Sasha7b9Work/LiniaServer/_Лисенков/Diplomы/Irina.grishkovets22101999/тезисы 2021/Фото/IMG_20210307_133908.jpg

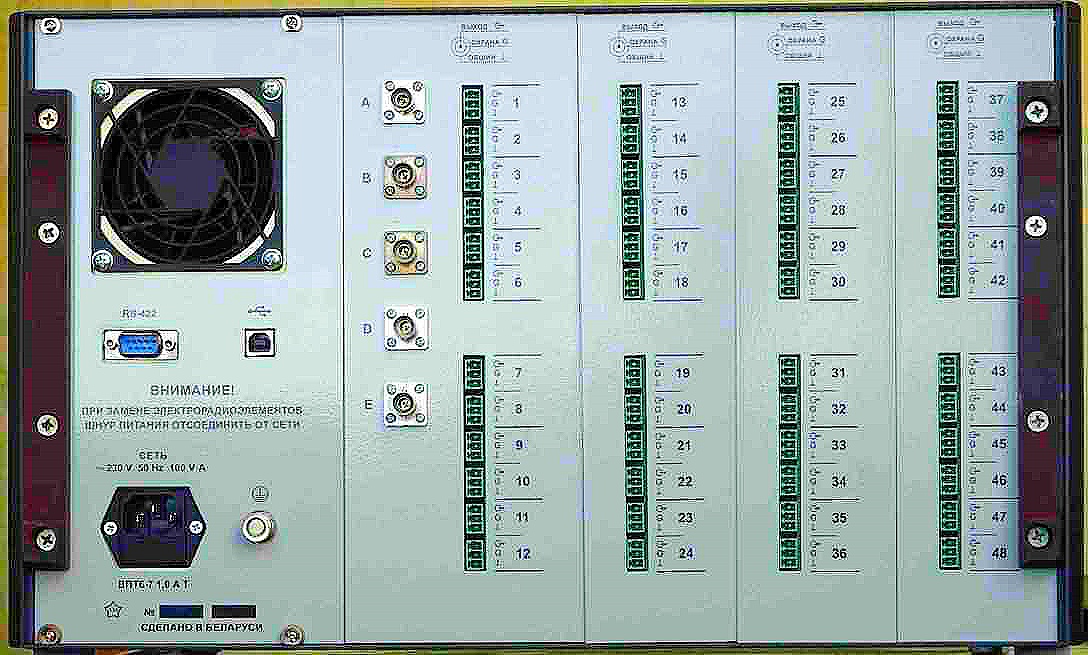
_Лисенков/Diplomы/Irina.grishkovets22101999/тезисы 2021/Фото/IMG_20210307_133908.jpg
