Sasha7b9Work/LiniaServer/Контроллер/УШЯИ.467444.130/Changelog.txt

06.08.25 - 16:57 Добавлены имена синналов на разъемы (4,5 лист)
08.08.25 - 14:13 Исправлены имена сигналов на листе 4 разъем Формирователь развертки
