Sasha7b9Work/LiniaServer/Печатные платы список линия 2.docx

Перечень печатных плат и трансформаторов, входящих в УШЯИ.411251.011 Анализатор ВАХ («Линия 2»)

Плата СБ | Плата | Файл | Куда входит
1. УШЯИ.467444.130 Контроллер | УШЯИ.687264.002 (6 сл) | УШЯИ.467444.130. PcbDoc (Altium) 28.07.25 | УШЯИ.467859.024 Дисплей
2. УШЯИ.687253.017 Плата | УШЯИ.758725.629 | 725629. PcbDoc (Altium) 01.08.25 | УШЯИ.411522.032 Источник напряжения 50 В
3. УШЯИ.687253.018 Плата | УШЯИ.758724.375 | 724375. PcbDoc (Altium) 01.08.25
4. УШЯИ.687243.347 плата (±50 В) 5. УШЯИ.687243.348 плата (±12 В, +5 В) 6. УШЯИ.687243.349 плата (±15 В, +12 V) 7. УШЯИ.687243.355 плата (объединительн) | УШЯИ.758725. УШЯИ.758725. УШЯИ.758725. УШЯИ.758724. | | УШЯИ.436224.015 блок питания
8. УШЯИ.687243.350 плата оптоформирователя (вх. УШЯИ.301411.044 оптоинтерфейс) 9. УШЯИ.687243.351 плата интерфейса (вх. УШЯИ.301411.044 оптоинтерфейс) 10. УШЯИ.687243.352 плата измерителя | УШЯИ.758723.275 УШЯИ.758723.276 УШЯИ.758725.634 | УШЯИ 758723.275.PcbDoc (Altium) 23.02.26 УШЯИ 758723.276.PcbDoc (Altium) 23.02.26 УШЯИ 758725.634.PcbDoc (Altium) 23.02.26 | УШЯИ.411131.006 измеритель тока
11. УШЯИ.411618.029 источник-измеритель 12. УШЯИ.411618.029-01 источник-измеритель 13. УШЯИ.411522.033 формирователь развертки 14. УШЯИ.687245.044 плата источника | УШЯИ.687254.036 (4 сл) УШЯИ.758727.205 УШЯИ.758727.206 | 687254.036 PcbDoc (Altium) 15.10.25 758727.205 PcbDoc (Altium) 15.10.25 PcbDoc (Altium) | УШЯИ.687412.009 шасси
15. УШЯИ.687253.044 плата выпрямителя | УШЯИ.758725.630 | PcbDoc (Altium) | УШЯИ.301412.605 панель
16. УШЯИ.687243.353 плата коммутатора 17. УШЯИ.687243.354 плата | УШЯИ.758725. УШЯИ.758725. | | УШЯИ.468213.012 коммутатор
18. УШЯИ.687242.236 плата защиты УШЯИ.671111.329 транс (шл16х16) УШЯИ.671111.257 транс (шл25х50) УШЯИ.671111.330 транс (шл32х40) УШЯИ.671111.272 транс (шл25х50) | УШЯИ.758721.097 | PcbDoc (Altium) | УШЯИ.411522.034 источник напряжения

В прибор входит 17 плат, 4 трансформатора
