Sasha7b9Work/LiniaServer/Перечень узлов Анализатора ВАХ.docx

Перечень узлов Анализатора ВАХ УШЯИ.411251.011 (январь 2026г)

Наименование | Обозначение | Обознач. ПУ | Обознач. ПП | Файл
Анализатор вольтамперных характеристик (ВАХ) | .411251.011 | ─ | ─
Измеритель тока | .411131.006
- плата оптоформирователя | | 687243.350 | .75872
- плата интефейса | | 687243.351 | .75872
- плата измерителя | | 687243.352 | .75872
Формирователь развертки | .411522.033 | | 758727.205 | 758727.205 PcbDoc (Altium) 15.10.25
Источник напряжения 3 кВ | .411522.034
- плата источника | | .687245.044 | .758727.206
- плата выпрямителя | | .687253.044 | .758725.630
- плата защиты | | .687242.236 | .758721.097
Источник напряжения 50 В | . 411522.032
- плата | | .687253.017 | .758725629 | 725629. PcbDoc (Altium)
- плата | | .687253.018 | .758724375 | 724375. PcbDoc (Altium)
Источник-измеритель | 411618.029, 411618.029-01 | ─ | 687254.036 (4 слоя) | 687254.036 PcbDoc (Altium) 15.10.25
Дисплей | .467859.024
- контроллер | | .467444.130 | .687264.002 (6 слоев) | УШЯИ.467444.130. PcbDoc (Altium) 28.07.25
Коммутатор | .468213.012
- плата коммутатора | | .687243.353 | .75872
- плата | | .687243.354 | .75872
Блок питания | .436224.015
- плата (±50 В) | | .687243.347 | .75872
- плата (±12 В, +5 В) | | .687243.348 | .75872
- плата (±15 В, +12 VR) | | .687243.349 | .75872
- плата объединительная | | .687243.355 | .75872

Всего – 17 плат (может появиться еще одна)
