Sasha7b9Work/LiniaServer/Блок базы - Подложки/Таблица 24-х разрялного регистра ПЛИС-a.docx

Таблица 1 - Назначение разрядов регистров в источнике-измерителе (RB )

Разряд | Значения разрядов | Функциональное назначение
Q3:Q0 | 0000 | Включение предела: ±20 нА. ( все герконы выключены)
| 0001 | Включение предела: ±200 нА. – (включен геркон 10М)
| 0010 | Включение предела: ±2 мкА. - (включен геркон 1М)
| 0011 | Включение предела: ±20 мкА. - (включен геркон 100К)
| 0100 | Включение предела: ±200 мкА.- (включен геркон 10К)
| 0101 | Включение предела: ±2 мА.- (включен геркон 1К)
| 0110 | Включение предела: ±20 мА.- (включены герконы 100RI,100RU)
| 0111 | Включение предела: ±200 мА.- (включены герконы 10RI,10RU)
| 1000 | Включение предела: ±2 А. - (включены герконы 1RI,1RU)
| 1001 | Включение предела: ±10 А.- (включены герконы R1I,R1U)
Q4 (Uc1) | 0 | Геркон подключения конденсатора выключен
| 1 | Геркон подключения конденсатора включен
Q5 (CLBR) | 0 | Геркон “Корр. 0 измерителя UИИ” выключен.
| 1 | Геркон “Корр. 0 измерителя UИИ” включен.
Q6 (Az) | | Не используется
Q7 (CF) | | Не используется
Q9:Q8 | 00 | ST1=0, Uref=5V - установка опорного напряжения
| 01 | ST2=0, Uref=1.25V
| 10 | ST3=0, Uref=1V
| 11 | ST4=0, Uref=0.5V
Q10 (Ui) | 0 | Режим ограничение по “I”.
| 1 | Режим ограничение по ”U”.
Q11 (Uim) | 0 | Режима измерения I.
| 1 | Режима измерения U.
Q12 (U1) | 0 | Задание диапазона измерения U: 10V
| 1 | Задание диапазона измерения U: 40V
Q13 (IIS) | 0 | Режим источника напряжения
| 1 | Режим источника тока
Q14 | | Не используется
Q15 (Onl3) | 0 | Выбор сигнала токового датчика буфера 40V
| 1 | Выбор сигнала токового датчика буфера 10V
Q16 | | Не используется
Q17 | | Не используется
Q18 | 0 | Формирование сигнала базы ступеньками
| 1 | Формирование сигнала базы импульсами
Q19 | | Не используется
Q20 | | Не используется
Q21 | | Не используется
Q22 | 0 | Питание усилителя 12 В
| 1 | Питание усилителя 55 В
Q23 | | Не используется
