Sasha7b9Work/LiniaServer/Контроллер/1-Изменения программы ОО.docx

1. Исходная схема контроллера - kont_lineP-E

2. В схеме для STM32F4 изменили:

- сигнал ST_TB – запуск развертки формируется STM32F4 pin.36;

- для передачи данных из памяти ПЛИС используется встроенный модуль SPI

ORANGE PI 5 Plus. Модуль SPI ORANGE PI 5 Plus - “ Master”, ПЛИС –“Slave”.

Назначение pin. модуля SPI ORANGE PI 5 Plus :

- spi_miso pin.21 ORANGE PI 5 Plus - прием последовательных данных из

памяти ПЛИС;

- spiClk pin.23 ORANGE PI 5 Plus - такты для приема данных из памяти ПЛИС

(ранее использовался как тактовый сигнал программирования динамических DAC);

- SPICS pin.24 ORANGE PI 5 Plus - лог.”0” – разрешение приема данных;

- full pin.36 ORANGE PI 5 Plus – сигнал готовности приема данных из памяти

ПЛИС – лог. “1”.

Чтение данных выполняется по алгоритму платы макета контроллера.

3. Сигнала Stop_TB формируется контроллером STM32F, используется pin.15.

4. Управление динамическими DAC

Управление динамическими DAC выполняется контроллером ORANGE PI 5 Plus

через последовательный интерфейс. Используются следующие сигналы:

XP3 (ORANGE PI5 Plus)

- CLK_DDAC – pin.16 - (ранее использовался pin. 23);

- DT - DDAC pin.18 – (ранее использовался pin. 19);

- EN_DD1 - pin.31 – выбор динамического DAC формирователя развертки;

- EN_DD2 - pin.35 - выбор динамического DAC источника 50 В.

Назначение остальных pin. STM32F4 не изменилось.
