Sasha7b9Work/LiniaServer/Контроллер/1- Запись в регистр блока  Базы.docx

Управление модулем Базы

В тестовой программе задействовано управление DAC на плате и регистром 24 разряда и DAC1, DAC2, ADC .

Используются следующие сигналы для записи в регистр:

1. Для записи данных в регистр модуля базы используются следующие сигналы:

- ENRGB – сигнал выбора регистра базы, активный уровень – лог.”0”, должен находиться в

состоянии лог. “1”, при записи данных в регистр - лог.”0”. Сигнал “ENRGB” формируется

контроллером STM32F4, используется порт PC1 pin. 27.

- DAT1_DAC – данные для записи в сдвиговый регистр, сигнал “DAT1_DAC” формируется

контроллером STM32F4, используется порт PD8 pin. 77.

- CLK1_DAC – такты записи в сдвиговый регистр, сигнал “CLK1_DAC” формируется

контроллером STM32F4, используется порт PD11 pin. 80.

Перед записью данных в регистр необходимо обеспечить:

- ENRGB - лог. “1”;

- CLK1_DAC - лог.”0”,

2. Последовательность выполняемых операций при записи:

- устанавливается сигнал “ENRGB” в состояние лог. ”0”.;

- выполняется задержка не менее 1 мкс;

- в порт PD8 записывается значение старшего бита 24 битового значения регистра;

- выполняется задержка не менее 1 мкс;

- в порт PD11 записывается лог. “1”, которая удерживается в этом состоянии не менее 1 мкс;

- в порт PD11 записывается лог. “0”

- выполняется задержка не менее 1 мкс;

- в такой последовательности выводятся все 24 бита;

- по окончанию записи 24 бит сигнал “ENRGB” должен быть установлен в состояние лог. ”1”.;

- ENRGB - pin.10 XP4;

- CLK1_DAC- – pin.5 XP4;

- CLK1_DAC+ – pin.6 XP4;

- DAT1_DAC- - pin.2 XP4;

- DAT1_DAC+ - pin.3 XP4

3. Используются следующие сигналы для записи в DAC1 и DAC2:

- END1B - pin.8 XP4 – для DAC1 – 14 bit;

- END1B - pin.9 XP4 - для DAC2 – 8 bit;

- CLK1_DAC- – pin.5 XP4;

- CLK1_DAC+ – pin.6 XP4;

- DAT1_DAC- - pin.2 XP4;

- DAT1_DAC+ - pin.3 XP4

Активный уровень выбора DAC1,DAC2 – лог. “1”.

Порядок записи как для последовательного регистра.

4. Проверки работы ADC не выполняется, так как требуется подключение дополнительного модуля формирователя развертки ( необходим сигнал LINE).
