Sasha7b9Work/LiniaServer/Контроллер/1-Изменения по плате-C.docx

На плате необходимо сохранить расположение элементов. Основные изменения:

- удалены некоторые связи согласно списка ниже:

- введены дополнительные связи и изменены наименования отдельных цепей. Изменения

выделены на схеме красным цветом;

- введены дополнительные резисторы в разрыв проводников и схему 467444.130Э3-5A

- изменен тип вилок XP11, XP14 (на шестиконтактные);

- добавлена вилка XP15;

- удалены из схемы конденсаторы C90, C91;

- введена микросхема линейного стабилизатора DA23 для получения питания +3,3VC. Это

питание заводится на вилки XP4,XP5,XP7,XP10,XP12,XP13. Цепи выделены на схеме красным

цветом. Для работы стабилизатора DA23 введены дополнительные конденсаторы –

C90,C91,C94, C95;

- имеются схемные файлы УШЯИ.467444.130Э3-1A - УШЯИ.467444.130Э3-5A, в которые внесены

изменения, выделенные красным цветом. Коррекция схемы выполнена без использования

библиотеки элементов. Использовались только символьные обозначения дополнительных

элементов путем копированием элементов платы.

При коррекции платы использовать откорректированный вариант схемы и пояснениями,

приведенными ниже.

1. Связь (DAT_F0) pin.84 DD1 – pin.16 XP3 удалить;

2. Связь (DAT_F1) pin. 85 DD1 - pin.18 XP3 удалить;

3 . Связь (SPI1_CLK) pin.4 DA11 - pin.23 XP3 удалить;

4. Связь (SPI1_MOSI) pin.4 DA14 - pin. 19 XP3 удалить;

5. Связь (REQ_RD) pin.32 XP3 - pin. 115 DD1 удалить;

6. Связь (ENDU) pin.19 XP7 - pin.9 DD4удалить;

7. Связь (ENB_STM) pin.112 DD1 – pin. 81 DD4 удалить;

8. Связь (+5V) pin.1 XP11 удалить;

9. Связь (EA)pin.2 XP11 -pin.2 R53 удалить;

10. Связь (EB)pin.3 XP11 -pin.2 R54 удалить;

11.Связь (GND) pin.4 XP11 –GNDудалить;

12 . Связь (KA) pin.1 R53 -pin. 11 XP3 удалить

13 . Связь (KB) pin.1 R54 – pin. 13 XP3 удалить

14 . Связь (START) pin. 1 XP14 – pin. 15 XP3 удалить

15 . Связь (STOP) pin. 2 XP14 – pin.21 XP3 удалить

16. Удалить с платы связи и элементы:

( 200-E) pin.12 XP12 - pin.45 DD4 и резистор R58;

(200+E )pin.13 XP12 - pin. 46 DD4 и резистор R59 ;

(20-E) pin.14 XP12 - pin.47 DD4 и резистор R60;

( 20+E) pin.15 XP12 - pin.48 DD4ирезисторR61;

(SPEED) pin.19 XP6 - pin. 126 DD4

17. Связь (50E-) pin.16 XP10 подключить к pin.12XP12;

Связь (50E+) pin.15 XP10 подключить к pin.13XP12;

18. Ввести на плату резистор R64 и включить его в разрыв цепи (300VE)pin.11 XP12 – pin.44 DD4

19. Ввести на плату резистор R65 и включить его в разрыв цепи (50E+)pin.15 XP10 – pin.50 DD4

20. Ввести на плату резистор R66 и включить его в разрыв цепи (50E-)pin.16 XP10 – pin.49 DD4

21. Ввести на плату резистор R66 и подключить его вывод к цепи (50E+), второй вывод

к цепи (+3.3VB)

22. Ввести на плату резистор R62 и подключить его вывод к цепи (50E+), второй вывод

к цепи ( +3.3VB)

23. Ввести на плату резистор R63 и подключить его вывод к цепи (50E-), второй вывод

к цепи (+3.3VB)

24. Ввести на плату резистор R67 и подключить его вывод к цепи (DOOR), второй вывод

к цепи (+3.3VB)

25. Ввести на плату резистор R68 и подключить его вывод к цепи (DOOR), второй вывод

к pin.140 DD4 ( связь DOOR_R)

26. Ввести на плату резистор R60 и подключить его вывод к цепи (VD+), второй вывод

к цепи (+5V);

27. Ввести на плату резистор R61 и подключить его вывод к цепи (CNT_VD), второй вывод

к цепи GND. Резистор R61 ставить у pin. Gate транзистора VT1. К расположению транзистора

VT1 на плате требований не предъявляется

28. Ввести на плату транзистор VT1. Gate транзистора подключить к связи (CNT_VD), исток

транзистора подключить к (GND), исток к цепи (VD-)

29. Ввести на плату резистор R58 и подключить его вывод к цепи (START), второй вывод к

pin.15 XP3 (цепь KN_START)

30. Ввести на плату резистор R59 и подключить его вывод к цепи (STOP), второй вывод к

pin.33 XP3 (цепь KN_STOP)

31. Ввести на плату резистор R69 и включить его в разрыв цепи (связь OVLB)

32. Ввести на плату резистор R70 и включить его в разрыв цепи (связь OVLP)

33. Ввести на плату резистор R71 и включить его в разрыв цепи (OVLI,1)

34. Ввести на плату резистор R72 и включить его в разрыв цепи (OVLW)

35. Ввести на плату резистор R73 и включить его в разрыв цепи (OVLI,2)

36.Кразмещению резисторовR69-R73 требований не предъявляется

38 Ввести связь (CNT_VD) pin.12 DD4 резистор R61, GateVT1

39. Ввестисвязь (Meas) pin.97 DD4 – pin. 3 XP15 ( можно другой вывод DD4)

40. Ввестисвязь (DOOR_R) pin.140 DD4 – pin. R68 ( можно другой вывод DD4)

41. Ввестисвязь (ST_EXT) pin.32 XP3 – pin.1 XP15

42. Ввестисвязь (FIT) pin.37 XP3 – pin.5 XP15

43Ввестисвязь (VD-) VT1 - pin.6 XP14;

44Ввестисвязь (VD+) R60 - pin.5 XP14;

45. Ввестисвязь(EA)pin.1 XP11 -pin.1 R53;

46. Ввестисвязь (EA) pin.1 XP11 -pin.1 R51;

47. Ввестисвязь (+3.3VB) pin. 2R51 - +3.3VB

48. Ввестисвязь (KA) pin. 2 R53 – pin.11 XP3

49. Ввести связь (EB)pin.2 XP11 -pin. 1 R54;

50. Ввестисвязь (EB) pin.2XP11 -pin.1 R52;

51. Ввестисвязь (+3.3VB) pin. 2R52 - +3.3VB

52. Ввестисвязь (KB) pin. 2 R54 – pin.13XP3

53. Ввести связь (GND) pin.3 XP11 -GND;

54. Ввести связь (+3.3VB)pin.5 XP11 - +3.3VB;

55. Ввести связь (GND)pin.6 XP11 -GND;

56. Ввести связь (+5V)pin.19 XP6 - +5V;

57. Ввести связь (SPI_Clk) pin.23 XP3 – pin.115 DD1

58. Ввести связь (CLK_DDAC) pin.4 DA11 – pin.18 XP3;

59. Ввести связь (DT_DDAC )pin.4 DA14 - pin.16 XP3;

60. Ввестисвязь (SPI_MISO) pin.23 XP3 - pin.84 DD1;

61. Ввести связь (+5V) pin.19 XP6 - +5V;

62. Ввести связь (+3.3VC )pin.30 XP4 - +3.3VC;

63. Ввести связь (+3.3VC) pin.30 XP5 - +3.3VC;

64. Ввести связь (+3.3VC) pin.38 XP7 - +3.3VC;

65. Ввести связь (ENDU) pin.37 XP7 -pin.9 DD4;

66. Ввести связь (+3.3VC) pin.18 XP10 - +3.3VC;

67. Ввести связь (GND) pin.9 XP3 -GND

68. Изменить наименование связи (DAT_F3) pin.132 DD1 – pin.24 XP3 на (SPICS);

69. Изменить наименование связиDat_F2pin.22XP3 - pin.137DD1 на (Stop_TB);

70. Изменить наименование связи (ENB_STM) pin.27 XP3 - pin.81 DD4 – на (ENB_PC)

71. Изменить наименование связи(EMPTY) pin. 104 DD1 –pin.26 XP3 на (F_Con1)–свободная связь

72. Изменить наименование связи(SMM32F4) pin. 73DD1 –pin.15DD4на (F_Con2)–свободная

связь

73. Изменить наименование связи(A2_RG) pin. 72DD1 –pin.89DD4на (F_Con3)–свободная связь

74. На XP3 pin.8 (Tx) должен быть соединен с pin.102 (Tx) DD4,pin.10 (Rx) должен быть соединен с

pin.136 (Rx) DD4,

75 . Вилки XP11, XP14 заменены на AMPMODU II 0280372-2 – 6 pin.

76 . ВилкаXP8 заменена на AMPMODU II 0280372-2 – 6 pin.

77. В схему добавлена вилка XP15 - AMPMODU II 0280372-2 – 6 pin.
