Sasha7b9Work/LiniaServer/Контроллер/1-Проверка платы с  STM32f4-V4.docx

Для начального включения используется следующее включение программируемых

элементов платы контроллера – полная схема:

ПЛИС STM32F4

A0_RG –pin.71 A0_RG – pin.90 мл.бит выбора регистра ПЛИС

A1_RG –pin.70 A1_RG – pin.91 бит выбора регистра ПЛИС

St_tb –pin.72 – pin.89 start развертки ( замена A2_RG)

CLK_RG –pin.69 CLK_RG – pin.92 такты записи в регистр ПЛИС

WR_RG –pin.59 WR_RG – pin.93 сигнал записи в регистр ПЛИС

DAT_RG –pin.49 DAT_RG – pin.82 данные записи в регистр ПЛИС

SPICLK – pin.115 SPICLK – pin32. ORANGE PI5+ чтение данных из ПЛИС

( REQ_RD)

SPIMISO – pin.85 - pin.18 ORANGE PI5+ данные из ПЛИС

(DAT_F1)

SPI_MOSI – pin.84 – pin.16 ORANGE PI5+ (свободен)

(DAT_F0)

SPICS0 – pin. 104 SPICS0 – pin.26 ORANGE PI5+ Chip Select интерфейса

(EMPTY )

Full – pin.133 Full – pin.36 ORANGE PI5+ готовность данных для чтения

лог. “1”

ADCRUN – pin.74 ADCRUN pin.4 DA7 запуск ADC

ADCCLK – pin. 75 ADCCLK pin.4 DA15 такты чтения ADC

ENS – pin. 136 ENS – pin. 16 XP7 сигнал ENS трансформатора

EIMP – pin.83 EIMP – pin. 17 XP10 сигнал EIMP развертки

HI Pulse

Impc – pin.77 Impc - pin.4 DA12 сигнал Impc коллектора

развертки HI Pulse

ImpBPMV – pin.76 ImpBPMV – pin.4 DA17 сигнал ImpBPMV базы

развертки HI Pulse

ImpBV – pin.80 ImpBV – pin.4 DA17 сигнал ImpBV базы

развертки HV Pulse

F_CLK –pin. 24 R2 генератор

В качестве тактового сигнала iclk используются такты ADC – adcClk, для загрузки сдвигового регистра ( сигнал ld) используется сигнал adcRun. Вывод данных сдвигового

регистра начинается со старшего бита – D16. Задается развертка SIN+. Выходной сигнал ADC подается на входы adcMosi[3..0]. Проект проверен LINE-24-11-2025_restored без передачи данных ORANGE PI 5 Plus на плате контроллера 467444.129.

Инсталляция разработанного проекта на плату контроллера требует его доработки. Чтобы исключить возможные ошибки предполагается на первом этапе инсталлировать его в конфигурации для тестового варианта, сохранив запуск разверток внутренним сигналом START и изменив назначение выводов ПЛИС под схему контроллера макета 467444.130.

Full – pin.133 T6 -pin 34 готовность данных для чтения

лог. “1”

ADCRUN – pin.74 T3 – pin. 124 запуск ADC

ADCCLK – pin. 75 T4 –pin. 32 такты чтения ADC

ENS – pin. 136 T2 –pin.121 сигнал ENS трансформатора

EIMP – pin.83 EIMP – pin. 17 XP10 сигнал EIMP развертки

HI Pulse

LINE - T1 –pin.120

Impc – pin.77 Impc - pin.4 (DA12) сигнал Impc коллектора

развертки HI Pulse

ImpBPMV – pin.76 ImpBPMV – pin.4 DA17 сигнал ImpBPMV базы

развертки HI Pulse

ImpBV – pin.80 ImpBV – pin.22 XP4 сигнал ImpBV базы

развертки HV Pulse

T5 – pin.31 старший бит сдвигового

регистра имитатора АЦП

Inclk0 – pin.24 генератор

Длительность импульсов Start - 10 мкс.

Файл-проект Line-28-11-2025

Создан архив проекта Line-28-11-2025 - Line 24-12-2025 для доработки проекта.

Проект Line-old-30-12-2025-restored используется в качестве тестового проекта для платы контроллера 467444.129 . Он содержит модуль LINE.sv – последний вариант, в котором сигналы выведены:

Назначение выводов STM32F4 (плата контроллера 467444.129)

ПЛИС

WR- in. 58 - adcMiso 81

CLK - pin. 24 - вход опорной частоты ПЛИС

А1,2 - pin. 115 - adcRun 66 - XP2.3

2A - pin. 119 - adcClk 65 - XP2.4

3A,B - pin. 120 - full 64 - XP2.5

K1_F1 – pin. 80 - impc - XP5.5

T1 - pin. 137 - line - XP5.6

K2_F1– pin. 83 - eimp - XP5.7

K1_F2– pin. 84 - impBPMV - XP6.5

K2_F2 - pin. 85 - impBV - XP 6.6

T2 - pin. 138 - start - XP7.6

Puls0 - pin. 74 - ENS - XP2.1 (1 ПЛИС)

Используется внутренний сигнал Start – модуль StartStopSignal_gen.

Не используются сигналы для вывода данных из памяти ПЛИС.

Проект Line-05-01-2026- получен из архива проекта Line-old-30-12-2025_restored для перехода на плату контроллера 467444.130, используется в качестве тестового проекта,

в котором сигналы выведены:

Назначение выводов ПЛИС

CLK - pin. 24 - вход опорной частоты ПЛИС

adcRun – pin.74 – T3

adcClk - pin.75 - T4

full - pin. 133 - T6

impc - pin. 77 - T5

eimp - pin.83 - pin. 17 XP10

line - pin.120 – T1

ens - pin.136 - T2

impBPMV – pin. 76 - pin.4 DA17

impBV - pin.80 - pin.22 XP4

Проект Line-29-12 -2025-V4_restored включает все элементы для работы с контроллером STM32:

- имитатор ADC – srt_4_A;

- модуль регистров управления – reg_control;

- сигнал внешнего запуска –start_tb;

- сигналы чтения памяти ПЛИС – spiClk, spiCs,spiMiso.

Контрольные сигналы выведены:

CLK - pin. 24 - вход опорной частоты ПЛИС

adcRun – pin.74 – T3

adcClk - pin.75 - T4

full - pin. 133 - T6

impc - pin. 77 - T5

eimp - pin.83 - pin. 17 XP10

line - pin.120 – T1

ens - pin.136 - T2

impBPMV – pin. 76 - pin.4 DA17

impBV - pin.80 - pin.22 XP4

start_tb - pin. 72

Сигналы управления записью данных в регистры ПЛИС

ПЛИС STM32F4

A0_RG –pin.71 A0_RG – pin.90 мл.бит выбора регистра ПЛИС

A1_RG –pin.70 A1_RG – pin.91 бит выбора регистра ПЛИС

CLK_RG –pin.69 CLK_RG – pin.92 такты записи в регистр ПЛИС

DAT_RG – pin.49 DAT_RG – pin.82 данные записи в регистр ПЛИС

WR_RG –pin.59 WR_RG – pin.93

start_tb – pin.72 star_tb – pin.89 сигнал Start_tb

T5 - pin.31 (start_tb)

T2 - pin.121 (ens)

Изменения красным цветом внесены по результатом сделанной разводки печатной платы – из проекта платы 467444.130.

T3 - pin.124 (adcRun)

T4 - pin.32 (adcClk)

T6 - pin. 34 (full)

Сигналы чтения данных из памяти ПЛИС

ПЛИС ORANGE PI5+

spiClk - pin. 115 pin.32 ( REQ_RD) Чтение данных

spiCs - pin.104 pin.26 (EMPTY) Chip Select интерфейса

spiMiso – pin.84 pin.16 (Dat_F0) Данные SPI

Full – pin.133 pin.36 (Full) готовность данных для чтения

Сигналы интерфейса контроллера STM32F4 и ORANGE PI5+

ORANGE PI5+ STM32F4

UART Tx - pin.8 pin. 102 (Rx – прием данных)

UART Rx - pin.10 pin. 136 (Tx – передача данных)

Для проверки платы с STM32F4 и ORANGE PI5+ используется проект

Line-29-12 -2025-V4_restore, файл программирования -15-01.jic

Сигналы на разъемах модулей

Модуль Развертки

ENS – pin.16 XP7

Run- pin. 35 XP7

Run+ pin. 36 XP7

CLK_ADC- pin. 32 XP7

CLK_ADC+ pin. 33 XP7

Line- pin. 13 XP7 ( это входной сигнал для проекта с внешним

сигналом Line. В тестовых проектах он

не используется)

Line+ pin. 14 XP7 – модуль развертки

Канал Базы

Run- pin. 12 XP4

Run+ pin. 13 XP4

CLK_ADC- pin. 15 XP4

CLK_ADC+ pin. 16 XP4

Измеритель Тока

Run- pin. 9 XP6

Run+ pin. 10 XP6

CLK_ADC- pin. 12 XP6

CLK_ADC+ pin. 13 XP6

Разъем USB для отладки XP8

пин 1 — питание (+5V, красный провод), пин 2 — D- (данные минус, белый провод), пин 3 — D+ (данные плюс, зелёный провод), пин 4 — земля (GND, чёрный провод).

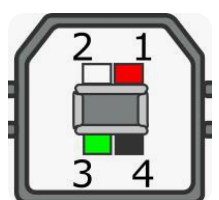
[picture p30: figure]

Розетка USB –B XP8

1 +5 V 2 VBUS

2 D- 3 D-

3 D+ 4 D+

4 GND 1 GND
