Sasha7b9Work/LiniaServer/Контроллер/1- Контроллер Линия-2-A.docx

Для начального включения используется проект Line-29-12 -2025-V4_restored, который включает все элементы для работы с контроллером STM32:

- имитатор ADC – srt_4_A;

- модуль регистров управления – reg_control;

- сигнал внешнего запуска –start_tb;

- сигналы чтения памяти ПЛИС – spiClk, spiCs, spiMiso.

В проекте используются следующие сигналы:

Сигналы управления записью данных в регистры ПЛИС

ПЛИС STM32F4

A0_RG –pin.69 A0_RG – pin.90 мл.бит выбора регистра ПЛИС

A1_RG –pin.70 A1_RG – pin.91 бит выбора регистра ПЛИС

CLK_RG –pin.71 CLK_RG – pin.92 такты записи в регистр ПЛИС

DAT_RG – pin.49 DAT_RG – pin.82 данные записи в регистр ПЛИС

WR_RG – pin.72 WR_RG – pin.93 сигнал записи в регистр ПЛИС

Start_tb - pin.59 pin.89 ( A2_RG ) сигнал запуска развертки

Сигналы чтения данных из памяти ПЛИС

ПЛИС ORANGE PI5+

spiClk - pin. 115 pin.32 ( REQ_RD) Чтение данных

spiCs - pin.104 pin.26 (EMPTY) Chip Select интерфейса

spiMiso – pin.84 pin.16 (Dat_F0) Данные SPI

Full – pin.133 pin.36 (Full) готовность данных для чтения

Сигналы интерфейса контроллера STM32F4 и ORANGE PI5+

ORANGE PI5+ STM32F4

UART Tx - pin.8 pin. 102 (Rx – прием данных)

UART Rx - pin.10 pin. 136 (Tx – передача данных)

Используется схема с двумя управляющими контроллерами. В качестве первого

контроллера используется одноплатный компьютер , в качестве второго - STM32F4.

Одноплатный компьютер реализует все функции интерфейса пользователя посредством 2-х кнопок “START”, “STOP”, энкодера, беспроводных компьютерной мыши, клавиатуры и емкостного сенсорного экрана, управляет отображением ВАХ на экране ЖК монитора. В приборе он является ведущим (Host), ПО которого реализует общий алгоритм функционирования анализатора ВАХ.

Контроллер (Slave) обеспечивает управление программно управляемыми узлами прибора по командам первого контроллера. Связь контроллеров осуществляется по 2-х проводному последовательному интерфейсу RS 232 сигналами Tx, Rx.

Передача данных между контроллерами выполняется командами в кодах ASCII

Для начального включения программное обеспечение контроллеров должно обеспечивать:

1. Программа ORANGE PI 5 Plus должна отображать на экране дисплея;

- виртуальные кнопки “START”, “STOP” и посылать соответствующие им команды

контроллеру STM32F4;

- данные регистров ПЛИС RG0, RG1, RG2 и обеспечивать возможность их

изменения и передачи в виде команд STM32F4;

- контролировать сигнал full, для того чтобы определить момент перехода сигнала

из стояния лог.0 в состояние лог.1;

- при перехода сигнала full из стояния лог.0 в состояние лог.1

A: - установить сигнал spiCs в состояние лог.0 ;

- читать данные пакета из памяти ПЛИС – 72 бита, формируя сигналы

spiClk и читая данные spiMiso;

- после чтения пакета 72 бита установить сигнал spiCs в состояние лог.1 ;

- вывести численное значение данных ADC на экран дисплея – считанное

значение - 1000;

- повторить операции А до окончания чтения 200х 4 пакетов

В пакете 72 бита:

-16 бит – данные ADC1;

-16 бит – данные ADC2;

- 16 бит – данные ADC3;

- 16 бит – данные ADC4;

- 8 бит - информация о переполнении ADC ( не выводить).

- при перехода сигнала full из стояния лог.1 в состояние лог.0 ждать

перехода сигнала full из стояния лог.0 в состояние лог.1

2. По команде “START” контроллер STM32F4 должен формировать сигнал Start_tb –

положительный импульс длительностью 2 – 10 мкс с периодом 0.5 -1.5 секунды.

По этому импульсу происходит запуск развертки и ПЛИС формируются сигналы,

необходимые для работы анализатора. Формирование сигнала Start_tb должно

прекращаться после приема команды “STOP”- это автоматический режим работы

развертки. В ручном режиме запуск развертки выполняется однократно – по

каждому нажатию кнопки “START”.

Работа контроллера STM32F4 по формированию сигнала Start_tb различается

в зависимости от установленной развертки:

- для разверток SIN+, SIN- разрешается формирование сигнала Start_tb после

чтения 200 х4 значений ADC;

- для развертки AC разрешается формирование сигнала Start_tb после выполнения

двух операций чтения 200 х4 данных;

- для развертки DC+, DC- разрешается формирование сигнала Start_tb после

выполнения N операций чтения 200 х4 данных. N – численное значение битов

[8..5] регистра RG0;

- для остальных разверток – выполняется условие как для разверток SIN+, SIN-.

3. После передачи команды “STOP” разрешается модификация данных регистров

ПЛИС.

Доступ к регистрам ПЛИС осуществляется через последовательный

синхронный интерфейс, реализованный программными средствами

процессора. Используются сигналы выбора адреса регистра A0_Rg, A1_Rg – используются порты ввода/вывода процессора, сигнал последовательных данных Dat_RG, сигнал синхронизации – CLK_RG. Прием данных в ПЛИС буферизирован – данные сначала записываются в сдвиговый регистр, а за тем по сигналу WR_RG переписываются в рабочие регистры ПЛИС. Передача данных в сдвиговый регистр начинается со старшего бита. Последовательность записи:

- сначала устанавливается адрес регистра;

- по битно записываются данные положительным фронтом сигнала –

CLK_RG – в исходном состоянии должен быть установлен в

состояние лог. “0 “;

- после передачи последовательных данных в сдвиговый регистр

сигналом WR_RG данные записываются в регистры ПЛИС.

WR_Rg , в исходном состоянии должен быть установлен в лог. “0 “

Предусмотрена задержка не менее 1 мкс. после изменения сигналов

передачи данных.

4. 1. Всего предусмотрено в ПЛИС 3 регистра. Выбор регистров сигналами

A0_Rg – младший бит адреса;

A1_Rg

5. Назначение регистров согласно таблицы

Наименование регистра | Назначение регистра | A0_Rg | A1_Rg | Количество разрядов
RG0 | Установка вида развертки | 0 | 0 | 9
RG1 | Установка длительности импульсов | 1 | 0 | 8
RG2 | Установка задержки запуска ADC для импульсных разверток | 0 | 1 | 8

6. Выбор развертки осуществляется 4-мя младшими битами регистра RG0 [3..0]

MODE_NONE =,0d //Invalid value

SIN_P = 1d, // Positive sine

SIN_N = 2d, // Negative sine

AC = 3d, // Alternating current

DC_P = 4d, // Positive DC

DC_N = 5d, // Negative DC

IMP_SIN_P = = 6d,// Positive pulse sine. High

IMP_SIN_N = = 7d,// Negative pulse sine. High

IMP_CVC = 8d,// Сurrent-voltage

Бит [4] регистра RG0 используется для идентификации тестируемого элемента:

IS_DIODE = 0;,

IS_TRANSISTOR = 1.

Биты [8..5] регистра RG0 используются для установки количество кривых ВАХ

для разверток DC+, DC-. Численное значение кода [8..5] – 0-15.

7. Регистр RG1 используется для установки длительности импульсов для импульсных разверток.

Длительность импульса определяется соотношением

Ти= N*Sk, где

N – численное значение кода регистра RG1;

Sk – коэффициент размерности, для разверток IMP_CVC, IMP_OSC

Sk=1мкс, для разверток HI Pulse и Sk=10мкс для разверток HV Pulse

8. Регистр RG2 используется для установки задержки запуска ADC для импульсных

разверток. Длительность задержки определяется соотношением

RunDelay= N*Sk, где

N – численное значение кода регистра RG2;

Sk – коэффициент размерности, Sk=1мкс.

9. Для контроля сигналов, формируемых ПЛИС, на плате предусмотрены следующие

контрольные точки:

T1 – Line;

T2 – ENS;

T3 - adcRun;

T4 - adcClk;

T5 - Start_tb;

T6 - full.

Архив проекта ПЛИС для отработки программного обеспечения – Line-06-01-2026
