Sasha7b9Work/LiniaServer/_Лисенков/Формирователь развертки/Измеритель Uc ПРОЕКТ 2025г.docx

АНАЛИЗАТОР

ПРОЕКТ

ПЕРЕКЛЮЧЕНИЯ ДИАПАЗОНОВ

Скопировано из Характериографа за 2014г.

Измеритель Uс (в формирователе развертки .024).

Таблица исправл. 8 июня 2010г. для защиты DAC3 от перегрузок.

Новые значения выделены, (старые в скобках).

На диапазоне 5000 В максимально допустимое напряжение 3500 В!! (Шкала – 5 кВ)

№ | Диапазон | Кофф. отклонения | Q14 :250 | Q13Q12 :2;:1,25;:1 | Q7Q6Q5 x1;x5;x20 | Код ЦАП | Коэффициенты
1 | 5000V | 500V/дел | 0 | 00 | 100 | 819 (1345) | :250, :2, x1, :5
2 | 2000V | 200 V/дел | 0 | 11 (01) | 100 | 1280 (1024) | :250, :1,25, x1, :3,2
3 | 1000V | 100 V/дел | 0 | 01 | 100 | 2048 | :250, :1, x1, :2
4 | 500V | 50 V/дел | 0 | 01 | 100 | 4095 | :250, :1, x1, :1
5 | 200V | 20 V/дел | 0 | 01 | 010 | 2048 | :250, :1, x5, :2
6 | 100V | 10 V/дел | 0 | 01 | 010 | 4095 | :250, :1, x5, :1
7 | 50V | 5 V/дел | 1 | 00 (11) | 100 | 1638 (1024) | :5, :2, x1, :2,5
8 | 20V | 2 V/дел | 1 | 01 | 100 | 2048 | :5, :1, x1, :2
9 | 10V | 1 V/дел | 1 | 01 | 100 | 4095 | :5, :1, x1, :1
10 | 5V | 0,5 V/дел | 1 | 11 | 010 | 2048 | :5, :1,25, x5, :2
11 | 2V | 0,2 V/дел | 1 | 01 | 010 | 4095 | :5, :1, x5, :1
12 | 1V | 0,1 V/дел | 1 | 01 | 001 | 2048 | :5, :1, x20, :2
13 | 0,5V | 0,05 V/дел | 1 | 01 | 001 | 4095 | :5, :1, x20, :1

Примечание: Входной диапазон АЦП = 1,9 В (Uref = 4,098).

При КADA = 0,7 предельное значение измеряемого сигнала на входе ADA - 2,7 В.

При этом, запас на цифровую калибровку равен 27%.

(Диапазон входного сигнала ADA 1,4 В, по отношению к диапазону АЦП 1,9 В, составляет 1,4/1,9×100% = 73%).

Последнее изменение: 29.01.2014

ИСТОРИЯ – 2015г

Измеритель U (формирователь развертки).

№ | диапазон | Кофф. отклонения | Q14 | Q13,Q12 | Q7Q6Q5 | Код ЦАП | Коэффициенты | дискрет
0 | 5000V | 500V/дел | 0 | 00 | 100 | 1345 | :250, :2, x1, :3 | 22,3·10⁻²
1 | 2000V | 200 V/дел | 0 | 01 | 100 | 1024 | :250, :1, x1, :4 | 89,2·10⁻³
2 | 1000V | 100 V/дел | 0 | 01 | 100 | 2048 | :250, :1, x1, :2 | 44,6·10⁻³
3 | 500V | 50 V/дел | 0 | 01 | 100 | 4095 | :250, :1, x1, :1 | 22,3·10⁻³
4 | 200V | 20 V/дел | 0 | 01 | 010 | 2048 | :250, :1, x5, :2 | 89,2·10⁻⁴
5 | 100V | 10 V/дел | 0 | 01 | 010 | 4095 | :250, :1, x5, :1 | 44,6·10⁻⁴
6 | 50V | 5 V/дел | 1 | 11 | 100 | 1024 | :5, :1,25, x1, :4 | 22,3·10⁻⁴
7 | 20V | 2 V/дел | 1 | 01 | 100 | 2048 | :5, :1, x1, :2 | 89,2·10⁻⁵
8 | 10V | 1 V/дел | 1 | 01 | 100 | 4095 | :5, :1, x1, :1 | 44,6·10⁻⁵
9 | 5V | 0,5 V/дел | 1 | 11 | 010 | 2048 | :5, :1,25, x5, :2 | 22,3·10⁻⁵
10 | 2V | 0,2 V/дел | 1 | 01 | 010 | 4095 | :5, :1, x5, :1 | 89,2·10⁻⁶
11 | 1V | 0,1 V/дел | 1 | 01 | 001 | 2048 | :5, :1, x20, :2 | 44,6·10⁻⁶
12 | 0,5V | 0,05 V/дел | 1 | 01 | 001 | 4095 | :5, :1, x20, :1 | 22,3·10⁻⁶

Измеритель U

Q13, Q12 | 00 | :2 | Измеритель U | Комбинация 10 запрещена. | В режиме стоп 00
| 01 | :1
| 11 | :1,25
Q14 | 0 | :250 | | | В режиме стоп 0
| 1 | :5
Q15 | | резерв

История – 2007г (Последнее изменение: 22.08.2007)

Диапазон | Код | Коэф-т отклонения | Значение в ЦАПе | Q15 | Q14
±2,5 кВ | | 500 В/дел. | 737 | 1 | 0 (к=:200)
2 (±1) кВ | | 200 В/дел.
1 (±0,5) кВ | | 100 В/дел. | 1475
0,5 (±0,25) кВ | | 50 В/дел. | 2943
0,2 (±0,1) кВ | | 20 В/дел. | 1943 | 0
100 (±50) В | | 10 В/дел. | 3685
50 (±25) В | | 5 В/дел. | 737 | 1 (к=4,32) | 1 (к=:5)
20 (±10) В | | 2 В/дел. | 1943
10 (±5) В | | 1 В/дел. | 3685
5 (±2,5) В | | 0,5 В/дел. | 1943 | 0 (к=1)
2 (±1) В | | 0,2 В/дел. | 737
1 (±0,5) В | | 0,1 В/дел. | 1475
0,5 (±0,25) В | | 0,05 В/дел. | 2943

Измеритель U

Q14 коэффициент | 0 | Установка коэффициента деления 1:200.
| 1 | Установка коэффициента деления 1:5.
Q15 коэффициент | 0 | Установка коэффициента k = 4,32.
| 1 | Установка коэффициента k = 1.

1 В режиме ожидания устройство не производит каких-либо измерений. В данном режиме устройство находится при включении прибора до начала измерений. При окончании измерений или прерывании их по кнопке СТОП устройство должно быть переведено в режим ожидания. В режиме ожидания значение других битов могут быть любыми, но желательно нули.

2 Режимы IMP «-» и «+» (5 мс) отличаются от режимов IMP «-» и «+» (0,1; 0,2; 0,5; 1 и 2 мс) тем, что в них невозможно изменить скважность следования импульсов.

3 Под паузой понимается временной интервал между соседними импульсами в режимах IMP «-» и «+» (0,1; 0,2; 0,5; 1 и 2 мс), на основании которого (и длительности импульса) определяется скважность следования импульсов.

4 Однократное и многократное срабатывание защиты. Однократное – при превышении предельно допустимого значения сигнала в канале коллектора (тока или напряжения) происходит его автоматическое отключение; опрос АЦП осуществляется до окончания сигнала «сбор»; после окончания сигнала «сбор»; после окончания сигнала «сбор» осуществляется процедура STOP – прибор переходит в режим ожидания. Многократное – отличие только в том, что не осуществляется процедура STOP и, следовательно, не прекращаются измерения.

5 Применение сигнала Q13 (блокировка «СБОР») пока ограничено только его использованием при настройке прибора.

6 Q14 и Q15 вместе с ЦАПом входящим в состав формирователя развертки используются для создания поддиапазонов измерителя напряжения. Требуемые для получения поддиапазонов значения битов регистра и значение, загружаемое в ЦАП, приведены ниже.
