Sasha7b9Work/LiniaServer/ТЗ-dop.1.docx

| | УТВЕРЖДАЮ Генеральный директор ОАО «МНИПИ» В.А. Шевченко « » 2026

ТЕХНИЧЕСКОЕ ЗАДАНИЕ

на разработку цифрового осциллографа

с полосой пропускания 250 МГц

1 Основание для выполнения ОКР

1.1 ОКР выполняется с целью улучшения технических характеристик осциллографа С8-54

1.2 Основание для выполнения ОКР – Приказ ОАО «МНИПИ» №136 от 29.06.2026

1.2.1 Сроки выполнения ОКР устанавливаются календарным планом работы к приказу.

2 Исполнитель ОКР: ОАО «МНИПИ»

3 Изготовитель: ОАО «МНИПИ»

4 Цель и назначение разработки

4.1 Целью выполнения ОКР является разработка цифрового осциллографа с полосой пропускания 250 МГц (далее – осциллограф).

Осциллограф предназначен для визуального наблюдения периодических сигналов и измерения их амплитудных и временных параметров в полосе частот от 0 до 250 МГц.

Осциллограф предназначен для установки в наземных стационарных отапливаемых помещениях и сооружениях, диапазон температур рабочих условий эксплуатации от минус 10 ºС до плюс 50 ºС (ГОСТ 22261-94).

4.2 Наименование образца – «Осциллограф цифровой С8-54/1».

4.3 Область применения – измерения при метрологическом обслуживании различных видов техники.

4.4 Осциллограф должен быть конкурентоспособным на рынке СНГ.

5 Источник финансирования

5.1 Источники финансирования – собственные средства ОАО «МНИПИ».

6 Технические требования

6.1 Состав осциллографа

6.1.1 Состав комплекта осциллографа приведен в таблице 1.

Таблица 1

Наименование | Количество | Назначение
1 Осциллограф цифровой С8-54/1 | 1 | Обеспечение измерительных функций
2 Комплект ЗИП | 1 | Обеспечение эксплуатации и ремонта
3 Эксплуатационная документация (комплект) | 1 | Обеспечение правильной эксплуатации и обслуживания
4 Упаковка | 1 | Обеспечение транспортирования

6.2 Требования назначения

6.2.1 В осциллографе должны быть 2 канала вертикального отклонения.

6.2.2 Рабочая часть экрана цветного жидкокристаллического индикатора (ЖКИ) должна быть не менее 145 мм по диагонали (8х10 дел).

6.2.3 Коэффициенты отклонения каждого из каналов должны устанавливаться в диапазоне от 2 мВ/дел до 5 В/дел.

6.2.4 Пределы допускаемой основной погрешности коэффициентов отклонения каждого из каналов А и Б в нормальных условиях эксплуатации должны быть равны ±3 %. Пределы допускаемой погрешности коэффициентов отклонения в рабочем диапазоне температур должны быть равны ±4,5 %.

6.2.5 Время нарастания переходной характеристики при непосредственном входе должно быть не более 1,4 нс (полоса пропускания – от 0 Гц до 250 МГц).

6.2.6 Параметры входов каналов вертикального отклонения должны быть:

- входное сопротивление (1±0,03) Мом;

- Входная емкость не более 20 пФ.

6.2.7 Допускаемое суммарное значение постоянного и переменного напряжения при закрытых и открытых входах каждого канала должно быть не более 110 В при непосредственном входе и 250 В при работе с выносным делителем 1:10.

6.2.8 Максимальная длина записи должна составлять не менее 32 Кбайт на канал.

6.2.9 В осциллографе должен обеспечиваться режим предзапуска и послезапуска.

6.2.10 Коэффициенты развертки должны устанавливаться в диапазоне от 1 нс/дел до 50 с/дел в последовательности 1; 2; 5.

6.2.11 Осциллограф должен обеспечивать автоматический, ждущий и однократный режимы запуска развертки. Должен быть предусмотрен режим «СТОП».

6.2.12 Пределы допускаемой основной погрешности коэффициентов развертки в нормальных условиях применения должны быть равны ±2,5 %.

6.2.13 В осциллографе должны быть следующие виды синхронизации:

- внутренняя по каждому из каналов;

- внешняя.

6.2.14 Предельные уровни внутренней и внешней синхронизации должны быть:

- минимальный уровень -0,8 дел;

- максимальный – 8 дел.

6.2.15 Диапазон частот внутренней и внешней синхронизации должен быть от 0,6 Гц до 250 МГц.

6.2.16 В осциллографе должен быть встроенный калибратор амплитуды.

Пределы допускаемой основной погрешности амплитуды импульсов калибратора должны быть равны ±0,8 %.

Пределы допускаемой погрешности амплитуды импульсов калибратора в рабочем диапазоне температур должны быть равны ±1,2 %.

6.2.17 Осциллограф должен обеспечивать автоматические и курсорные измерения параметров сигналов с выводом результатов измерения в цифровом виде на экран ЖКИ.

6.2.18 Максимальная частота дискретизации исследуемого сигнала по каждому из каналов должна быть не менее 250 МГц, в одноканальном режиме не менее 500 МГц.

6.2.19 Осциллограф должен иметь возможность управления и передачи результатов измерений посредством интерфейса USB.

6.2.20 Осциллограф должен обеспечивать свои технические характеристики в пределах норм, заданных ТЗ, через 15 мин после включения.

6.2.21 Осциллограф должен допускать непрерывную работу в рабочих условиях применения в течение времени не менее 16 ч при сохранении технических характеристик в пределах норм, заданных ТЗ.

6.2.22 Осциллограф должен сохранять свои технические характеристики в пределах нормы при питании от сети переменного тока напряжением (230±23) В частотой (50±0,5) Гц, напряжением 220 В частотой 400 Гц.

6.2.23 Мощность, потребляемая осциллографом от сети питания при номинальном напряжении, не должна превышать 90 В*А.

6.3 Требования к электромагнитной совместимости

6.3.1 Уровень индустриальных радиопомех, создаваемых осциллографом, не должен превышать значений, установленных в СТБ ГОСТ Р 51522 для оборудования класса А.

6.3.2 Осциллограф должен соответствовать требованиям СТБ ГОСТ Р 51522 для оборудования класса А по следующим видам внешних помех:

- электростатические разряды - критерий качества функционирования В;

- наносекундные импульсные помехи (пачки) - критерий качества функционирования В;

- выбросы напряжения - критерий качества функционирования В;

- динамические изменения напряжения питания - критерий качества функционирования В;

- излучаемое радиочастотное электромагнитное поле - критерий качества функционирования А;

- кондуктивные помехи, наведенные радиочастотными электромагнитными полями - критерий качества функционирования А.

6.4 Требования к надежности

6.4.1 Осциллограф должен обеспечивать следующие показатели надежности:

а) средняя наработка на отказ - не менее 10000 ч.

б) средний срок службы – не менее 8 лет.

6.5 Конструктивные требования

6.5.1 При конструировании должны выполняться требования ГОСТ 22261-94, а также действующих технических нормативных правовых актов (ТНПА).

6.5.2 Конструктивное исполнение осциллографа должно соответствовать требованиям ТНПА в части шрифтов, символов и сокращений терминов по СТБ 992-95, СТБ 973-94, ГОСТ 23090-78.

6.5.3 Комплектующие электрорадиоэлементы (ЭРЭ), материалы и полуфабрикаты, применяемые в осциллографе, должны соответствовать государственным стандартам и (или) ТУ на них и иметь паспорт (сертификат) о приемке их изготовителем.

6.5.4 Масса осциллографа должна быть не более 4 кг. Масса осциллографа с упаковкой должна быть не более 6 кг.

6.6 Требования безопасности

6.6.1 Осциллограф должен соответствовать требованиям безопасности, установленным ГОСТ IEC 61010-1 (оборудование класса I, категория перенапряжения II, степень загрязнения 1).

6.6.2 Осциллограф должен соответствовать требованиям пожарной безопасности, установленным в ГОСТ 12.1.004, ГОСТ IEC 60950-1 и иметь аппараты защиты при ненормальных режимах работы (перегревах, перегрузках, токах короткого замыкания и т.п.).

6.7 Требования охраны окружающей среды

6.7.1 Эксплуатация, хранение, транспортирование и утилизация осциллографа не должны оказывать вредного воздействия на окружающую среду и здоровье человека.

### 6.8 Требования по устойчивости и прочности к внешним воздействиям

6.8.1 По устойчивости и прочности при климатических воздействиях осциллограф должен удовлетворять следующим требованиям.

Рабочие условия применения:

- температура окружающего воздуха от минус 10 оС до плюс 40 оС;
- относительная влажность воздуха до 90 % при температуре плюс 25 оС;
- атмосферное давление от 60 до 106,7 кПа (от 450 до 800 мм рт. ст.);
- атмосферное давление от 60 до 106,7 кПа (от 450 до 800 мм рт. ст.).

6.8.2 По прочности к механическим воздействиям при транспортировании осциллограф в упакованном виде должен выдерживать удары многократного действия: ускорение – 147 м/с² (15 g), длительность импульса – (5 - 10) мс, число ударов – 2000, частота ударов в минуту – 200.

6.9 Требования к маркировке и упаковке

6.9.1 Маркировка осциллографа должна соответствовать требованиям ГОСТ 22261, КД и выполнена способом офсетной печати. Допускается выполнение маркировки другими способами на основе современных технологий.

6.9.2 Маркировка на упаковке должна выполняться в соответствии с ГОСТ 14192, КД типографским способом на этикетках и содержать:

- манипуляционные знаки: ″Хрупкое. Осторожно″, ″Беречь от влаги″, ″Верх″ по ГОСТ 14192;
- наименование и тип осциллографа, товарный знак и местонахождение изготовителя;
- обозначение ТУ, знак утверждения типа средств измерений Республики Беларусь, знак ″ЕАС″, надпись ″СДЕЛАНО В БЕЛАРУСИ″, дату изготовления, штамп ОТК, массы брутто и нетто, габаритные размеры упаковки.

6.10 Требования к транспортированию, эксплуатации и хранению

6.10.1 Осциллограф в упаковке изготовителя должен допускать транспортирование в закрытых транспортных средствах любого вида транспорта.

6.10.2 Климатические условия транспортирования не должны выходить за пределы заданных условий:

- температура окружающего воздуха от минус 40 оС до плюс 50 оС;

- относительная влажность окружающего воздуха не более 95 % при температуре 25 оС.

7 Этапы выполнения ОКР

7.1 Наименование этапов, содержание работ, сроки выполнения их устанавливается календарным планом.

8. Порядок контроля и приемки работ, материалы, предъявляемые по окончанию отдельных стадий (этапов) и работы в целом

8.1 Порядок приемки этапов и работы в целом должен соответствовать СТБ 972-2000.

8.2 Перечень КД, оформляемой на стадиях (этапах) работы, должен соответствовать ГОСТ 2.102-68.

8.3 Порядок государственных приемочных испытаний опытных образцов определяется СТБ 8001-93 и программой испытаний, утвержденной в установленном порядке.

8.4 На государственные приемочные испытания предъявляют два образца осциллографа

| Главный конструктор – начальник управления радиоэлектронной продукции и средств измерения ОАО «МНИПИ» А.А. Володкевич « » 2026
| Руководитель работ, начальник отдела радиоэлектронных приборов и систем А.Г. Петрович « » 2026
| Инженер по разработке технической документации Н.А. Ходосовская « » 2026
