Sasha7b9Work/LiniaServer/ТЗ.docx

| | УТВЕРЖДАЮ Генеральный директор ОАО «МНИПИ» В.А. Шевченко « » 2026

ТЕХНИЧЕСКОЕ ЗАДАНИЕ

на разработку цифрового осциллографа

с полосой пропускания 250 МГц

1 Основание для выполнения ОКР

1.1 ОКР выполняется с целью улучшения технических характеристик осциллографа С8-54

1.2 Основание для выполнения ОКР – Приказ ОАО «МНИПИ» №136 от 29.06.2026

1.2.1 Сроки выполнения ОКР устанавливаются календарным планом работы к приказу.

2 Исполнитель ОКР: ОАО «МНИПИ»

3 Изготовитель: ОАО «МНИПИ»

4 Цель и назначение разработки

4.1 Целью выполнения ОКР является разработка цифрового осциллографа с полосой пропускания 250 МГц (далее – осциллограф).

Осциллограф предназначен для визуального наблюдения периодических сигналов и измерения их амплитудных и временных параметров в полосе частот от 0 до 250 МГц.

Осциллограф предназначен для установки в наземных стационарных отапливаемых помещениях и сооружениях, диапазон температур рабочих условий эксплуатации от минус 10 ºС до плюс 50 ºС (ГОСТ 22261-94).

4.2 Наименование образца – «Осциллограф цифровой С8-54/1».

4.3 Область применения – измерения при метрологическом обслуживании различных видов техники, в том числе специальных технических средств.

4.4 Осциллограф должен быть конкурентоспособным на рынке СНГ.

5 Источник финансирования

5.1 Источники финансирования – собственные средства ОАО «МНИПИ».

6 Технические требования

6.1 Состав осциллографа

6.1.1 Состав комплекта осциллографа приведен в таблице 1.

Таблица 1

Наименование | Количество | Назначение
1 Осциллограф цифровой С8-54/1 | 1 | Обеспечение измерительных функций
2 Комплект ЗИП | 1 | Обеспечение эксплуатации и ремонта
3 Эксплуатационная документация (комплект) | 1 | Обеспечение правильной эксплуатации и обслуживания
4 Упаковка | 1 | Обеспечение транспортирования

6.2 Требования назначения

6.2.1 В осциллографе должны быть 2 канала вертикального отклонения.

6.2.2 Рабочая часть экрана цветного жидкокристаллического индикатора (ЖКИ) должна быть не менее 145 мм по диагонали (8х10 дел).

6.2.3 Коэффициенты отклонения каждого из каналов должны устанавливаться в диапазоне от 2 мВ/дел до 5 В/дел.

6.2.4 Пределы допускаемой основной погрешности коэффициентов отклонения каждого из каналов А и Б в нормальных условиях эксплуатации должны быть равны ±3 %. Пределы допускаемой погрешности коэффициентов отклонения в рабочем диапазоне температур должны быть равны ±4,5 %.

6.2.5 Время нарастания переходной характеристики при непосредственном входе должно быть не более 1,4 нс (полоса пропускания – от 0 Гц до 250 МГц).

6.2.6 Параметры входов каналов вертикального отклонения должны быть:

- входное сопротивление (1±0,03) Мом;

- Входная емкость не более 20 пФ.

6.2.7 Допускаемое суммарное значение постоянного и переменного напряжения при закрытых и открытых входах каждого канала должно быть не более 110 В при непосредственном входе и 250 В при работе с выносным делителем 1:10.

6.2.8 Максимальная длина записи должна составлять не менее 32 Кбайт на канал.

6.2.9 В осциллографе должен обеспечиваться режим предзапуска и послезапуска.

6.2.10 Коэффициенты развертки должны устанавливаться в диапазоне от 1 нс/дел до 50 с/дел в последовательности 1; 2; 5.

6.2.11 Осциллограф должен обеспечивать автоматический, ждущий и однократный режимы запуска развертки. Должен быть предусмотрен режим «СТОП».

6.2.12 Пределы допускаемой основной погрешности коэффициентов развертки в нормальных условиях применения должны быть равны ±2,5 %.

6.2.13 В осциллографе должны быть следующие виды синхронизации:

- внутренняя по каждому из каналов;

- внешняя.

6.2.14 Предельные уровни внутренней и внешней синхронизации должны быть:

- минимальный уровень -0,8 дел;

- максимальный – 8 дел.

6.2.15 Диапазон частот внутренней и внешней синхронизации должен быть от 0,6 Гц до 250 МГц.

6.2.16 В осциллографе должен быть встроенный калибратор амплитуды.

Пределы допускаемой основной погрешности амплитуды импульсов калибратора должны быть равны ±0,8 %.

Пределы допускаемой погрешности амплитуды импульсов калибратора в рабочем диапазоне температур должны быть равны ±1,2 %.

6.2.17 Осциллограф должен обеспечивать автоматические и курсорные измерения параметров сигналов с выводом результатов измерения в цифровом виде на экран ЖКИ.

6.2.18 Максимальная частота дискретизации исследуемого сигнала по каждому из каналов должна быть не менее 250 МГц, в одноканальном режиме не менее 500 МГц.

6.2.19 Осциллограф должен иметь возможность управления и передачи результатов измерений посредством интерфейса USB.

6.2.20 Осциллограф должен обеспечивать свои технические характеристики в пределах норм, заданных ТЗ, через 15 мин после включения.

6.2.21 Осциллограф должен допускать непрерывную работу в рабочих условиях применения в течение времени не менее 16 ч при сохранении технических характеристик в пределах норм, заданных ТЗ.

6.2.22 Осциллограф должен сохранять свои технические характеристики в пределах нормы при питании от сети переменного тока напряжением (230±23) В частотой (50±0,5) Гц, напряжением 220 В частотой 400 Гц.

6.2.23 Мощность, потребляемая осциллографом от сети питания при номинальном напряжении, не должна превышать 90 В*А.

6.3 Требования к электромагнитной совместимости

6.3.1 Уровень индустриальных радиопомех, создаваемых осциллографом, не должен превышать значений, установленных в СТБ ГОСТ Р 51522 для оборудования класса А.

6.3.2 Осциллограф должен соответствовать требованиям СТБ ГОСТ Р 51522 для оборудования класса А по следующим видам внешних помех:

- электростатические разряды - критерий качества функционирования В;

- наносекундные импульсные помехи (пачки) - критерий качества функционирования В;

- выбросы напряжения - критерий качества функционирования В;

- динамические изменения напряжения питания - критерий качества функционирования В;

- излучаемое радиочастотное электромагнитное поле - критерий качества функционирования А;

- кондуктивные помехи, наведенные радиочастотными электромагнитными полями - критерий качества функционирования А.

6.4 Требования к надежности

6.4.1 Осциллограф должен обеспечивать следующие показатели надежности:

а) средняя наработка на отказ - не менее 10000 ч. Критерием отказа является несоответствие технических характеристик осциллографа требованиям ТУ;

б) средний срок службы – не менее 8 лет;

в) среднее время восстановления работоспособности осциллографа - не более 3 ч.

6.4.2 Перед предъявлением отделу технического контроля (ОТК) 100 % осциллографов должны быть подвергнуты технологической приработке в течение 42 ч.

Осциллограф должен быть подвергнут технологической тряске в течение 30 мин на частоте (25 ± 5) Гц с ускорением 19,6 м/с² во включенном состоянии.

6.5 Конструктивные требования

6.5.1 Качество сборки, монтажа и внешний вид осциллографа должны соответствовать КД и действующим ТНПА, в том числе:

- все надписи на осциллографе должны быть выполнены согласно чертежам;

- все составные части должны быть прочно закреплены в соответствии с чертежами.

6.5.2 Комплектующие электрорадиоэлементы (ЭРЭ), материалы и полуфабрикаты, применяемые в осциллографе, должны соответствовать государственным стандартам и (или) ТУ на них и иметь паспорт (сертификат) о приемке их изготовителем.

6.5.3 Масса осциллографа должна быть не более 4 кг. Масса осциллографа с упаковкой должна быть не более 6 кг.

6.6 Требования безопасности

6.6.1 Осциллограф должен соответствовать требованиям безопасности, установленным ГОСТ IEC 61010-1 (оборудование класса I, категория перенапряжения II, степень загрязнения 1).

6.6.2 Электрическая изоляция цепи питания осциллографа должна выдерживать без возникновения разрядов и поверхностных пробоев в течение 1 мин действие испытательного напряжения 1500 В (среднее квадратическое значение) частотой 50 Гц.

Напряжение прикладывают между соединенными вместе питающими штырями сетевой вилки и опорной точкой.

6.6.3 Значение сопротивления между зажимом защитного заземления осциллографа и каждой доступной токопроводящей частью осциллографа не должно превышать 0,1 Ом.

6.6.4 Осциллограф должен соответствовать требованиям пожарной безопасности, установленным в ГОСТ 12.1.004, ГОСТ IEC 60950-1 и иметь аппараты защиты при ненормальных режимах работы (перегревах, перегрузках, токах короткого замыкания и т.п.).

Вероятность возникновения пожара не должна превышать 10⁻⁶ в год.

6.7 Требования охраны окружающей среды

6.7.1 Эксплуатация, хранение, транспортирование и утилизация осциллографа не должны оказывать вредного воздействия на окружающую среду и здоровье человека.

### 6.8 Требования по устойчивости и прочности к внешним воздействиям

6.8.1 По устойчивости и прочности при климатических воздействиях осциллограф должен удовлетворять следующим требованиям.

Рабочие условия применения:

- температура окружающего воздуха от минус 10 оС до плюс 40 оС;
- относительная влажность воздуха до 90 % при температуре плюс 25 оС;
- атмосферное давление от 60 до 106,7 кПа (от 450 до 800 мм рт. ст.).

Предельные условия транспортирования:

- температура окружающего воздуха от минус 40 оС до плюс 50 оС;
- относительная влажность воздуха до 95 % при температуре плюс 25 оС;
- атмосферное давление от 60 до 106,7 кПа (от 450 до 800 мм рт. ст.).

6.8.2 По прочности к механическим воздействиям при транспортировании осциллограф в упакованном виде должен выдерживать удары многократного действия: ускорение – 147 м/с² (15 g), длительность импульса – (5 - 10) мс, число ударов – 2000, частота ударов в минуту – 200.

6.9 Требования к маркировке и упаковке

6.9.1 Маркировка осциллографа должна соответствовать требованиям ГОСТ 22261, КД и выполнена способом офсетной печати. Допускается выполнение маркировки другими способами на основе современных технологий.

6.9.2 На осциллограф должно быть нанесено:

- наименование и тип осциллографа, товарный знак изготовителя, знак утверждения типа средств измерений Республики Беларусь;
- поясняющие надписи и символы, необходимые для правильной эксплуатации осциллографа согласно КД;
- порядковый номер по системе нумерации изготовителя (заводской номер) и год изготовления, надпись ″СДЕЛАНО В БЕЛАРУСИ″, единый знак обращения продукции на рынке государств – членов Таможенного союза (знак ″ЕАС″);
- испытательное напряжение изоляции (символ С-2 по ГОСТ 23217), напряжение питания, потребляемая мощность, тип вставок плавких, номинальный ток и скорость разрыва цепи.

Надписи и знаки, наносимые на осциллограф, должны быть четкими и разборчивыми.

6.9.3 Маркировка на упаковке должна выполняться в соответствии с ГОСТ 14192, КД типографским способом на этикетках и содержать:

- манипуляционные знаки: ″Хрупкое. Осторожно″, ″Беречь от влаги″, ″Верх″ по ГОСТ 14192;
- наименование и тип осциллографа, товарный знак и местонахождение изготовителя;
- обозначение ТУ, знак утверждения типа средств измерений Республики Беларусь, знак ″ЕАС″, надпись ″СДЕЛАНО В БЕЛАРУСИ″, дату изготовления, штамп ОТК, массы брутто и нетто, габаритные размеры упаковки.

6.9.4 Упаковка осциллографа должна соответствовать требованиям ГОСТ 22261 и КД.

6.10 Требования к транспортированию, эксплуатации и хранению

6.10.1 О Осциллограф в упаковке изготовителя должен допускать транспортирование в закрытых транспортных средствах любого вида транспорта.

При транспортировании самолетом осциллограф должен быть размещен в отапливаемом герметизированном отсеке.

Трюмы судов, кузова автомобилей, используемые для перевозки осциллографа, не должны иметь следов цемента, угля, химикатов и пр.

Климатические условия транспортирования не должны выходить за пределы заданных условий:

- температура окружающего воздуха от минус 40 оС до плюс 50 оС;

- относительная влажность окружающего воздуха не более 95 % при температуре 25 оС.

6.10.2 Размещение и крепление в транспортном средстве упакованного осциллографа должно обеспечить его устойчивое положение и не допускать перемещение во время транспортирования.

6.10.3 Осциллограф до введения в эксплуатацию следует хранить на складе в упаковке изготовителя при температуре окружающего воздуха от плюс 5 оС до плюс 40 оС и относительной влажности воздуха не более 80 % при температуре 25 оС.

Осциллограф без упаковки должен храниться при температуре окружающего воздуха от плюс 10 оС до плюс 35 оС и относительной влажности воздуха до 80 % при температуре плюс 25 оС.

В помещении для хранения осциллографа содержание пыли, паров кислот и щелочей, агрессивных газов и других вредных примесей, вызывающих коррозию, не должно превышать содержание коррозионно - активных агентов для атмосферы типа 1 по ГОСТ 15150.

6.10.4 Эксплуатация осциллографа должна осуществляться в соответствии с руководством по эксплуатации УШЯИ.411161.063 РЭ.

Область применения осциллографа и меры пожарной безопасности при его использовании должны быть отражены в руководстве по эксплуатации.

9 Экономические показатели

9.1 Лимитные цены отдельных этапов настоящей работы определяются при заключении договора.

9.2 Лимитная цена осциллографа должна быть не более 1600 у.е.

10 Этапы выполнения ОКР

10.1 Наименование этапов, содержание работ, сроки выполнения и их отчетность устанавливается календарным планом к договору.

11 Порядок выполнения и приемки ОКР

11.1 Испытания и приемку осциллографа проводят в соответствии с требованиями ГОСТ 22261, ГОСТ 15.309.

Для проверки соответствия требованиям осциллограф подвергают:

- приемо-сдаточным испытаниям (ПСИ);

- периодическим испытаниям (ПИ);

- типовым испытаниям;

- испытаниям на надежность по ГОСТ 27.410;

- государственным испытаниям (ГИ) по действующим ТНПА.

11.2 В технически обоснованных случаях каждую категорию испытаний допускается проводить в несколько этапов, при этом осциллографы предъявляют отдельным извещением для каждого этапа испытаний. Результаты поэтапных испытаний должны быть документально оформлены.

11.3 ПСИ проводят с целью проверки каждого экземпляра осциллографа на соответствие требованиям ТУ в объеме, установленном для данной категории испытаний. Осциллографы на ПСИ предъявляют поштучно или партиями в количестве до 10 шт.

11.4 Правила приемки, порядок и условия забраковывания и возобновления приемки, порядок оформления документации должны соответствовать ГОСТ 15.309.

11.5 Осциллограф, выдержавший ПСИ, пломбируется ОТК, упаковывается и сдается на склад готовой продукции.

11.6 ПИ проводит изготовитель для подтверждения качества осциллографов в установленный период. ПИ проводят не реже одного раза в 5 лет на двух осциллографах, ПИ совмещают с ГИ.

При получении положительных результатов качество осциллографов считается подтвержденным, подтверждается возможность дальнейшего изготовления и выпуска осциллографов до очередных ПИ.

Если образец осциллографа не выдержал ПИ, то его приемку и отгрузку приостанавливают до выявления причин дефектов, их устранения и получения положительных результатов повторных ПИ.

Повторные ПИ проводят на удвоенном количестве осциллографов в полном объеме. Допускается повторные испытания проводить по сокращенной программе, включая только те виды испытаний, которые осциллографы не выдержали, а также виды, по которым испытания не проводились.

При положительных результатах ПИ приемку и отгрузку осциллографов возобновляют.

Результаты ПИ оформляют актом с приложением протоколов, отражающих результаты каждого вида испытаний.

11.7 Типовые испытания проводят в целях оценки эффективности и целесообразности внесения изменений в конструкцию или технологию изготовления осциллографа, влияющих на его технические характеристики.

11.8 Типовые испытания проводит изготовитель по программе и методикам, им же разработанным. Объем типовых испытаний, включенных в программу, должен быть достаточным для оценки влияния внесенных изменений на характеристики осциллографа.

Результаты типовых испытаний оформляют актом с приложением протоколов, отражающих положительные (отрицательные) результаты испытаний.

11.9 При положительных результатах типовых испытаний предлагаемые изменения вносят в документацию на осциллограф в соответствии с установленным порядком.

11.10 Оценку показателей надежности осциллографа проводят в соответствии с ГОСТ 27.410 и программой испытаний, утвержденной в установленном порядке.

Допускается не считать отказом осциллографа отказ его компонентов, если они входят в комплект ЗИП, имеют индикацию отказа и если этот отказ не приводит к необходимости настройки и регулировки осциллографа.

Первичные испытания на надежность проводят при постановке осциллографов на производство, последующие – не реже одного раза в 8 лет по утвержденной программе.

Планирование испытаний и метод контроля средней наработки на отказ проводят по ГОСТ 27.410.

11.11 Осциллограф считается окончательно забракованным, если он предъявлялся ОТК более трех раз. Решение об использовании окончательно забракованного осциллографа, а также осциллографа, прошедшего ПИ, принимается руководителем изготовителя.

| Главный конструктор – начальник управления радиоэлектронной продукции и средств измерения ОАО «МНИПИ» А.А. Володкевич « » 2026
| Руководитель работ, начальник отдела радиоэлектронных приборов и систем А.Г. Петрович « » 2026
| Инженер по разработке технической документации Н.А. Ходосовская « » 2026
