Sasha7b9Work/LiniaServer/Фото нового конденсатора.docx

Вид спереди

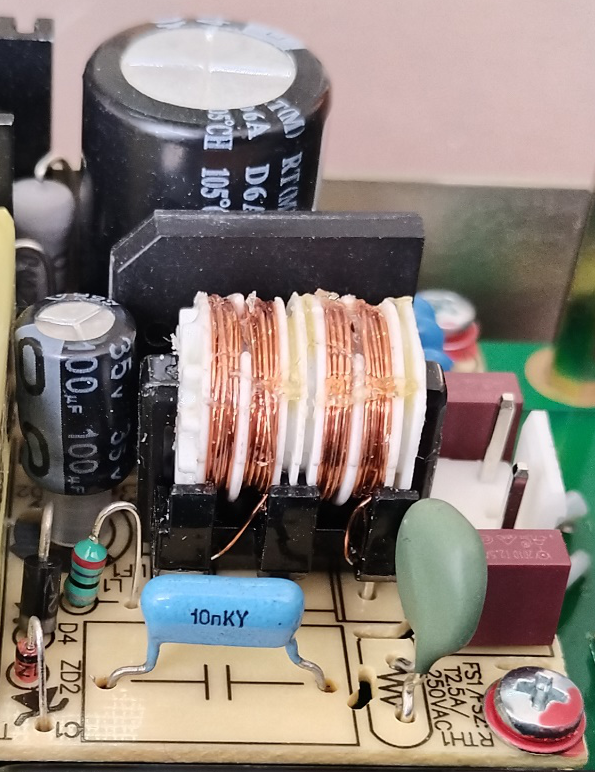
[picture p44: figure]

Вид сверху

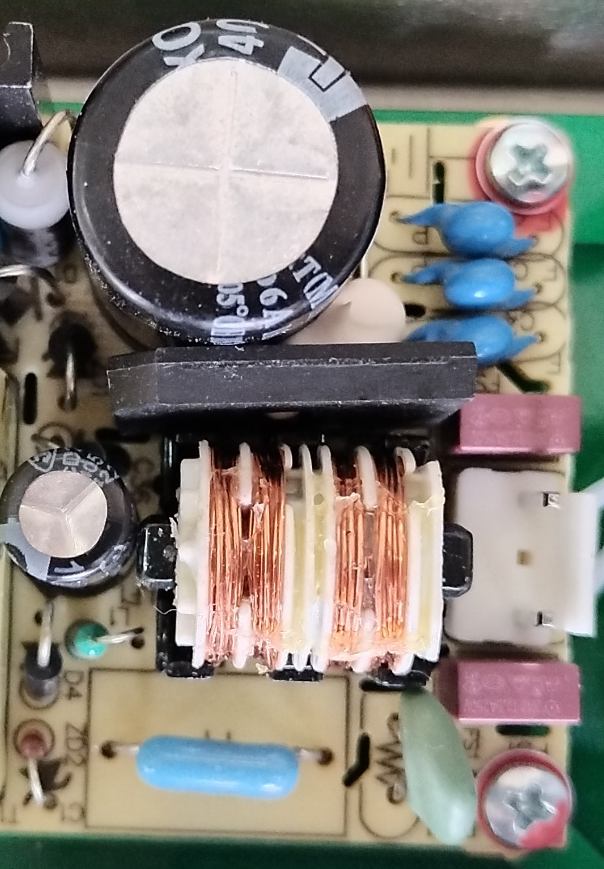
[picture p45: figure]
