Sasha7b9Work/LiniaServer/Инструкция по настройке C8-54.docx

(Начало документа см. рукописный текст Матюшонка).

7.3 Контроллер монитора (УШЯИ.467444.110) предназначен для формирования изображения на экране осциллографа путем непрерывной передачи RGB информации и сигналов HSINC, VSING горизонтальной и вертикальной разверток и выполнен на базе процессора PIC24. На плате контроллера монитора расположен драйвер подсветки монитора.

7.3.1 Отключите разъем осциллографа XS22 от платы Контроллера монитора, прозвоните на плате контакты 1, 2 разъема XP2 между собой на отсутствие КЗ. Подключите разъем осциллографа XS22. Включите питание осциллографа. Проверьте на плате наличие напряжения 3,3V на выводе 4 микросхемы DA1. Запрограммируйте микроконтроллер PIC24FJ256DA210T.

7.3.2 Программирование микроконтроллера PIC24FJ256DA210T (DD1).

Для программирования микросхемы PIC24FJ256DA210T требуется:

- ПК с установленной OC Windows версии 7 или выше;

- среда разработки MPLAB IDE v.8.92;

- программатор PICkit 3 фирмы Microchip.

Программатор соединить с ПК через порт USB. Первые пять контактов второго разъёма программатора соеднить с соответствующими контактами разъёма XP1 платы Контроллера монитора (УШЯИ.467444.110).

Программирование производится в следующей последовательности (ВНИМАНИЕ! Для программирования микропроцессора питание на осциллограф подавать не нужно):

- на ПК запустить программу “MPLAB IDE” v.8.92;

- через меню File\Import импортировать файл S8-54\sources\Display\Display.hex;

- в меню Programmer\Select Programmer выбрать PICkit 3;

- в меню Configure\Select Device… выбрать устройство PIC24FJ256DA210;

- во вкладке Power меню Programmer\Settings установить напряжение 3.25В и выбрать пункт Power target circuit from PICkit 3;

- выполнить программирование микропроцессора через меню Programmer\Program. Успешное завершение обозначается сообщением «Programming/Verify complete»;

- отсоединить программатор.

7.3.3 Проверка работоспособности Контроллера монитора осуществляется песле установки платы в рабочем приборе после проверки работоспособности Процессора (УШЯИ.467444.108).

7.4 На Панели управления (УШЯИ.467851.015) расположены все органы управления передней панели и контроллер передней панели, выполненный на процессоре PIC18.

7.4.1 Включите питание осциллографа на задней панели. Убедитесь в наличии напряжения 12V на контакте 3 микросхемы DA1 платы Панели управления, а затем напряжения 3,3V на выводе 1 этой микросхемы. Запрограммируйте микроконтроллер PIC18F2515ISO. Дополнительных регулировок плата не требует.

7.4.2 Программирование микроконтроллера PIC18F2515ISO (DD1).

Для программирования микросхемы PIC18F2515ISO требуется:

- ПК с установленной OC Windows версии 7 или выше;

- среда разработки MPLAB IDE v.8.92;

- программатор PICkit 3 фирмы Microchip.

Программатор соединить с ПК через порт USB. Первые пять контактов второго разъёма программатора соеднить с соответствующими контактами разъёма XP1 платы Панели управления (УШЯИ.467851.015).

Программирование производится в следующей последовательности (ВНИМАНИЕ! Для программирования микропроцессора питание на осциллограф подавать не нужно):

- на ПК запустить программу “MPLAB IDE” v.8.92;

- через меню File\Import импортировать файл S8-54\sources\ Panel \ mn_sever_rf.hex;

- в меню Programmer\Select Programmer выбрать PICkit 3;

- в меню Configure\Select Device… выбрать устройство PIC18F2515;

- во вкладке Power меню Programmer\Settings установить напряжение 5.0В и выбрать пункт Power target circuit from PICkit 3;

- выполнить программирование микропроцессора через меню Programmer\Program. Успешное завершение обозначается сообщением «Programming/Verify complete»;

- отсоединить программатор.

7.4.3 Проверка работоспособности платы Панели управления осуществляется песле установки платы в рабочем приборе после проверки работоспособности Процессора (УШЯИ.467444.108).

7.5.1 Процессор (УШЯИ.467444.108) содержит основной процессор осциллографа с дополнительной оперативной памятью, два канала аналого-цифровых преобразователей, формирователь синхроимпульса, ПЛИС, формирователь сигналов калибратора, рандомизатор, формирователь звукового сигнала и микросхему для формирования сигналов связи прибора в сети “Ethernet”.

ПЛИС DD3 (EP3C16Q240C8N) осуществляет управления режимом дискретизации сигналов, обеспечивает привязку начала записи результатов дискретизации к синхроимпульсу в соответствии с установленной величиной предзапуска, осуществляет оперативное хранение результатов дискретизации, управляет калибратором осциллографа и рандомизатором.

7.5.2 Для подключения платы Процессора в приборе должна быть установлена исправная и запрограммированная плата Панели управления.

Отключите разъем осциллографа XS16 от платы Процессора прозвоните на плате контакты 4, 5, 6, 8 относителено корпуса прибора на отсутствие КЗ. Подключите разъем осциллографа XS16. Включите питание осциллографа на задней панели, а затем и на передней. Проверьте наличие питающих напряжений: +3,3V на выводе 4 микросхемы DA6, +2,5V на выводе 4 микросхемы DA8, +1,8V на выводе 4 микросхемы DA9, 1,2V на выводе 4 микросхемы DA10.

    7.5.3 Программирование микросхемы DD5 ( EPCS4SI8)

Для программирования микросхемы EPCS4SI8 на плате Процессора требуется:

- ПК с установленной ОС Windows 7;

- среда разработки " Quartus II 12.1;

- программатор USB Blaster.

Программатором USB Blaster подключить к порту USB ПК согласно его описания. Выходной кабель программатора соединить с вилкой ХР3, расположенной на плате Процессора.

Программирование производится в следующей последовательности:

- включите осциллограф на задней панели а затем на передней;

- на ПК запустить программу " Quartus II 12.1";

- в меню (Tools) выбрать Programmer и загрузить файл " Program/RELF.jic ;

- выполните программирование микросхемы памяти, после завершения процесса программирования выключите питание осциллографа, отсоедините сетвой шнур от сети и отсоедините программатор.

7.5.4 Программирование микроконтроллера STM32F437ZIT6 (DD1)

Для программирования микросхемы STM32F437ZIT6 требуется:

- ПК с установленной OC Windows версии 7 или выше;

- утилита STM32 ST-LINK Utility фирмы STMicroelectronics;

- программатор ST-LINK/V2 фирмы STMicroelectronics.

Программатор соединить с ПК через порт USB. Соединить разъём STM32 программатора с разъёмом XP1 платы процессора с помощью шлейфа из состава программатора.

Программирование производится в следующей последовательности:

- включить осциллограф;

- на ПК запусить программу STM32 ST-LINK Utility;

- выбрать пункт меню Target\Program;

- в окне Download нажать кнопку Browse и выбрать файл Loader54.hex;

- в окне Download нажать кнопку Start;

- по завершении процесса программирования снова выбрать пункт меню Target\Program и выбрать файл Device.hex;

- нажать кнопку Start;

- по завершении процесса программирования выключить питание осциллографа и отсоединить программатор.

7.5.5 Установка напряжения калибратора осциллографа.

Установка напряжения калибратора осциллографа осуществляется на рабочем осциллографе со снятыми кожухом и верхним экраном.

Включите питание осциллографа. Согласно Руководству по эксплуатации (УШЯИ.411161.063 РЭ) в меню ”СЕРВИС” последовательно выберите “КАЛИБРАТОР”, “+4V”.

К выходу калибратора осциллографа подключите внешний вольтметр второй щуп вольтметра подключите к корпусу осциллографа. На плате Процессора (УШЯИ.467444.108) резистором RP1 установите показания вольтметра в пределах 3,981V-4,019V.

7.5.6 Регулировка рандомизатора.

Регулировка рандомизатора осуществляется также на рабочем осциллографе со снятыми кожухом и верхним экраном.

Включите питание осциллографа. Выключите МЕНЮ. Нажмите по 2 раза последовательно кнопки передней панели “1”, “2”, “3”, ”4”, ”5”. Включите МЕНЮ, выберите “ОТЛАДКА”/“КОНСОЛЬ” число строк-5. Затем выберите “РАНД-ТОР”, “Информация”- “Показывать”, “Усредн” – 4.

Установите коэффициент разверток 20нс/дел. Подайте на вход осциллографа сигнал с частотой 5-10 МГц, настройте устойчивую синхронизацию сигнала.

На плате Процессора (УШЯИ.467444.108) резистором RP2 добейтесь чтобы первое числовое значение ”ВОРОТА” было не менее 1000, а второе не более 3000. Процесс установки этих значений статистический поэтому медленный, дождитесь установки значений. Если настройка выполнена правильно изображение сигнала на экране осциллографа будет без разрывов и искажений.

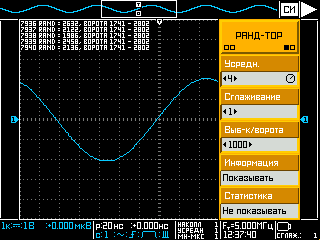
[picture p46: figure]

После настройки рандомизатора последовательным нажатием кнопки “МЕНЮ” выключите меню.

7.6 Предварительная настройка тракта вертикального отклонения (Блока регистрации УШЯИ.468739.049). Далее текст Матюшонка.

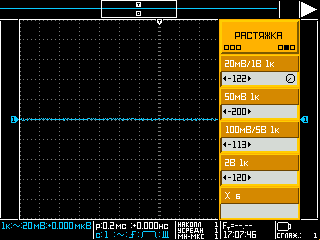
[picture p47: figure]

Вставка в текст Матюшонка

7.7 Дополнительная балансировка тракта вертикального.

Общая балансировка тракта вертикального отклонения обоих каналов выполняется автоматически при калибровке осциллографа по встроенному калибратору, однако остается небольшое смещение нуля в каналах на чувствительных диапазонах 2; 5; 10 мв/дел при открытом входе.

Дополнительная балансировка выполняется на собранном и настроенном осциллографе.

Выполните калибровку каналов вертикального отклонения согласно Руководству по эксплуатации (УШЯИ.411161.063 РЭ). В меню каналов установите “Связь”/”Пост”. В меню “ИЗМЕРЕНИЯ” выберите измерение “U скз”. Закоратите входы обоих каналов.

Выключите МЕНЮ. Нажмите по 2 раза последовательно кнопки передней панели “1”, “2”, “3”, ”4”, ”5”. Включите МЕНЮ, выберите “ОТЛАДКА”/”АЦП”/”ДОП СМЕЩ”

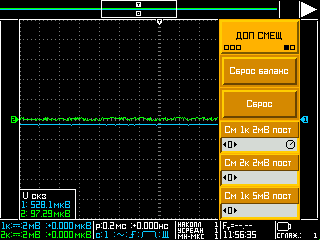
[picture p48: figure]

Выбирая последовательно регулируемый параметр и устанавливая соответствующий диапазон коэффициентов отклонения ручкой осциллографа “УСТАНОВКА” добейтесь минимальных показаний измерений U скз на обоих каналах и на диапазонах коэффициентов отклонения 2; 5: 10 мв/дел.

Последовательным нажатием кнопки “МЕНЮ” выключите меню. Для сохранения настроек выключите осциллограф кнопкой “ПИТАНИЕ” на передней панели.

7.8.1 Проверку работоспособности осциллографа в сети “ETHERNET” и возможность подключения его к ПК через “USB” выполните согласно Руководству по эксплуатации (УШЯИ.411161.063 РЭ).
