Sasha7b9Work/LiniaServer/Интерфейс управления/Подключения интерфейса.docx

Подключения интерфейса (УШЯИ.468359.031)

Разъем интерфейса XP содердит 3 сигнальных канала. «СТАРТ», «ИЗМЕРЕНИЕ», «ГОДЕН/». Этим 3 каналам соответствуют следующие каналы, подключенные к разъему XP15 Контроллера (УШЯИ467444.130):

СТАРТ = ST_EXT;

ИЗМЕРЕНИЕ = Meas;

ГОДЕН/ = FIT.

Каналам, подключенным к XP15 соответствуют следующие подключения к пинам в схеме Контроллера:

Meas = 97 пин CPU (DD4.2);

ST_EXT = 32 пин XP3.2 (GPIO1.2);

FIT = 37 пин XP3.1 (GPIO1.1).
