Sasha7b9Work/LiniaServer/Коммутатор/Управление Коммутатором.docx

Управление Коммутатором (УШЯИ468213.012 Э3)

Управление коммутатором осуществляется при помощи каналов «CLK_RG-», «CLK_RG+», «DAT_RG-», «DAT_RG+» и «ENB_RG». Где «CLK_RG-» и «CLK_RG+» это противофазные сигналы, также как и «DAT_RG-», «DAT_RG+». Их попарно прогоняют через диф приемник чтобы убрать шумы.

ENB_RgK является сигналом, разрешающим работу коммутатору. При состоянии «0» ведется запись в регистр. При переходе от «0» к «1» по переднему фронту прекращается запись в регистр и записанные биты подаются на выход.

У регистра используются входы SD, C, LC.

SD вход последовательных данных. Сюда микроконтроллер по очереди подает логические нули и единицы.

C - тактовый вход сдвига. По переднему фронту импульса (переход от 0 к 1) микросхема считывает бит с контакта DS и сдвигает внутреннюю очередь.

LC - тактовый вход защелки. Импульс (переход от 0 к 1) на этом пине мгновенно переносит всю накопленную последовательность из 8 бит на параллельные выходы. Импульс считывается по переднему фронту.

SD, C, LC, подключены к выходам логических элементов «И». DAT, CLK, ERG подключаются к входам логических элементов соответственно. К второму входу элементов DAT, CLK подключен ERG через логический элемент «НЕ». Таким образом, если ERG = 0 – то сигналы подаются на входы SD и C, если же он равен 1 то сигналы не подаются. Второй вход логического элемента «И» ERG подключен к 4 последовательно соединенным элементам «НЕ», которые подключены к питанию 5В, таким образом всегда выдавая «1».

OE — разрешение работы выходов. При подключении к земле (GND) выходы активны. OE подключен к земле (GND).

R — аппаратный сброс. Очищает внутренний регистр. Для обычной работы должен быть постоянно подключен к шине питания VCC (+5V). R подключен к питанию.

От регистра необходимы следующие комбинации:

Разряд | Значения разрядов и их комбинации | Функциональное назначение
Q4:Q0 База | 00000 | База в обрыве (обрыв)
| 10001 | База соединена с коллектором (коллекторор)
| 10010 | База соединена с эмиттером накоротко(эмиттер)
| 10100 | База соединена с эмиттером через 1 кОм (эмиттер 1кОм)
| 11000 | Подключение генератора ступенек B к гнезду B (База)
Q6:Q5 подложка | 00 | Подложка в обрыве (обрыв)
| 01 | Подложка соединена с эмиттером (эмиттер)
| 10 | Подкючение генератора ступенек S к гнезду S.
Q6:Q0 | 0000000 | База в обрыве; подложка в обрыве

3000V, 50E-, 50E+ определяют режим работы устройства. В отключенном состоянии каждый принимает состояние «1». Во включенном состоянии подтягиваются к земле по отдельности и принимают состояние «0».

DOOR представляет собой детектор открытия крышки устройства. При закрытой крышке DOOR принимает состояние «0» и разрешает работу устройства. При открытии крышки принимает состояние «1» и запрещает работу устройства.
