Sasha7b9Work/LiniaServer/Предварительные испытания -  Протоколы/Шапка.docx

# ПРЕДВАРИТЕЛЬНЫХ ИСПЫТАНИЙ

Объект испытаний: Осциллографы С8-53 ЗАВ №№ 01, 02

Испытания продолжить

Ведущий инж-конструктор Ю.Д.Шутов

Ведущий инж-конструктор М.В.Шут
