Sasha7b9Work/LiniaServer/С8-54_ПЭ3, ВП/ВП лист1 УШЯИ.411186.006.docx

### УТВЕРЖДАЮ

Первый заместитель

генерального директора –

главный инженер ОАО «МНИПИ»

______________А.А. Володкевич

«_____»_____________2016

ОСЦИЛЛОГРАФ ЦИФРОВОЙ С8-54

Ведомость покупных изделий

УШЯИ.411161.063 ВП

СОГЛАСОВАНО

Начальник ОКиМ

__________________А.Б. Шило

«____»____________2016

Начальник ОКК

__________________И.В. Волкова

«____»____________2016

Начальник НТО

__________________М.Г. Фирман

«____»____________2016
