Sasha7b9Work/LiniaServer/Контроллер/1-Настройка модулей.docx

Настройка модулей ЛНИНИИ- 2

1. Настройка модулей Линии-2 выполняется с использованием контроллера

467444.130.

2. Для работы необходим:

- компьютер с установленной ОС Windows 10;

- программное обеспечение – Linia2.exe;

- источник питание платы контроллера - PD-50A, связь

компьютера с платой контроллера осуществляется по интерфейсу USB;

3. Порядок работы следующий:

- включить компьютер;

- подключить настраиваемы модуль к контроллеру шлейфом (формирователь

развертки XP7);

- включить источник питания платы контроллера 467444.130;

- запустить программное обеспечение Linia2.exe. В окне программы COM-порт

отображается номер виртуального COM-порта, по которому программа связывается

с контроллером;

4. Проверить подключение платы контроллера к компьютеру через виртуальный

COM-порт:

- сочетание клавиш - “WIN I”;

- устройства. Должно в перечне устройств появиться устройство с последовательным

интерфейсом USB (COM5). В случае отсутствия необходимо отсоединить от

платы контроллера кабель USB и повторно его подключить.

5. На панели управления программы Linia2.exe в окне программы COM-порт

установить номер виртуального COM-порта.

6. Перейти в режим отладки по кнопке “ОТЛАДКА”;

7. На панели управления выбрать необходимый узел. Управлять записью данных

во внутренние регистры устройства.

8. Режим работы анализатора определяется данными регистров ПЛИС:

всего предусмотрено в ПЛИС 3 регистра. Выбор регистров сигналами

A0_Rg , A1_Rg;

Назначение регистров согласно таблицы

Наименование регистра | Назначение регистра | A0_Rg | A1_Rg | Количество разрядов
RG0 | Установка вида развертки | 0 | 0 | 9
RG1 | Установка длительности импульсов | 1 | 0 | 8
RG2 | Установка задержки запуска ADC для импульсных разверток | 0 | 1 | 8

Выбор развертки осуществляется 4-мя младшими битами регистра RG0 [3..0]

MODE_NONE =,0d //Invalid value

SIN_P = 1d, // Positive sine

SIN_N = 2d, // Negative sine

AC = 3d, // Alternating current

DC_P = 4d, // Positive DC

DC_N = 5d, // Negative DC

IMP_SIN_P = = 6d,// Positive pulse sine. High

IMP_SIN_N = = 7d,// Negative pulse sine. High

IMP_CVC = 8d,// Сurrent-voltage

Бит [4] регистра RG0 используется для идентификации тестируемого элемента:

IS_DIODE = 0;,

IS_TRANSISTOR = 1.

Биты [8..5] регистра RG0 используются для установки количество кривых ВАХ

для разверток DC+, DC-. Численное значение кода [8..5] – 0-15

Регистр RG1 используется для установки длительности импульсов для импульсных разверток.

Длительность импульса определяется соотношением

Ти= N*Sk, где

N – численное значение кода регистра RG1;

Sk – коэффициент размерности, для разверток IMP_CVC, IMP_OSC

Sk=1мкс, для разверток HI Pulse и Sk=10мкс для разверток HV Pulse

Регистр RG2 используется для установки задержки запуска ADC для импульсных

разверток. Длительность задержки определяется соотношением

RunDelay= N*Sk, где

N – численное значение кода регистра RG2;

Sk – коэффициент размерности, Sk=1мкс.

Для контроля сигналов, формируемых ПЛИС, на плате предусмотрены следующие

контрольные точки:

T1 – Line;

T2 – ENS;

T3 - adcRun;

T4 - adcClk;

T5 - Start_tb;

T6 - full.

9. Программное обеспечение Linea2.exe по нажатию кнопки “старт” формирует сигнал запуска развертки Start_tb с установленными значениями регистров ПЛИС и регистров настраиваемого модуля.
