Sasha7b9Work/LiniaServer/Инструкции по регулировке/инструкция по настройке C8-53.docx

| УТВЕРЖДАЮ
| Первый заместитель генерального директора ОАО “МНИПИ”
| А.Г.Варакомский
| “ ” 2026

ОСЦИЛЛОГРАФ ЦИФРОВОЙ

С8-53/1

Инструкция по настройке

УШЯИ.411161.061 И1

| | РАЗРАБОТАНА ОАО “МНИПИ”
| | Главный конструктор разработки, начальник отдела
| | А.Г.Петрович
| | “ ” 2026
| | Нормоконтролер
| | Е.С.Ильина
| | “ ” 2026

СОДЕРЖАНИЕ

Настоящая инструкция по настройке (далее по тексту-инструкция) устанавливает порядок проведения настройки осциллографа цифрового С8-53/1 с целью получения параметров изделия в пределах допусков, обеспечивающих выполнение требований технических условий ТУ BY100039847.132-2014.

# 1. Краткие сведения об осциллографе

1.1 Осциллограф цифровой С8-53/1 предназначен для исследования, регистрации и измерения параметров электрических сигналов в полосе частот от 0 до 100 МГц. Осциллограф обеспечивает регистрацию, запоминание, измерения в диапазоне амплитуд от 2 мВ до 300 В по двум каналам вертикального отклонения и временных интервалов от 2 нс до 100 с, а также измерение амплитудно-временных параметров, спектральный анализ входного сигнала с выводом результата на цветной TFT жидкокристаллический экран.

Область применения осциллографа: наладка, контроль, ремонт радиотехнической аппаратуры, электронных систем и устройств в различных областях хозяйственной деятельности.

1.2 Составные части осциллографа, которые проходят самостоятельную настройку или проверку:

- Блок питания УШЯИ.436714.025

- Блок регистрации УШЯИ.468739.047

- Блок цифровой УШЯИ.467444.103

- Блок управления УШЯИ.468332.114

- Устройство интерфейсное УШЯИ.468359.029

- Интерфейс УШЯИ.468359.026

- Фильтр сетевойFN9L60-4-06

- LCD-монитор TM057KДН01-

1.3 Принцип действия осциллографа изложен в руководстве по эксплуатации УШЯИ.411161.061 РЭ.

# 2. Перечень параметров, по которым производится настройка.

2.1 Параметры, по которым производится настройка и проверка, следующие:

- пределы допускаемой основной погрешности амплитуды калибратора;

- настройка равномерности амплитудно-частотной характеристики тракта вертикального отклонения;

- балансировка тракта вертикального отклонения;

- настройка диапазонов смещения и уровня;

- настройка переходной характеристики тракта вертикального отклонения;

- настройка линейности временных интервалов в наносекундных диапазонах;

- балансировка тракта вертикального отклонения в положениях 2,5 и 10 мВ/дел.

# 3. Указание мер безопасности

3.1 При настройке осциллографа необходимо выполнять следующие требования техники безопасности:

- пайку и монтаж в осциллографе проводить при отсоединении его то питающей сети;

- запрещается оставлять без присмотра включенный осциллограф;

- в помещении, где работает регулировщик, должны находится не менее 2-х человек;

- не допускать к рабочему посторонних людей;

- настройку блока питания может осуществлять регулировщик с квалификационной группой по ТБ не менее III.

Внимание: под напряжением опасным для жизни (сетевым напряжением) находятся фильтр сетевой, выключатель сети и блок питания.

# 4. Вспомогательные технические данные

4.1 Перечень необходимой при настройке технической документации приведен втаблице1.

Таблица 1.

Наименование документа | Обозначение документа
Руководство по эксплуатации. Технические условия. Схемы электрические принципиальные (альбом). Сборочный чертёж Электромонтажный чертёж. | УШЯИ.411161.061 РЭ ТУ BY 100039847.132-2014 УШЯИ.411161.061 Э3, ПЭ3 УШЯИ.411161.061 СБ УШЯИ.411161.061 МЭ

4.2 Для настройки осциллографа и его составных частей необходимы средства измерения, приведенные в ТУ BY 100039847.132-2014, кроме этого, необходим контрольный осциллограф типа С1-176, либо любой другой с аналогичными параметрами.

# 5. Требования к рабочему месту

5.1 Настройка осциллографа должна проводится в нормальных климатических условиях:

- температура окружающего воздуха: (20±5)℃

- относительная влажность: (30-80)%

- атмосферное давление: (84-106)кПа (630-795) мм. рт. ст.

5.2 Вблизи места регулировки и испытаний не должно быть мощных источников магнитных и электрических полей.

5.3 К рабочему месту должно быть подведено переменное напряжение (230±23)В частотой (50±0,5)Гц.

# 6. Подготовка к работе

  6.1 До проведения настройки необходимо проверить:
- наличие в сопроводительном документе отметки ОТК о приемке операций изготовления осциллографа, предшествующих настройке;
- наличие записи даты проведения поверки и срока следующей поверки СИ и контроля, проверки их работоспособности;
- наличие документов и приборов, указанных в разделе настоящей инструкции.

Примечание:

Для предотвращения выхода из строя полупроводниковых приборов при проверке монтажа необходимо пользоваться омметром с измерительным напряжением не более 1,5 В.

# 7. Методы настройки и проверки

## 7.1. Последовательность проведения операций настройки

Осциллограф состоит из функционально законченных составных частей, соединённых между собой посредством розеток и вилок. Настройка осциллографа проводится в следующей последовательности:

- настройка блока питания;
- программирование и предварительная проверка цифровых частей прибора:
a) блок управления УШЯИ.468332.114;
b) блок цифровой УШИЯ.467444.103.
- оживление и настройка Блока регистрации УШЯИ.468739.047;
- настройка процессора в режиме рандомизатора;
- настройка переходной характеристики;
- проверка интерфейса УШЯИ.468359.026 и устройства интерфейсного УШЯИ.468359.029
- проверка работоспособности осциллографа в сети “ETHERNET” и возможность подключения его к ПК через “USB

## 7.2. Проверка и контроль напряжений Блока питания

    7.2.1. Краткие сведения о блоке питания:

блок питания крепится на задней панели прибора и крепится к шасси прибора с помощью четырех винтов. В состав блока питания входят: фильтр сетевой (ХР1-УШЯИ.411161.061), выключатель «СЕТЬ» (SI – УШЯИ.411161.061) и непосредственно блок питания УШЯИ.436714.025, на котором установлен покупной блок питания RPS-60-12. Все перечисленные блоки закрыты двумя металлическими экранами.

    7.2.2. Проверка блока питания

отсоедините разъемы, идущие с блока питания, от других блоков осциллографа и, открутив 4 винта, достаньте блок питания из прибора. Установите переключатель «СЕТЬ» в положение «0» и прозвоните сетевые контакты фильтра ХР1 с соответствующими контактами разъема XS1(УШЯИ.4111161.061). Соединение должно отсутствовать. Переведите S1 в положения «1» и вновь прозвоните указанные цепи. Сопротивление цепей должно составлять около (2 ÷ 5) Ом. Если цепи не звонятся, проверьте наличие и исправность предохранителей F1, F2 фильтра сетевого. В случае наличия исправных предохранителей, снимите экран с фильтра сетевого и проверьте разъемные соединения между сетевым фильтром, выключателем «СЕТЬ» и блоком питания. Если дефект сохранился прозвоните выключатель «СЕТЬ». Неисправный выключатель замените. Если же переключатель исправен, проверьте фильтр сетевой и замените его в случае неисправности. Закройте фильтр сетевой экраном. Прозвоните на короткое замыкание согласно ЭЗ все входные и выходные напряжения блока питания. Поставьте переключатель «СЕТЬ» в положение «0». Соедините фильтр сетевой с помощью шнура сетевого с питающей сетью ~230В 50Гц. Включите блок питания (переведите выключатель «СЕТЬ» в положение «1»), измерьте напряжение на контакте 5 разъема XS14(УШЯИ.411161.061), величина которого должна быть около 12В. Если напряжение 12В отсутствует, выключите блок питания, отключите шнур питания от питающей сети, открутите 5 винтов, снимите экранирующую крышку с блока питания. Проверьте прозвонкой соединения ХР1 блока питания с ХР1 RPS-60-12 иXP2 RPS-60-12 c точками 3, 5 блока питания. Проверьте правильность установки и исправность диода VD2. Включите БП и измерьте на контакте 4 напряжение 12В. В случае его отсутствия замените блок RPS-60-12. Отключите БП от сети 230В 50Гц и подайте на разъем «=12V 1,2А» питание от сетевого адаптера, контролируйте на контакте 5 XS14 (напряжение 12В.) В случае отсутствия напряжения проверьте распайку разъема XS11(УШЯИ.411161.061 Э3) и правильность установки и исправность диода VD1 блока питания. После появления 12В продолжайте работать с адаптером, т.к. при таком включении на БП отсутствуют напряжения опасные для жизни. Соедините между собой перемычкой контакты 2,3 разъема XS15(ос). Измерьте выходные напряжения БП на разъемах XS2, XS15. В случае отсутствия напряжений на выходе проверьте транзистор VT1, неисправный замените. Если отсутствует одно из выходных напряжений проверьте DA1, DA2 и дроссели L1…L4, неисправный элемент замените. Отключите БП от адаптера, снимите перемычку, прикрутите снятый экран и установите БП в прибор.

## 7.3 Проверка и программирование Блока управления (УШЯИ.468332.114).

7.3.1 Блок управления содержит все органы ручного управления осциллографом и обеспечивает взаимодействие оператора с осциллографом. Обработку органов управления и взаимодействие с Блоком цифровым осуществляет микропроцессор STM32L063C8T6.

7.3.2 Включите питание осциллографа на задней панели, а затем и на передней. Проверьте наличие питающего напряжения: +3,3V на выводе 1 микросхемы DA1 (УШЯИ.468332.114).

7.3.3 Выполните программирование микропроцессора DD1 (STM32L063C8T6).

Для программирования микросхемы STM32L063C8T6 требуется:

- ПК с установленной OC Windows версии 7 или выше;

- утилита STM32 ST-LINK Utility фирмы STMicroelectronics;

- программатор ST-LINK/V2 фирмы STMicroelectronics.

Программатор соединить с ПК через порт USB. Соединить разъём STM32 программатора с разъёмом XP1 платы Блока управления с помощью шлейфа из состава программатора.

Программирование производится в следующей последовательности:

- включить осциллограф;

- на ПК запусить программу STM32 ST-LINK Utility;

- выбрать пункт меню Target\Program;

- в окне Download нажать кнопку Browse и выбрать файл Panel53.hex;

- в окне Download нажать кнопку Start;

- по завершении процесса программирования снова выбрать пункт меню Target\Program и выбрать файл Device.hex;

- нажать кнопку Start;

- по завершении процесса программирования выключить питание осциллографа и отсоединить программатор.

## 7.4 Проверка и программирование Блока цифрового (УШЯИ.467444.103).

7.4.1 Блок цифровой содержит основной процессор осциллографа с дополнительной оперативной памятью, два канала аналого-цифровых преобразователей, формирователь синхроимпульса, ПЛИС, формирователь сигналов калибратора, рандомизатор, формирователь звукового сигнала и микросхему для формирования сигналов связи прибора в сети “Ethernet”.

Основной процессор осциллографа DD1 (STM32F429IIT6) управляет всеми режимами работы осциллографа, формирует соответствующую информацию о установленном режиме работы и графическое изображение результатов дискретизации входных сигналов обоих каналов на экране осциллографа.

ПЛИС DD3 (EP3C16Q240C8N) осуществляет управления режимом дискретизации сигналов, обеспечивает привязку начала записи результатов дискретизации к синхроимпульсу в соответствии с установленной величиной предзапуска, осуществляет оперативное хранение результатов дискретизации, управляет калибратором осциллографа и рандомизатором.

7.4.2 Для подключения платы Блока цифрового в приборе должна быть установлена исправная и запрограммированная плата Блока управления.

Отключите разъем осциллографа XS15 от платы Блока цифрового, прозвоните на плате контакты 4, 5, 6, 8 относителено корпуса прибора на отсутствие КЗ. Подключите разъем осциллографа XS15. Включите питание осциллографа на задней панели, а затем и на передней. Проверьте наличие питающих напряжений: +3,3V на выводе 4 микросхемы DA6, +2,5V на выводе 4 микросхемы DA7, +1,8V на выводе 4 микросхемы DA8, 1,2V на выводе 4 микросхемы DA9.

7.4.3 Программирование микросхемы DD5 (EPCS4SI8)

Для программирования микросхемы EPCS4SI8 на плате Блока цифрового требуется:

- ПК с установленной ОС Windows 7;

- среда разработки " Quartus II 12.1;

- программатор USB Blaster.

Программатором USB Blaster подключить к порту USB ПК согласно его описания. Выходной кабель программатора соединить с вилкой ХР3, расположенной на плате Блока цифрового.

Программирование производится в следующей последовательности:

- включите осциллограф на задней панели, а затем на передней;

- на ПК запустить программу "Quartus II 12.1";

- в меню (Tools) выбрать Programmer и загрузить файл "Program/С8-53.jic";

- выполните программирование микросхемы памяти, после завершения процесса программирования выключите питание осциллографа, отсоедините сетевой шнур от сети и отсоедините программатор.

7.4.4 Программирование микроконтроллера STM32F429IIT6 (DD1)

Программатор соединить с ПК через порт USB. Соединить разъём STM32 программатора с разъёмом XP1 платы Блока цифрового с помощью шлейфа из состава программатора.

Программирование производится в следующей последовательности:

- включить осциллограф;

- на ПК запустить программу STM32 ST-LINK Utility;

- выбрать пункт меню Target\Program;

- в окне Download нажать кнопку Browse и выбрать файл Device53.hex;

- в окне Download нажать кнопку Start;

-затем аналогично записать файл Looder53.hex

- по завершении процесса программирования выключить питание осциллографа и отсоединить программатор.

7.4.5 Установка напряжения калибратора осциллографа.

Установка напряжения калибратора осциллографа осуществляется на рабочем осциллографе со снятыми кожухом.

Включите питание осциллографа. Согласно Руководству по эксплуатации (УШЯИ.411161.061 РЭ) в меню ”СЕРВИС” последовательно выберите “КАЛИБРАТОР”, “+4V”.

К выходу калибратора осциллографа подключите внешний вольтметр второй щуп вольтметра подключите к корпусу осциллографа. На плате Блока цифрового (УШЯИ.467444.103) резистором RP1 установите показания вольтметра в пределах 3,981V-4,019V.

7.4.6 Регулировка рандомизатора.

Регулировка рандомизатора осуществляется также на рабочем осциллографе со снятыми кожухом после предварительной настройки тракта вертикального отклонения (Блока регистрации).

Включите питание осциллографа. Выключите МЕНЮ. Нажмите по 2 раза последовательно кнопки передней панели “1”, “2”, “3”, ”4”, ”5”. Включите МЕНЮ, выберите “ОТЛАДКА”/“КОНСОЛЬ” число строк-5. Затем выберите “РАНД-ТОР”, “Информация”- “Показывать”, “Усредн” – 4 (рисунок 1).

Установите коэффициент разверток 20нс/дел. Подайте на вход осциллографа сигнал с частотой 5-10 МГц, настройте устойчивую синхронизацию сигнала.

На плате Блока цифрового (УШЯИ.467444.103) резистором RP2 добейтесь чтобы первое числовое значение ”ВОРОТА” было не менее 1000, а второе не более 3000. Процесс установки этих значений статистический поэтому медленный, дождитесь установки значений. Если настройка выполнена правильно изображение сигнала на экране осциллографа будет без разрывов и искажений.

После настройки рандомизатора последовательным нажатием кнопки “МЕНЮ” выключите меню.


Рисунок 1 – Интерфейс осциллографа С8-53 при регулировке рандомизатора

## 7.5. Предварительная настройка тракта вертикального отклонения (Блока регистрации)

7.5.1. Тракт вертикального отклонения состоит из двух одинаковых аттенюаторов каналов 1 и 2, двух идентичных усилителей первого и второго каналов, усилителей синхронизации канала 1, канала 2 и внешней синхронизации, коммутатора каналов синхронизации, фильтров синхронизации: АС, ФВЧ, ФНЧ, ПС; коммутатора фильтров синхронизации, цифро-аналоговых преобразователей смещения каналов и уровня синхронизации и регистра управления коэффициентами каналов и источника и фильтров синхронизации.

7.5.2. Настройка блока регистрации

Два канала тракта вертикального отклонения идентичны, поэтому здесь будет описана регулировка канала 1, а в скобках указаны регулировочные элементы канала 2.

Прозвоните на КЗ питающие напряжения Блока регистрации на разъеме XP5. Включите прибор. Проверьте все питающие напряжения блока согласно ЭЗ. При отсутствии какого-либо проверьте соответствующий стабилизатор, либо дроссель, неисправный элемент замените. Сделайте сброс настроек осциллографа (см. РЭ). Рукой смещения канала 1 (2) установите в положении 5мВ/дел изображение линии канала по центру экрана, переключая канал в положение 2мВ/дел и обратно резистором RP2(RP4) добейтесь, чтобы линия при переключениях не смещалась.

Установите курсор канала 1 (канала 2) по центру экрана (курсор канала 1 синего цвета, канала 2- оранжевого), переменным резистором RP10(RP9) линию изображения канала 1(канала 2) по центру экрана. Сместите курсор канала 1(канала 2) на 7 делений шкалы экрана и резистором RP5(RP 6) совместите линию изображения канала с курсором. Установите линию изображения канала 1 по центру экрана, включите синхронизацию от канала 1, фильтр ПС, курсор синхронизации ручкой

“УРОВЕНЬ” сместите в центр экрана, переменным резистором RP8 установите на контактах 1 и 4 разъёма XP1 одинаковое напряжение, контролирую его цифровым вольтметром. Подайте на вход канала 1 синусоидальный сигнал частотой 1 кГц и амплитудой на 10 делений экрана ЖКИ, развертку осциллографа установить удобной для наблюдения сигнала. Ручкой “уровень” сместите курсор синхронизации на 10-ое деление шкалы, переменным резистором RP7 добейтесь срыва синхронизации.

Подайте на канал 1(2) в положение коэффициента отклонения 10мВ/дел с генератора Г5-75 сигнал типа “меандр” частотой 1 кГц и амплитудой 80 мВ, переменным резистором RP1(RP3) установите вершину меандра параллельно горизонтальной линии шкалы.

Подключите предварительно скомпенсированный делитель 1:10 контрольного осциллографа к контакту 1 разъёма XP2(XP3). Подайте в положении к-та отклонения 0,5 V/дел меандр амплитудой 4 В, конденсатором С9 платы аттенюатора А1(А2) устраните возможные выбросы или спады на меандре. Подайте меандр амплитудой 400мВ в положении 50мВ/дел и конденсатором С3 платы А1 (А2) скорректируйте его форму.

Подайте на вход канала 1 (2) в положении 10 mV/дел сигнал с выхода калибратора осциллографов И 1-9 сигнал амплитудой 0,8 В через внешний делитель 1:10. Переменным конденсатором делителя установите вершину меандра параллельно горизонтальной линии шкалы. Переключите коэффициент отклонения в положение 1 В/дел, амплитуду установите 80 В, конденсатором С6 платы А1(А2) вершину изображения меандра сравняйте с горизонтальной линией шкалы. В положении 100мВ/дел подайте через делитель сигнал амплитудой 8В и конденсатором С5 А1(А2) поправьте его изображение. С помощью меню осциллографа (см. РЭ) осуществите калибровку и каналов. Проведите коррекцию балансировки коэффициентов отклонения каналов в положениях 2,5,10мВ.: для этого включите меню “ОТЛАДКА” поочередно дважды нажимая на кнопки 1,2,3,4,5. Выберете подменю “АЦП” / ”СМЕЩЕНИЕ” и, включая поочередно в положения 2 мВ, 5 мВ, 10мВ устраните отклонение изображения сигнала от курсора смещения в положения 2,5 и 10 мВ/дел на открытом входе осциллографа. Подключите к контакту 1 разъёма XP1 делитель 1:10 контрольного осциллографа, подайте на вход канала 1 сигнал с генератора Г5-75 типа “меандр” частотой 1 кГц, и проконтролируйте работу фильтров синхронизации: ФНЧ – сигнал интегрирован (фронты завалены), ФВЧ – сигнал дифференцирован, ПС – сигнал передается без искажений, АС – сигнал передается через большую емкость.

7.5.3 Настройка ПХ (переходной характеристики)

Включите к-т отклонения 5 мВ/дел, к-т развертки 1 нс/дел. Подайте на вход канала 1 (2) сигнал от генератора И1-14 сигнал, соответствующий по амплитуде восьми делениям шкалы экрана. Синхронизируйте сигнал, переменными емкостями С10, С12 и С16(С38,C44) установите выброс на ПХ около 5%, измерьте время нарастания ПХ, которое не должно превышать 3,5 нс. Включите канал в положение 0,5 В/дел и, установив амплитуду сигнала на экране ЖКИ равной 8 дел, произведите подстройку ПХ по указанным выше параметрам с помощью резистора RP1 платы А1 (А2) .Подайте сигнал равный восьми делениям в положении 50мВ/дел и подстройте выброс на ПХ резистором RP2 платы А1 (А2) . Проверьте ПХ в других положениях, указанных в ТУ.

## 7.6 Дополнительная балансировка тракта вертикального.

Общая балансировка тракта вертикального отклонения обоих каналов выполняется автоматически при калибровке осциллографа по встроенному калибратору, однако остается небольшое смещение нуля в каналах на чувствительных диапазонах 2; 5; 10 мв/дел при открытом входе.

Дополнительная балансировка выполняется на собранном и настроенном осциллографе.

Выполните калибровку каналов вертикального отклонения согласно Руководству по эксплуатации (УШЯИ.411161.061 РЭ). В меню каналов установите “Связь”/”Пост”. В меню “ИЗМЕРЕНИЯ” выберите измерение “U скз”. Закоратите входы обоих каналов.

Выключите МЕНЮ. Нажмите по 2 раза последовательно кнопки передней панели “1”, “2”, “3”, ”4”, ”5”. Включите МЕНЮ, выберите “ОТЛАДКА”/”АЦП”/”ДОП СМЕЩ” (рисунок 2).


Рисунок 2 – Интерфейс осциллографа С8-53 при дополнительной балансировке тракта вертикального

Выбирая последовательно регулируемый параметр и устанавливая соответствующий диапазон коэффициентов отклонения ручкой осциллографа “УСТАНОВКА” добейтесь минимальных показаний измерений U скз на обоих каналах и на диапазонах коэффициентов отклонения 2; 5: 10 мв/дел.

Последовательным нажатием кнопки “МЕНЮ” выключите меню. Для сохранения настроек выключите осциллограф кнопкой “ПИТАНИЕ” на передней панели.

## 7.7 Устройство интерфейсное УШЯИ.468359.029 и интерфейс УШЯИ.468359.026

Устройство интерфейсное УШЯИ.468359.029 и интерфейс УШЯИ.468359.026 не содержат активных элементов, и их проверка не требуется достаточно произвести внешний осмотр и проверку правильности подключения.

## 7.8. Проверка работоспособности осциллографа в сети “ETHERNET”

Проверку работоспособности осциллографа в сети “ETHERNET” и возможность подключения его к ПК через “USB” выполните согласно Руководству по эксплуатации (УШЯИ.411161.061 РЭ).
