Sasha7b9Work/LiniaServer/ИнтелАвто/ИЗОБРАЖЕНИЯ ОСНОВНЫХ ЭКРАННЫХ ФОРМ.docx

# ИЗОБРАЖЕНИЯ ОСНОВНЫХ ЭКРАННЫХ ФОРМ

компьютерной программы «Многофункциональная система бортового управления и индикации»

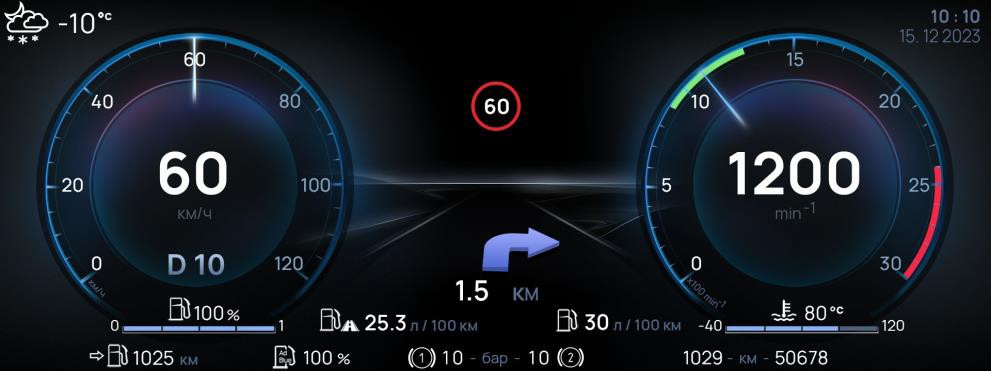
[picture p62: figure]

Рис.1 Главный экран со вспомогательной навигацией

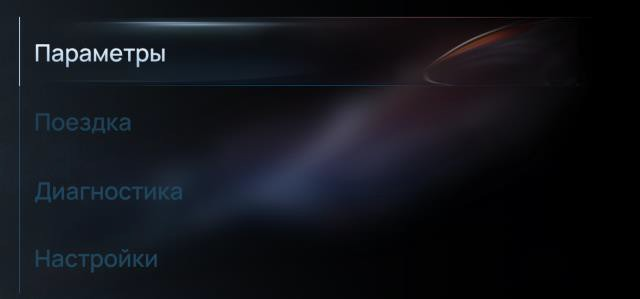
[picture p63: figure]

Рис.2 Интерфейс главного меню

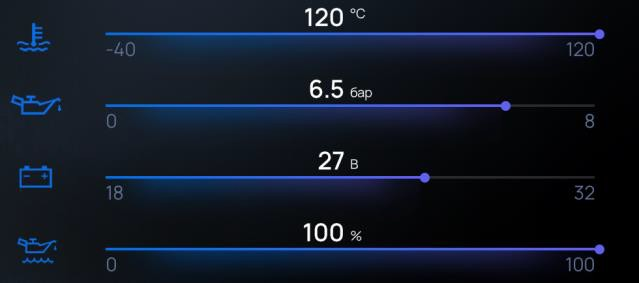
[picture p64: figure]

Рис.3 Экран параметров 1

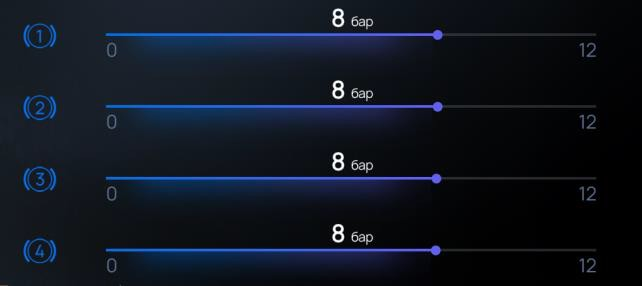
[picture p65: figure]

Рис.4 Экран параметров 2

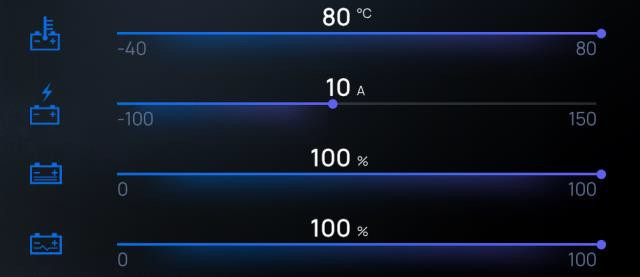
[picture p66: figure]

Рис.5 Экран параметров 3

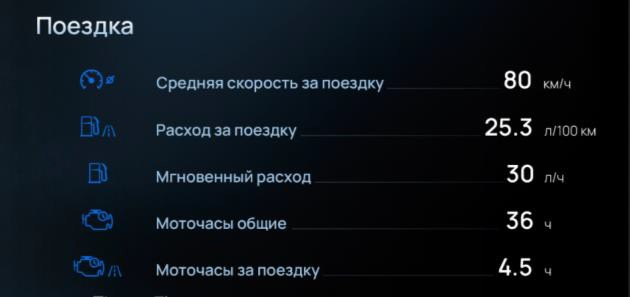
[picture p67: figure]

Рис.6 Экран поездка 1

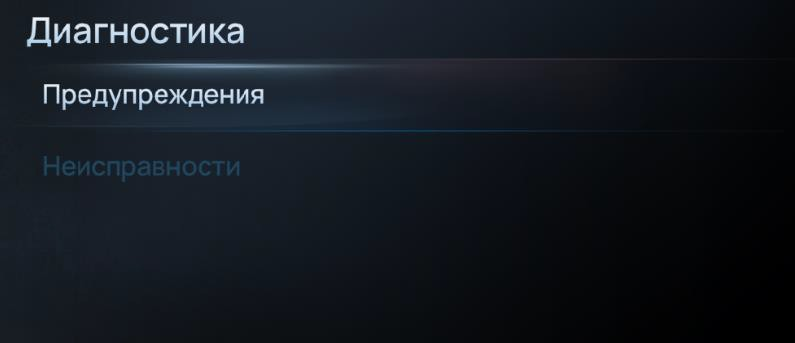
[picture p68: figure]

Рис.7 Экран меню «Диагностика»

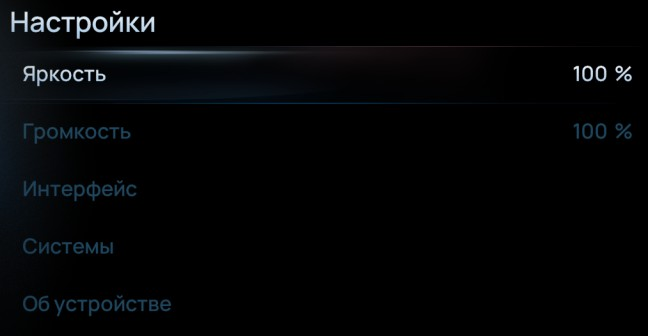
[picture p69: figure]

Рис.8 – экран меню «Настройки»
