Sasha7b9Work/LiniaServer/Контроллер/Описание компьютерной программы.docx

# Краткое описание компьютерной программы

# «Многофункциональная система бортового управления и индикации»

1. Назначение.

Данное программное обеспечение (ПО) предназначено для отображения информации о:

- скорости транспортного средства в цифровом виде;

- значении давлении воздуха в пневмосистеме;

- режимах движения ТС (P, R, N, D) и предупреждающих сообщениях от коробки передач;

- активном состоянии систем ТС;

- общем пробеге и за поездку;

- уровне топлива;

- аварийном состоянии систем;

- значении напряжения бортовой сети;

- значении температуры ОЖ;

- значении давлении масла в ДВС;

- сервисной информации.

С помощью разработанного программного обеспечения реализуется возможность:

- настройки яркости цифровой комбинации приборов;
- настройки громкости;
- настройки языка меню;
- настройки центрального замка;
- настройки освещения;
- настройки трансмиссии;
- настройки электрооборудования;
- настройки предупреждений;
2. Общие сведения.

Программное обеспечение представляет собой исходные текстовые файлы на языке С++/Qt/Qml.

3. Структура ПО.

Главная директория DigitalDashboardK5:

- Can.h, содержит текстовый файл описания структуры фрайма
- СanHandling.h, содержит текстовый файл описывающий прием передачу сообщений по САN.
- Data.h, содержит текстовый файл описывающий структуры входящих сигналов
- MainController.h, содержит текстовый файл описывающий управление приемом и идентификацией сообщений.
- Session.h, содержит текстовый файл описывающий структуру сессии
- SessionController.h, содержит текстовый файл описывающий управление и хранение сессий.
- Sound.h, содержит текстовые файлы описывающие управление воспроизведением звуковых файлов
- qml – содержит текстовые файлы реализующий интерфейс пользователя.

Примечание:

Для запуска программы необходимо:

1. Вставить CD диск в CD привод

2. Через «Проводник» открыть том «DigitalDashBoardK5» и зайти в папку SETUP

3. Дважды кликнуть на файл «SETUP DDBK5» таким образом запуская установку программы.

После установки программы на рабочем столе появится иконка программы «DDBK5»

4. Запустить программу дважды кликнув на иконку программы.

Требования к ПК:

- Процессор Intel Core i5
- ОЗУ 8 GB
- CD/DVD привод
- OC Windows 10, x64
