Sasha7b9Work/LiniaServer/Анализатор - общее/Презентация Володкевича2.pptx

## ОКР «Разработать и освоить производство программируемого измерителя параметров полупроводниковых приборов повышенной мощности», шифр «Линия-2»

Разработчик: ОАО «МНИПИ»
Изготовитель: ОАО «МНИПИ»
Сроки выполнения ОКР: 2 кв. 2025 г. – 1 кв. 2027 г.
Срок выполнения работ по освоению продукции: 2 кв. 2027 г. – 4 кв. 2031 г.
Объем финансирования: 1 315 000,00,
в том числе: 1 300 000,00 руб. – 650 000,00 руб. - средства внебюджетного централизованного инвестиционного фонда ГВПК (ВЦИФ ГВПК)
650 000,00 руб. – средства ОАО «Интеграл»
15 000,00 руб. – собственные средства ОАО «МНИПИ»
Потребители:
Предприятия электронной отрасли (ОАО «Интеграл», АО «НПП «Завод «Искра», АО «ВЗПП-С» и др.)

## Актуальность работы

Необходимость постановки ОКР заключается в отсутствии в РБ, РФ современной контрольно-измерительной техники (КИТ) для контроля параметров ЭКБ при разработке и производстве.
Существующая КИТ (ПНКТ-1, Л2-56, Л2-100, ИППП-1, ИППП-3) морально устарела, уступает оборудованию ведущих зарубежных компаний (Keysight, Keithley, Iwatsu).

## Цель

Цель: создание и освоение производства конкурентоспособного программируемого измерителя параметров силовых полупроводниковых приборов (ПП) с диапазоном тока от наноампер до сотен ампер и с диапазоном напряжения от милливольт до трех тысяч вольт, обеспечивающий автоматизацию контроля электрических параметров ПП.
Новый измеритель должен:
- измерять стандартные параметры ПП ;
- формировать отчет по результатам измерений;
- обладать функциональными возможностями на уровне современных требований;
- быть интуитивно понятным - не требовать специальных знаний в области программирования.
Справочно:
Измеритель ИППП предназначен для контроля параметров широкой номенклатуры полупроводниковых: биполярных транзисторов (эмиттер-база-коллектор), полевых транзисторов (сток-исток-затвор), диодов.

## Задачи

- адаптация технических и конструктивных решений измерительных узлов в каналах коллектора и базы прибора ИППП-3 к современным требованиям, с последующим изготовлением и настройкой новых узлов;
- разработка новых технических решений для реализации режима большого тока (200 А) в канале коллектора и импульсного режима (5 А) в канале базы с последующим изготовлением и настройкой соответствующих узлов;
- разработка, изготовление и настройка программируемого контроллера для управления измерительными блоками, с учетом требований электромагнитной совместимости;
- разработка, изготовления и настройки узлов связи с контроллером каждого из измерительных блоков;
- разработка и отладка программного обеспечения (ПО) для контроллера и измерительных блоков;
- разработка и отладка управляющего пакета ПО для внешнего ПК, обеспечивающего возможность задания условий измерений и автоматизацию измерений, возможность отображения результатов измерения в виде графиков и таблиц, возможность формирования и редактирования библиотек стандартных и пользовательских тестов.
При выполнении задания планируется изготовление макета и двух опытных образцов нового измерителя.

## Измерители параметров полупроводников приборов, созданные ОАО «МНИПИ»

- ИППП-1, 2004 год

- ИППП-3/1, 2010 год

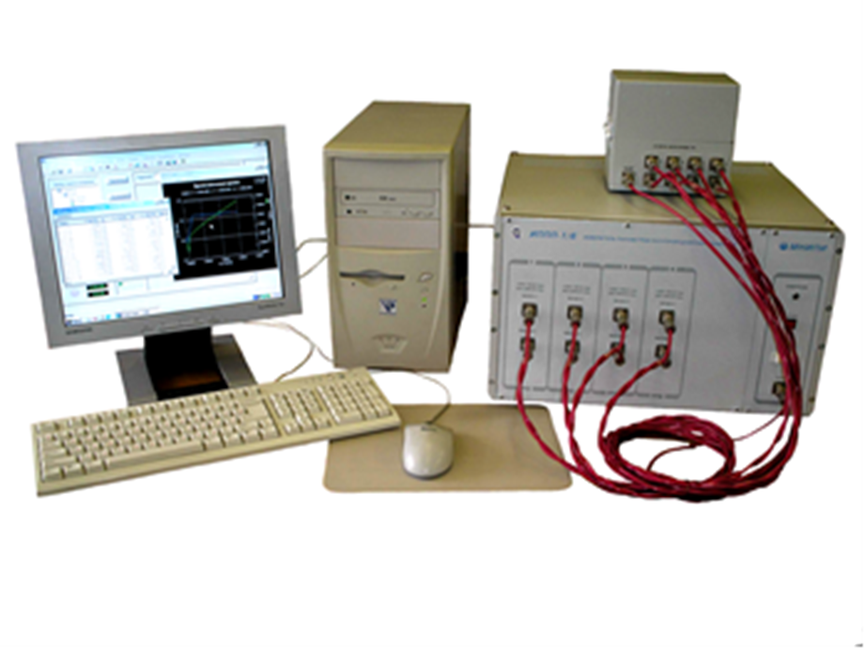
[picture p80: figure]
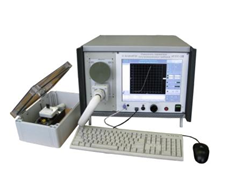
[picture p81: figure]

## Новизна разработки

Новизна разработки заключается в аппаратно-программной реализации новой концепции построения программируемого измерителя параметров силовых ПП, которая обеспечит возможность объединения в одном приборе уникальной совокупности характеристик:
- проведение измерений в автоматическом режиме и в режиме ручной регулировки (режим характериографа) при формировании развертки: непрерывным ступенчато-изменяющимся сигналом напряжения, пульсирующим сигналом и импульсным сигналом прямоугольной формы в режиме высокого напряжения (до ± 3000 В) и импульсным сигналом прямоугольной формы в режиме большого тока (до ± 200 А);
- возможность измерения ВАХ высоковольтных транзисторов при напряжении в цепи коллектора (стока) до 3000 В и токах от наноампер до 50 мА.

## Календарный план на 1 кв. 2025 г. – 1 кв. 2027 г.

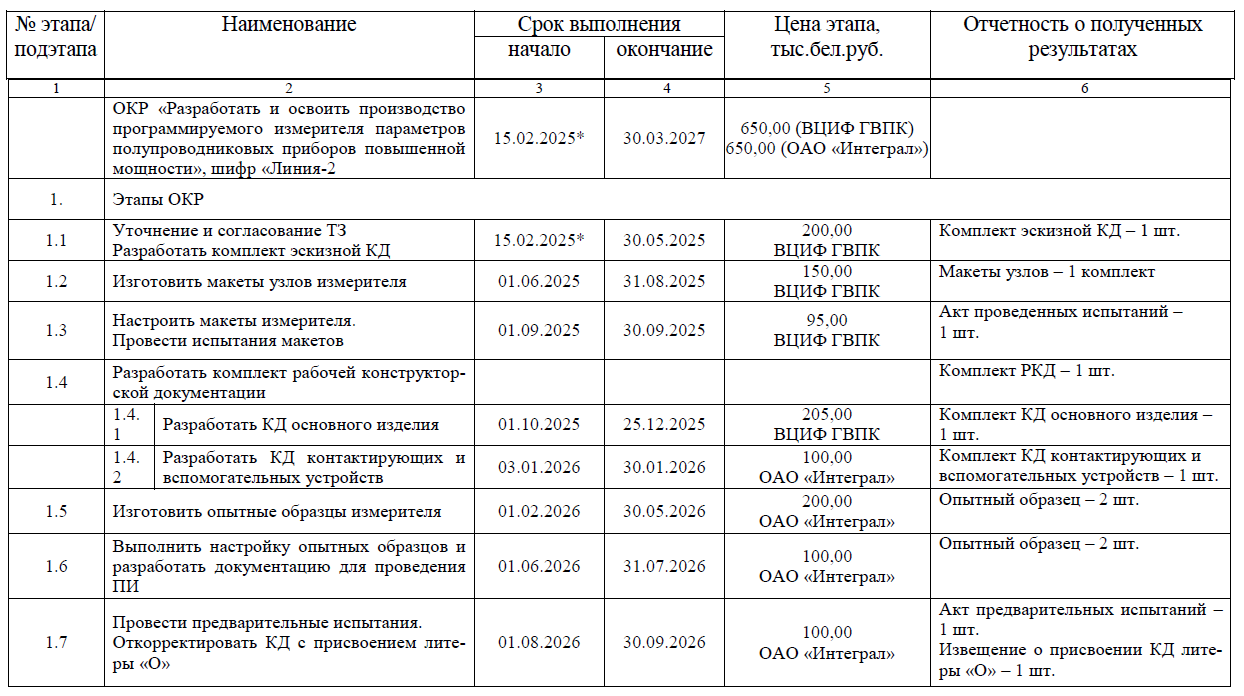
[picture p82: figure]

## (продолжение)

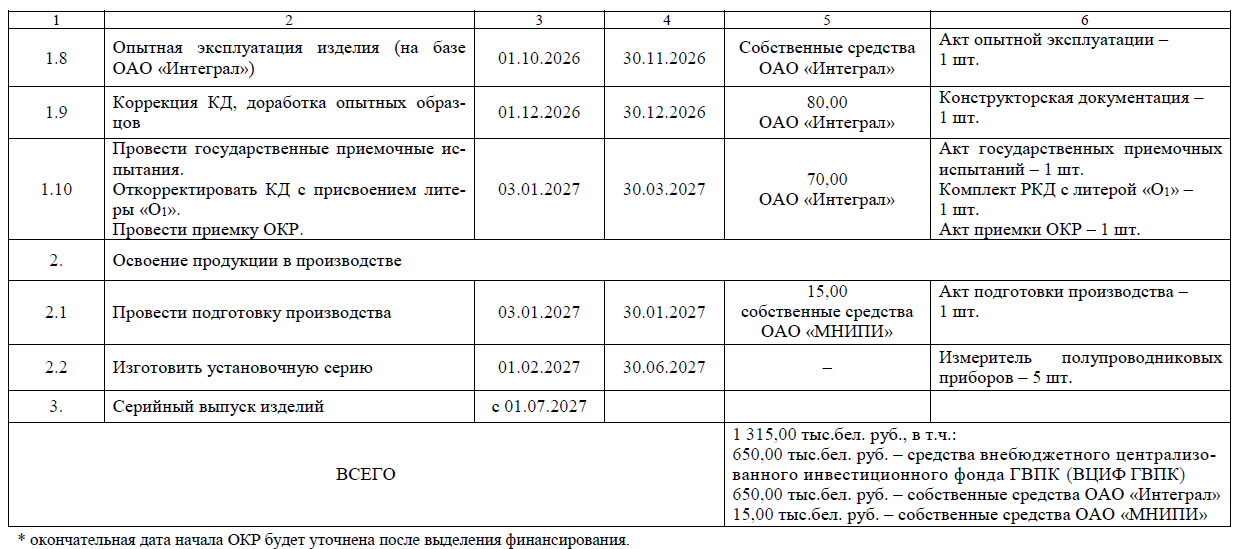
[picture p83: figure]

## Структурные и функциональные схемы

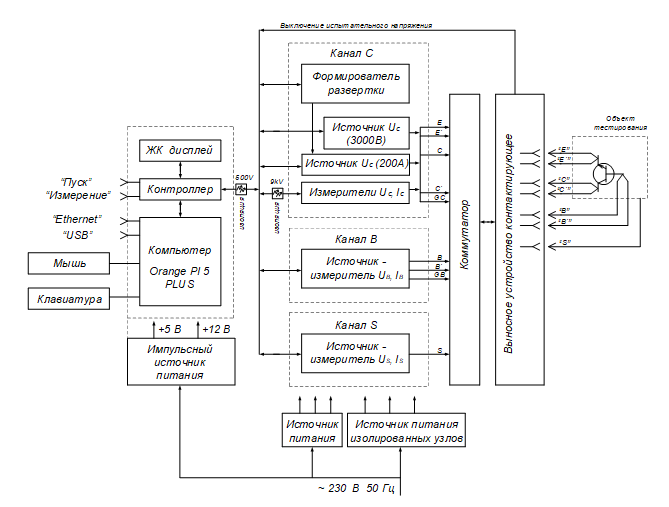
[picture p84: figure]

Структурная схема Анализатора ВАХ

## Структурные и функциональные схемы

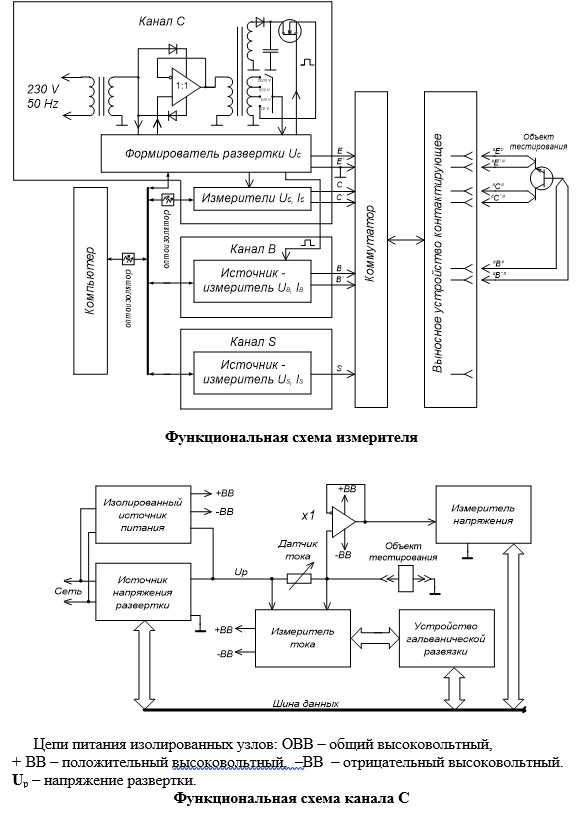
[picture p85: figure]
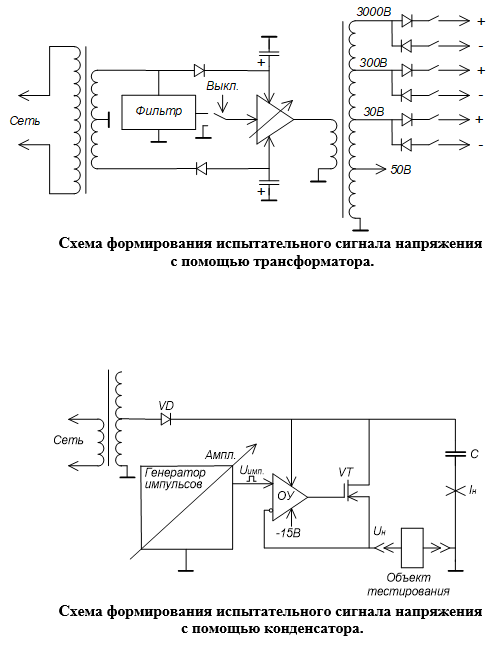
[picture p86: figure]

## Структурные и функциональные схемы


Структурная схема контроллера

## Slide 12

Контроллер предназначен для:
- - установки режимов работы программируемых блоков;
- - задания моментов измерения мгновенных значений испытательных сигналов, сбора результатов измерения, отображения ВАХ;
- - формирования напряжения развертки на основе переменного напряжения сети 50 Гц в режиме «Высокое напряжение»;
- - формирования испытательного сигнала в режиме «Большой ток».

## Slide 13

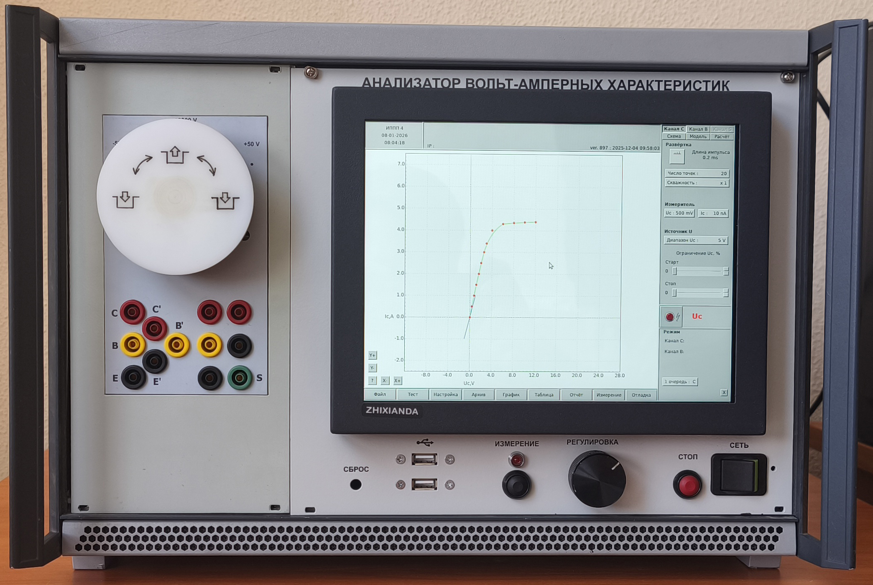
[picture p87: figure]

Внешний вид Анализатора ВАХ

## Slide 14

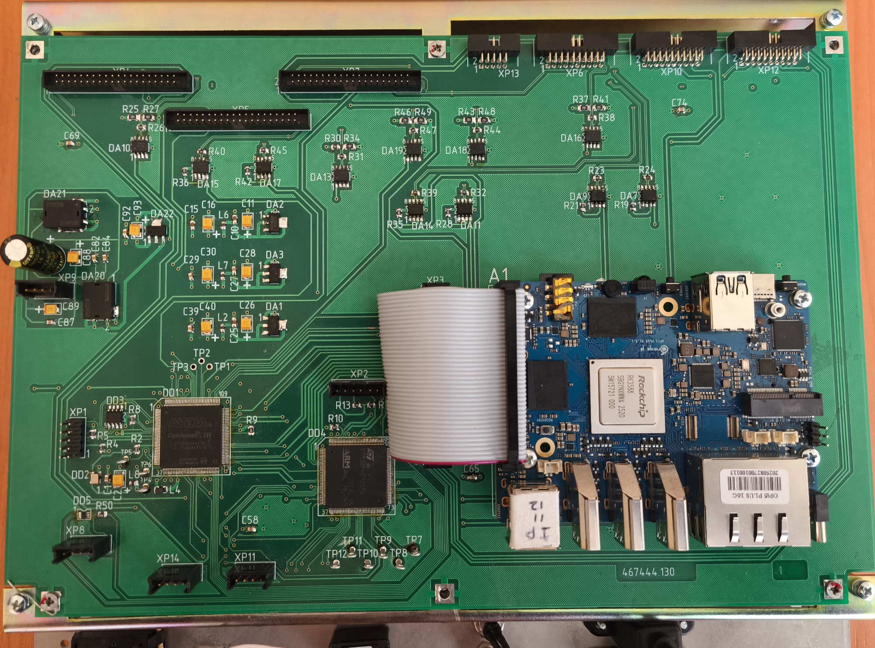
[picture p88: figure]

Контроллер

## Slide 15

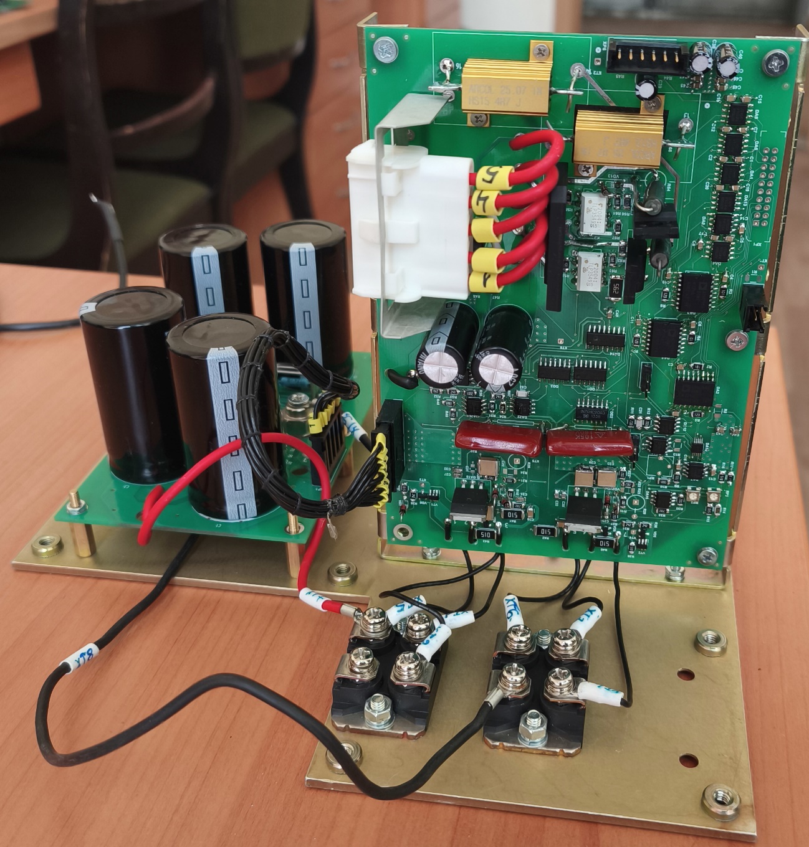
[picture p89: figure]

Источник Uc 50 В (200 А)

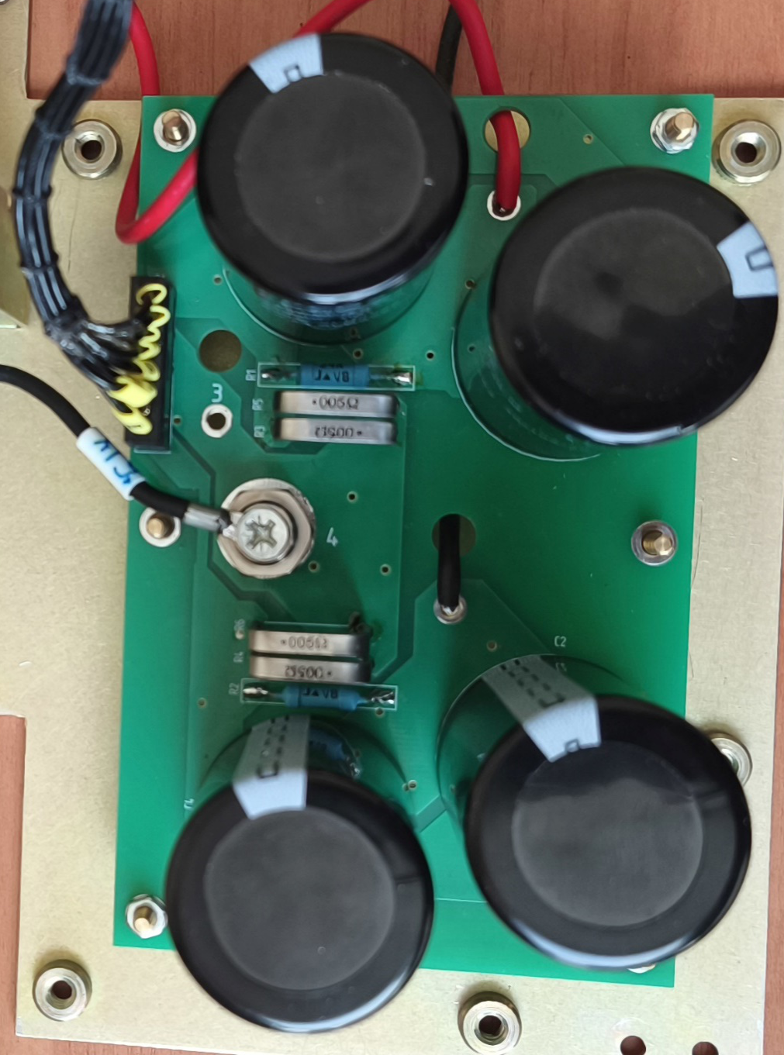
[picture p90: figure]

## Slide 16

Главная панель управления
Выбор специализированных панелей: «Канал С», «Канал В», «Канал S», «Схема», «Модель», «Расчет».
Выбор категории объекта. Выбор режима коммутации.

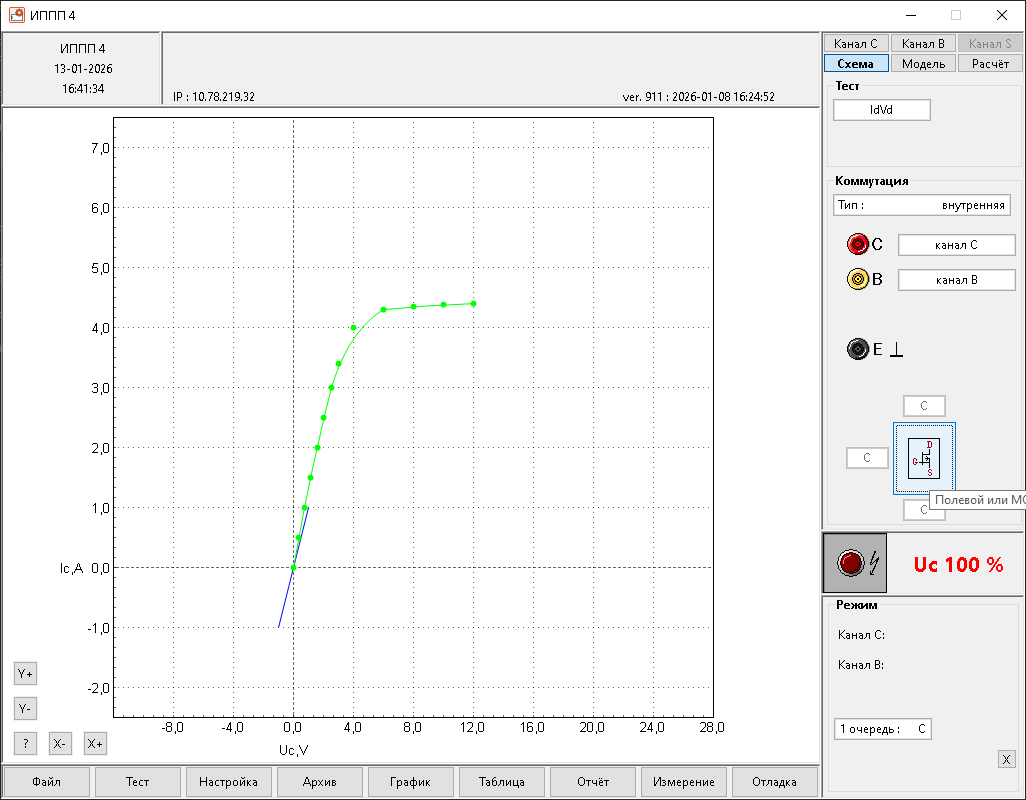
[picture p91: figure]

## Slide 17

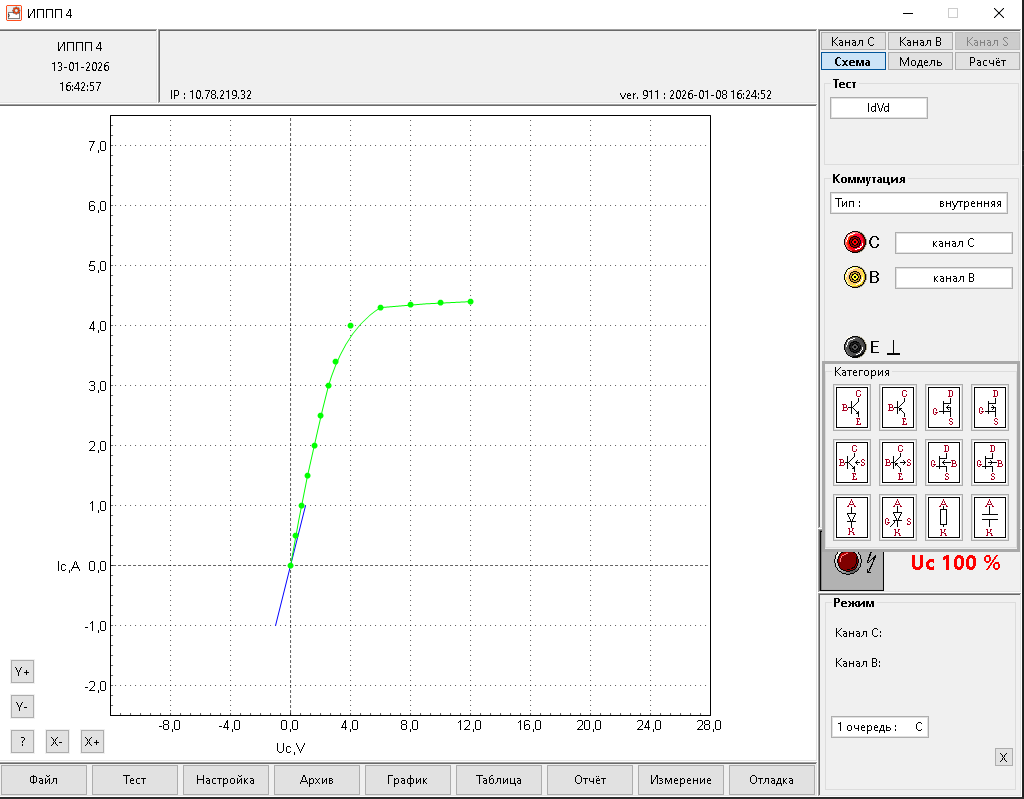
[picture p92: figure]

Панель управления «Схема».
Включен режим выбора категории объекта тестирования.

## Slide 18

Панель управления «Канал С».
Включен режим выбора сигнала развертки.
Установка диапазона источника напряжения Uc и диапазонов измерения тока и напряжения Ic, Uc.

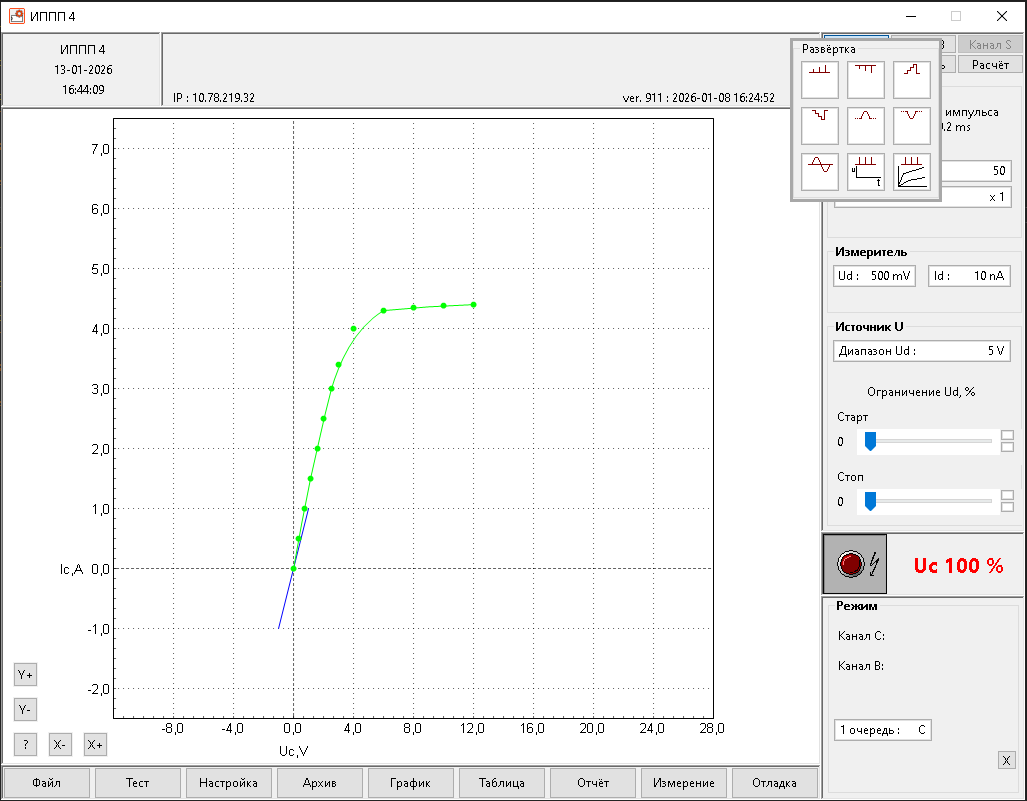
[picture p93: figure]

## Slide 19

Панель управления «Канал В».
Установка: амплитуды ступени, количества ступеней, величины смещения, полярности ступеней и смещения, порога ограничения.
Отображение: вид выходного сигнала (I, U), импульс (да/нет).

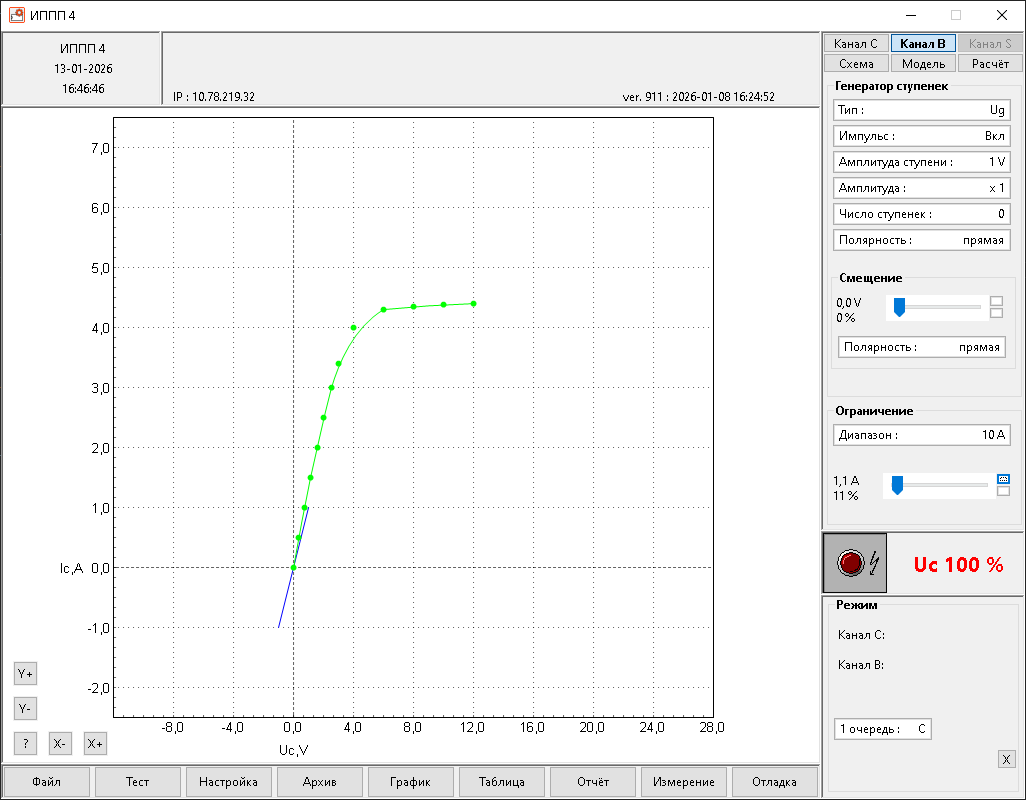
[picture p94: figure]

## Slide 20

Панель управления «Расчет».
Установка наименований осей графика. Указание и расчет искомого параметра.
Установка мин. и макс. значений рукава допусков. Указание 1й очереди.
Отображение таблица результатов (на поле графика).

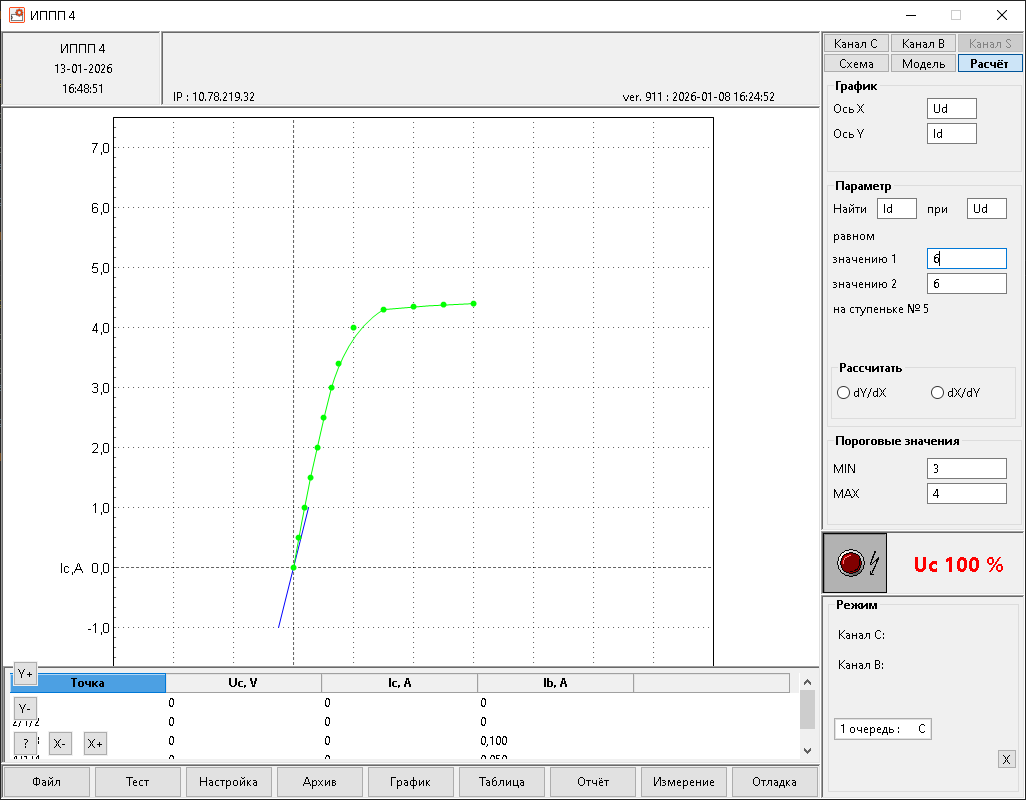
[picture p95: figure]

## Основные работы по ОКР Линия-2 в 2025 году (продолжительность 9 мес.)

1. Разработка структурной схемы и функциональных схем измерительных каналов (В,С)
2. Разработка электрических схем каналов В и С
3. Разработка эскизной КД на макеты узлов (В и С)
4. Разработка укрупненного алгоритма функционирования
измерителя
5. Изготовление и испытание макетов узлов
6. Разработка ПО
7. Разработка КД

## Перечень функциональных блоков:

1. Дисплей УШЯИ.467859.024 (в состав входят контроллер УШЯИ.467444.130, панель УШЯИ.301413.342);
2. Источник напряжения 50 В УШЯИ.411522.032 (в состав входят плата УШЯИ.687253.018, плата УШЯИ.687253.017);
3. Источник-измеритель УШЯИ.411618.029;
4. Блок питания УШЯИ.436224.015 (в состав входят плата УШЯИ.687243.347, плата УШЯИ.687243.348, плата УШЯИ.687243.349);
5. Источник напряжения УШЯИ.411522.034 (в состав входят плата выпрямителя УШЯИ.687233.019, плата защиты УШЯИ.687242.236, плата источника УШЯИ.687245.044);
6. Формирователь развертки УШЯИ.411522.033;
7. Коммутатор УШЯИ.468213.012.

## Основные работы по ОКР Линия-2 в 2026 году

1. Разработка полного комплекта КД на анализатор.
2. Изготовление опытных образцов.
3. Настройка, предварительные испытания, коррекция КД с присвоением литеры «О».
4. Опытная эксплуатация на базе ОАО «Интеграл».

## Проблемные вопросы

1. Короткие сроки выполнения ОКР (в особенности работы 2025 года.)
2. Необходимость решения сложных технических задач: функционирование в широком диапазоне измеряемых токов (10⁻⁹ – 200 А) и напряжений (до 3 кВ), разработка ПО (OC Linux), разработка конструкции прибора, обеспечение ЭМС.
3. Ожидаемые проблемы при изготовлении макетов и опытных образцов: в изделии имеются сложные конструктивные узлы и ЭКБ с высокими параметрами.

## СПАСИБО ЗА ВНИМАНИЕ!
