Sasha7b9Work/LiniaServer/Блок базы - Подложки/1-Разъем контроллера- Базв.docx

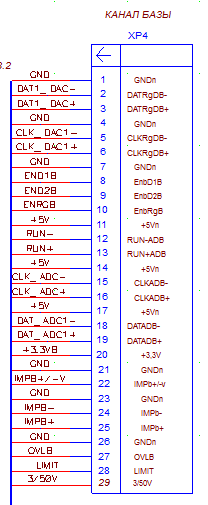
[picture p96: figure]
