Sasha7b9Work/LiniaServer/Блок базы - Подложки/Cигналы РАЗВЕРТКИ .2.docx

СИГНАЛЫ УПРАВЛЕНИЯ РАЗВЕРТКОЙ

| | | | Формирователь развертки | Источник U 50 В | | Канал Базы
Режим работы | | | | сигнал ENS 0,2 – 20 мс | Impc+, Impc- 10-100мкс | EIMP | Impb+, Impb- 10-100мкс | Imp+/-v 0,2 -1 мс
Тип развертки
Режим Высокого напряжения | Диод | Выпрямл. синус | | ENS sin+/- | 0 | 0 | 1 | 1
| | Двуполярная | | ENS AC | 0 | 0 | 1 | 1
| | Постоянное напряжение | | ENS DС+/- | 0 | 0 | 1 | 1
| | Импульсная | | ENS Imp+/- 0,2 -1 мс | 0 | 0 | 1 | 1
| Транзистор | Выпрямл. синус | | ENS sin+/- | 0 | 0 | 1 | 1
| | Постоянное напряжение | | ENS DС+/- | 0 | 0 | 1 | 1
| | Импульсная | | ENS sin+/- | 0 | 0 | 1 | Imp+/-v
Режим Большого Тока | Диод | Импульсный | | 0 | Рис.3 Impc+, Impc- | EIMP Рис. 3 | 1 | 1
| Транзистор | | | 0 | рис.4 Impc+, Impc- ─ по 10мс | EIMP рис.4 | Impb+, Impb- | 1

См. стр.2 (на обороте)

Рисунок 3. Диаграммы сигналов IMPc +/- (10мкс ÷ 100мкс) и EIMP (20мс) при тестировании ДИОДА с помощью импульсной развертки в режиме «Большой ток».

Рисунок 4. Диаграммы сигналов IMPc +/- (10мс), IMPB+/- и EIMP (20мс) при тестировании ТРАНЗИСТОРА с помощью импульсной развертки в режиме «Большой ток».
