Sasha7b9Work/LiniaServer/Измеритель тока/РегистрИзм._т. 200А Линия-2_2й в. — копия.docx

Диапазоны измерителя тока (ПРОЕКТ)

| | Предел | Диапа-зон | № | Коэф-т отклонения | Ку | Q2:Q0 | № п | Q5:Q3 | Дискрет
_ручное включение | имп. ≤ 2 мс | 200 А 0,0065 Ом 0,0033 Ом + 0,0033 Ом | 400 А | 1а | 40 А/дел. | :2 | 101 | | хххх | ххххххх
| | | 200 А | 1 | 20 А/дел. | *1 | | | 001 | 9,4·10 ⁻³
| | | 100 А | 2 | 10 А/дел. | *2 | | | 010 | 4,7·10 ⁻ ³
| | | 50 А | 3 | 5 А/дел. | *4 | | | 011 | 2,35·10 ⁻ ³
| | | 20 А | 4 | 2 А/дел. | *10 | | | 101 | 0,94·10 ⁻ ³
| | | 10 А | 5 | 1 А/дел. | *20 | | | 110 | 0,47·10 ⁻ ³
| | | 5 А | 7 | 0,5 А/дел. | *40
| | 5 А (до 10 А) 0,26 Ом 0,01 Ом+0,15 Ом | 10 А | 8а | 1 А/дел. | :2 | 100 | | хххх | ххххххх
| | | 5 А | 8 | 0,5 А/дел. | *1 | | | 011 | 0,235·10 ⁻ ³
рограммное включение | имп. ≤ 5 мс | | 2 А | 9 | 0,2 А/дел. | *2 | | | 101 | 94·10 ⁻ ⁶
| | | 1 А | 10 | 0,1 А/дел. | *4 | | | 110 | 47·10 ⁻ ⁶
| | | 0,5 А | 11 | 50 мА/дел. | *10 | | | 111 | 23,5·10 ⁻ ⁶
| | 200 мА (6,49 Ом) | 0,2 А | 12 | 20 мА/дел. | *1 | 011 | | 000 | 9,4·10 ⁻ ⁶
| | | 0,1 А | 13 | 10 мА/дел. | *2 | | | 001 | 4,7·10 ⁻ ⁶
| | | 50 мА | 14 | 5 мА/дел. | *4 | | | 010 | 2,35·10 ⁻ ⁶
| | | 20 мА | 15 | 2 мА/дел. | *10 | | | 100 | 0,94·10 ⁻ ⁶
| | | 10 мА | 16 | 1 мА/дел. | *20 | | | 101 | 0,47·10 ⁻ ⁶
| | | 5 мА | 17 | 0,5 мА/дел. | *40 | | | 110 | 0,235·10 ⁻ ⁶
| DC, имп. ≤ 5 мс | 2 мА (649 Ом) | 2 мА | 18 | 0,2 мА/дел. | *1 | 010 | | 000 | 94·10 ⁻ ⁹
| | | 1 мА | 19 | 0,1 мА/дел. | *2 | | | 001 | 47·10 ⁻ ⁹
| | | 0,5 мА | 20 | 50 мкА/дел. | *4 | | | 010 | 23,5·10 ⁻ ⁹
| | | 0,2 мА | 21 | 20 мкА/дел. | *10 | | | 100 | 9,4·10 ⁻ ⁹
| | | 0,1 мА | 22 | 10 мкА/дел. | *20 | | | 101 | 4,7·10 ⁻ ⁹
| | | 50 мкА | 23 | 5 мкА/дел. | *40 | | | 110 | 2,35·10 ⁻ ⁹
| DC, имп. = 5 мс | 20 мкА (64,9 кОм) | 20 мкА | 24 | 2 мкА/дел. | *1 | 001 | | 000 | 0,94·10 ⁻ ⁹
| | | 10 мкА | 25 | 1 мкА/дел. | *2 | | | 001 | 0,47·10 ⁻ ⁹
| | | 5 мкА | 26 | 0,5 мкА/дел. | *4 | | | 010 | 0,235·10 ⁻ ⁹
| | | 2 мкА | 27 | 0,2 мкА/дел. | *10 | | | 100 | 94·10 ⁻ ¹²
| | | 1 мкА | 28 | 0,1 мкА/дел. | *20 | | | 101 | 47·10 ⁻ ¹²
| | | 0,5 мкА | 29 | 50 нА/дел. | *40 | | | 110 | 23,5·10 ⁻ ¹²
| DC | 200 нА (6,49 МОм) | 0,2 мкА | 30 | 20 нА/дел. | *1 | 000 | | 000 | 9,4·10 ⁻ ¹²
| | | 0,1 мкА | 31 | 10 нА/дел. | *2 | | | 001 | 4,7·10 ⁻¹²
| | | 50 нА | 32 | 5 нА/дел. | *4 | | | 010 | 2,35·10 ⁻¹²
| | | 20 нА | 33 | 2 нА/дел. | *10 | | | 100 | 0,94·10 ⁻ ¹²
| | | 10 нА | 34 | 1 нА/дел. | *20
| | | 5 нА | 35 | 0,5 нА/дел. | *40
| | 2 нА (64,9 МОм) | 2 нА | 36 | 0,2 нА/дел. | *1 | ????
| | | 1 нА | 37 | 0,1 нА/дел. | *2
| | | 0,5 нА | 38 | 50 пА/дел. | *4

В диапазоне 3 кВ максимальный диапазон тока – 20 мА

В диапазоне 300 В максимальный диапазон тока – 200 мА

В диапазоне 30 В максимальный диапазон тока – 2 А
