Sasha7b9Work/LiniaServer/Измеритель тока/Табл ИзмТ Линия2.docx

Диапазоны измерителя тока (ПРОЕКТ)

| | Предел | Диапа-зон | № | Коэф-т отклонения | Ку | Q2:Q0 | № п | Q5:Q3 | Дискрет
Ручное включение | имп. ≤ 2 мс | 400 A 2.5 мОм | 400 А | 1 | 40 А/дел. | 1 | 101
| | | 200 А | 2 | 20 А/дел. | 2
| | | 100 А | 3 | 10 А/дел. | 4
| | | 50 А | 4 | 5 А/дел. | 8
| | | 20 А | 5 | 2 А/дел. | 20
| | | 10 А | 6 | 1 А/дел. | 40
| | 10 А (20 А) 50 мОм | 20 А | х | 2 А/дел. | 1 | 100 | | ххх
| | | 10 А | 7 | 1 А/дел. | 2
Программное включение | имп. ≤ 5 мс | | 5 А | 8 | 0,5 А/дел. | 4
| | | 2 А | 9 | 0,2 А/дел. | 10
| | | 1 А | 10 | 0,1 А/дел. | 20
| | | 0,5 А | 11 | 50 мА/дел. | 40
| | 200мА 5 Ом | 0,2 А | 12 | 20 мА/дел. | 1 | 011
| | | 0,1 А | 13 | 10 мА/дел. | 2
| | | 50 мА | 14 | 5 мА/дел. | 4
| | | 20 мА | 15 | 2 мА/дел. | 10
| | | 10 мА | 16 | 1 мА/дел. | 20
| | | 5 мА | 17 | 0,5 мА/дел. | 40
| DC, имп. ≤ 5 мс | 2мА 500 Ом | 2 мА | 18 | 0,2 мА/дел. | 1 | 010
| | | 1 мА | 19 | 0,1 мА/дел. | 2
| | | 0,5 мА | 20 | 50 мкА/дел. | 4
| | | 0,2 мА | 21 | 20 мкА/дел. | 10
| | | 0,1 мА | 22 | 10 мкА/дел. | 20
| | | 50 мкА | 23 | 5 мкА/дел. | 40
| DC, имп. = 5 мс | 200мкА 50 кОм | 20 мкА | 24 | 2 мкА/дел. | 1 | 001
| | | 10 мкА | 25 | 1 мкА/дел. | 2
| | | 5 мкА | 26 | 0,5 мкА/дел. | 4
| | | 2 мкА | 27 | 0,2 мкА/дел. | 10
| | | 1 мкА | 28 | 0,1 мкА/дел. | 20
| | | 0,5 мкА | 29 | 50 нА/дел. | 40
| DC | 200нА 5 МОм | 0,2 мкА | 30 | 20 нА/дел. | 1 | 000
| | | 0,1 мкА | 31 | 10 нА/дел. | 2
| | | 50 нА | 32 | 5 нА/дел. | 4
| | | 20 нА | 33 | 2 нА/дел. | 10
| | | 10 нА | 34 | 1 нА/дел. | 20
| | | 5 нА | 35 | 0,5 нА/дел. | 40

В диапазоне 10 А поддиапазон 20 А запрещен.

В диапазоне 3 кВ максимальный диапазон тока – 50 мА (20 мА)

В диапазоне 300 В максимальный диапазон тока – 0,5 А (200 мА)

В диапазоне 30 В максимальный диапазон тока – 10 А (2 А)

Напряжение на Rш = 1В

Порог OVLI,1 = 3В

Стабилизаторы +8В и -8В
