Sasha7b9Work/LiniaServer/Источник напряжения (3000В)/_Концепция защиты от перегрузки.docx

Защита анализатора от перегрузки по выходному току, например при пробое объекта тестирования.

Основная защита анализатора осуществляется путем автоматического электронного выключения источника напряжения (3 кВ) при превышении выходным током установленного диапазона измерения приблизительно в 2 раза (2 экрана по вертикали).

Интервал времени между переходом тока через пороговый уровень и электронным выключением источника испытательного сигнала составляет несколько микросекунд.

Однако, при пробое объекта тестирования, реакция анализатора должна быть практически мгновенной. Этого можно достичь с помощью резистора в выходной цепи канала С, который ограничит выходной ток по величине на время необходимое для автоматического выключения источника.

Благодаря электронному выключению источника испытательного сигнала при превышении выходным током допустимого уровня, броски тока сверх этого уровня получаются короткими. Это позволяет: исключить защиту обмоток трансформатора, уменьшить мощность резисторов защиты и допустить превышение пикового тока через элементы силовой цепи сверх допустимого для них постоянного тока в несколько раз.

Наиболее чувствительным (уязвимым) элементом к броскам тока в данном случае являются контакты реле (герконы), которые подключают токоизмерительные резисторы в измерителе тока, и выпрямительные диоды в источнике напряжения.

Количество и номиналы резисторов защиты, предназначенных для ограничения бросков тока через реле (герконы) на время необходимое для автоматического выключения источника сигнала, нужно определить исходя из того, что канал С обеспечивает переключение 6-ти основных диапазонов по току для нескольких диапазонов напряжения (50 В,б30 В, 300 В, 3000 В).

Следует учесть, что в выходной цепи канала С уже имеются резисторы для преобразования выходного тока в напряжение, которые вносят свой вклад в защиту анализатора. Применение дополнительных резисторов защиты диктуется необходимостью ограничения тока протекающего через герконы при коротком замыкании выходной цепи (пробое объекта тестирования). При этом максимально возможный ток через геркон определяется максимальным значением напряжения источника, и суммарным сопротивлением подключенных резисторов.

Данные для расчетов.

Максимальный ПОСТОЯННЫЙ ток протекающий через контакты:

- для реле DIP 05147213L [геркон РЗМКТ 14103] (250V) составляет 1 А,

- для 2-х герконов DRA283 (250V) включенных параллельно - 10 А,

- для 2-х реле DAR71210 (10кВ) включенных параллельно - 8 А.

Учитывая кратковременность паразитных бросков тока, можно допустить 2х÷3х кратное превышение их амплитуды сверх пределов для постоянного тока,

то есть 2 А÷20 А, соответственно.

Это УСЛОВИЕ расчета резисторов защиты. (1)

В таблице 1 приведены максимальные значения тока в диапазонах напряжения источника напряжения 3 кВ (исходя из возможностей трансформатора).

Табл.1 Максимальный ток в диапазонах источника напряжения 3 кВ

Диапазон напряжения | Максимальный ток | Мощность трансформатора
30 В | 5 А | 150 Вт
300 В | 0,5 А | 150 Вт
3000 В | 0,05 А | 150 Вт

В таблице 2 приведены диапазоны тока измерителя тока.

Пределы измерения (200 А, 5 А, 200 мА, 2 мА, 20 мкА, 200 нА) задают величиной токоизмерительного резистора. В таблице 2 они выделены сплошными линиями.

Поддиапазоны (5 А, 2 А, 1 А, 0,5 А, 0,2 А и т.д.) задают с помощью коэффициента усиления сигнала на входе АЦП.

Табл.2 Диапазоны измерителя тока

| | Предел | Диапа-зон | № | Коэф-т отклонения | Коэф-т усиления | Q2:Q0 | № п | Q5:Q3 | Дискрет
_ручное включение | имп. ≤ 2 мс | 200 А 0,0 1|| 0,01|| 0,01 0,0033 Ом. | | | | | 101
| | | 200 А | 1 | 20 А/дел. | *2 | | | 001 | 9,4·10 ⁻³
| | | 100 А | 2 | 10 А/дел. | *4 | | | 010 | 4,7·10 ⁻ ³
| | | 50 А | 3 | 5 А/дел. | *8 | | | 011 | 2,35·10 ⁻ ³
| | | 20 А | 4 | 2 А/дел. | *20 | | | 101 | 0,94·10 ⁻ ³
| | | 10 А | 5 | 1 А/дел. | *40 | | | 110 | 0,47·10 ⁻ ³
| | 5 А (до 10 А) (0,033 Ом) | 5 А | 7 | 0,5 А/дел. | *8 | 100 | 2 | 011 | 0,235·10 ⁻ ³
рограммное включение | имп. ≤ 5 мс | | 2 А | 8 | 0,2 А/дел. | *20 | | | 101 | 94·10 ⁻ ⁶
| | | 1 А | 9 | 0,1 А/дел. | *40 | | | 110 | 47·10 ⁻ ⁶
| | | 0,5 А | 10 | 50 мА/дел. | *80 | | 3 | 111 | 23,5·10 ⁻ ⁶
| | 200 мА (6,49 Ом) | 0,2 А | 11 | 20 мА/дел. | *1 | 011 | 4, 5 | 000 | 9,4·10 ⁻ ⁶
| | | 0,1 А | 12 | 10 мА/дел. | *2 | | | 001 | 4,7·10 ⁻ ⁶
| | | 50 мА | 13 | 5 мА/дел. | *4 | | | 010 | 2,35·10 ⁻ ⁶
| | | 20 мА | 14 | 2 мА/дел. | *10 | | | 100 | 0,94·10 ⁻ ⁶
| | | 10 мА | 15 | 1 мА/дел. | *20 | | | 101 | 0,47·10 ⁻ ⁶
| | | 5 мА | 16 | 0,5 мА/дел. | *40 | | | 110 | 0,235·10 ⁻ ⁶
| DC, имп. ≤ 5 мс | 2 мА (649 Ом) | 2 мА | 17 | 0,2 мА/дел. | *1 | 010 | | 000 | 94·10 ⁻ ⁹
| | | 1 мА | 18 | 0,1 мА/дел. | *2 | | | 001 | 47·10 ⁻ ⁹
| | | 0,5 мА | 19 | 50 мкА/дел. | *4 | | | 010 | 23,5·10 ⁻ ⁹
| | | 0,2 мА | 20 | 20 мкА/дел. | *10 | | | 100 | 9,4·10 ⁻ ⁹
| | | 0,1 мА | 21 | 10 мкА/дел. | *20 | | | 101 | 4,7·10 ⁻ ⁹
| | | 50 мкА | 22 | 5 мкА/дел. | *40 | | | 110 | 2,35·10 ⁻ ⁹
| DC, имп. = 5 мс | 20 мкА (64,9 кОм) | 20 мкА | 23 | 2 мкА/дел. | *1 | 001 | | 000 | 0,94·10 ⁻ ⁹
| | | 10 мкА | 23 | 1 мкА/дел. | *2 | | | 001 | 0,47·10 ⁻ ⁹
| | | 5 мкА | 25 | 0,5 мкА/дел. | *4 | | | 010 | 0,235·10 ⁻ ⁹
| | | 2 мкА | 26 | 0,2 мкА/дел. | *10 | | | 100 | 94·10 ⁻ ¹²
| | | 1 мкА | 27 | 0,1 мкА/дел. | *20 | | | 101 | 47·10 ⁻ ¹²
| | | 0,5 мкА | 28 | 50 нА/дел. | *40 | | | 110 | 23,5·10 ⁻ ¹²
| DC | 200 нА (6,49 МОм) | 0,2 мкА | 29 | 20 нА/дел. | *1 | 000 | | 000 | 9,4·10 ⁻ ¹²
| | | 0,1 мкА | 30 | 10 нА/дел. | *2 | | | 001 | 4,7·10 ⁻¹²
| | | 50 нА | 31 | 5 нА/дел. | *4 | | | 010 | 2,35·10 ⁻¹²
| | | 20 нА | 32 | 2 нА/дел. | *10 | | | 100 | 0,94·10 ⁻ ¹²
| | | 10 нА | 33 | 1 нА/дел. | *20 | | | 101 | 0,47·10 ⁻ ¹²
| | | 5 нА | 34 | 0,5 нА/дел. | *40 | | | 110 | 0,23·10 ⁻ ¹²
| АЦП | | 2 нА | 35 | 0,2 нА/дел. | *80 | | | | 0,94·10 ⁻ ¹³
| | | 1 нА | 36 | 0,1 нА/дел. | | Ккалибр=2

Таблица 2 приведена лишь в качестве примера последовательности и значений диапазонов. Указанные в таблице номиналы токоизмерительных резисторов будут существенно изменены при разработке измерителя тока.

На основании таблиц 1 и 2 составлена таблица 3 «Допустимые сочетания диапазонов источника напряжения и измерителя тока».

Табл.3 Допустимые сочетания диапазонов источника напряжения и измерителя тока

Диапазон напряжения | Допустимые диапазоны измерителя тока
50 В | 5-ть диапазонов тока (от 200 А до 10 А)
30 В | 30-ть диапазонов тока (от 5 А до 1 нА)
300 В | 27-мь диапазонов тока (от 0,5 А до 1 нА)
3000 В | 24-ре диапазона тока (от 0,05 А до 1 нА)

Основываясь на данных, приведенных в таблицах 2 и 3 и перечисленных выше функциональных особенностях анализатора, определим минимальное количество резисторов защиты и рассчитаем их сопротивления.

1 В диапазоне измерителя тока 200 А резистор защиты не нужен т.к. нет реле.

Ток ограничивают в модуле «Источник напряжения 50 В» на уровне ≈250 А.

2 При совместном включении диапазона источника 30 В и диапазона измерителя 5 А (табл.2,3) максимальный ток канала С ограничен мощностью трансформатора ≈150÷200 Вт и сопротивлением обмотки. Целесообразно установить последовательно с обмоткой неотключаемый резистор защиты 1,5 Ом. В этом случае:

- при выходном токе 5 А выходное напряжение снизится до ≈22,5 В (т.е. на ≈24%),

- а короткий бросок тока короткого замыкания будет менее 20 А,

что вполне допустимо согласно условию (1).

Если это будет 4 резистора (3 Ом), то достаточно 3 Ом-0,25 Вт.

3 При совместном включении диапазона источника 300 В и диапазона измерителя 0,5 А (табл.2,3) ток короткого замыкания ограничен мощностью трансформатора и сопротивлением обмотки. Целесообразно установить последовательно с обмоткой неотключаемый резистор защиты 15 Ом. В этом случае:

- при вых. токе 0,5 А выходное напряжение снизится до 292,5 В (т.е. на ≈2,4%),

- бросок тока при к. з. через контакты реле будет < 20 А, что допустимо согласно (1).

4 При совместном включении диапазона источника 30 В и диапазона измерителя 200мА (табл.2) допустимая амплитуда броска тока через геркон составляет 2 А, согласно условию (1).

При наличии постоянного резистора защиты 1,5 Ом ток короткого замыкания на несколько микросекунд может возрасти до 15 А, т.е. в 15 раз больше допустимого постоянного тока, следовательно при сочетании диапазонов 30 В и 200 мА необходимо подключать доп. резистор защиты как минимум 15 Ом, при этом амплитуда броска тока будет ограничена по уровню 30 В/16,5 Ом=1,8 А. Максимальное падение напряжения на этом резисторе составит 0,2 А×15 Ом=3 В (10%). Выключать (закорачивать) этот резистор можно двумя герконами DRA283 (ток 10 А) если резистор будет установлен между обмоткой 30 В и высоковольтными реле DAR71210.

5 При совместном включении диапазона источника 300 В и диапазона измерителя 200 мА допустимая ампл. броска тока через геркон 2 А и необходимо подключать доп. резистор защиты 150 Ом (300 В/165 Ом=1,8 А) .

6 При совместном включении диапазонов 30 В и 20 мА допустимая ампл. броска тока через геркон 2 А (1), а величина токоизмерительного резистора 649 Ом, поэтому доп. резистор не нужен.

7 В диапазонах 20мкА, 200нА допустимая ампл. броска тока через геркон 2 А (1), а величина шунта 64,9 кОм (6,49 МОм), поэтому при подключении источников 30В, 300В, 3000В доп. резистор не нужен.

8 При совместном включении диапазона источника 3000 В и диапазонов измерителя 200 мА (поддиапазоны 50мА, 20мА, 10мА, 5мА), 2 мА пиковое значение броска тока <2 А (1) и требуется резистор защиты величиной 3000В/2А= =(1500Ом-2000Ом).

В цепи источника 3000 В д.б. установлен постоянный резистор 1,2к∙5=6 кОм.

Таким образом, можно ограничиться 2-мя резисторами защиты: 15 Ом и 150 Ом, которые должны подключаться автоматически (по заданному алгоритму) при выборе определенного сочетания диапазонов источника напряжения и измерителя тока.

РЕЗЮМЕ

1 Последоват. с обмот. 30 В и 300 В установить резисторы 1,5 Ом и 15 Ом, соответств.

2 Последовательно с обмоткой 30 В установить сразу после обмотки, закорачиваемый с помощью двух герконов DRA283 (в одной катушке), резистор 15 Ом.

3 Последовательно с обмоткой 300 В установить сразу после обмотки, закорачиваемый с помощью реле DAR71210 (4 А), резистор 150 Ом.

4 Разработать ТЗ на алгоритм включения резисторов защиты.

5 Волевым решением выбрать диапазоны тока, в которых возможен режим DC, например, начиная с 2 мА (649 Ом) для диапазона 300 В (330 мкФ) и диапазона 3 кВ (0,01 мкФ).

6 Определить номинал и установить резистор защиты последовательно с каждым конденсатором С2, С3, (3 кВ/2 А=1500 Ом) и С4, С5 (300 В/2 А=150 Ом). Поскольку, начиная с диапазона 2 мА уже имеется резистор ≥649 Ом, резисторы по 150 Ом возможно излишни.
