Sasha7b9Work/LiniaServer/Источник напряжения (3000В)/Доработка схемы .029.docx

Источник напряжения 3кВ

1 Все высоковольтные реле д.б. DAR7 12 10 (контакты R=Rhodium, 4А)
2 Реле К3 и К6 д.б. сдвоенными (два DAR7 12 10 параллельно). При этом допустимый протекающий ток через герконы возрастает до 8А.

Реализация: один резистор 1,5 Ом последовательно с обмоткой тр-ра или 4 резистора по 3 Ом последовательно с каждым герконом, что предпочтительнее.

3 Электролиты использовать в диапазонах 30 В и 300 В, поэтому заменить 1000 мкФ×160 В на 330 мкФ×400 В (например типа В43640, размером 30×30 или 25×40).
4 Исключать разрядные реле К7, К8 и К9, К10 крайне нежелательно!!!

Возможные последствия:

~~(~~~~Исключить р~~~~еле К7, К8 (разряд~~ ~~С~~ ~~0,1 мкФ), при этом увеличить разрядные резисторы~~ ~~R~~~~11,~~ ~~R~~~~12 с с 1 Мом до 10 Мом. Разряд будет постоянным и постоянная времени разряда (С~~~~9~~~~,С10-0,1 мкФ) увеличится до ≈1 сек, а максимальный разрядный ток уменьшится до ≈0,3 мА.~~

~~Чтобы исключить возможность разряда конденсатора +3~~ ~~кВ~~ ~~на конденсатор -3~~ ~~кВ~~ ~~(или +300~~ ~~В~~ ~~на конденсатор -300 В) в течение постоянной времени 10 сек, что может произойти при выполнении цепочки тестов или «быстрой» работе оператора, нужно:~~

~~- установить последовательно с каждым из конденсаторов защитный резистор~~ ~~(для электролитов по 330 Ом,~~ ~~для~~ ~~пленочных по 3,3 кОм~~~~)~~~~,~~

~~-~~ ~~предусмотреть в алгоритме работы анализатора обязательную задержку на ≥10 сек при переходе от выполнения теста (в том числе измерений в ручном режиме) при одной полярности выходного напряжения канала~~ ~~С~~ ~~– к~~ ~~противоположной,~~

~~- пересчитать резисторы~~ ~~R~~~~11,~~ ~~R~~~~12 и~~ ~~R~~~~13,~~ ~~R~~~~14 в сторону уменьшения для снижения~~ ~~постоянной~~ ~~времени.~~~~)~~

5 Реле К9, К10 (разряд С 330 мкФ×400 В ) д.б. ~~SIL~~~~05-1~~~~A~~~~76-71~~~~L~~ ~~на 500~~ ~~В. (Проверить~~ ~~наличие на рынке~~~~?).~~
6 Последовательно с обмотками 30 В и 300 В установить резисторы 1,5 Ом и 15 Ом, соответственно.

Резисторы 1,5 Ом желательно выполнить из 4-х резисторов 3 Ом, каждый из которых включен последовательно с реле DAR7 12 10 - 4шт (высоковольтное). (К3 и К6).

7 Резистор 15 Ом установить последовательно с обмоткой 30 В сразу после обмотки, чтобы закорачивать его с помощью двух герконов DRA283 (250V) в одной катушке.
8 Последовательно с обмоткой 300 В установить сразу после обмотки, закорачиваемый с помощью реле DAR71210 (4 А), резистор 150 Ом.

Если этот резистор устанавливать по выходу источника, то понадобится 2 реле DAR71210 (10 кВ, 4 А) чтобы его закорачивать.

9 Разработать требования к алгоритму управления реле в схеме источника 3 кВ.
10 Определить номинал и установить резистор защиты последовательно с каждым из конденсаторов С2, С3, (3 кВ/2 А=1500 Ом) и С4, С5 (300 В/2 А=150 Ом). Поскольку, начиная с диапазона 2 мА, уже имеется резистор ≥649 Ом, резисторы по 150 Ом возможно излишни.???
11 Режим DC. Конденсаторы 0,1 мкФ к объекту через 3,3 к-2 Вт (пик.разряд-3 кВт), конденсаторы 330 мкФ к объекту через 1 к-1 Вт (пик.разряд-90 Вт). Разряд конденсаторов 0,1 мкФ через 1 МОм-1 Вт (пик.разряд-9 Вт), ─ 330 мкФ через 1 кОм-1 Вт (пик.разряд-90 Вт).
