Sasha7b9Work/LiniaServer/_Лисенков/Приборостроение MikroVisio/альбом .docx

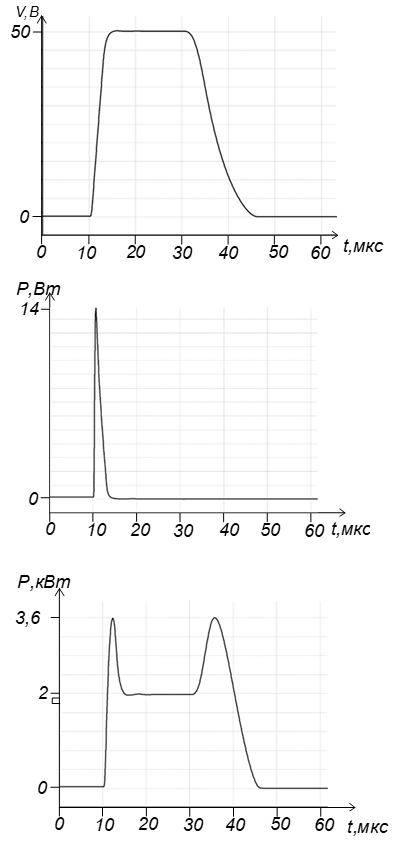
[picture p105: figure]
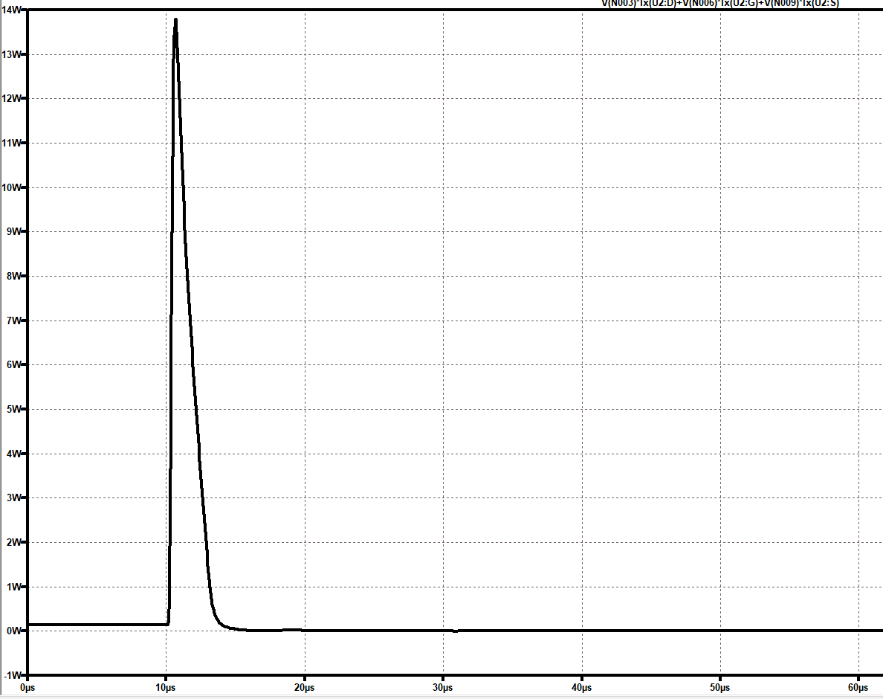
[picture p106: figure]

Мощность транзистор VT1 50В

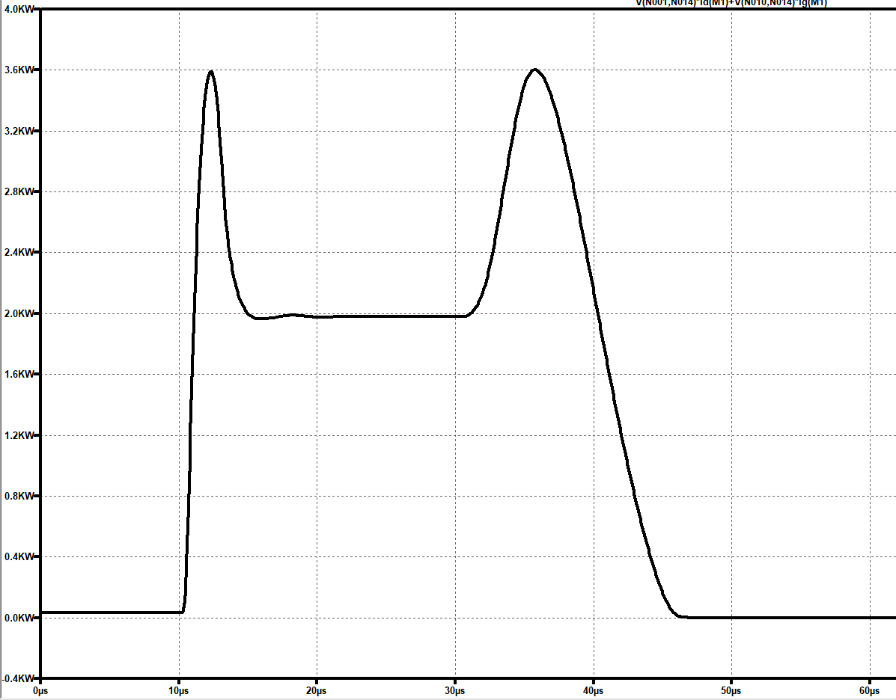
[picture p107: figure]

Мощность транзистор VT2 50В

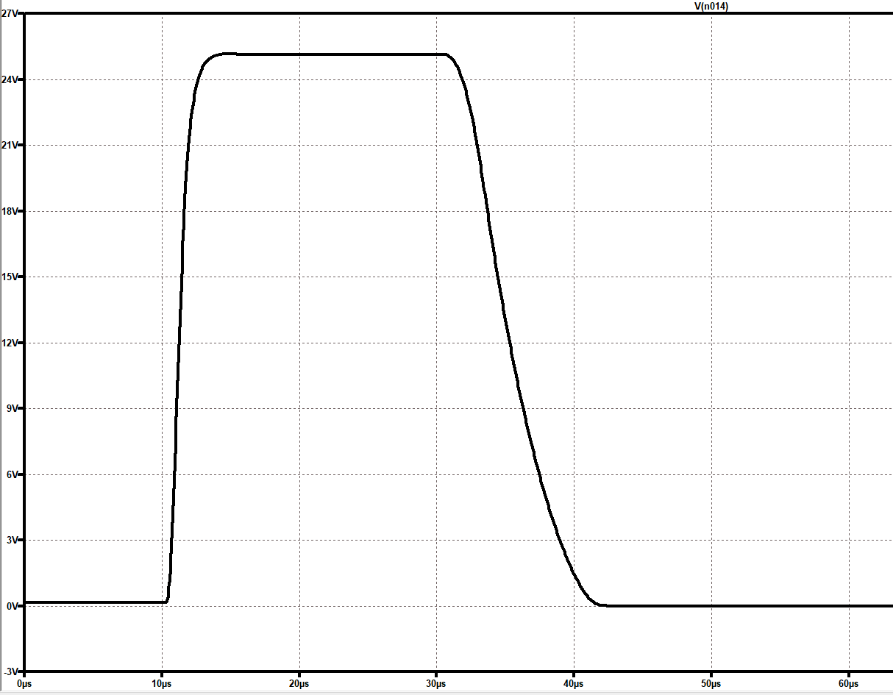
[picture p108: figure]

Напряжение на нагрузке 25В

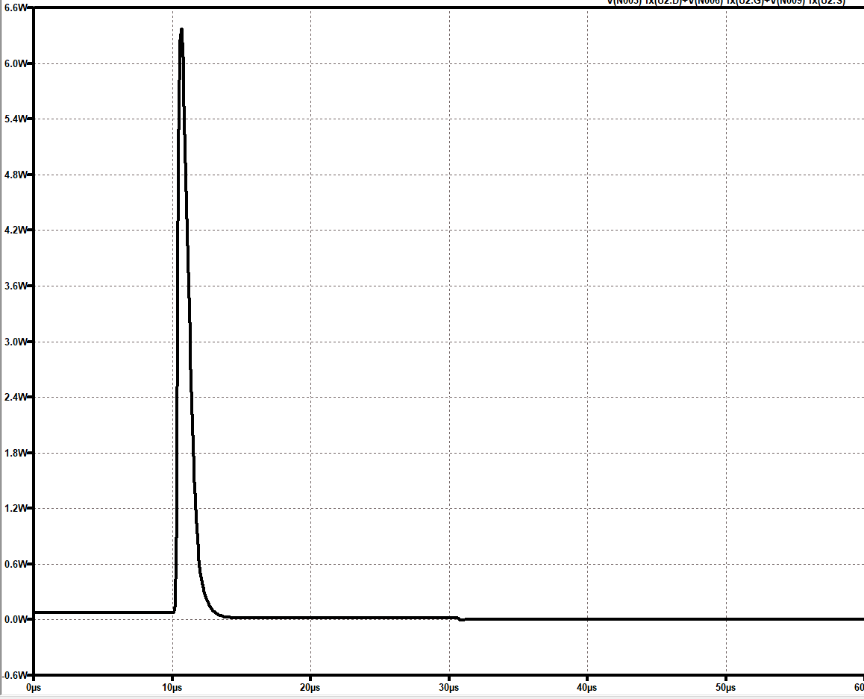
[picture p109: figure]

Мощность на транзисторе VT1 25В

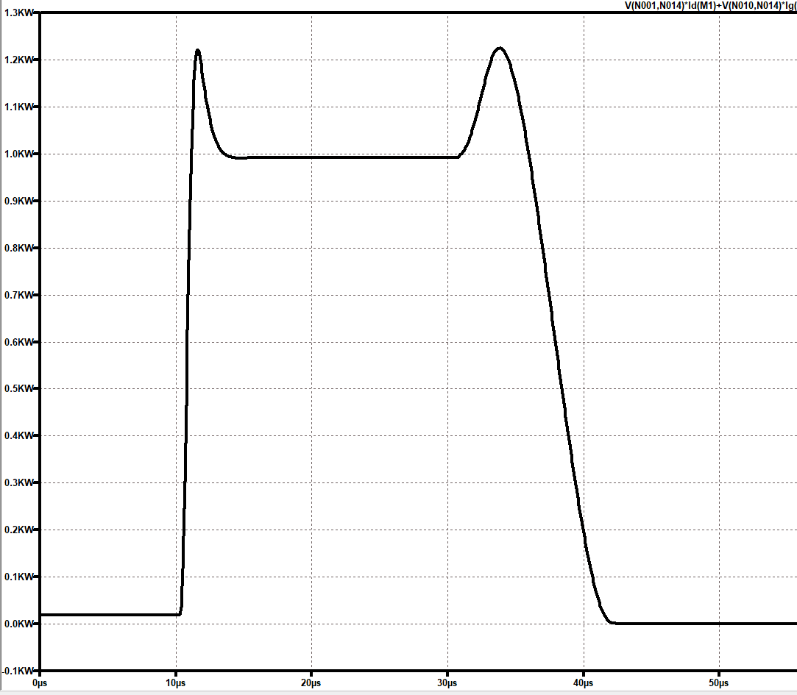
[picture p110: figure]

Мощность на транзисторе VT2 25В
