Sasha7b9Work/LiniaServer/_Лисенков/Измеритель тока/Трансимпед.2х-каскад. усилитель.docx

https://tools.analog.com/en/photodiode/

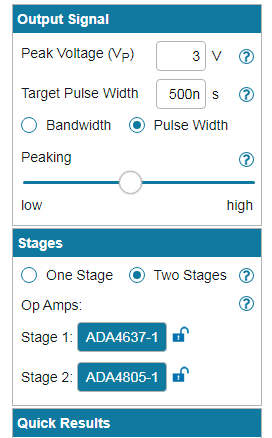
[picture p111: figure]
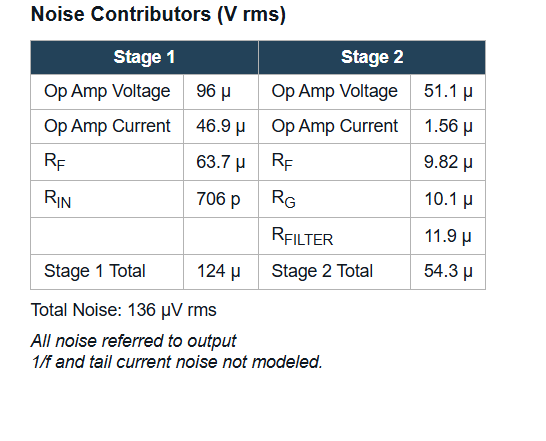
[picture p112: figure]
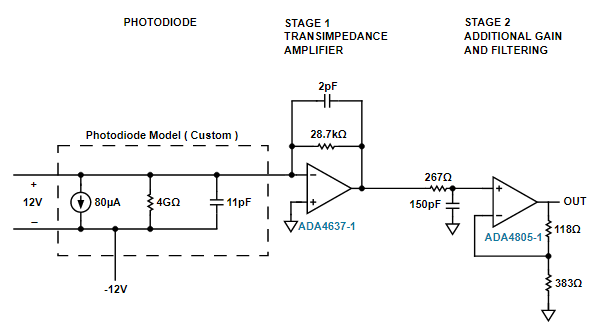
[picture p113: figure]
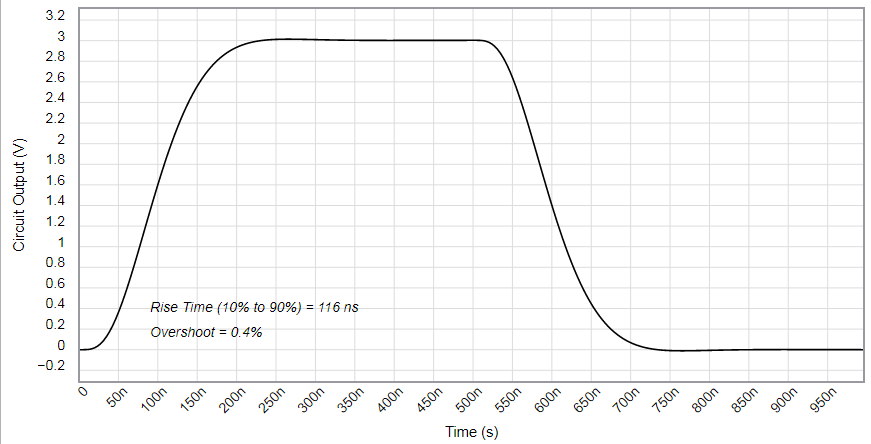
[picture p114: figure]

Диод

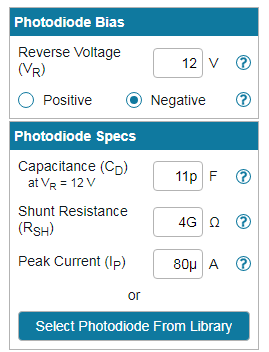
[picture p115: figure]
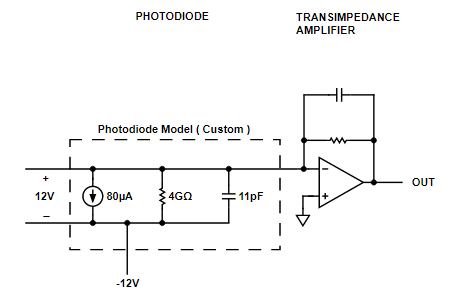
[picture p116: figure]
