Sasha7b9Work/LiniaServer/_Лисенков/Источник напряжения 50В/Плата 017 исправления.docx

Испр DA14 не соединен на плате с DA12:7

Испр ДВА МОСТА GSIB и W04M стоят неправильно

Испр Нужно поставить резистор и стабилитрон на ОС+

Испр Нужно поставить резистор и стабилитрон на ОС-

Нет Нужно поставить резистор и диод на +100

Нет Нужно поставить резистор и диод на -100

Исправил соединение на контактах резисторов заряжающих конденсатор
Испр Маленькие отверстия для крепления проводов

Испр Исправил соединение на ADUM1100

Нет Добавил на схеме резисторы подтягивающие A/B

Испр
