Sasha7b9Work/LiniaServer/_Лисенков/Перечни элементов/_Номера блоков,плат, трансформ..docx

Перечень узлов, печатных плат и трансформаторов, «Линия-2»

Наименование узла | | Печатный узел | Файл | Примечание
Анализатор ВАХ (вольтамперных характеристик) | УШЯИ.411251.011 | | | 11.11.2025г 17.03.2026г
Измеритель тока | УШЯИ.411131.006
- плата оптоформирователя | | .687243.350 | .758723. ??
- плата интерфейса | | .687243.351 | .758725. ??
- плата измерителя | | .687243.352 | ……………
Формирователь развертки | УШЯИ.411522.033 | .758727.205 | .758727.205 PcbDoc (Altium) 15.10.25
Источник напряжения 50 В | УШЯИ.411522.032
- плата | | .687253.017 | .758725.629
- плата | | .687253.018 | .758724.375
Источник напряжения (3 кВ) | УШЯИ.411522.034
- плата выпрямителя | УШЯИ.687253.019 | 758725.630 | .758725.630
- плата защиты | УШЯИ.687242.236 | 758721.097 | .758721.097
- плата источника | УШЯИ.687245.044 | 758727.206 | .758721.206
Трансформатор ШЛ25×50 | УШЯИ.671111.272
Трансформатор ШЛ32×40 | УШЯИ.671111.330
Источник-измеритель (база, подложка) | УШЯИ.411618.029
Дисплей | УШЯИ.467859.024
Контроллер | УШЯИ.467444.130 | .687264.002 | .467444.130
Интерфейс(задняя панель) | УШЯИ.468359.031
Коммутатор | УШЯИ.468213.012
- плата коммутатора | УШЯИ.687243.353 | .758725.
- плата | УШЯИ.687243.354 | .758725.
- кабель | УШЯИ.685641033
Блок питания | УШЯИ.436224.015 | | 04.12. 25
- плата | УШЯИ.687243.347
- плата | УШЯИ.687243.348
- плата | УШЯИ.687243.349
Трансформатор ШЛ16×16 | УШЯИ.671111.329
Трансформатор ШЛ25×50 | УШЯИ.671111.257
Адаптер | УШЯИ.687415.025
Камера измерительная | УШЯИ.687415.026
