Sasha7b9Work/LiniaServer/ИнтелАвто/Описание компьютерной программы/Изображения основных экранных форм.docx

# ИЗОБРАЖЕНИЯ ОСНОВНЫХ ЭКРАННЫХ ФОРМ

компьютерной программы «КПТС»

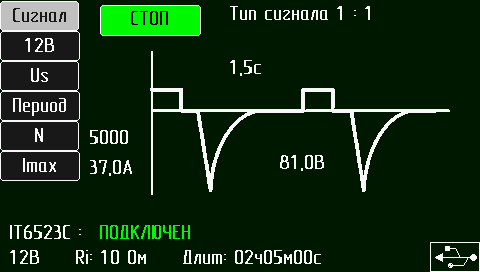
[picture p122: figure]

Рис.1 Управление параметрами испытательного импульса 1

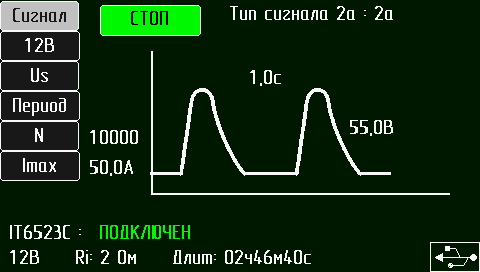
[picture p123: figure]

Рис.2 Управление параметрами испытательного импульса 2a

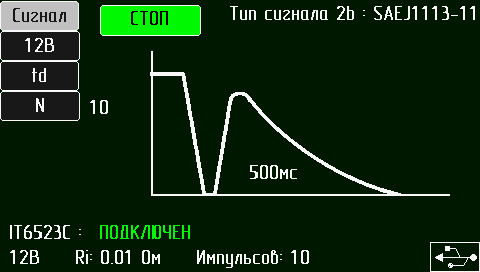
[picture p124: figure]

Рис.3 Управление параметрами испытательного импульса 2b

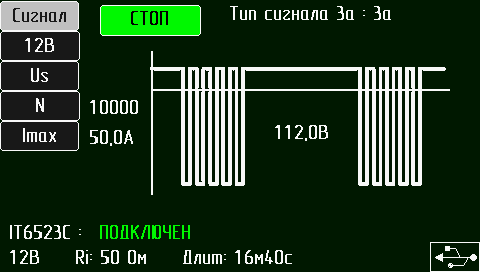
[picture p125: figure]

Рис.4 Управление параметрами испытательного импульса 3a

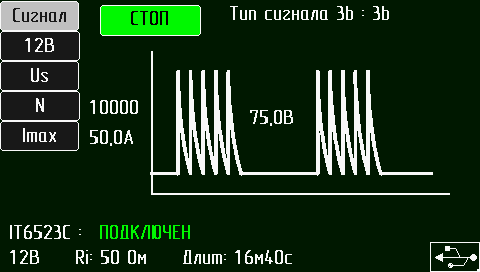
[picture p126: figure]

Рис.5 Управление параметрами испытательного импульса 3b

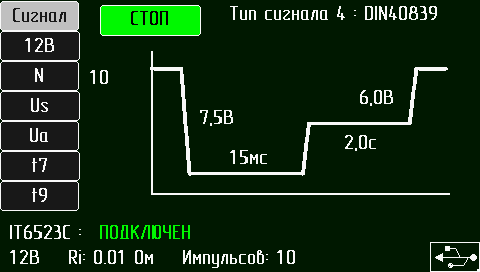
[picture p127: figure]

Рис.6 Управление параметрами испытательного импульса 4

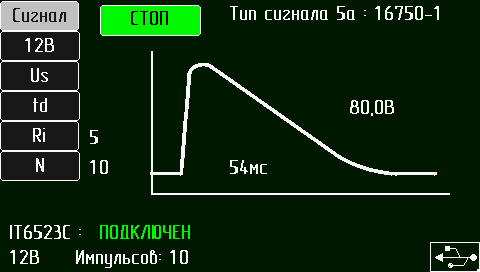
[picture p128: figure]

Рис.7 Управление параметрами испытательного импульса 5a

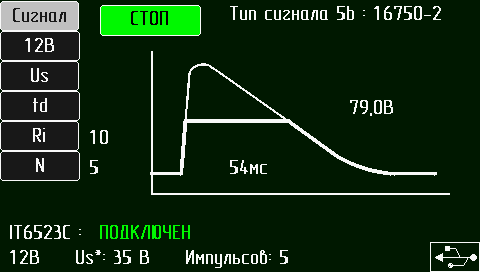
[picture p129: figure]

Рис.8 Управление параметрами испытательного импульса 5b
