Sasha7b9Work/LiniaServer/ИнтелАвто/Описание компьютерной программы/Описание компьютерной программы.docx

# Краткое описание компьютерной программы

# «КПТС»

1. Назначение.

Данное программное обеспечение (ПО) предназначено для управления параметрами испытательных импульсов, формируемых КПТС, а именно:

- испытательный импульс 1 согласно ГОСТ ISO 7637-2-2015 : напряжение сети (12 или 24 В), амплитуда (75-150 В для сети 12 В и 300-600 В для сети 24В), период (500 мс – 5 сек), количество импульсов (5000-100000), ток ограничения (1-50 А);

- испытательный импульс 2а согласно ГОСТ ISO 7637-2-2015 : напряжение сети (12 или 24 В), амплитуда (37-112 В), период (200 мс – 5 сек), количество импульсов (5000-100000), ток ограничения (1-50 А);

- испытательный импульс 2b согласно ГОСТ ISO 7637-2-2015 : напряжение сети (12 или 24 В), длительность импульса (200 мс – 2 сек), количество импульсов (1-10);

- испытательный импульс 3a согласно ГОСТ ISO 7637-2-2015 : напряжение сети (12 или 24 В), амплитуда (112-220 В для сети 12 В и 150-300 В для сети 24 В), количество импульсов (10000-100000), ток ограничения (1-50 А);

- испытательный импульс 3b согласно ГОСТ ISO 7637-2-2015 : напряжение сети (12 или 24 В), амплитуда (75-150 В для сети 12 В и 150-300 В для сети 24 В), количество импульсов (10000-100000), ток ограничения (1-50 А);

- испытательный импульс 4 согласно DIN40839 : напряжение сети (12 или 24 В), количество импульсов (1-10), амплитуда среза (6-7.5 В для сети 12 В и 12-16 В для сети 24 В), напряжение фронта (2.5-6 В для сети 12 В и 5-12 В для сети 24 В), длительность низкой полярности (15-40 мс для сети 12 В и 50-100 мс для сети 24 В), длительность высокой полярности (500 мс – 20 сек);

- испытательный импульс 5a согласно ISO 16750-2 : напряжение сети (12 или 24 В), амплитуда (79-101 В для сети 12 В и 151-202 В для сети 24 В), длительность (40-400 мс для сети 12 В и 100-350мс для сети 24 В), внутреннее сопротивления источника (1-10 Ом), количество импульсов (1-1000);

- испытательный импульс 5b согласно ISO 16750-2 : напряжение сети (12 или 24 В), амплитуда (79-100 В для сети 12 В и 151-202 В для сети 24 В), длительность (40-400 мс для сети 12 В и 100-350мс для сети 24 В), внутреннее сопротивления источника (1-10 Ом), количество импульсов (1-1000).

2. Общие сведения.

Программное обеспечение представляет собой исходные текстовые файлы на языке С++.

3. Структура ПО.

HAL – функции работы с аппаратной частью МК (микроконтроллера);

Device – высокоуровневые функции;

Display – функции работы с дисплеем;

LAN – функции работы с локальной сетью;

Menu – структура меню;

Settings – настройки;

SCPI – функции SCPI (команды работы по USBи LAN);

VCP – функции работы с USB;

Utils – вспомогательные функции (утилиты).

Требования к микроконтроллеру:

- stm32f429
