Sasha7b9Work/LiniaServer/Источник напряжения 50В/017 ПЭ3.pdf

Изм. | Лист | № докум. | Подп. | Дата
| | Разраб.
Пров. | | | | | 1 4

Н.контр.
Утв.
Копировал | Формат А4
Лит. | Лист | Листов Инв. № подл. Подп. и дата Взам. инв. № Инв. № дубл. Подп. и дата Справ. № Перв. примен. | Зона | Поз.
обозначение
Наименование | Кол. | Примечание

Конденсаторы

C1-C20 | 0805-X7R-25 В-0,1 мкФ +-10% | 20
C21 | 1206-C0G-50 В-22 пФ +-5% | 1
C22,C23 | 1206-X7R-50 B-100 пФ+-10% | 2
C24,C25 | 0805-C0G-250 В-10 пФ +-5% | 2
C26 | 2220-X7R-250 В-1 мкФ +-10% | 1
C27,C28 | 0805-C0G-250 В-10 пФ +-5% | 2
C29-C31 | 2220-X7R-250 В-1 мкФ +-10% | 3
C32,C33 | 0805-C0G-250 В-10 пФ +-5% | 2
C34,C35 | 0805-X7R-25 В-1 мкФ +-10% | 2
C36,C37 | 220пФ NP0 1000В 5% 1206 | 2
C38-C40 | ECR4R7M50B | 3
C41-C44 | 0805-X7R-25 В-0,33 мкФ +-10% | 4
C45,C46 | KM220M2EBKJ1020VBK | 2
C47-C51 | 0805-X7R-25 В-0,33 мкФ +-10% | 5
C52,C53 | 1206-X7R-50 B-22 пФ+-10% | 2
C54 | 0805-X7R-25 В-0,33 мкФ +-10% | 1

Микросхемы

DA1 | ADuM1100AR | 1
DA2,DA3 | ADM2486BRWZ | 2
DA4 | ADuM1100AR | 1
DA5 | ADM2486BRWZ | 1
DA6 | ADuM1100AR | 1
DA7 | ADR435BRZ | 1
DA8,DA9 | ADuM1100AR | 2

Изм. | Лист | № докум. | Подп. | Дата
Лист Инв. № подл. Подп. и дата Взам. инв. № Инв. № дубл. Подп. и дата | 2 Зона | Поз.
DA10 | AD5443YRM | 1
DA11,DA12 | ADA4084-2ARZ | 2
DA13 | ADuM1100AR | 1
DA14 | ADG433BR | 1
DA15,DA16 | PA340CC | 2
DA17,DA18 | TLV9152IDR | 2
DA19 | ADA4084-2ARZ | 1
DA20,DA21 | IL311D | 2
DD1 | IN74HC00AD | 1
DD2 | IN74HC20D | 1
DD3 | IN74HC00AD | 1
K1,K2 | Реле TLP3549F | 2

Резисторы

R1-R6 | 1206-1 кОм+-5% | 6
R7-R9 | 1206-100 Ом+-5% | 3
R10-R12 | 1206-12 кОм+-5% | 3
R13 | 1206-10 кОм+-0,5% | 1
R14 | 1206-100 Ом+-0,5% | 1
R15,R16 | 1206-10 кОм+-0,5% | 2
R17 | 1206-12 кОм+-1% | 1
R18 | 1206-15 кОм+-5% | 1
R19,R20 | 1206-51 Ом+-5% | 2
R21 | 1206-15 кОм+-5% | 1
R22,R23 | 1206-2 кОм+-0.5% | 2
R24 | 1206-1 кОм+-5% | 1
R25,R26 | 1206-330 Ом+-5% | 2
R27 | 1206-1 кОм+-5% | 1
R28,R29 | 1206-20 кОм+-0.5% | 2
R30-R33 | 1206-100 кОм+-5% | 4

Лист Инв. № подл. Подп. и дата Взам. инв. № Инв. № дубл. Подп. и дата | 3 Зона | Поз.
R34 | 1206-240 Ом+-5% | 1
R35 | 1206-1,2 кОм+-5% | 1
R36 | 1206-240 Ом+-5% | 1
R37 | 1206-1,2 кОм+-5% | 1
R38,R39 | 1206-2,4 кОм+-5% | 2
R40 | 1206-180 Ом+-5% | 1
R41 | 1206-100 Ом+-5% | 1
R42 | 1206-1 кОм+-5% | 1
R43 | 1206-51 Ом+-5% | 1
R44 | 1206-3,6 кОм+-5% | 1
R45,R46 | 1206-10 кОм+-5% | 2
R47,R48 | 1206-10 Ом+-5% | 2
R49 | 1206-15 кОм+-5% | 1
R50,R51 | 1206-12 кОм+-5% | 2
R52 | 1206-6,98 кОм+-1% | 1
R53 | 1206-1 кОм+-5% | 1
R54,R55 | 2512-1,2 кОм+-5% | 2
R56,R57 | 1206-2 кОм+-0.5% | 2
R58-R61 | 1206-240 Ом+-5% | 4
R62,R63 | 1206-430 Ом+-5% | 2
R64 | 1206-150 Ом+-5% | 1
R65,R66 | 2512-5,6 кОм+-5% | 2
R67 | 1206-2 кОм+-5% | 1
R68,R69 | 1206-51 кОм+-5% | 2
R70,R71 | 1206-390 Ом+-5% | 2
R72,R73 | W21-3W-680 Ом +-5% | 2
R74,R75 | HS15-4R7-J | 2

Потенциометры

RP1 | 3362P-1-103LF | 1
RP2,RP3 | 3329H-1-102LF | 2

Лист Инв. № подл. Подп. и дата Взам. инв. № Инв. № дубл. Подп. и дата | 4 Зона | Поз.

Диоды

VD1-VD4 | 1N4148WS | 4
VD5,VD6 | BZX84C15LT1G | 2
VD8 | BZX84C15LT1G | 1
VD9 | BZX84C6V2LT1G | 1
VD10 | BZX84C15LT1G | 1
VD11,VD12 | 1N4007WS | 2
VD13 | W04M | 1
VD14 | GSIB2540 | 1
VD15,VD16 | BZX84C10LT1G | 2

Транзисторы

VT1 | ZXMN10A08E6TA | 1
VT2 | ZXMP10A17E6TA | 1
VT3 | IRF5210PBF | 1
VT4 | IPA083N10N5XKSA1 | 1

Вилки

XP1 | BH2-20 | 1
XP2,XP3 | DS1021-1x3 | 2
XP4 | 280373-2 | 1
XP5 | 280372-2 | 1
XP6 | MNL-350810-1 | 1
XP7 | XT60-M | 1
XS1,XS2 | Розетки Jumper, 2.54mm | 2
