Sasha7b9Work/LiniaServer/_Лисенков/арпрпар.pdf

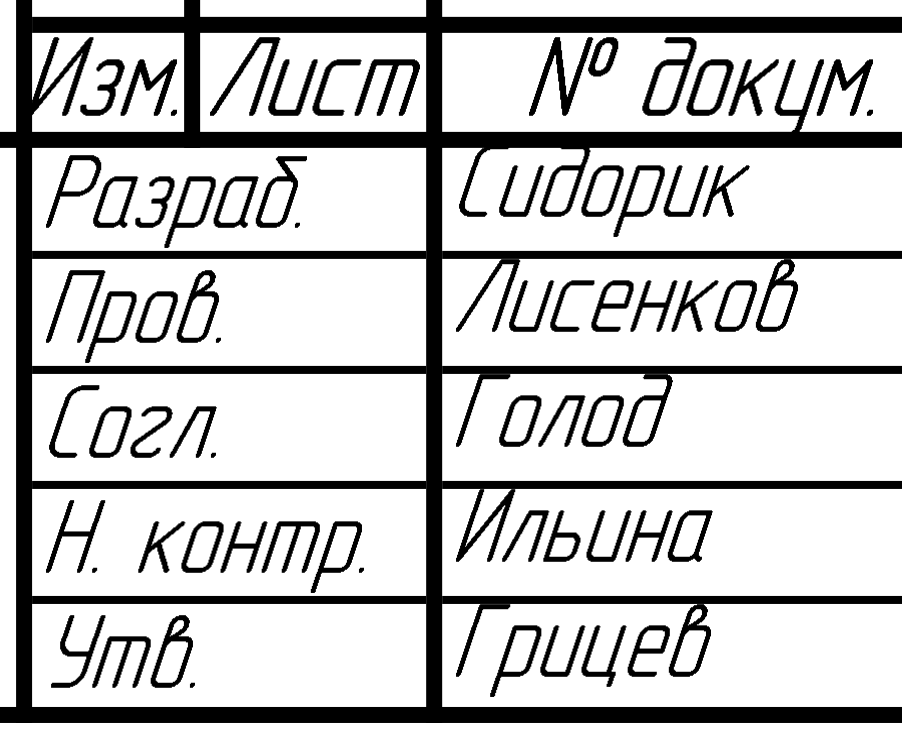
[picture p130: figure]

Плата интерфейса
