Sasha7b9Work/LiniaServer/1-Парамерус/Контакты ООО ПАРАМЕРУС - Разработка и производство прецизионных высоковольтных изделий силовой электроники в России_files/company-image1.jpg

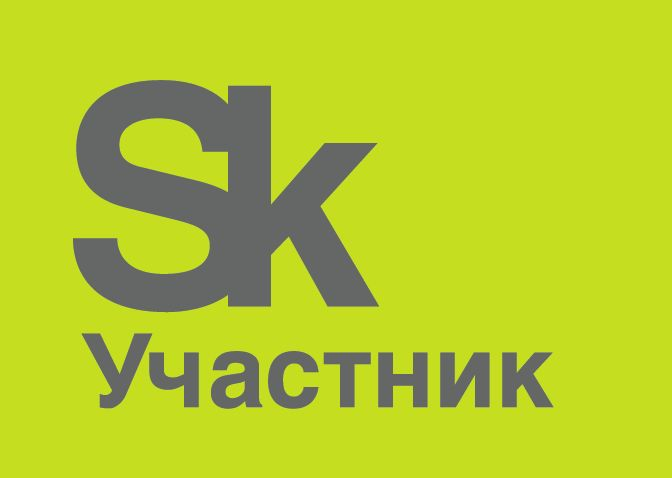
1-Парамерус/Контакты ООО ПАРАМЕРУС - Разработка и производство прецизионных высоковольтных изделий силовой электроники в России_files/company-image1.jpg
