Sasha7b9Work/LiniaServer/_Лисенков/Diplomы/Irina.grishkovets22101999/тезисы 2021/Фото/Модуль МК__ Контакт.jpg

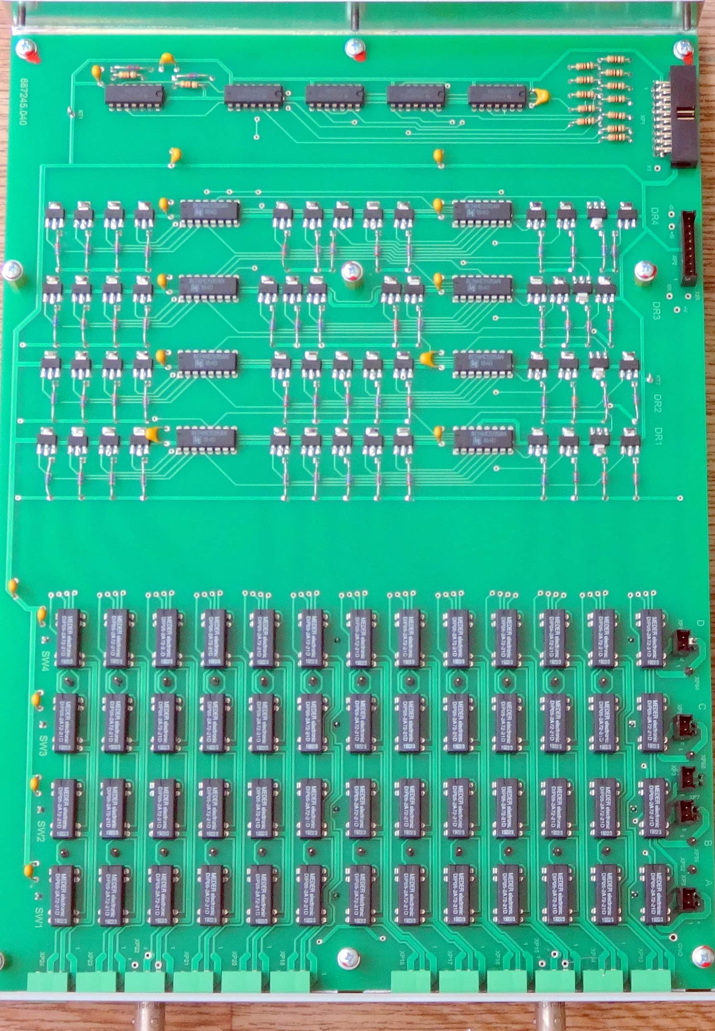
_Лисенков/Diplomы/Irina.grishkovets22101999/тезисы 2021/Фото/Модуль МК__ Контакт.jpg
