Sasha7b9Work/LiniaServer/_Лисенков/LtSpice/LtSpiceModels/Emmiter, Photodiode/nfrared-detector-circuit-diagram.png

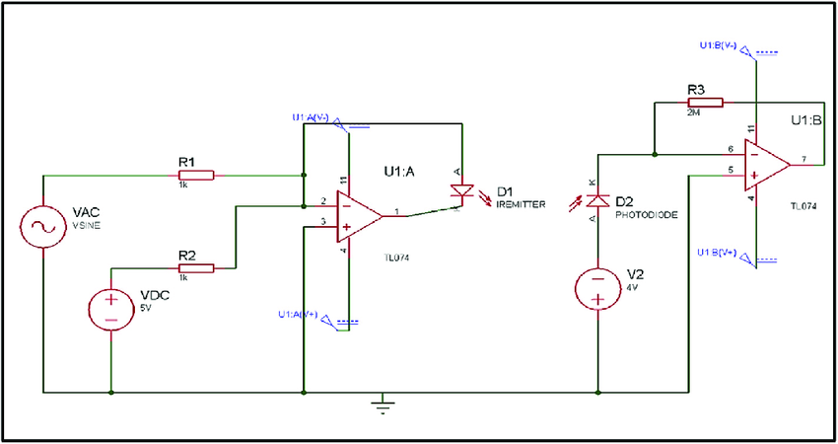
_Лисенков/LtSpice/LtSpiceModels/Emmiter, Photodiode/nfrared-detector-circuit-diagram.png
