Sasha7b9Work/LiniaServer/_Лисенков/LtSpice/LtSpiceModels/gurad ring layout.png

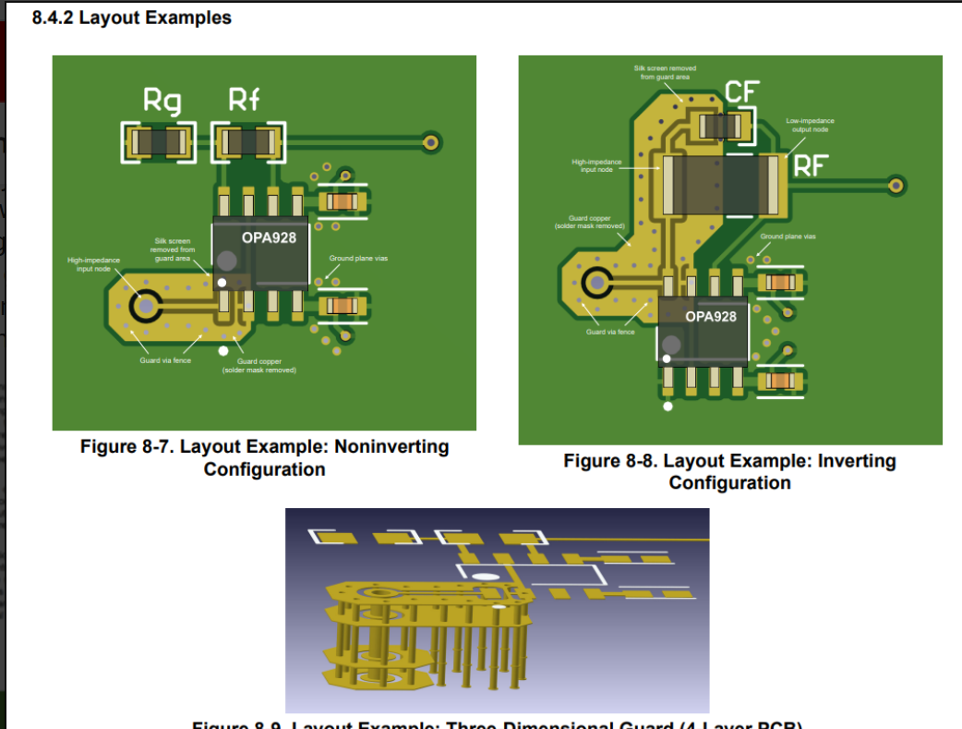
_Лисенков/LtSpice/LtSpiceModels/gurad ring layout.png
