Sasha7b9Work/LiniaServer/_Лисенков/LtSpice/LtSpiceModels/Без имени.png

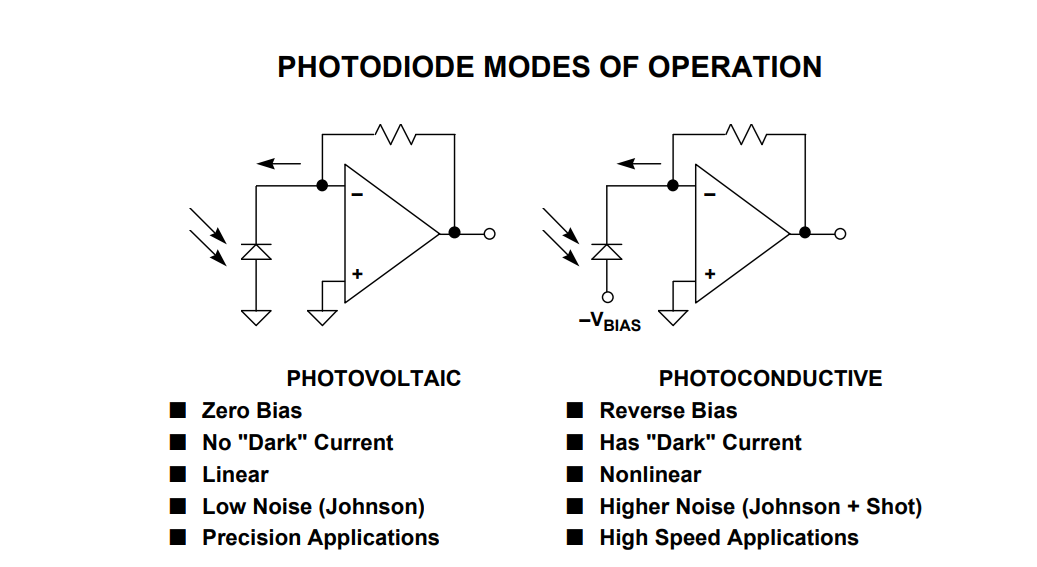
_Лисенков/LtSpice/LtSpiceModels/Без имени.png
