Sasha7b9Work/LiniaServer/_Лисенков/Аналоги/Aналоги, близкие  по функцион.схеме/L2-156/7e7d50cb535dd2707b1460f0e910434a.png

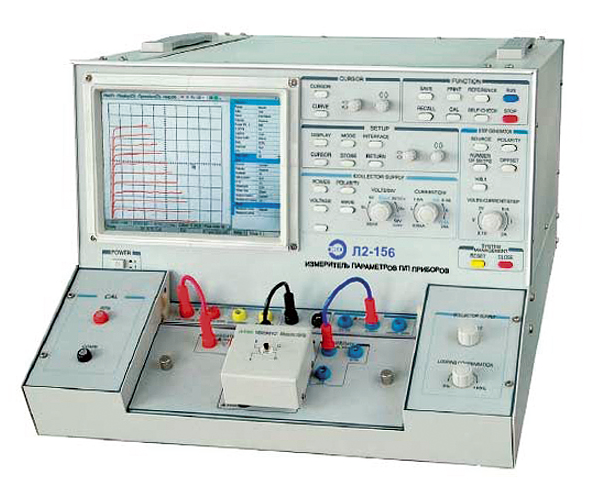
_Лисенков/Аналоги/Aналоги, близкие по функцион.схеме/L2-156/7e7d50cb535dd2707b1460f0e910434a.png
