Sasha7b9Work/LiniaServer/_Лисенков/Аналоги/Aналоги, близкие  по функцион.схеме/L2-156/l2-156max.jpg

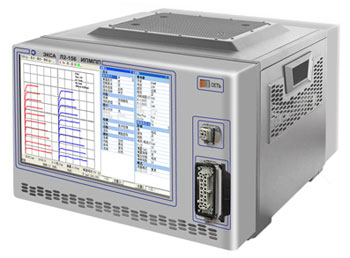
_Лисенков/Аналоги/Aналоги, близкие по функцион.схеме/L2-156/l2-156max.jpg
