Sasha7b9Work/LiniaServer/_Лисенков/Аналоги/Aналоги, близкие  по функцион.схеме/L2-156/YB48200.jpg

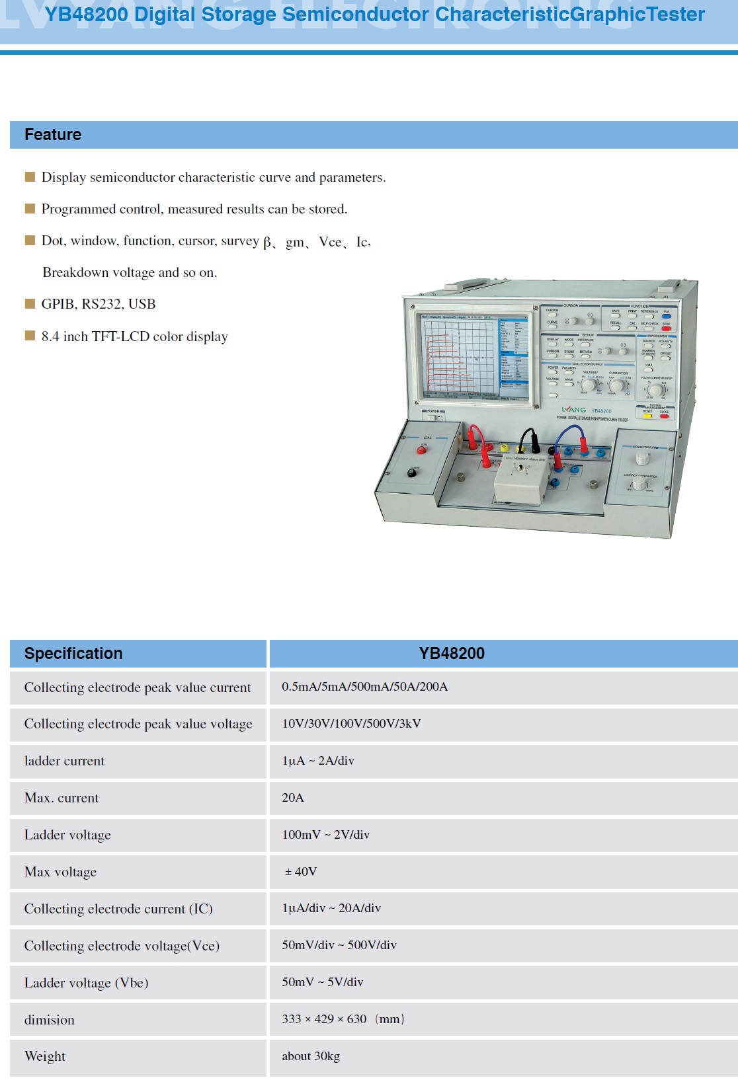
_Лисенков/Аналоги/Aналоги, близкие по функцион.схеме/L2-156/YB48200.jpg
