Sasha7b9Work/LiniaServer/_Лисенков/Источник напряжения 50В/017/Без имени.png

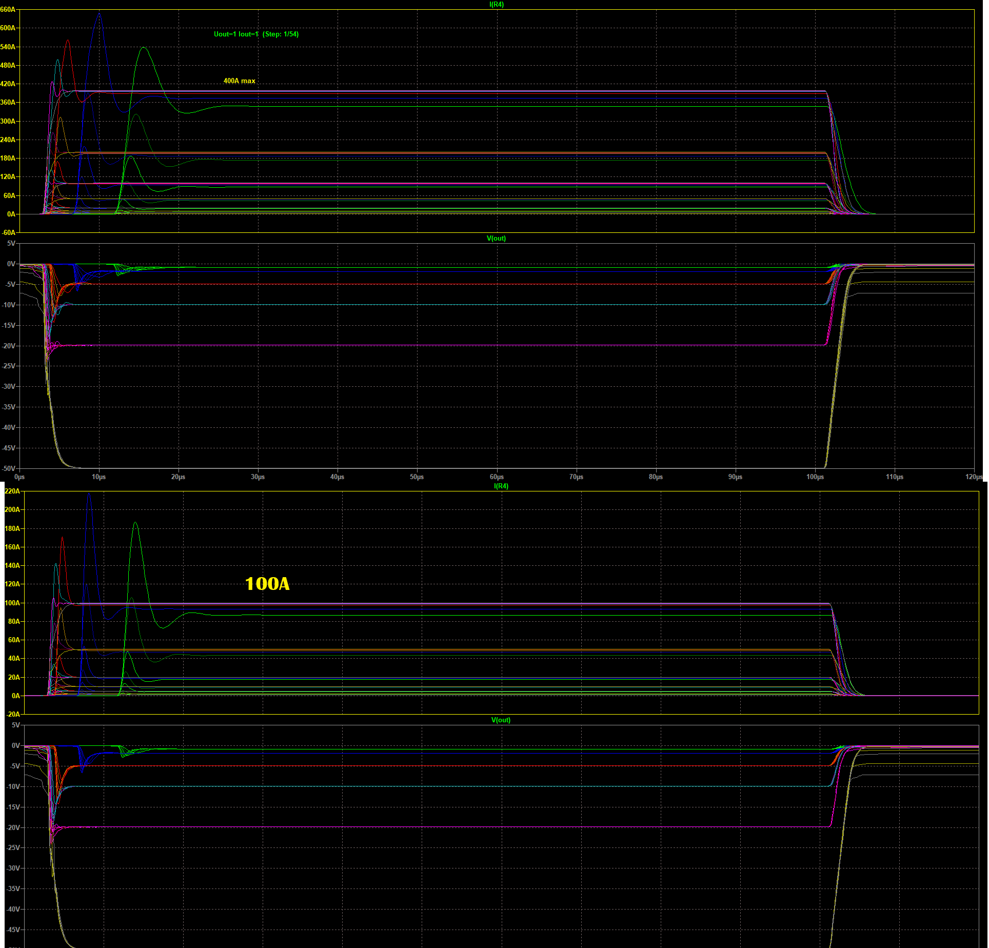
_Лисенков/Источник напряжения 50В/017/Без имени.png
