Sasha7b9Work/LiniaServer/_Лисенков/Источник напряжения 50В/Рез-ты макетирования-моделирования/схема ltspice 12.10.png

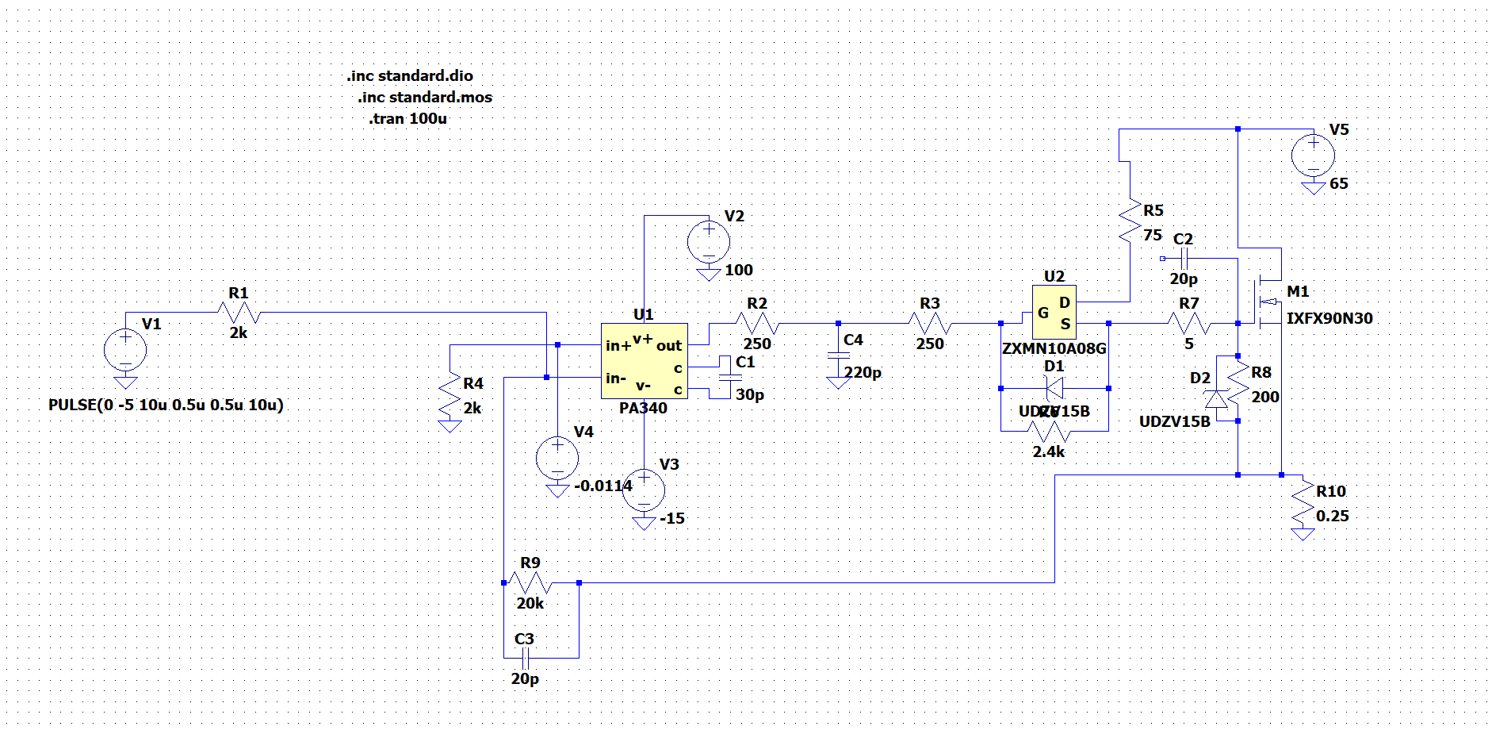
_Лисенков/Источник напряжения 50В/Рез-ты макетирования-моделирования/схема ltspice 12.10.png
