Sasha7b9Work/LiniaServer/_Лисенков/Источник напряжения 50В/Рез-ты макетирования-моделирования/схема ltspice канал минус 16.10.png

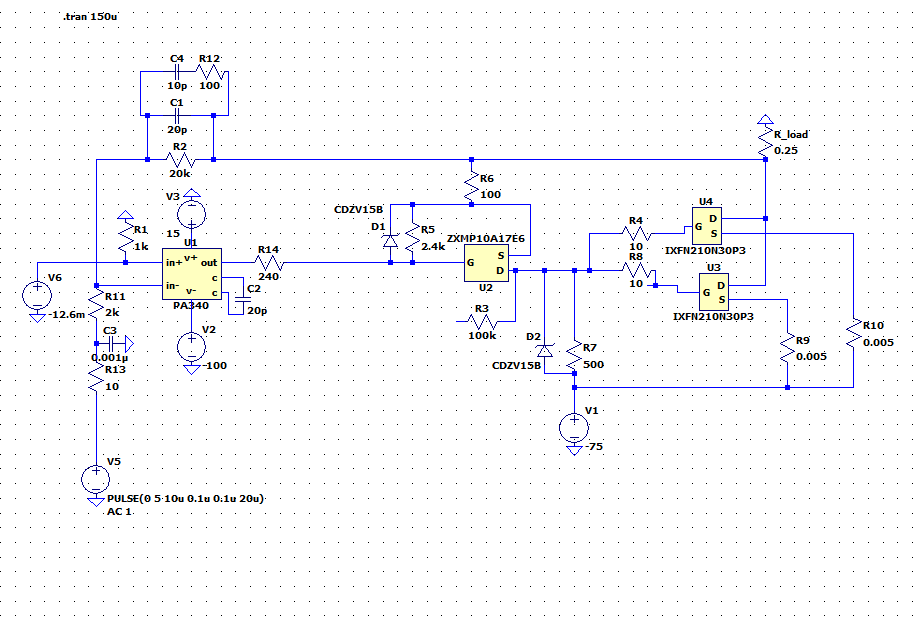
_Лисенков/Источник напряжения 50В/Рез-ты макетирования-моделирования/схема ltspice канал минус 16.10.png
