Sasha7b9Work/LiniaServer/_Лисенков/Приборостроение MikroVisio/внешний вид блока копия.jpg

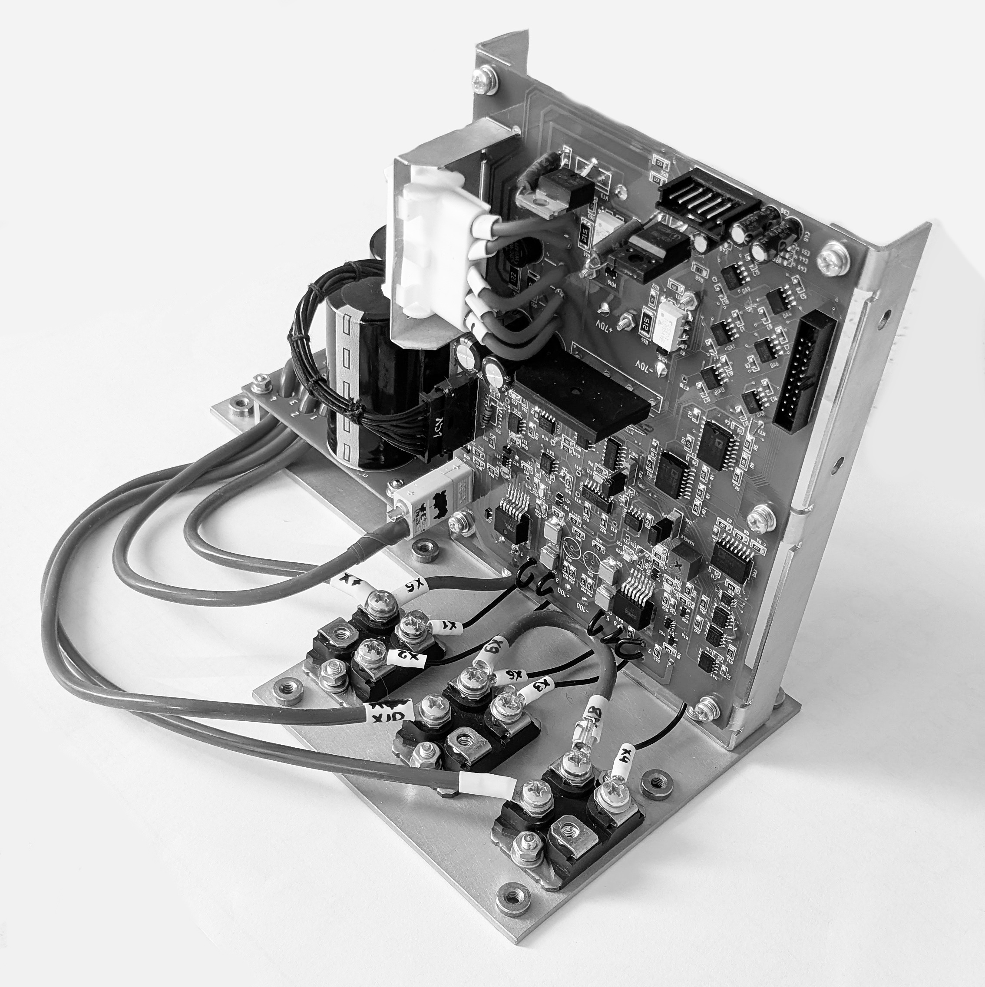
_Лисенков/Приборостроение MikroVisio/внешний вид блока копия.jpg
