Sasha7b9Work/LiniaServer/_Лисенков/Формирователь развертки/Описание/ФР_Структурная.drawio.png

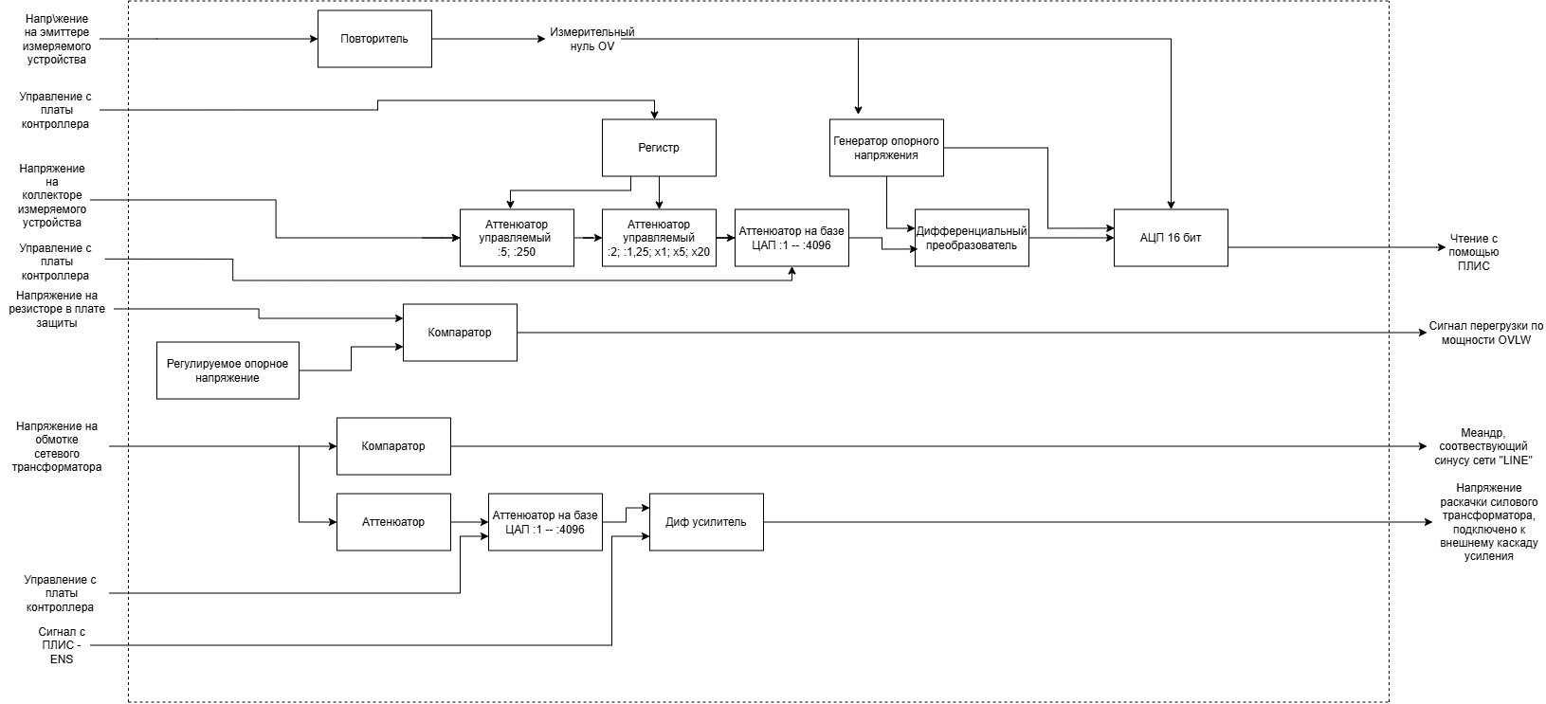
_Лисенков/Формирователь развертки/Описание/ФР_Структурная.drawio.png
