Sasha7b9Work/LiniaServer/SMD Schottky Diodes/Сравнительная.png

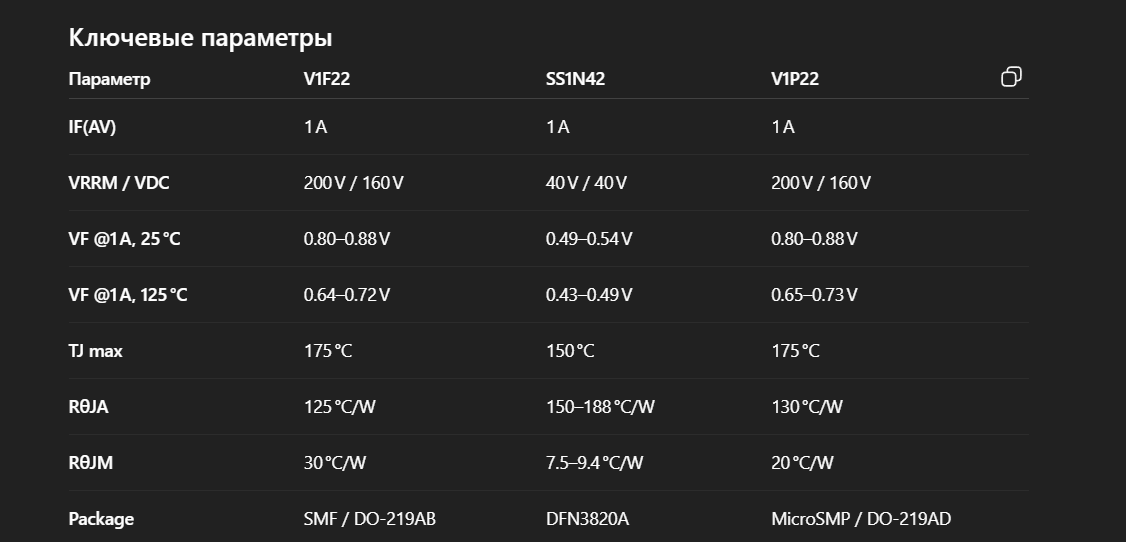
SMD Schottky Diodes/Сравнительная.png
