Sasha7b9Work/LiniaServer/Блок базы - Подложки/PLIS_BASE.JPG

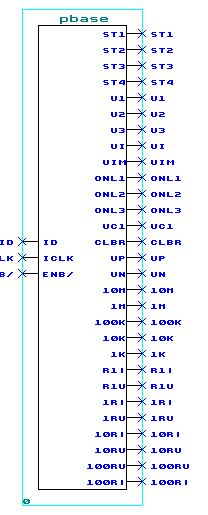
Блок базы - Подложки/PLIS_BASE.JPG
