Sasha7b9Work/LiniaServer/Блок базы - Подложки/Сборочный чертёж PDF/Управление питанием ОУ позволяет увеличить диапазоны напряжений_files/bootstrap_oa-4.png

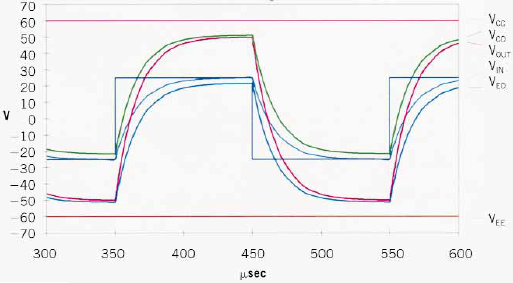
Блок базы - Подложки/Сборочный чертёж PDF/Управление питанием ОУ позволяет увеличить диапазоны напряжений_files/bootstrap_oa-4.png
