Sasha7b9Work/LiniaServer/Блок базы - Подложки/Схема сигналов.bmp

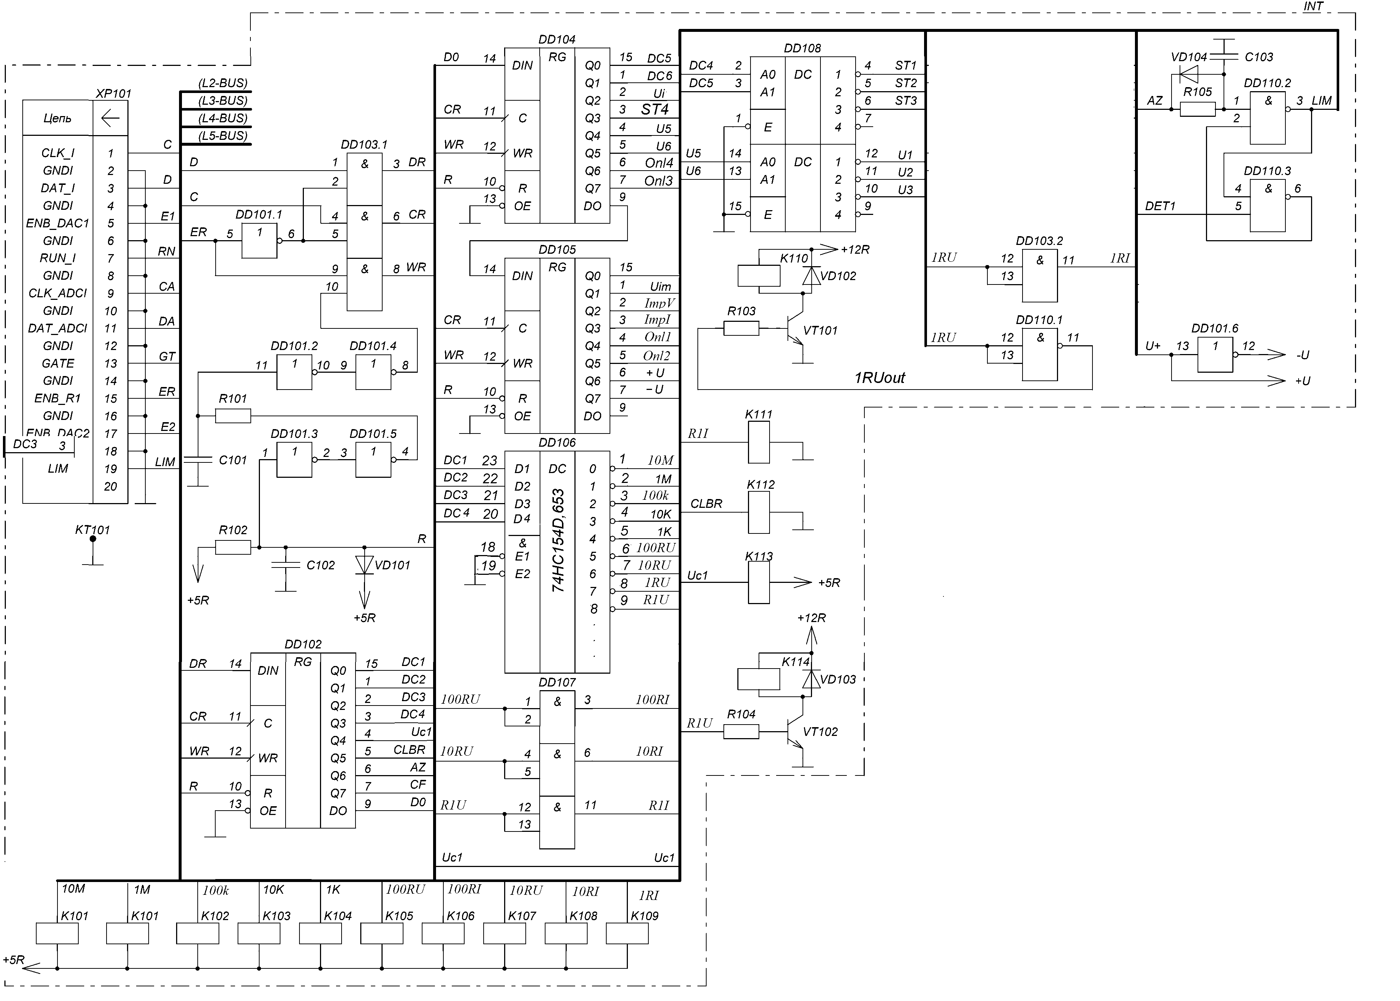
Блок базы - Подложки/Схема сигналов.bmp
