Sasha7b9Work/LiniaServer/ИнтелАвто/1-Копии Экрана/000024086.bmp

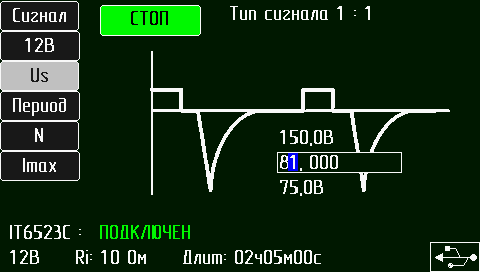
ИнтелАвто/1-Копии Экрана/000024086.bmp
