Sasha7b9Work/LiniaServer/ИнтелАвто/1-Копии Экрана/000177980.bmp

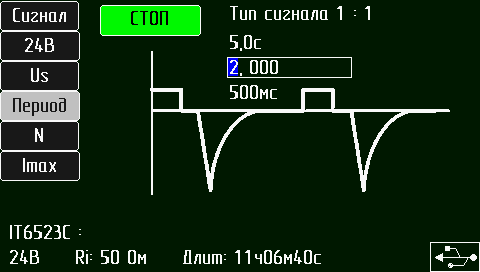
ИнтелАвто/1-Копии Экрана/000177980.bmp
