Sasha7b9Work/LiniaServer/ИнтелАвто/1-Копии Экрана/000204755.bmp

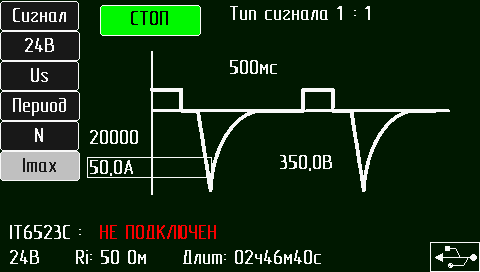
ИнтелАвто/1-Копии Экрана/000204755.bmp
