Sasha7b9Work/LiniaServer/ИнтелАвто/1-Копии Экрана/000808370.bmp

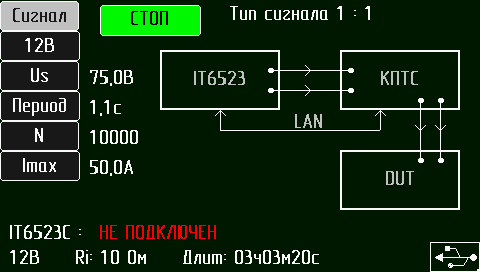
ИнтелАвто/1-Копии Экрана/000808370.bmp
