Sasha7b9Work/LiniaServer/ИнтелАвто/1-Копии Экрана/000869644.bmp

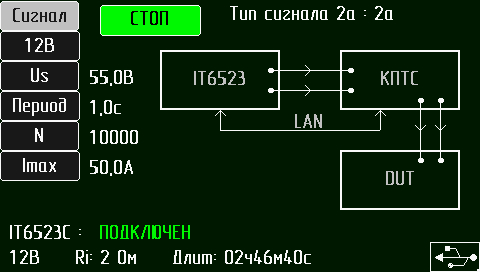
ИнтелАвто/1-Копии Экрана/000869644.bmp
