Sasha7b9Work/LiniaServer/ИнтелАвто/1-Копии Экрана/000936360.bmp

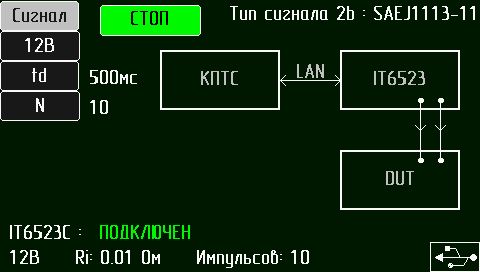
ИнтелАвто/1-Копии Экрана/000936360.bmp
