Sasha7b9Work/LiniaServer/ИнтелАвто/1-Копии Экрана/000962903.bmp

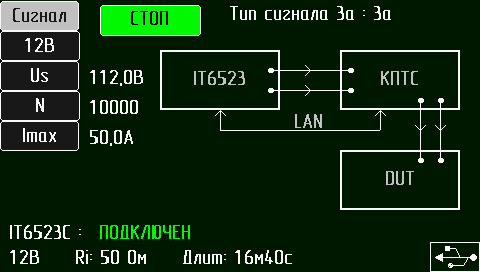
ИнтелАвто/1-Копии Экрана/000962903.bmp
