Sasha7b9Work/LiniaServer/ИнтелАвто/1-Копии Экрана/001392785.bmp

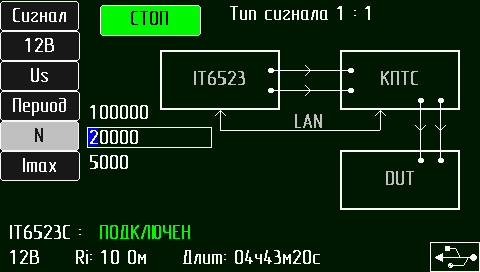
ИнтелАвто/1-Копии Экрана/001392785.bmp
