Sasha7b9Work/LiniaServer/ИнтелАвто/1-Копии Экрана/002066282.bmp

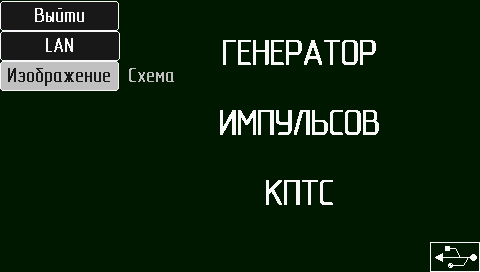
ИнтелАвто/1-Копии Экрана/002066282.bmp
