Sasha7b9Work/LiniaServer/ИнтелАвто/1-Копии Экрана/002509542.bmp

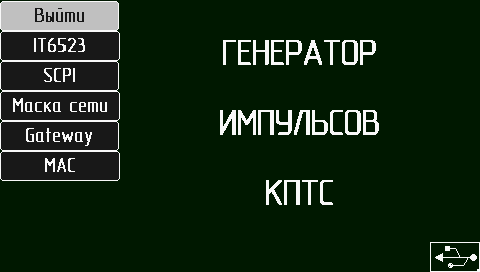
ИнтелАвто/1-Копии Экрана/002509542.bmp
