Sasha7b9Work/LiniaServer/ИнтелАвто/1-Копии Экрана/002531178.bmp

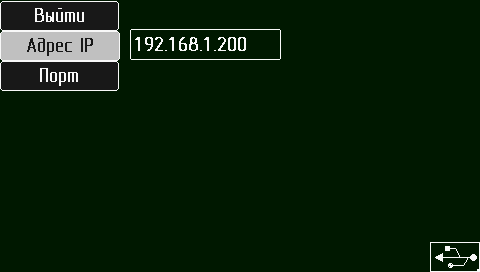
ИнтелАвто/1-Копии Экрана/002531178.bmp
