Sasha7b9Work/LiniaServer/ИнтелАвто/1-Копии Экрана/003068415.bmp

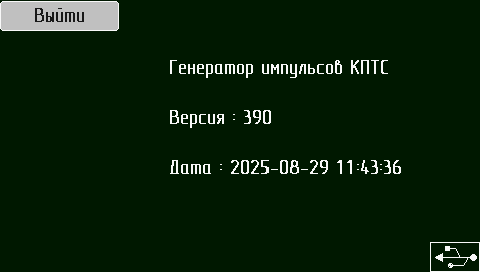
ИнтелАвто/1-Копии Экрана/003068415.bmp
