Sasha7b9Work/LiniaServer/С8-54 испытания/C8-54_foto/C8-54.jpg

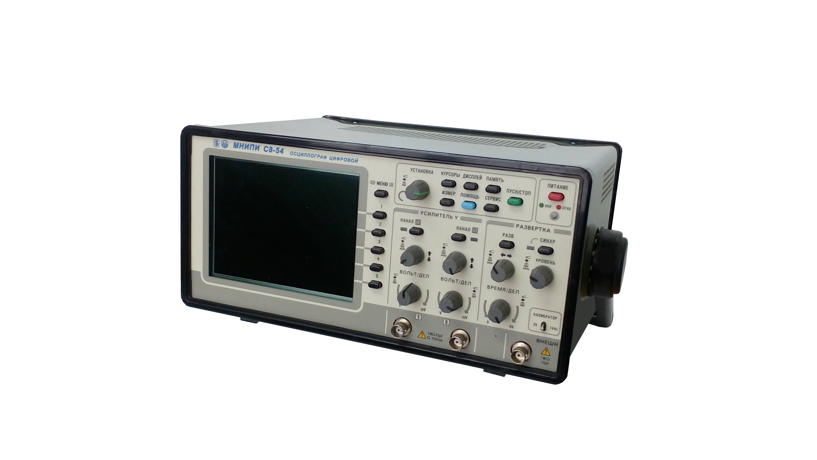
С8-54 испытания/C8-54_foto/C8-54.jpg
