Sasha7b9Work/LiniaServer/Снимок -cyclone.JPG

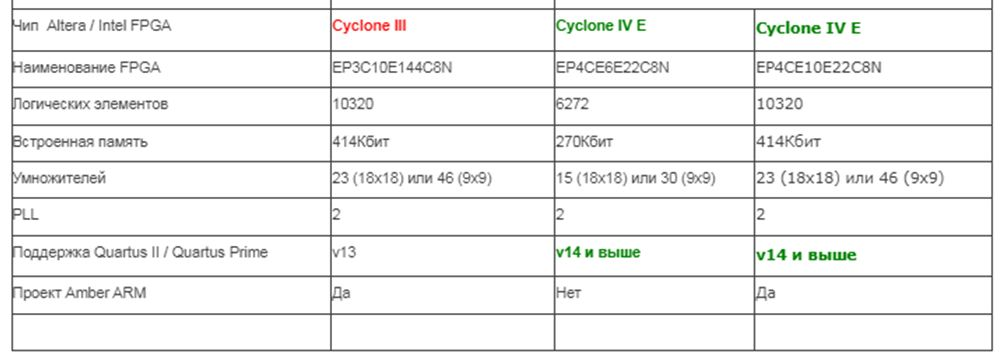
Снимок -cyclone.JPG
