Sasha7b9Work/LiniaServer/Совместимость разных поколений ПЛИС Cyclone – PCM_files/IMG_0779-800x533.jpg

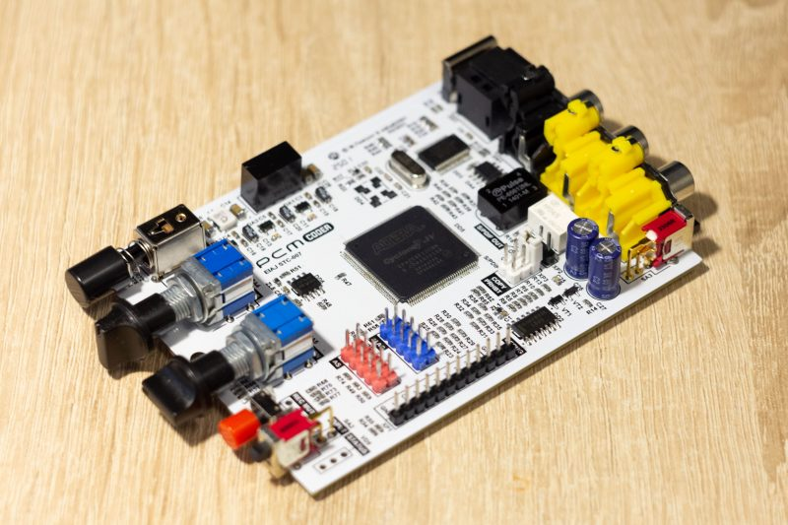
Совместимость разных поколений ПЛИС Cyclone – PCM_files/IMG_0779-800x533.jpg
