Sasha7b9Work/LiniaServer/Совместимость разных поколений ПЛИС Cyclone – PCM_files/IMG_1118-e1629964584388-800x500.png

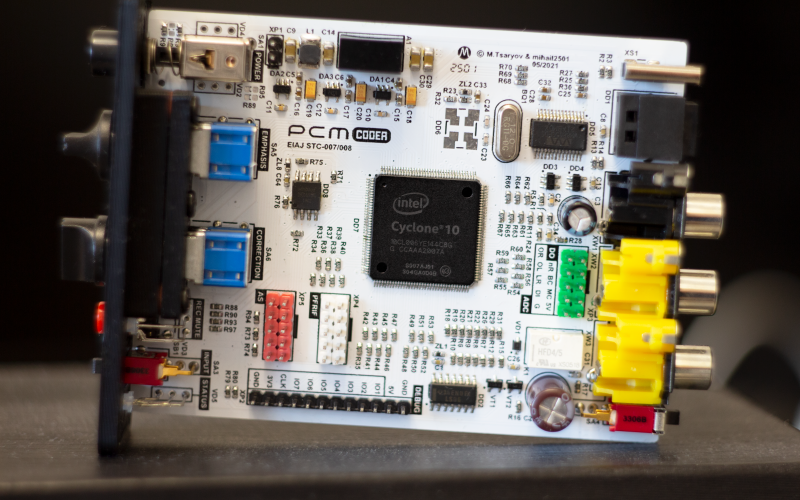
Совместимость разных поколений ПЛИС Cyclone – PCM_files/IMG_1118-e1629964584388-800x500.png
