Sasha7b9Work/LiniaServer/_Лисенков/Ватафа/Плата Выпрямитель УШЯИ.687253.019.xlsx

Line # | Name | Description | Designator | Quantity
 | К73-17-250 В-1 мкФ +-20% |  | C1, C4 | 2
 | GRM2165C2A102JA01D | 0805 1000 pF 100 V ±5% Tolerance X7R Multilayer Ceramic Chip Capacitor | C2, C3 | 2
 | К73-17-250 В-0,47 мкФ +-20% |  | C5, C6 | 2
 | 1206-9,1 кОм+-5% |  | R1, R2, R5 | 3
 | 1206-240 Ом+-5% |  | R3, R4 | 2
 | 1206-150 Ом+-5% |  | R6, R7 | 2
 | 1206-100 Ом+-5% |  | R8 | 1
 | 43CTQ100 | High Performance Schottky Rectifier, 2 x 20 A | VD1, VD2 | 2
 | 1,5KE68CA | Супрессор 1,5KE68CA | VD3, VD4 | 2
 | 1N4007 | General Purpose Plastic Rectifier | VD5, VD6 | 2
 | MNL-350810-1 |  | XP1 | 1
