Sasha7b9Work/LiniaServer/_Лисенков/Ватафа/Плата измерителяПЕРЕЧЕНЬ.xlsx

Name | Description | Буквенно-цифровое обозначение | Кол. | Поз. | Footprint | Manufacturer 1 | Supplier 1
ADA4637-1ARZ | 30 V, High Speed, Low Noise, Low Bias Current, JFET Operational Amplifier | DA5, DA9 | 2 |  | 8-SOIC
IN74HC138AD | Дешифратор-демультиплексор IN74HC138A 3-8 с инверсией на выходе | DD4 | 1 |  | 16-SOIC
MAX809S | Very Low Supply Current 3-Pin Microprocessor Reset Monitors | DA1 | 1 |  | SOT-23-3
0805-C0G-50 В-240 пФ +-5% |  | C13 | 1 | 30 | CAP: 0805
0805-X7R-25 В-0,1 мкФ +-10% |  | C9 | 1 | 31 | CAP: 0805
0805-X7R-25 В-1 мкФ +-10% |  | C33, C35, C36, C41 | 4 | 32 | CAP: 0805
1206-NP0-500 B-270 пФ+-5% |  | C3 | 1 | 33 | CAP: 1206
1206-X7R-10 B-10 мкФ+-10% |  | C16 | 1 | 34 | CAP: 1206
1206-X7R-25 B-47мкФ+-10% |  | C34, C38, C39, C43 | 4 | 35 | CAP: 1206
1206-X7R-50 B-0,01 мкФ+-10% |  | C10, C17, C19, C42 | 4 | 36 | CAP: 1206
1206-X7R-50 B-0,1 мкФ+-10% |  | C4, C5, C6, C8, C11, C12, C14, C15, C23, C24, C25, C26, C27 | 13 | 37 | CAP: 1206
1206-X7R-50 B-0,33 мкФ+-10% |  | C22 | 1 | 38 | CAP: 1206
1206-X7R-50 B-2,2 мкФ+-10% |  | C18, C20, C21 | 3 | 39 | CAP: 1206
1206-X7R-50 B-10 мкФ+-10% |  | C29, C31, C32, C40 | 4 | 40 | CAP: 1206
1206-XP7-500 B-15 нФ+-10% |  | C2 | 1 | 41 | CAP: 1206
1206-XP7-630 B-3,3 нФ+-10% |  | C1 | 1 | 42 | CAP: 1206
JRB-25В-220мкФ |  | C37 | 1 | 43 | CAP TH ALPOLY D8.00mm S3.50mm H12.00mm
JRB-25В-1000 мкФ |  | C28 | 1 | 44 | CAP TH ALUM ELEC D10.00mm S5.00mm H21.00mm
JRB-35В-470мкФ |  | C30 | 1 | 45 | CAP TH ALUM ELEC D10.00mm S5.00mm H17.00mm
JRB-50В-4,7мкФ |  | C7 | 1 | 46 | CAP TH ALUM ELEC D5.00mm S2.00mm H11.00mm
AD7691BRM |  | DA11 | 1 | 49 | 10-MSOP
AD8031BRZ | Rail-to-Rail I/O Amplifiers 2.7 V, 800 μA, 80 MHz | DA8 | 1 | 50 | 8-SOIC
ADA4941-1YRZ | Single-Supply, Differential, 18-Bit ADC Driver | DA7 | 1 | 52 | 8-SOIC
ADG431BR | LC2MOS Precision Quad SPST Switches | DA10 | 1 | 53 | 16-SOIC
ADG433BR | LC2MOS Precision Quad SPST Switches | DA6 | 1 | 54 | 16-SOIC
ADR434BR |  | DA4 | 1 | 55 | 8-SOIC
IN74HC00AD | Quad 2-Input NAND Gate High-Performance Silicon-Gate CMOS. | DD1 | 1 | 56 | 14-soic
IN74HC08AD | Quad 2-Input AND Gate High-Performance Silicon-Gate CMOS | DD2, DD6 | 2 | 62 | 14-SOIC
IN74HC139AD | Decoder/Demultiplexer Dual 2-to-4 | DD3 | 1 | 64 | 16-SOIC
IN74HC595AD | 8-Bit SIPO Register w/ Latch & 3-State | DD5 | 1 | 65 | 16-SOIC
TLV1842 | 40V, High-Speed Comparators | DA15 | 1 | 67 | 8-VSSOP
TLV9151IDR |  | DA3, DA12, DA14 | 3 | 68 | SOT-23-5
TLV9152IDR |  | DA2, DA13 | 2 | 69 | 8-SOIC
TPS7A3301 | TPS7A33 –36-V, 1-A, Ultralow-Noise Negative Voltage Regulator | DA19 | 1 | 70 | 20-VQFN
TPS7A4701 | TPS7A470x 36-V, 1-A, 4-µVRMS, RF LDO Voltage Regulator | DA16, DA17, DA18 | 3 | 71 | 20-VQFN
2027-09-B19 |  | FV1, FV2 | 2 | 75 | 2027-09-B19
SIL05-1A72-71L | Relay or Contactor | K1, K2, K3, K4, K5, K6, K7 | 7 | 76 | SIL051A7271L
УШЯИ.685442.092vs2Rel |  | K8 | 1 | 77 | УШЯИ.685442.092vs2Rel
0805-332 Ом+-0,1% |  | R27 | 1 | 78 | 0805
0805-1 кОм+-0,1% |  | R23, R24, R25, R26, R28, R49, R50, R51, R52 | 9 | 79 | 0805
1206-4,99 Ом+-0,1% |  | R5 | 1 | 80 | 1206
1206-10 Ом+-5% |  | R40 | 1 | 81 | 1206
1206-22 Ом+-5% |  | R17, R18 | 2 | 82 | 1206
1206-27 Ом+-5% |  | R7 | 1 | 83 | 1206
1206-51 Ом+-5% |  | R16, R32, R33 | 3 | 84 | 1206
1206-470 Ом+-5% |  | R12, R13, R15, R22, R29, R43, R46 | 7 | 85 | 1206
1206-499 Ом+-0,1% |  | R4 | 1 | 86 | 1206
1206-1 кОм+-0.1% |  | R36, R37, R38 | 3 | 87 | 1206
1206-1 кОм+-1% |  | R31 | 1 | 88 | 1206
1206-1,82 кОм+-0,1% |  | R41 | 1 | 89 | 1206
1206-2 кОм+-0.1% |  | R35 | 1 | 90 | 1206
1206-2,4 кОм+-5% |  | R47, R48 | 2 | 91 | 1206
1206-4,02 кОм+-0,1% |  | R34 | 1 | 92 | 1206
1206-4,7 кОм+-5% |  | R55 | 1 | 93 | 1206
1206-5,1 кОм+-5% |  | R20, R39 | 2 | 94 | 1206
1206-7,15 кОм+-1% |  | R44 | 1 | 95 | 1206
1206-9,09 кОм+-1% |  | R30 | 1 | 96 | 1206
1206-10 кОм+-0,5% |  | R45 | 1 | 97 | 1206
1206-10 кОм+-5% |  | R42 | 1 | 98 | 1206
1206-20 кОм+-5% |  | R21 | 1 | 99 | 1206
1206-91 кОм+-5% |  | R10 | 1 | 100 | 1206
1206-221 кОм+-1% |  | R57 | 1 | 101 | 1206
1206-510 кОм+-1% |  | R53, R54 | 2 | 102 | 1206
1206-1,24 МОм+-1% |  | R56 | 1 | 103 | 1206
1210-100 Ом+-5% |  | R11 | 1 | 104 | 1210
1210-1,1 кОм+-5% |  | R19 | 1 | 105 | 1210
OAR5-R050FLF |  | R6 | 1 | 106 | OAR5
WSL5931L5000FEA |  | R8, R9 | 2 | 107 | WSL5931L5000FEA
С2-29В-0,125-22 Ом +-0.1%-1,0-А | Резисторы постоянные непроволочные прецизионные С2-29В, производитель "АО"НПО"ЭРКОН""АО"НПО"ЭРКОН" | R2 | 1 | 108 | С2-29В-0,125(140.02.0202.00.00)
С2-29В-0,125-49,9 кОм +-0.1%-1,0-А | Резисторы постоянные непроволочные прецизионные С2-29В, производитель "АО"НПО"ЭРКОН""АО"НПО"ЭРКОН" | R3 | 1 | 109 | С2-29В-0,125(140.02.0202.00.00)
С2-29В-0,125-332 кОм+-0.1%-1,0-А | Резисторы постоянные непроволочные прецизионные С2-29В, производитель "АО"НПО"ЭРКОН""АО"НПО"ЭРКОН" | R14 | 1 | 110 | С2-29В-0,125(140.02.0202.00.00)
С2-29В-0,25-4,99 МОм +-0.1% | Резисторы постоянные непроволочные прецизионные С2-29В, производитель "АО"НПО"ЭРКОН""АО"НПО"ЭРКОН" | R1 | 1 | 111 | С2-29В-0,25(140.02.0204.00.00)
DRA282G |  | S1, S2 | 2 | 120
1N4007WS | General Purpose Plastic Rectifier | VD2, VD3, VD4, VD5 | 4 | 121 | SOD-323
1N4148WS | Small Signal Fast Switching Diod | VD1, VD6, VD7, VD8, VD9, VD10, VD11, VD12, VD13, VD22, VD23, VD24, VD25 | 13 | 122 | SOD-323F
V1P22 | Surface-Mount TMBS® (Trench MOS Barrier Schottky) Rectifier | VD14, VD15, VD16, VD17, VD18, VD19, VD20, VD21 | 8 | 123 | DO-219AD
FZT658 | FZT658 | VT1 | 1 | 124 | SOT-23-4
TR-1,25-4 | Клемма TR-1,25-4 | X1, X2, X3 | 3 | 130
280370-2 | Connector | XP2 | 1 | 131 | 280370-2
280371-2 | Connector | XP3 | 1 | 132 | 280371-2
DS1014-16SF1B | pitch 2mm, 16 pin 2x8, straight | XP1 | 1 | 133 | DS1014-16S
DS1074-5MVT6 |  | XP4 | 1 | 134 | DS1074-5MV
BNX022-01 |  | Z1, Z2, Z3 | 3 | 136 | BNX02
