Sasha7b9Work/LiniaServer/_Лисенков/Ватафа/Плата ИнтерфейсаПЕРЕЧЕНЬ.xlsx

Поз. | Name | Description | Буквенно-цифровое обозначение | Кол. | Manufacturer 1 | Manufacturer Part Number 1 | Manufacturer Lifecycle 1 | Supplier 1 | Supplier Part Number 1 | Supplier Unit Price 1 | Supplier Subtotal 1
10 | 0805-NP0-50 В-2,4 пФ-1% |  | C1, C2, C3, C7, C8 | 5
11 | 1206-С0G-50 B-56 пФ+-1% |  | C4, C5, C6, C9, C10 | 5
 | ADA4807-2ARMZ | 3.1 nV/√Hz, 1 mA, 180 MHz, Rail-to-Rail Input/Output Amplifiers | DA1, DA2, DA3, DA4, DA5 | 5
19 | 1206-5,23 кОм+-1% |  | R1, R2, R3, R13, R14 | 5
16 | 1206-140 Ом+-1% |  | R4, R5, R6, R15, R16 | 5
15 | 1206-102 Ом+-1% |  | R7, R8, R9, R18, R19 | 5
17 | 1206-215 Ом+-1% |  | R10, R11, R12, R20, R21 | 5
14 | 1206-30 Ом+-5% |  | R17, R22 | 2
18 | 1206-1 кОм+-5% |  | R23 | 1
22 | SFH203 | Silicon PIN Photodiode | VD1, VD2, VD3, VD4, VD5 | 5
 | VSMY2853RG | High Speed Infrared Emitting Diodes, 850 nm, Surface Emitter Technology | VD6, VD7 | 2
21 | BZX384-C4V7 |  | VD8 | 1
25 | BSS138BK | 60 V, 360 mA N-channel Trench MOSFET | VT1, VT2 | 2
 | DS1018-02-16B2 | pitch 2mm, 20 pin 2x10 | XP1 | 1
 | IDC2-16 | DS1017-16MA2 | XS1 | 1
