Sasha7b9Work/LiniaServer/_Лисенков/Ватафа/Плата оптоформировтеляПЕРЕЧЕНЬ.xlsx

Поз. | Name | Description | Буквенно-Цифровое обозначение | Кол. | Manufacturer 1 | Manufacturer Part Number 1 | Manufacturer Lifecycle 1 | Supplier 1 | Supplier Part Number 1 | Supplier Unit Price 1 | Supplier Subtotal 1
 | ADA4807-2ARMZ | 3.1 nV/√Hz, 1 mA, 180 MHz, Rail-to-Rail Input/Output Amplifiers | DA6, DA7 | 2
 | VSMY2853RG | High Speed Infrared Emitting Diodes, 850 nm, Surface Emitter Technology | VD1, VD2, VD3, VD4, VD5 | 5
10 | 0805-NP0-50 В-2,4 пФ-1% |  | C6, C7 | 2
11 | 0805-X7R-25 В-0,1 мкФ +-10% |  | C1, C2, C3, C4, C5 | 5
12 | 1206-С0G-50 B-56 пФ+-1% |  | C8, C9 | 2
14 | IN74HC00AD | Quad 2-Input NAND Gate High-Performance Silicon-Gate CMOS. | DD1 | 1
15 | 1206-5,23 кОм+-1% |  | R20, R21 | 2
15 | SN65HVD75D |  | DA1, DA2, DA3, DA4, DA5 | 5
16 | 0805-10 KОМ+-5% |  | R14 | 1
17 | 1206-30 Ом+-5% |  | R15, R16, R17, R18, R19 | 5
18 | 1206-100 Ом+-5% |  | R9, R10, R11, R12, R13 | 5
19 | 1206-102 Ом+-1% |  | R24, R25 | 2
20 | 1206-140 Ом+-1% |  | R22, R23 | 2
21 | 1206-215 Ом+-1% |  | R26, R27 | 2
22 | 1206-1 кОм+-5% |  | R1, R2, R3, R4, R5, R6, R7, R8 | 8
25 | SFH203 | Silicon PIN Photodiode | VD6, VD7 | 2
27 | BSS138BK | 60 V, 360 mA N-channel Trench MOSFET | VT1, VT2, VT3, VT4, VT5 | 5
28 | BH2-20R | pitch 2mm, 20 pin 2x10 | XP1 | 1
