Sasha7b9Work/LiniaServer/_Лисенков/Ватафа/УШЯИ 687253.017.xlsx

Line # | Name | Description | Designator | Quantity | Manufacturer 1 | Manufacturer Part Number 1 | Manufacturer Lifecycle 1 | Supplier 1 | Supplier Part Number 1 | Supplier Unit Price 1 | Supplier Subtotal 1
 | DS1021-1x2 |  |  | 1
3 | 0805-X7R-25 В-0,1 мкФ +-10% |  | C1, C2, C3, C4, C5, C6, C7, C8, C9, C10, C11, C12, C13, C14, C15, C16, C17, C18, C19, C20 | 20
6 | 1206-C0G-50 В-22 пФ +-5% |  | C21 | 1
 | 1206-X7R-50 B-100 пФ+-10% |  | C22, C23 | 2
2 | 0805-C0G-250 В-10 пФ +-5% |  | C24, C25, C27, C28, C32, C33 | 6
9 | 2220-X7R-250 В-1 мкФ +-10% |  | C26, C29, C30, C31 | 4
5 | 0805-X7R-25 В-1 мкФ +-10% |  | C34, C35 | 2
 | 220пФ NP0 1000В 5% 1206 |  | C36, C37 | 2
10 | ECR4R7M50B |  | C38, C39, C40 | 3
4 | 0805-X7R-25 В-0,33 мкФ +-10% |  | C41, C42, C43, C44, C47, C48, C49, C50, C51, C54 | 10
 | KM220M2EBKJ1020VBK | KM220M2EBKJ1020VBK, 22uF, 105C,10x20 | C45, C46 | 2
8 | 1206-X7R-50 B-22 пФ+-10% |  | C52, C53 | 2
19 | ADuM1100AR | iCoupler Digital Isolator | DA1, DA4, DA6, DA8, DA9, DA13 | 6
17 | ADM2486BRWZ | Isolated RS-485 Transceiver, 20 Mbps data rate, SOIC-16-W | DA2, DA3, DA5 | 3
18 | ADR435BRZ |  | DA7 | 1
 | AD5443YRM | 12-Bit High Bandwidth Multiplying DACs with Serial Interface 10-MSOP | DA10 | 1
 | ADA4084-2ARZ | 30 V, Low Noise, Rail-to-Rail Input/Output, Low Power Operational Amplifiers | DA11, DA12, DA19 | 3
16 | ADG433BR | LC2MOS Precision Quad SPST Switches | DA14 | 1
23 | PA340CC | High Voltage Power Operational Amplifier | DA15, DA16 | 2
 | TLV9152IDR |  | DA17, DA18 | 2
20 | IL311D | High Perfomance Voltage Comparartor | DA20, DA21 | 2
21 | IN74HC00AD | Quad 2-Input NAND Gate High-Performance Silicon-Gate CMOS. | DD1, DD3 | 2
22 | IN74HC20D | Dual 4-input NAND Gate CMOS | DD2 | 1
24 | TLP3549F |  | K1, K2 | 2
33 | 1206-1 кОм+-5% |  | R1, R2, R3, R4, R5, R6, R47, R56 | 8
28 | 1206-100 Ом+-5% |  | R7, R8, R9, R46 | 4
42 | 1206-12 кОм+-5% |  | R10, R11, R12, R53, R54 | 5
40 | 1206-10 кОм+-0,5% |  | R13, R15, R16 | 3
27 | 1206-100 Ом+-0,5% |  | R14 | 1
41 | 1206-12 кОм+-1% |  | R17 | 1
43 | 1206-15 кОм+-5% |  | R18, R52 | 2
26 | 1206-51 Ом+-5% |  | R19, R20, R48 | 3
45 | 1206-51 кОм+-5% |  | R21, R71, R72 | 3
34 | 1206-2 кОм+-0.5% |  | R22, R23, R59, R60 | 4
 | 0603-75 KОМ+-5% |  | R24 | 1
44 | 1206-20 кОм+-0.5% |  | R25, R26, R28, R29, R37, R38, R40, R41 | 8
 | 1206-75 кОм+-5% |  | R27 | 1
 | 1206-20 кОм+-5% |  | R30, R31 | 2
 | 1206-1 МОм+-5% |  | R32, R33 | 2
30 | 1206-240 Ом+-5% |  | R34, R36, R61, R62, R63, R64 | 6
 | 1206-1,2 кОм+-5% |  | R35, R39 | 2
36 | 1206-2,4 кОм+-5% |  | R42, R44 | 2
 | 1206-180 Ом+-5% |  | R45 | 1
 | 1206-10 Ом+-5% |  | R49, R50, R51 | 3
38 | 1206-6,98 кОм+-1% |  | R55 | 1
47 | 2512-1,2 кОм+-5% |  | R57, R58 | 2
32 | 1206-430 Ом+-5% |  | R65, R66 | 2
29 | 1206-150 Ом+-5% |  | R67 | 1
48 | 2512-5,6 кОм+-5% |  | R68, R69 | 2
35 | 1206-2 кОм+-5% |  | R70 | 1
31 | 1206-390 Ом+-5% |  | R73, R74 | 2
50 | W21-3W-680 Ом +-5% | W21-3W-680 Ом +-5% | R75, R76 | 2
49 | HS15-4R7-J |  | R77, R78 | 2
52 | 3362P-1-103LF | 3362 -1/4 ˝ Square Trimpot® Trimming Potentiometer | RP1 | 1
 | 3329H-1-102LF | Variable Resistor 1kOm | RP2, RP3 | 2
55 | 1N4148WS | Small Signal Fast Switching Diod | VD1, VD2, VD3, VD4 | 4
58 | BZX84C15LT1G |  | VD5, VD6, VD8, VD10 | 4
 | BZX84C6V2LT1G |  | VD9 | 1
54 | 1N4007WS | General Purpose Plastic Rectifier | VD11, VD12 | 2
60 | W04M | Диод W04M | VD13 | 1
59 | GSIB2540 | Диод GSIB2540 | VD14 | 1
 | BZT52C10 | Стабилитрон BZT52C10 | VD15, VD16 | 2
62 | ZXMN10A08E6TA | MOSFET, N, SOT-23-6; Transistor Type: MOSFET; Transistor Polarity: N; Voltage, Vds Typ: 100V; Current, Id Cont: 1.5A; | VT1 | 1
63 | ZXMP10A17E6TA | P-Channel 100 V 0.35 Ohm Power MOSFET Surface Mount - SOT-23-6 | VT2 | 1
 | IRF5210PBF |  | VT3 | 1
61 | IPA083N10N5XKSA1 | Single N-Channel 100 V 8.3 mOhm 37 nC OptiMOS Power Mosfet - TO-220-3 | VT4 | 1
 | BH2-20 | pitch 2mm, 20 pin 2x10 | XP1 | 1
68 | DS1021-1x3 | PLS-3, 2.54 pitch | XP2, XP3 | 2
66 | 280373-2 | Connector | XP4 | 1
65 | 280372-2 | Connector | XP5 | 1
69 | MNL-350810-1 |  | XP6 | 1
70 | Jumper, 2.54mm |  | XS1, XS2 | 2
0 | Лепесток |  | КТ1, КТ2, КТ3, КТ4, КТ5, КТ6, КТ7, КТ8, КТ9, КТ10, КТ11 | 11
