Sasha7b9Work/LiniaServer/_Лисенков/Ватафа/УШЯИ 687253.018.xlsx

Line # | Name | Description | Designator | Quantity | Manufacturer 1 | Manufacturer Part Number 1 | Manufacturer Lifecycle 1 | Supplier 1 | Supplier Part Number 1 | Supplier Unit Price 1 | Supplier Subtotal 1
 | B43640A2228M000 | Capacitor Polarised, 2200uF, 30x55 | C1, C2, C3, C4 | 4
 | OAR3-R005FI |  | R1, R2, R5, R6, R7, R8 | 6
 | С2-33Н-0,5-24 кОм +-5% | Резисторы постоянные непроволочные общего применения С2-33Н АИ, производитель "АО"НПО"ЭРКОН" | R3, R4 | 2
 | TR-3.5-4 | TR-3.5-4 клемма типа "O" | X1 | 1
 | 280373-2 | Connector | XP1 | 1
 | УШЯИ.685631.123 |  | XT1 | 1
