Sasha7b9Work/LiniaServer/_Лисенков/Ватафа/Формирователь Развертки УШЯИ.411522.033.xlsx

Line # | Name | Description | Designator | Quantity | Manufacturer 1 | Manufacturer Part Number 1 | Manufacturer Lifecycle 1 | Supplier 1 | Supplier Part Number 1 | Supplier Unit Price 1 | Supplier Subtotal 1
6 | 0805-X7R-25 В-0,1 мкФ +-10% |  | C1, C2, C3, C4, C5, C6, C7, C8, C9, C10, C11, C12, C13, C14, C15, C16, C17, C18, C19, C20, C52, C53, C54, C55, C56, C57, C58, C59 | 28
18 | 1206-X7R-50 B-0,01 мкФ+-10% |  | C21, C90 | 2
16 | 1206-X7R-50 B-1 нФ+-10% |  | C22, C73, C91 | 3
17 | 1206-X7R-50 B-5600 пФ+-10% |  | C23 | 1
15 | 1206-X7R-50 B-510 пФ+-10% |  | C24 | 1
10 | 1206-X7R-50 B-51 пФ+-10% |  | C25 | 1
22 | 1206-X7R-50 B-0,33 мкФ+-10% |  | C26, C27, C29, C35, C36, C38, C40, C42, C43, C44, C45, C46, C47, C67, C79, C80, C84, C85, C94, C98, C99 | 21
11 | 1206-X7R-50 B-100 пФ+-10% |  | C28, C31, C39, C41 | 4
14 | 1206-X7R-50 B-240 пФ+-10% |  | C30 | 1
29 | К73-17-63 В-0,47 мкФ +-5% |  | C32, C33 | 2
9 | 1206-X7R-50 B-33 пФ+-10% |  | C34, C86, C96 | 3
19 | 1206-X7R-50 B-39 нФ+-10% |  | C37 | 1
13 | 1206-X7R-50 B-150 пФ+-10% |  | C48, C49 | 2
20 | 1206-X7R-50 B-68 нФ+-10% |  | C50, C51 | 2
26 | ECR-35В-4,7 мкФ |  | C60, C62 | 2
25 | ECR-100В-2,2 мкФ |  | C61, C63 | 2
24 | CC45SL3JD470JYGNA | CC45 series | C64, C65, C66, C68, C69 | 5
21 | 1206-X7R-50 B-0,1 мкФ+-10% |  | C70, C72, C81, C82, C88, C97 | 6
12 | 1206-X7R-50 B-120 пФ+-10% |  | C71 | 1
28 | TZC3P200A110 | Подстроечный конденсатор 5-20пФ, 100В | C74 | 1
7 | 1206-NP0-50 B-10 пФ+-5% |  | C75 | 1
8 | 1206-X7R-50 B-22 пФ+-10% |  | C76 | 1
4 | 0805-NP0-50 В-2200 пФ +-1% |  | C77 | 1
3 | 0805-NP0-50 В-150 пФ +-1% |  | C78 | 1
2 | 0805-C0G-50 В-240 пФ +-5% |  | C83 | 1
5 | 0805-X5R-25 В-10 мкФ +-10% |  | C87 | 1
23 | 1206-X7R-50 B-2,2 мкФ+-10% |  | C89, C92, C93 | 3
27 | TAJA106K010RNJ | Cap Tant Solid 10uF 10V A CASE 10% | C95 | 1
38 | ADM2486BRWZ | Isolated RS-485 Transceiver, 20 Mbps data rate, SOIC-16-W | DA1, DA2, DA3, DA4, DA8, DA24, DA25, DA26 | 8
40 | ADuM1100AR | iCoupler Digital Isolator | DA5, DA6, DA7, DA9, DA10, DA23 | 6
 | IL358D | Ultraprecision, 36 V, 2.8 nV/√Hz Dual Rail-to-Rail Output Op Amp | DA11 | 1
33 | AD8671AR | Bias Current Operational Amplifiers, Precision, Very Low Noise, Low Input | DA12, DA16, DA22 | 3
41 | IL311D | High Perfomance Voltage Comparartor | DA13, DA14, DA15 | 3
 | AD5443YRM | 12-Bit High Bandwidth Multiplying DACs with Serial Interface 10-MSOP | DA17, DA36 | 2
34 | ADA4627-1ARZ | Bias Current Operational Amplifiers, Precision, Very Low Noise, Low Input | DA18, DA20, DA21 | 3
37 | ADG433BR | LC2MOS Precision Quad SPST Switches | DA19, DA29 | 2
46 | L78L06ACD13TR |  | DA27 | 1
39 | ADR434BR |  | DA28 | 1
 | ADA4627-1ARZ | 30 V, High Speed, Low Noise, Low Bias Current, JFET Operational Amplifier | DA30, DA33, DA37 | 3
32 | AD8031ARZ | Rail-to-Rail I/O Amplifiers 2.7 V, 800 μA, 80 MHz | DA31 | 1
35 | ADA4941-1YRZ | Single-Supply, Differential, 18-Bit ADC Driver | DA32 | 1
36 | ADG432BR | LC2MOS Precision Quad SPST Switches | DA34 | 1
31 | AD7691BRM |  | DA35 | 1
45 | IN74HC595AD | 8-Bit SIPO Register w/ Latch & 3-State | DD1 | 1
43 | IN74HC00AD | Quad 2-Input NAND Gate High-Performance Silicon-Gate CMOS. | DD2 | 1
44 | IN74HC08AD | Quad 2-Input AND Gate High-Performance Silicon-Gate CMOS | DD3 | 1
47 | Lepestok |  | KT1, KT2, KT3 | 3
47 | Lepestok |  | KT4 | 1
63 | 1206-1 кОм+-5% |  | R1, R2, R3, R4, R5, R6, R7, R8, R65, R66, R67, R68 | 12
55 | 1206-100 Ом+-5% |  | R9, R10, R11, R12, R17, R34, R69, R70, R71 | 9
80 | 1206-12 кОм+-5% |  | R13, R14, R15, R16, R18, R35, R47, R72, R73, R74 | 10
73 | 1206-7,5 кОм+-5% |  | R19 | 1
67 | 1206-2,2 кОм+-5% |  | R20 | 1
76 | 1206-10 кОм+-0,5% |  | R21, R23, R25, R26 | 4
82 | 1206-15 кОм+-5% |  | R22 | 1
92 | 1206-3 МОм+-5% |  | R24 | 1
66 | 1206-1,5 кОм+-5% |  | R27, R60, R61 | 3
56 | 1206-120 Ом+-5% |  | R28, R29 | 2
89 | 1206-560 кОм+-5% |  | R30, R31 | 2
71 | 1206-5,1 кОм+-5% |  | R32 | 1
88 | 1206-51 кОм+-5% |  | R33 | 1
64 | 1206-1,1 кОм+-5% |  | R36 | 1
68 | 1206-2,4 кОм+-5% |  | R37, R51, R54, R55 | 4
51 | 1206-15 Ом+-5% |  | R38 | 1
59 | 1206-330 Ом+-5% |  | R39 | 1
75 | 1206-9,53 кОм+-1% |  | R40 | 1
69 | 1206-4,32 кОм+-1% |  | R41 | 1
61 | 1206-510 Ом+-5% |  | R42, R43, R95, R99 | 4
62 | 1206-910 Ом+-5% |  | R44 | 1
77 | 1206-11 кОм+-5% |  | R45 | 1
79 | 1206-12 кОм+-1% |  | R46, R49 | 2
87 | 1206-47 кОм+-5% |  | R48 | 1
72 | 1206-6,8 кОм+-5% |  | R50, R52 | 2
65 | 1206-1,3 кОм+-5% |  | R53, R56 | 2
60 | 1206-470 Ом+-5% |  | R57, R58 | 2
94 | 2512-47 кОм+-5% |  | R59 | 1
57 | 1206-150 Ом+-5% |  | R62, R63 | 2
93 | 2512-5,1 Ом+-5% |  | R64 | 1
58 | 1206-240 Ом+-5% |  | R75 | 1
95 | С2-29В-2-2 МОм +-0.5%-1,0-А | Резисторы постоянные непроволочные прецизионные С2-29В, производитель "АО"НПО"ЭРКОН""АО"НПО"ЭРКОН" | R76, R77, R78, R79, R80 | 5
90 | 1206-1 МОм+-5% |  | R81 | 1
91 | 1206-2 МОм+-0,1% |  | R82 | 1
86 | 1206-40,2 кОм+-0,1% |  | R83 | 1
84 | 1206-24,9 кОм+-0,5% |  | R84, R85 | 2
50 | 1206-2,2 Ом+-5% |  | R86 | 1
85 | 1206-30 кОм+-0.1% |  | R87 | 1
78 | 1206-11,8 кОм+-0,1% |  | R88 | 1
70 | 1206-4,99 кОм+-0,1% |  | R89, R94 | 2
83 | 1206-20 кОм+-0,1% |  | R90, R93 | 2
74 | 1206-8,2 кОм+-5% |  | R91 | 1
81 | 1206-14 кОм+-0,1% |  | R92 | 1
 | 0805-32 кОм+-0,1% |  | R96 | 1
49 | 0805-6,04 кОм+-0,1% |  | R97 | 1
48 | 0805-2 кОм+-0,1% |  | R98 | 1
52 | 1206-22 Ом+-5% |  | R100 | 1
53 | 1206-24 Ом+-5% |  | R101 | 1
54 | 1206-33 Ом+-5% |  | R102, R103, R104 | 3
96 | 3329H-1-222LF | Variable Resistor 2.2kOm | RP1 | 1
98 | 3329H-1-472LF | Variable Resistor 4.7kOm | RP2, RP3 | 2
97 | 3329H-1-223LF | Variable Resistor 22kOm | RP4 | 1
100 | 1N4148WS | Small Signal Fast Switching Diod | VD1, VD2, VD3, VD4, VD5, VD6, VD14, VD15, VD16, VD17, VD18, VD21, VD22, VD23, VD24 | 15
101 | BZX55-C10 | Стабилитрон BZX55-C10 | VD7 | 1
99 | 1N4001WS | General Purpose Plastic Rectifier | VD8, VD9, VD19, VD20 | 4
102 | BZX55-C5V6 | Стабилитрон BZX55-C5V6 | VD10, VD11, VD25, VD26 | 4
103 | BZX55-C6V2 | Стабилитрон BZX55-C6V2 | VD12, VD13 | 2
104 | FZT658 | FZT658 | VT1, VT4 | 2
105 | FZT758 | FZT758 | VT2, VT3 | 2
106 | MJE5730 | N-Channel 300V 1A 50W | VT5, VT8, VT9 | 3
107 | TIP48 | NPN SWITCHING TRANSISTOR | VT6, VT7, VT10 | 3
111 | BH2-20 | pitch 2mm, 20 pin 2x10 | XP1, XP5 | 2
108 | 280371-2 | Connector | XP2 | 1
112 | DS1021-1x3 |  | XP3 | 1
109 | 280372-2 | Connector | XP4 | 1
110 | 280373-2 | Connector | XP6 | 1
 | 280358-0 | TE Connectivity 2,54mm for wire | XS1, XS3 | 2
114 | Jumper, 2.54mm |  | XS2 | 1
