Sasha7b9Work/LiniaServer/Блок базы - Подложки/Схема PDF/Спис.компон. плата УШЯИ.411618.029Э.xlsx

№ | Наименование | Корпус | Кол-во | Производитель
1 | Конденсатор SMD 10пФ 100В X7R 10% [0805] | C0805 | 17
2 | Конденсатор SMD 22пФ 100В X7R 10% [0805] | C0805 | 2
3 | Конденсатор SMD 100нФ 100В X7R 10% [0805] | C0805 | 39
4 | Конденсатор танталовый TECAP, 100мкФ, 10В, тип C | CASE-C_6032 | 1 | Kyocera AVX
5 | Конденсатор SMD 10мкФ 100В X7R 10% [0805] | C0805 | 1
6 | Конденсатор SMD 0.33мкФ 100В X7R 10% [0805] | C0805 | 2
7 | Конденсатор танталовый TECAP, 4.7мкФ, 35В, тип C | CASE-C_6032 | 1 | Kyocera AVX
8 | Конденсатор SMD 33пФ 100В X7R 10% [0805] | C0805 | 6
9 | Конденсатор SMD 5600пФ 100В X7R 10% [0805] | C0805 | 3
10 | Конденсатор SMD 47пФ 100В X7R 10% [0805] | C0805 | 2
11 | Конденсатор SMD 0,047мкФ 100В X7R 10% [0805] | C0805 | 1
12 | Конденсатор SMD 680пФ 100В X7R 10% [0805] | C0805 | 4
13 | Конденсатор SMD 9100пФ 100В X7R 10% [0805] | C0805 | 6
14 | Конденсатор SMD 1мкФ 100В X7R 10% [0805] | C0805 | 5
15 | Конденсатор SMD 1500пФ 100В X7R 10% [0805] | C0805 | 3
16 | Конденсатор SMD 2,2мкФ 100В X7R 10% [0805] | C0805 | 2
17 | Конденсатор SMD 68нФ 100В X7R 10% [0805] | C0805 | 2
18 | Конденсатор SMD 68нФ 250В X7R 10% [0805] | C0805 | 3
19 | Конденсатор электролитический ECAP (К50-35), 47мкФ, 250В, 105°C, 13x20, p:5мм |  | 2 | Chengx
20 | Конденсатор К10-17Б М47 33пФ NP0 5% [DIP] |  | 4
21 | Конденсатор К10-17Б М47 47пФ NP0 5% [DIP] |  | 3
22 | Конденсатор К10-17Б М47 0,022мкФ NP0 5% [DIP] |  | 1
23 | Конденсатор К10-17Б М47 10пФ NP0 5% [DIP] |  | 1
24 | Конденсатор К10-17Б М47 33пФ NP0 5% [DIP] |  | 1
25 | Конденсатор SMD 0,068мкФ 100В X7R 10% [0805] | C0805 | 4
26 | Конденсатор SMD 100пФ 100В X7R 10% [0805] | C0805 | 3
27 | Конденсатор SMD 51пФ 100В X7R 10% [0805] | C0805 | 3
28 | Конденсатор SMD 240пФ 100В X7R 10% [0805] | C0805 | 3
29 | Конденсатор SMD 6,8пФ 100В X7R 10% [0805] | C0805 | 1
30 | Конденсатор SMD 15пФ 100В X7R 10% [0805] | C0805 | 2
31 | Конденсатор SMD 0,33мкФ 100В X7R 10% [0805] | C0805 | 33
32 | Конденсатор SMD 100нФ В X7R 10% [0805] | C0805 | 2
33 | Конденсатор SMD 120пФ 100В X7R 10% [0805] | C0805 | 1
34 | Конденсатор электролитический ECAP (К50-35), 4.7мкФ, 100В, 105°C, 5x11, p:2мм |  | 3 | Chengx
35 | Конденсатор SMD 3300пФ 100В X7R 10% [0805] | C0805 | 1
36 | Источник опорного напряжения AD587KNZ [DIP-8] | PDIP-8 | 1 | Analog Devices
37 | Стабилизатор напряжения 78L06-300 [SOT-89] | SOT-89-3 | 1 | UMW
38 | Источник опопрного напряжения 4.096 V ADR434 [SOIC-8] | SOIC-8 | 1 | Analog Devices
39 | Коммутатор аналоговых сигналов ADG431BRZ [SOIC-16] | SOIC-16 | 4 | Analog Devices
40 | Цифроаналоговый преобразователь AD5531BRUZ [TSSOP-16] | TSSOP-16 | 1 | Analog Devices
41 | Коммутатор аналоговых сигналов ADG433BRZ [SOIC-16] | SOIC-16 | 3 | Analog Devices
42 | Операционный усилитель ADA4627-1BRZ [SOIC-8] | SOIC-8 | 3 | Analog Devices
43 | Операционный усилитель AD8031 [SOIC-8] | SOIC-8 | 1 | Analog Devices
44 | Дифференциальный драйвер 18-разрядных АЦП ADA4941-1YRZ [SOIC-8] | SOIC-8 | 1 | Analog Devices
45 | Дифференциальный АЦП АD7691 [MSOP-10] | MSOP-10 | 1 | Analog Devices
46 | Логическая функция 2И 74HC08D,653 [SO-14] | SOIC-14 | 1 | Nexperia
47 | Операционный усилитель PA340CC [TH] |  | 1 | Apex Microtechnology
48 | Операционный усилитель TLV9152IDR [SOIC-8] | SOIC-8 | 2 | TI
49 | Операционный усилитель TLV9151IDCKR [SC-70-5] | SC-70-5 | 1 | TI
50 | Операционный усилитель AD629BN [DIP-8] | PDIP-8 | 1 | Analog Devices
51 | Операционный усилитель AD8512ARZ [SOIC-8] | SOIC-8 | 1 | Analog Devices
52 | Операционный усилитель AD8271 [MSOP-10] | MSOP-10 | 1 | Analog Devices
53 | Цифроаналоговый преобразователь AD5300BRTZ [SOT-23-6] | SOT-23-6 | 1 | Analog Devices
54 | Операционный усилитель AD8672ARZ [SOIC-8] | SOIC-8 | 3 | Analog Devices
55 | Компаратор КР554СА3А [DIP-8] | DIP-8 | 2
56 | Операционный усилитель AD8671ARZ [SOIC-8] | SOIC-8 | 2 | Analog Devices
57 | Изолированный приемопередатчик ADM2486BRWZ-REEL [SOIC-16] | SOIC-16 | 6 | Analog Devices
58 | Высокоскоростной цифровой изолятор ADUM1100BRZ-RL7 [SOIC-8] | SOIC-8 | 7 | Analog Devices
59 | ПЛИС EPM3128ATC100-10N [TQFP-100] | TQFP-100 | 1 | Intel/Altera
60 | Разрядник газонаполненный B88069-X8870-B502 (A81-C90X) |  | 2 | TDK/EPCOS
61 | Дроссель LQH55DN101M01 [2220] | L2220 | 1 | muRata
62 | Резистор подстроечный 47кОм [3329H] | 3329H | 1 | BOCHEN
63 | Резистор 400Ом 0,125Вт 1% [0805] | R0805 | 2
64 | Резистор 150Ом 0,125Вт 1% [0805] | R0805 | 7
65 | Резистор 100Ом 0,125Вт 1% [0805] | R0805 | 19
66 | Резистор 12кОм 0,125Вт 1% [0805] | R0805 | 11
67 | Резистор 1кОм 0,125Вт 1% [0805] | R0805 | 6
68 | Резистор 100Ом 0,125Вт 1% [DIP] |  | 35
69 | Резистор 10кОм 0.25Вт 1% [1206] | R1206 | 14
70 | Резистор 4,99кОм 0.25Вт 1% [1206] | R1206 | 5
71 | Резистор 2,49кОм 0.25Вт 1% [1206] | R1206 | 2
72 | Резистор 9,09кОм 0.25Вт 1% [1206] | R1206 | 1
73 | Резистор 1кОм 0.25Вт 1% [1206] | R1206 | 2
74 | Резистор 120Ом 0.125Вт 1% [0805] | R0805 | 1
75 | Резистор 3,83кОм 0.25Вт 1% [1206] | R1206 | 2
76 | Резистор 40,2кОм 0.25Вт 1% [1206] | R1206 | 1
77 | Резистор 2кОм 0.25Вт 1% [1206] | R1206 | 2
78 | Резистор 402Ом 0.25Вт 1% [1206] | R1206 | 1
79 | Резистор 24,9кОм 0.25Вт 1% [1206] | R1206 | 2
80 | Резистор 11,8кОм 0.25Вт 1% [1206] | R1206 | 1
81 | Резистор 30,1кОм 0.25Вт 1% [1206] | R1206 | 1
82 | Резистор 20кОм 0.25Вт 1% [1206] | R1206 | 1
83 | Резистор 14кОм 0.25Вт 1% [1206] | R1206 | 1
84 | Резистор 33Ом 0,125Вт 1% [0805] | R1206 | 2
85 | Резистор 33Ом 0,125Вт 1% [0805] | R0805 | 6
86 | Резистор 22Ом 0,125Вт 1% [0805] | R0805 | 1
87 | Резистор 15Ом 0,125Вт 1% [0805] | R0805 | 1
88 | Резистор 4.6кОм 0,125Вт 1% [0805] | R0805 | 1
89 | Резистор 1.2кОм 0,125Вт 1% [0805] | R0805 | 2
90 | Резистор 1.8кОм 0,125Вт 1% [0805] | R0805 | 1
91 | Резистор 220Ом 0,125Вт 1% [0805] | R0805 | 4
92 | Резистор 22кОм 0,125Вт 1% [0805] | R0805 | 2
93 | Резистор 3кОм 0,125Вт 1% [0805] | R0805 | 4
94 | Резистор 2.4кОм 0,125Вт 1% [0805] | R0805 | 2
95 | Резистор 7.2кОм 0,125Вт 1% [0805] | R0805 | 2
96 | Резистор 18кОм 0,125Вт 1% [0805] | R0805 | 2
97 | Резистор 120Ом 0,125Вт 1% [0805] | R0805 | 2
98 | Резистор 240Ом 0.25Вт 1% [1206] | R0805 | 2
99 | Резистор 1кОм 0,125Вт 1% [0805] | R0805 | 2
100 | Резистор 300Ом 0,125Вт 1% [0805] | R0805 | 5
101 | Резистор 0.04Ом 30Вт 1% [TO-220-2] | TO-220-2 | 2
102 | Резистор 1.5кОм 0,125Вт 1% [0805] | R0805 | 2
103 | Резистор C2-29В-0,25 24кОм ±0,5% [DIP] |  | 1
104 | Резистор SM204031006FE 100МОм ±1%[DIP] |  | 1 | Ohmite
105 | Резистор RK1/4DCT52R1105F 11 МОм ±1% [DIP] |  | 1 | KOA Speer Electronics
106 | Резистор C2-29В-0,25 1 МОм ±0,5% [DIP] |  | 1
107 | Резистор C2-29В-0,25 100 кОм ±0,5% [DIP] |  | 1
108 | Резистор C2-29B-1 10 кОм ±0,5% [DIP] |  | 1
109 | Резистор C2-29B-1 1 кОм ±0,5% [DIP] |  | 1
110 | Резистор C2-29B-1 100 Ом ±0,5% [DIP] |  | 1
111 | Резистор C2-29B-2 10 Ом ±0,5% [DIP] |  | 1
112 | Резистор MP930-2.00-1% [TO-220-2] | TO-220-2 | 2 | Caddock
113 | Резистор MP930-0.20-1% [TO-220-2] | TO-220-2 | 2 | Caddock
114 | Резистор C2-29В-0,25 1,2кОм ±0,5% [DIP] |  | 1
115 | Резистор C2-29В-0,25 301кОм ±0,5% [DIP] |  | 1
116 | Резистор C2-29В-0,25 5.1кОм ±0,5% [DIP] |  | 1
117 | Резистор 91кОм 0,125Вт 1% [0805] | R0805 | 1
118 | Резистор C2-29В-0,25 2.4кОм ±0,5% [DIP] |  | 1
119 | Резистор C2-29В-0,25 51Ом ±0,5% [DIP] |  | 1
120 | Резистор C2-29В-0,25 22Ом ±0,5% [DIP] |  | 1
121 | Резистор 5,1кОм 0,125Вт 1% [0805] | R0805 | 5
122 | Резистор 4,7кОм 0,125Вт 1% [0805] | R0805 | 4
123 | Резистор 820Ом 0,125Вт 1% [0805] | R0805 | 4
124 | Резистор 2кОм 0,125Вт 1% [0805] | R0805 | 4
125 | Резистор 200кОм 0,125Вт 1% [0805] | R0805 | 3
126 | Резистор 40,2кОм 0.25Вт 1% [1206] | R0805 | 1
127 | Резистор 15кОм 0,125Вт 1% [0805] | R0805 | 1
128 | Резистор 10кОм 0,125Вт 1% [0805] | R0805 | 3
129 | Резистор 100кОм 0,125Вт 1% [0805] | R0805 | 1
130 | Резистор 4,02кОм 0.25Вт 1% [1206] | R1206 | 5
131 | Резистор 3,6кОм 0,125Вт 1% [0805] | R0805 | 1
132 | Резистор 110кОм 0,125Вт 1% [0805] | R0805 | 2
133 | Резистор 5,3кОм 0,125Вт 1% [0805] | R0805 | 1
134 | Резистор 51кОм 0,125Вт 1% [0805] | R0805 | 2
135 | Резистор 301кОм 0.25Вт 1% [1206] | R1206 | 2
136 | Резистор 470Ом 0,125Вт 1% [0805] | R0805 | 1
137 | Резистор 17,2кОм 0.25Вт 1% [1206] | R1206 | 2
138 | Резистор 10кОм 0.25Вт 1% [0805] | R0805 | 1
139 | Резистор 24кОм 0,125Вт 1% [0805] | R0805 | 1
140 | Резистор 3,3кОм 0,125Вт 1% [0805] | R0805 | 1
141 | Резистор 510Ом 0,125Вт 1% [0805] | R0805 | 2
142 | Резистор 240Ом 0,125Вт 1% [0805] | R0805 | 1
143 | Резистор 1,1кОм 0,125Вт 1% [0805] | R0805 | 3
144 | Резистор 22 кОм 0,125Вт 1% [0805] | R0805 | 2
145 | Резистор 330Ом 0,125Вт 1% [0805] | R0805 | 1
146 | Линейный регулятор напряжения LM1117GS-3.3 [SOT-223] | SOT-223-3 | 1 | HTC
147 | Светодиод FYLS-0805UYC [0805] | LED0805 | 8 | Ningbo Foryard Optoelectronics
148 | Светодиод FYLS-0805GC [0805] | LED0805 | 8 | Ningbo Foryard Optoelectronics
149 | Диод импульсный 1N4448 [SOD-123] | SOD-123 | 25 | YANGJIE
150 | Диод импульсный 1N4448 [DO-35] | DO-35 | 19 | onsemi
151 | Диод RS1M [SMA] (допускается замена на FR307 [DO-201AD]) | SMA/DO-214AC | 4 | Wild Goose(威谷)
152 | Диод КД2970А [TO-220AC] | TO-220AC | 2 | NH(纽航)
153 | Диод защитный 1.5KE56CA [DO-201AD/DO-27] | DO-201 | 1 | Littelfuse(美国力特)
154 | Стабилитрон MMSZ5230B 4.7В 0.5Вт [SOD123] | SOD-123 | 2 | CJ(江苏长电/长晶)
155 | Стабилитрон MMSZ5232B 5.6В 0.5Вт [SOD123] | SOD-123 | 4 | MCC(美微科)
156 | Диод JPAD50 [SOT-23] | SOT-23-3 | 4 | Calogic
157 | Стабилитрон MMSZ5223B 2.7В 0.5Вт [SOD123] | SOD-123 | 2 | CJ
158 | Стабилитрон MMSZ5234B 6.2В 0.5Вт [SOD123] | SOD-123 | 4 | CJ
159 | Транзистор полевой MOSFET N-канальный BSS138BK [SOT-23-3] | SOT-23-3 | 19 | ElecSuper(静芯)
160 | Транзистор DZTA92 PNP [SOT223] | SOT-223 | 10 | DIODES(美台)
161 | Транзистор DZTA42 NPN [SOT223] | SOT-223 | 10 | DIODES(美台)
162 | Транзистор FZT758 PNP [SOT223] | SOT-223 | 2 | DIODES(美台)
163 | Транзистор FZT658 NPN [SOT223] | SOT-223 | 1 | DIODES(美台)
164 | Транзистор ZXMN10A08E6 N-канал 100В 1.9А [SOT-23-6] | SOT-23-6 | 1 | VBsemi(微碧半导体)
165 | Транзистор ZXMP10A17E6 P-канал 100В 1.3А [SOT-23-6] | SOT-23-6 | 1 | DIODES(美台)
166 | Транзистор FQP13N10 N-канал 100В 12.8А [TO-220] | TO-220-3 | 1 | onsemi(安森美)
167 | Транзистор SFP9530 P-канал 100В 10.5А [TO-220] | TO-220-3 | 1 | onsemi
168 | Транзистор MJE5730G PNP [TO-220-3] | TO-220-3 | 1 | onsemi(安森美)
169 | Транзистор TIP48 NPN [TO-220-3] | TO-220-3 | 1 | onsemi(安森美)
170 | Транзистор DZT658 NPN [SOT223] | SOT-223 | 1 | DIODES(美台)
171 | Вилка на плату прямая BH2-20 (DS1014-20SF1B-B) 20pin шаг 2.00мм |  | 2 | CONNFLY
172 | Вилка на плату прямая BH-10 (DS1013-10S) 10pin шаг 2.54мм |  | 1 | CONNFLY
173 | Вилка на плату 826629-3 шаг 2.54мм |  | 3 | TE Connectivity
174 | Вилка на плату 280370-2 шаг 2.54мм |  | 3 | TE Connectivity
175 | Вилка на плату 280372-1 шаг 2.54мм |  | 1 | TE Connectivity
176 | Вилка на плату 280373-2 шаг 2.54мм |  | 1 | TE Connectivity
177 | Вилка на плату 280372-2 шаг 2.54мм |  | 1 | TE Connectivity
178 | Реле герконовое SIL05-1A72-71L [PCB] |  | 1 | STANDEXMEDER
179 | Реле герконовое DIP05-1A72-13L [PCB] |  | 13 | STANDEXMEDER
180 | Реле герконовое УШЯИ.685442.092 (1 контакт реле) |  | 1 | ОАО"МНИПИ"
181 | Реле герконовое УШЯИ.685442.092 (2 контакта реле) |  | 1 | ОАО"МНИПИ"
182 | Реле герконовое DIP05-1C90-51L [PCB] |  | 2 | STANDEXMEDER
183
184
