Sasha7b9Work/LiniaServer/1-Ведомости Ч3-88/Ч3-88-A.xls

 | Частотомер электронно-счётный
Наименование | Код ОКП | Обозн-е док-та | Поставщик | Куда входит | На изделие | В комплекте | На регулир. | Всего | Примечание
Устройства
Фильтр сетевой FN406-05-02 |  | (ОМТ) |  | УШЯИ.434774.020 | 1 |  |  | 1
Конденсаторы
Конденсатор К10-17б-М47-100 Пф+-10% |  | ОЖ0.460.172ТУ |  | УШЯИ.467444.080 | 1 |  |  | 1
Конденсатор К10-17б-Н90-0,033 мкФ+-10% |  | ОЖ0.460.172ТУ |  | УШЯИ.468166.024 | 1 |  |  | 1
Конденсатор К10-17б-Н90-0,33 мкФ |  | ОЖ0.460.172ТУ |  | УШЯИ.434774.020 | 5 |  |  | 5
Конденсатор К10-17б-Н90-1 мкФ |  | ОЖ0.460.172ТУ |  | УШЯИ.467444.080 | 1 |  |  | 1
Конденсатор К10-17б-Н90-0,033 мкФ |  | ОЖ0.460.172ТУ |  | УШЯИ.468166.024 | 60 |  |  | 60
 |  |  |  | УШЯИ.467444.080 | 15 |  |  | 15
 |  |  |  |  |  |  |  | 75
Конденсатор К10-17в-Н90-0,1 мкФ |  | ОЖ0.460.172ТУ |  | УШЯИ.468166.024 | 10 |  |  | 10
 |  |  |  | УШЯИ.468359.016 | 1 |  |  | 1
 |  |  |  | УШЯИ.468389.003 | 2 |  |  | 2
 |  |  |  |  |  |  |  | 13
Конденсатор К10-17в-Н90-1 мкФ |  |  |  | УШЯИ.468359.016 | 1 |  |  | 1
 |  |  |  | УШЯИ.467444.080 | 1 |  |  | 1
 |  |  |  |  |  |  |  | 2
Конденсатор МЧ1206-CG-2,2 Пф+-0,5%-50 В |  | ТУ РБ 07612048.001-94 |  | УШЯИ.468166.024 | 2 |  |  | 2
Конденсатор МЧ1206-CG-100 Пф+-10%-50 В |  | ТУ РБ 07612048.001-94 |  | УШЯИ.468166.024 | 4 |  |  | 4
Конденсатор МЧ1206-2F3-1000 Пф+80-20%-25 B |  | ТУ РБ 07612048.001-94 |  | УШЯИ.468153.004 | 2 |  |  | 2
Конденсатор МЧ1206-2F3-0,01 Пф+80-20%-25 B |  | ТУ РБ 07612048.001-94 |  | УШЯИ.468153.004 | 7 |  |  | 7
Конденсатор МЧ1206-2F3-0,033 Пф+80-20%-25 B |  | ТУ РБ 07612048.001-94 |  | УШЯИ.468166.024 | 2 |  |  | 2
Конденсатор МЧ1210-2D1-0,1 мкФ+20%-100 B |  | ТУ РБ 07612048.001-94 |  | УШЯИ.468166.024 | 2 |  |  | 2
Конденсатор МЧ1206-2F3-0,1 мкФ+80-20%-25 B |  | ТУ РБ 07612048.001-94 |  | УШЯИ.468153.004 | 12 |  |  | 12
Конденсатор танталовый А 6,3 В-2,2 мкФ |  | ТУ РБ 07612048.001-94 |  | УШЯИ.468153.004 | 4 |  |  | 4
 |  |  |  | УШЯИ.468166.024 | 15 |  |  | 15
 |  |  |  | УШЯИ.467444.080 | 1 |  |  | 1
 |  |  |  | УШЯИ.468389.003 | 2 |  |  | 2
 |  |  |  |  |  |  |  | 22
Конденсатор танталовый А 6,3 В-4,7 мкФ |  |  |  | УШЯИ.468153.004 | 1 |  |  | 1
Конденсатор танталовый В 6,3 В-4,7 мкФ |  |  |  | УШЯИ.468359.016 | 1 |  |  | 1
Конденсатор танталовый В 6,3 В-10 мкФ |  |  |  | УШЯИ.468166.024 | 3 |  |  | 3
Конденсатор танталовый С 16 В-10 мкФ |  |  |  | УШЯИ.468166.024 | 1 |  |  | 1
Конденсатор RSM 037-6,3 B-10000 мкФ |  | (Philips) |  | УШЯИ.468166.024 | 2 |  |  | 2
Конденсатор RSM 037-16 B-220 мкФ |  | (Philips) |  | УШЯИ.434774.020 | 5 |  |  | 5
 |  |  |  | УШЯИ.467444.080 | 1 |  |  | 1
 |  |  |  |  |  |  |  | 6
Конденсатор RSM 037-16 B-470 мкФ |  | (Philips) |  | УШЯИ.468166.024 | 2 |  |  | 2
Конденсатор RSM 037-16 B-2200 мкФ |  | (Philips) |  | УШЯИ.434774.020 | 2 |  |  | 2
Конденсатор RSM 037-16 B-4700 мкФ |  | (Philips) |  | УШЯИ.434774.020 | 1 |  |  | 1
 |  |  |  | УШЯИ.468166.024 | 1 |  |  | 1
 |  |  |  |  |  |  |  | 2
Конденсатор RSM 037-16 B-10000 мкФ |  | (Philips) |  | УШЯИ.434774.020 | 1 |  |  | 1
Конденсатор RSM 037-25 B-1000 мкФ |  | (Philips) |  | УШЯИ.434774.020 | 1 |  |  | 1
Схемы интегральные, микросборки
Микросхема 74LVC1G125W5 |  | (DIODES) |  | УШЯИ.468166.024 | 1 |  |  | 1
Микросхема АФ011В |  | УШЯИ.431268.007 ТУ |  | УШЯИ.468166.024 | 2 |  |  | 2
Микросхема ГК-172-ТС-5М-5Е-9/HR-B-12 B-КМ0П-Z25 мм |  | (ОАО "Марион") |  | УШЯИ.468166.024 | 1 |  |  | 1
Микросхема AD5301BRM |  | (Analog Device) |  | УШЯИ.468166.024 | 3 |  |  | 3
Микросхема AD790AQ |  | (Analog Device) |  | УШЯИ.468166.024 | 1 |  |  | 1
Микросхема ADN2892ACPZ |  | (Analog Device) |  | УШЯИ.468153.004 | 1 |  |  | 1
Микросхема CP2102 |  | АльфаСофт |  | УШЯИ.468359.016 | 1 |  |  | 1
Микросхема C8051F310 |  | Cygnal |  | УШЯИ.468166.024 | 1 |  |  | 1
Микросхема EP3C5E144I7 |  | (Altera) |  | УШЯИ.468166.024 | 1 |  |  | 1
Микросхема EPM3256ATC144-10 |  | (Altera) |  | УШЯИ.467444.080 | 1 |  |  | 1
Микросхема EPCS4SI8 |  | (Altera) |  | УШЯИ.468166.024 | 1 |  |  | 1
Микросхема L4940V12 |  | (STMicroelectronics) |  | УШЯИ.434774.020 | 1 |  |  | 1
Микросхема L4941BV |  | (STMicroelectronics) |  | УШЯИ.434774.020 | 3 |  |  | 3
Микросхема LD1117AS12TR |  | (STMicroelectronics) |  | УШЯИ.468166.024 | 1 |  |  | 1
Микросхема LD1117AS25TR |  | (STMicroelectronics) |  | УШЯИ.468166.024 | 1 |  |  | 1
Микросхема LM1117IMPX-3.3 |  | (National Semiconductor) |  | УШЯИ.468153.004 | 1 |  |  | 1
 |  |  |  | УШЯИ.468166.024 | 1 |  |  | 1
 |  |  |  | УШЯИ.467444.080 | 1 |  |  | 1
 |  |  |  |  |  |  |  | 3
Микросхема LM2990-5.0 |  | (Texas Instruments) |  | УШЯИ.434774.020 | 1 |  |  | 1
Микросхема MC10EL33D |  | ON Semiconductor |  | УШЯИ.468153.004 | 2 |  |  | 2
Микросхема OP295GS |  | Analog Device |  | УШЯИ.468166.024 | 2 |  |  | 2
Микросхема OPA656U |  | Burr-Brown |  | УШЯИ.468166.024 | 2 |  |  | 2
Микросхема PIC18F452-I/PT |  | Microchip |  | УШЯИ.467444.080 | 1 |  |  | 1
Микросхема REF195GS |  | Analog Devices |  | УШЯИ.468166.024 | 1 |  |  | 1
Микросхема SY55855VKI |  | MICREL |  | УШЯИ.468153.004 | 1 |  |  | 1
 |  |  |  | УШЯИ.468166.024 | 2 |  |  | 2
 |  |  |  |  |  |  |  | 3
Микросхема W005M |  | (Philips) |  | УШЯИ.434774.020 | 5 |  |  | 5
Разрядники, предохранители, устройства защитные
Вставка плавкая ВП2Б-1В 0.5 А 250 В |  | 0Ю0.481.005ТУ |  | УШЯИ.411186.005 | 2 |  |  | 2
 |  |  |  | УШЯИ.305654.081 |  |  | 2 | 2
 |  |  |  |  |  |  |  | 4
Устройства индикационные и сигнальные
Светодиодный индикатор HDSP-H103 |  | Hewlett-Packard |  | УШЯИ.468389.003 | 9 |  |  | 9
Реле, контакторы, пускатели
Реле TQ1-SA-5 V |  | (Panasonic) |  | УШЯИ.468166.024 | 8 |  |  | 8
Катушки индуктивности, дроссели
Дроссель LQY31CNR22M03 0.22u |  | Murata |  | УШЯИ.468166.024 | 6 |  |  | 6
Резисторы
Резистор С2-29В-0,125-2.61 кОм+-1%-1.0-А |  | ОЖО.467.130ТУ |  | УШЯИ.468166.024 | 2 |  |  | 2
Резистор С2-29В-0,125-2.74 кОм+-1%-1.0-А |  | ОЖО.467.130ТУ |  | УШЯИ.468166.024 | 2 |  |  | 2
Резистор С2-33Н-0,125-100 Ом+-5%-А-Г-В |  | ОЖО.467.173ТУ |  | УШЯИ.468166.024 | 1 |  |  | 1
Резистор С2-33Н-0,125-200 Ом+-5%-А-Г-В |  | ОЖО.467.173ТУ |  | УШЯИ.468166.024 | 1 |  |  | 1
Резистор С2-33Н-0,125-1 кОм+-5%-А-Г-В |  | ОЖО.467.173ТУ |  | УШЯИ.468166.024 | 7 |  |  | 7
 |  |  |  | УШЯИ.467444.080 | 4 |  |  | 4
 |  |  |  |  |  |  |  | 11
Резистор С2-33Н-0,125-2.7 кОм+-5%-А-Г-В |  | ОЖО.467.173ТУ |  | УШЯИ.468166.024 | 2 |  |  | 2
Резистор С2-33Н-0,125-4.7 кОм+-5%-А-Г-В |  | ОЖО.467.173ТУ |  | УШЯИ.468166.024 | 1 |  |  | 1
 |  |  |  | УШЯИ.467444.080 | 1 |  |  | 1
 |  |  |  |  |  |  |  | 2
Резистор С2-33Н-0,125-6.8 кОм+-10%-А-Г-В |  | ОЖО.467.173ТУ |  | УШЯИ.467444.080 | 1 |  |  | 1
Резистор С2-33Н-0,125-22 кОм+-5%-А-Г-В |  | ОЖО.467.173ТУ |  | УШЯИ.467444.080 | 1 |  |  | 1
Резистор SMD-0805 51 Ом+-5% |  |  |  | УШЯИ.468153.004 | 6 |  |  | 6
Резистор SMD-0805 68 Ом+-5% |  |  |  | УШЯИ.468166.024 | 3 |  |  | 3
Резистор SMD-0805 100 Ом+-1% |  |  |  | УШЯИ.468166.024 | 5 |  |  | 5
Резистор SMD-0805 100 Ом+-5% |  |  |  | УШЯИ.468166.024 | 5 |  |  | 5
Резистор SMD-0805 360 Ом+-5% |  |  |  | УШЯИ.468389.003 | 8 |  |  | 8
Резистор SMD-0805 270 Ом+-5% |  |  |  | УШЯИ.468166.024 | 1 |  |  | 1
Резистор SMD-0805 470 Ом+-5% |  |  |  | УШЯИ.468389.003 | 21 |  |  | 21
Резистор SMD-0805 1 кОм+-5% |  |  |  | УШЯИ.468153.004 | 1 |  |  | 1
 |  |  |  | УШЯИ.468166.024 | 12 |  |  | 12
 |  |  |  |  |  |  |  | 13
Резистор SMD-0805 2 кОм+-5% |  |  |  | УШЯИ.468166.024 | 2 |  |  | 2
Резистор SMD-0805 4.7 кОм+-5% |  |  |  | УШЯИ.468153.004 | 1 |  |  | 1
 |  |  |  | УШЯИ.468166.024 | 1 |  |  | 1
 |  |  |  | УШЯИ.468389.003 | 9 |  |  | 9
 |  |  |  |  |  |  |  | 11
Резистор SMD-0805 10 кОм+-5% |  |  |  | УШЯИ.468153.004 | 1 |  |  | 1
 |  |  |  | УШЯИ.468166.024 | 4 |  |  | 4
 |  |  |  | УШЯИ.468389.003 | 22 |  |  | 22
 |  |  |  |  |  |  |  | 27
Резистор SMD-1206 39 Ом+-1% |  |  |  | УШЯИ.468166.024 | 6 |  |  | 6
Резистор SMD-1206 39 Ом+-5% |  |  |  | УШЯИ.468166.024 | 4 |  |  | 4
Резистор SMD-1206 51 Ом+-1% |  |  |  | УШЯИ.468166.024 | 2 |  |  | 2
Резистор SMD-1206 100 Ом+-1% |  |  |  | УШЯИ.468166.024 | 7 |  |  | 7
Резистор SMD-1206 200 Ом+-1% |  |  |  | УШЯИ.468166.024 | 2 |  |  | 2
Резистор SMD-1206 510 Ом+-1% |  |  |  | УШЯИ.468166.024 | 1 |  |  | 1
Резистор SMD-1206 750 Ом+-1% |  |  |  | УШЯИ.468166.024 | 2 |  |  | 2
Резистор SMD-1206 1 кОм+-1% |  |  |  | УШЯИ.468166.024 | 4 |  |  | 4
Резистор SMD-1206 100 кОм+-1% |  |  |  | УШЯИ.468166.024 | 2 |  |  | 2
Резистор SMD-1206 100 кОм+-5% |  |  |  | УШЯИ.468166.024 | 2 |  |  | 2
Резистор SMD-1206 910 кОм+-1% |  |  |  | УШЯИ.468166.024 | 4 |  |  | 4
Резистор TS53YL-200 Ом |  | Vishay |  | УШЯИ.468166.024 | 2 |  |  | 2
Устройства коммутационные
Кнопка B3W-1050 |  | OMRON |  | УШЯИ.468389.003 | 22 |  |  | 22
Переключатель SWR45 |  | АльфаСофт |  | УШЯИ.411186.005 | 1 |  |  | 1
Приборы электровакумные, полупроводниковые
Диод КД522Б |  | Др3.362.029ТУ |  | УШЯИ.467444.080 | 1 |  |  | 1
Диод BAV99 |  | NXP |  | УШЯИ.468166.024 | 2 |  |  | 2
Диод LL4148 |  | ТУ РБ 077601.004-94 |  | УШЯИ.468166.024 | 4 |  |  | 4
Диод BZV86-2V0 |  | Philips |  | УШЯИ.468166.024 | 4 |  |  | 4
Светодиод LH-2040 |  | Бурый медведь |  | УШЯИ.468389.003 | 21 |  |  | 21
Транзистор КТ3130А9 |  | Аа0.336.448ТУ |  | УШЯИ.468389.003 | 9 |  |  | 9
Транзистор 2N7002 |  | NXP Semiconductors |  | УШЯИ.468166.024 | 8 |  |  | 8
Транзистор КТ368БМ |  | Аа0.336.025ТУ |  | УШЯИ.468166.024 | 1 |  |  | 1
Соединения контактные
Вилка кабельная BNC-46-239-97 |  | ELFA |  | УШЯИ.685631.114 | 4 |  |  | 4
Вилка Flange Fixine F (428-772) |  | Farnell |  | УШЯИ.411186.005 | 1 |  |  | 1
Вилка PLD-10 |  | Белконтмаш |  | УШЯИ.467774.080 | 1 |  |  | 1
 |  |  |  | УШЯИ.468166.024 | 1 |  |  | 1
 |  |  |  |  |  |  |  | 2
Вилка PLD-40 |  | Белконтмаш |  | УШЯИ.467774.080 | 2 |  |  | 2
Вилка PLS-5 |  | Белконтмаш |  | УШЯИ.467774.080 | 1 |  |  | 1
Вилка BH-10 |  | Белконтмаш |  | УШЯИ.468166.024 | 1 |  |  | 1
Вилка BH-16 |  | Белконтмаш |  | УШЯИ.468166.024 | 1 |  |  | 1
 |  |  |  | УШЯИ.467774.080 | 1 |  |  | 1
 |  |  |  |  |  |  |  | 2
Вилка WF-4 |  | Белконтмаш |  | УШЯИ.467774.080 | 1 |  |  | 1
 |  |  |  | УШЯИ.468166.024 | 1 |  |  | 1
 |  |  |  |  |  |  |  | 2
Вилка WF-6 |  | Белконтмаш |  | УШЯИ.434774.020 | 1 |  |  | 1
Контакт 216843-1 |  | Белконтмаш |  | УШЯИ.434774.020 | 2 |  |  | 2
Вилка MW-4M |  | Белконтмаш |  | УШЯИ.468166.024 | 1 |  |  | 1
Лепесток BNC-46-269-17 |  |  |  | УШЯИ.411186.005 | 2 |  |  | 2
 |  |  |  | УШЯИ.468166.024 | 2 |  |  | 2
 |  |  |  |  |  |  |  | 4
Розетка BNC-46-265-29 |  |  |  | УШЯИ.411186.005 | 2 |  |  | 2
 |  |  |  | УШЯИ.468166.024 | 3 |  |  | 3
 |  |  |  |  |  |  |  | 5
Розетка PBD-40 |  | Белконтмаш |  | УШЯИ.468389.003 | 2 |  |  | 2
Розетка IDC-16 |  | Белконтмаш |  | УШЯИ.411186.005 | 2 |  |  | 2
Розетка MU-4F |  | Белконтмаш |  | УШЯИ.434774.020 | 1 |  |  | 1
Розетка HU-4 |  | Белконтмаш |  | УШЯИ.434774.020 | 1 |  |  | 1
 |  |  |  | УШЯИ.468359.016 | 1 |  |  | 1
 |  |  |  |  |  |  |  | 2
Розетка HU-6 |  | Белконтмаш |  | УШЯИ.468166.024 | 1 |  |  | 1
Розетка USBB-1J |  | Белконтмаш |  | УШЯИ.468359.016 | 1 |  |  | 1
Соединитель 1-21-06-УЗ |  | ГОСТ25671-83 |  | УШЯИ.411186.005 | 4 |  |  | 4
Соединитель 1-31-06-УЗ |  | ГОСТ25671-83 |  | УШЯИ.411186.005 | 4 |  |  | 4
Клемный изолятор DR250-25-26-18 |  |  |  | УШЯИ.411186.005 | 8 |  |  | 8
Прочие элементы
Кабель USB (п-п) тип А-В, 1,8 м |  | Белконтмаш |  | УШЯИ.305654.081 | 1 |  |  | 1
Шнур сетевой RKK/H5VV-F |  |  |  | УШЯИ.305654.081 |  | 1 |  | 1
Контакт-диск (CD-R) 700 Мб |  |  |  | УШЯИ.305654.081 |  | 1 |  | 1
Прокладка AL0220 |  |  |  | УШЯИ.434774.020 | 5 |  |  | 5
Стяжка для кабеля CV-075 |  | Белконтмаш |  | УШЯИ.411186.005 | 5 |  |  | 5
Площадка самоклеющаяся FC-15 |  | Белконтмаш |  | УШЯИ.411186.005 | 1 |  |  | 2
Прокладки самоклеющаяся НС-0 |  |  |  | УШЯИ.434774.020 | 2 |  |  | 2
Примечание - Допускается замена соединителей 1-21-06-УЗ на гнёзда ножевые изолированные ТАI4.8-125I (4.8 мм)
а соедиителей 1-31-06-УЗ на гнёзда ножевые изолированные TAI-1.25I (6.3 мм) (Бурый медведь - 2006, стр 164).
