Sasha7b9Work/LiniaServer/Инвентаризация/Петрович А.Г.  мат.ценности на 10.08.2026г.xls

ИНВЕНТАРИЗАЦИОННАЯ ОПИСЬ №
по состоянию на 10.08.2026 г.
Предприятие (учреждение) |  |  | ОАО "МНИПИ" РБ
Структурная единица предприятия (учреждения)
Основание для проведения инвентаризации: приказ, постановление, распоряжение (ненужное зачеркнуть) |  |  |  |  |  |  | Дата
Дата |  |  | 10.08.2026 |  |  |  | Номер
Дата начала инвентаризации
Дата окончания инвентаризации
Номер счета бухгалтерского учета |  |  | 01.1, 01.3, 01.4, 01.5, 01.6, 01.7, 01.8, 03.1, 03.2, 03.3, 03.30, 08.1.1, 08.1.2, 08.2.1, 08.2.2, 08.3, 001.1, 001.2, 011.1, 011.2, 08.15, 04.1, 04.2, 08.4.1, 08.4.2, 07.1, 07.2, 07.3, 10.1, 10.2, 10.3, 10.4, 10.5, 10.6, 10.9, 10.10, 10.12, 20.3, 21.1, 41.1, 41.3, 41.4, 41.5, 41.6, 43.1, 47.1, 002, 003, 004, 005, 041, 10.8, 10.11, 10.19
ТМЦ
Местонахождение
РАСПИСКА
К началу проведения инвентаризации все расходные и приходные документы на ценности сданы в бухгалтерию и все ценности, поступившие на мою (нашу) ответственность, оприходованы, а выбывшие списаны в расход.
Лицо(а), ответственное(ые) за сохранность ценностей:
Начальник отдела |  |  |  |  |  | Петрович А.Г.
(должность) |  |  |  | (подпись) |  | (расшифровка подписи)
№ п/п | Код ТМЦ | Товарно-материальные ценности | Единица измерения | Цена, руб. коп. | Фактическое наличие |  | По данным бухгалтерского учета
 |  |  |  |  | Количество | Стоимость, руб. коп. | Количество | Стоимость, руб. коп.
1 | 2 | 3 | 4 | 5 | 6 | 7 | 8 | 9
Отдел радиоэлектронных приборов и систем |  |  |  |  |  |  | 6 | 8795.43
1 | 70125 | Генератор сигналов DG4062 | шт. | 1521.31 |  |  | 1 | 1521.31
2 | 70254 | Генератор сигналов Г6-49 | шт. | 4436.02 |  |  | 1 | 4436.02
3 | 77577 | Принтер HP Laser Jet 1150 | шт. | 99.28 |  |  | 1 | 99.28
4 | 77601 | Принтер лазерный Sumsung ML-1610 | шт. | 34.01 |  |  | 1 | 34.01
5 | 77725 | ПЭВМ Старт.1(Е3200/DDR3 2Gb/HDD 500Gb/MB/ DVD-RW/400W S/n 6015),монитор Philips 22* 221V2SB/01, мышь Defender Flagman | шт. | 2169.63 |  |  | 1 | 2169.63
6 | 77790 | ПЭВМ "N-Tech-A-X", монитор 19”ViewSonic, клавиатура, мышь | шт. | 535.18 |  |  | 1 | 535.18
Итого по счету 01.1.1 |  |  |  |  |  |  | 6 | 8795.43
Отдел радиоэлектронных приборов и систем (ОРЭПиС) |  |  |  |  |  |  | 1 | 56.29
7 | 5479210 | Сквозное проектирование функциональных узлов РЭС на печатных платах AItium Designer | шт | 56.29 |  |  | 1 | 56.29
Итого по счету 10.12 |  |  |  |  |  |  | 1 | 56.29
МБП |  |  |  |  |  |  | 26 | 1491.39
8 | 135 | Стеллаж НН578 | шт | 0.01 |  |  | 1 | 0.01
9 | 136 | Стеллаж НН578 | шт | 0.01 |  |  | 1 | 0.01
10 | 1370076 | Эмулятор PG164130 | шт | 91.24 |  |  | 1 | 91.24
11 | 1700384 | Электрочайнмк Braun | шт | 6.98 |  |  | 1 | 6.98
12 | 1700425 | Телефонный аппарат Аттел-207 | шт | 5.06 |  |  | 1 | 5.06
13 | 4156 | Стулья п\м 4156 | шт | 1.38 |  |  | 4 | 5.53
14 | 4196 | Стенд нормативн документ 4196 | шт | 5.93 |  |  | 1 | 5.93
15 | 4197 | Стенд охрана труда 4197 | шт | 5.93 |  |  | 1 | 5.93
16 | 5148009 | Шкаф | шт | 88.00 |  |  | 1 | 88.00
17 | 5148013 | Стол компьютерный 1500/1500/750 | шт | 29.60 |  |  | 2 | 59.20
18 | 5400006 | Тумба | шт | 28.22 |  |  | 4 | 112.88
19 | 5400007 | Стол | шт | 249.43 |  |  | 4 | 997.73
20 | 5400054 | Тумба | шт | 28.22 |  |  | 4 | 112.89
Итого по счету 10.19 |  |  |  |  |  |  | 26 | 1491.39
Итого по описи:
количество порядковых номеров: двадцать ;
общее количество единиц фактически:
на сумму, руб. коп., фактически:
Председатель комиссии:
Члены комиссии:
Все ценности, поименованные в настоящей инвентаризационной описи с № 1 по № 20, комиссией проверены в натуре в моем (нашем) присутствии и внесены в опись, в связи с чем претензий к инвентаризациионной комиссии не имею (не имеем). Ценности перечисленные в описи, находятся на моем (нашем) ответственном хранении.
Лицо(а), ответственное(ые) за сохранность ценностей:
 |  | Начальник отдела |  |  | Петрович А.Г.
Указанные в настоящей описи данные и подсчеты проверил:
