Sasha7b9Work/LiniaServer/Инвентаризация/Шутов Ю.Д.  мат.ценности на 10.08.2026г.xls

ИНВЕНТАРИЗАЦИОННАЯ ОПИСЬ №
по состоянию на 10.08.2026 г.
Предприятие (учреждение) |  |  | ОАО "МНИПИ" РБ
Структурная единица предприятия (учреждения)
Основание для проведения инвентаризации: приказ, постановление, распоряжение (ненужное зачеркнуть) |  |  |  |  |  |  | Дата
Дата |  |  | 10.08.2026 |  |  |  | Номер
Дата начала инвентаризации
Дата окончания инвентаризации
Номер счета бухгалтерского учета |  |  | 01.1, 01.3, 01.4, 01.5, 01.6, 01.7, 01.8, 03.1, 03.2, 03.3, 03.30, 08.1.1, 08.1.2, 08.2.1, 08.2.2, 08.3, 001.1, 001.2, 011.1, 011.2, 08.15, 04.1, 04.2, 08.4.1, 08.4.2, 07.1, 07.2, 07.3, 10.1, 10.2, 10.3, 10.4, 10.5, 10.6, 10.9, 10.10, 10.12, 20.3, 21.1, 41.1, 41.3, 41.4, 41.5, 41.6, 43.1, 47.1, 002, 003, 004, 005, 041, 10.8, 10.11, 10.19
ТМЦ
Местонахождение
РАСПИСКА
К началу проведения инвентаризации все расходные и приходные документы на ценности сданы в бухгалтерию и все ценности, поступившие на мою (нашу) ответственность, оприходованы, а выбывшие списаны в расход.
Лицо(а), ответственное(ые) за сохранность ценностей:
Ведущий инженер-конструктор |  |  |  |  |  | Шутов Ю.Д.
(должность) |  |  |  | (подпись) |  | (расшифровка подписи)
№ п/п | Код ТМЦ | Товарно-материальные ценности | Единица измерения | Цена, руб. коп. | Фактическое наличие |  | По данным бухгалтерского учета
 |  |  |  |  | Количество | Стоимость, руб. коп. | Количество | Стоимость, руб. коп.
1 | 2 | 3 | 4 | 5 | 6 | 7 | 8 | 9
Отдел радиоэлектронных приборов и систем |  |  |  |  |  |  | 10 | 40108.63
1 | 54484 | паяльная станция Quick967ESD (60Вт,24В) | шт. | 183.40 |  |  | 1 | 183.40
2 | 69904 | Калибратор осциллографов 955/1100 с одной активной | шт. | 15850.05 |  |  | 1 | 15850.05
3 | 69989 | Измеритель иммитанса Е7-20 | шт. | 624.05 |  |  | 1 | 624.05
4 | 70005 | Осциллограф MSO 6102 A в комплекте | шт. | 20217.18 |  |  | 1 | 20217.18
5 | 77630 | Принтер HP Laser Jet 1018 | шт. | 36.94 |  |  | 1 | 36.94
6 | 77651 | МВЭП MaxSelect AMD Athlon 3200 М-р Philips170S77FS | шт. | 440.72 |  |  | 1 | 440.72
7 | 77670 | ПЭВМ TAO(AMD Athlon3800/DDR1024Mb/HDD250Gb/DVd-RW/ | шт. | 658.53 |  |  | 1 | 658.53
8 | 77674 | ПЭВМ PROFIT, AMD 64 3600+/MBSoc AM2/RAM1024Mb/YDD8 | шт. | 462.23 |  |  | 1 | 462.23
9 | 77698 | Системный блок Р 5300/G31/9500 2Gb/250Gb/DVD-Rw/420w/kb/m | шт. | 715.82 |  |  | 1 | 715.82
10 | 77724 | Портативный компьютер ASUS K73E Intel Core 13-231OM 2,1GHz 4096Mb 500Gb 17,3* LED HD | шт. | 919.71 |  |  | 1 | 919.71
Итого по счету 01.1.1 |  |  |  |  |  |  | 10 | 40108.63
МБП |  |  |  |  |  |  | 2 | 37.62
11 | 261 | Холодильник "апшерон" | шт | 0.01 |  |  | 1 | 0.01
12 | 5400042 | Печь микроволновая Midea | шт | 37.61 |  |  | 1 | 37.61
Итого по счету 10.19 |  |  |  |  |  |  | 2 | 37.62
Итого по описи:
количество порядковых номеров: двенадцать ;
общее количество единиц фактически:
на сумму, руб. коп., фактически:
Председатель комиссии:
Члены комиссии:
Все ценности, поименованные в настоящей инвентаризационной описи с № 1 по № 12, комиссией проверены в натуре в моем (нашем) присутствии и внесены в опись, в связи с чем претензий к инвентаризациионной комиссии не имею (не имеем). Ценности перечисленные в описи, находятся на моем (нашем) ответственном хранении.
Лицо(а), ответственное(ые) за сохранность ценностей:
 |  | Ведущий инженер-конструктор |  |  | Шутов Ю.Д.
Указанные в настоящей описи данные и подсчеты проверил:
