Sasha7b9Work/LiniaServer/_Лисенков/поапва.xls

Sheet: . Первый лист.
Перв. примен. | Формат | Зона |  | Поз. |  | Обозначение |  |  |  | Наименование |  |  | Кол. | Примечание
 |  |  |  |  |  |  |  |  |  | Документация
 | А3 |  |  |  |  | УШЯИ.687253.017 СБ |  |  |  | Сборочный чертеж
 | А3 |  |  |  |  | УШЯИ.687253.017 Э3 |  |  |  | Схема электрическая
 |  |  |  |  |  |  |  |  |  | принципиальная
Справ. № | А4 |  |  |  |  | УШЯИ.687253.017 ПЭ3 |  |  |  | Перечень элементов
 |  |  |  |  |  |  |  |  |  | Детали
 | А3 |  |  | 1 |  | УШЯИ.758725.629 |  |  |  | Плата печатная |  |  | 1
Подп. и дата
Инв. № дубл.
Взам. инв. №
Подп. и дата
 |  |  |  |  |  |  |  |  | УШЯИ.687253.017
 | Изм. |  | Лист |  | № докум. |  | Подп. | Дата
Инв. № подл. | Разраб. |  |  |  | Сидорик |  |  |  | Плата интерфейса |  | Лит. | Лист |  |  | Листов
 | Пров. |  |  |  | Лисенков |  |  |  |  |  |  | 1 |  |  | 2
 | Согл. |  |  |  | Голод
 | Н. контр. |  |  |  | Ильина
 | Утв. |  |  |  | Грицев

Sheet: Лист регистрации изменений.
 | Лист регистрации изменений
 | Изм. |  | Номера листов (страниц) |  |  |  |  |  |  |  | Всего листов (страниц) в докум. | № докум. | Входящий № сопроводи- тельного документа и дата | Под- пись | Дата
 |  |  | изме- ненных |  | заме- няемых |  | новых |  |  | аннули-рованных
Подп. и дата
Инв. № дубл.
Взам. инв. №
Подп. и дата
Инв.№ подл.
 |  |  |  |  |  |  |  |  | УШЯИ.687253.017 |  |  |  |  |  |  | Лист
 |  |  |  |  |  |  |  |  |  |  |  |  |  |  |  | 2
 | Изм. | Лист |  | № докум |  | Подп. |  | Дата
