Sasha7b9Work/LiniaServer/_Лисенков/Ватафа/Плата источника напряжения 3 кВ УШЯИ.687245.044.xlsx

Line # | Name | Description | Designator | Quantity | Manufacturer 1 | Manufacturer Part Number 1 | Manufacturer Lifecycle 1 | Supplier 1 | Supplier Part Number 1 | Supplier Unit Price 1 | Supplier Subtotal 1
6 | К73-14М-4 кВ-0,033 мкФ +-10% |  | C1 | 1
8 | К73-17-250 В-0,47 мкФ +-20% |  | C2, C3 | 2
7 | К73-14М-4 кВ-0,1 мкФ +-10% |  | C4, C5 | 2
4 | LGG2G331MELB30 | 330uF, 400V | C6, C7 | 2
5 | К10-17б-M1500-1200 пФ +-5% | К10-17б-M1500-1200 пФ +-5% | C8 | 1
3 | 1206-X7R-50 B-0,33 мкФ+-10% |  | C9, C10, C14, C15, C16, C20, C21 | 7
2 | 0805-X7R-25 В-0,1 мкФ +-10% |  | C11, C12, C13, C17, C18, C19 | 6
10 | ADuM1100AR | iCoupler Digital Isolator | DA1 | 1
9 | ADM2486BRWZ | Isolated RS-485 Transceiver, 20 Mbps data rate, SOIC-16-W | DA2, DA3 | 2
 | MAX809S | Very Low Supply Current 3-Pin Microprocessor Reset Monitors | DA4 | 1
19 | ULQ2003AD | High-Current Darlington Transistor Arrays, 16-SOIC | DD1, DD2, DD3 | 3
14 | IN74HC08AD | Quad 2-Input AND Gate High-Performance Silicon-Gate CMOS | DD4 | 1
13 | IN74HC04AD |  | DD5 | 1
11 | IN74HC00AD | Quad 2-Input NAND Gate High-Performance Silicon-Gate CMOS. | DD6 | 1
12 | IN74HC02AD | Quad 2-Input NOR Gate | DD7, DD8, DD9 | 3
 | IN74HC86AD | Quad 2-Input Exclusive OR Gate | DD10 | 1
16 | IN74HC595AD | 8-Bit SIPO Register w/ Latch & 3-State | DD11 | 1
 | IN74HC138AD | Дешифратор-демультиплексор IN74HC138A 3-8 с инверсией на выходе | DD12 | 1
22 | УШЯИ.685442.092vs2Rel |  | K1 | 1
20 | DAR71210TU | HIGH VOLTAGE RELAYS - 10KV | K2, K3, K4, K5, K6, K7, K8, K9, K10, K13, K14, K15, K16, K17, K18 | 15
21 | TLP3549F |  | K11, K12 | 2
36 | С2-33Н-0,5-270 Ом +-5% | Резисторы постоянные непроволочные общего применения С2-33Н АИ, производитель "АО"НПО"ЭРКОН" | R1 | 1
31 | С2-33-2-1,2 кОм +-5% | Резисторы постоянные непроволочные общего применения С2-33, производитель "АО"НПО"ЭРКОН" | R2, R5, R10, R11, R12, R27, R28 | 7
39 | С2-33Н-1-10 кОм +-5% | Резисторы постоянные непроволочные общего применения С2-33Н АИ, производитель "АО"НПО"ЭРКОН" | R3, R6 | 2
37 | С2-33Н-1-15 Ом +-5% | Резисторы постоянные непроволочные общего применения С2-33Н АИ, производитель "АО"НПО"ЭРКОН" | R4 | 1
29 | С2-33-2-15 Ом +-5% | Резисторы постоянные непроволочные общего применения С2-33, производитель "АО"НПО"ЭРКОН" | R7 | 1
30 | С2-33-2-300 Ом +-5% | Резисторы постоянные непроволочные общего применения С2-33, производитель "АО"НПО"ЭРКОН" | R8, R9 | 2
33 | С2-33-2-15 кОм +-5% | Резисторы постоянные непроволочные общего применения С2-33, производитель "АО"НПО"ЭРКОН" | R13, R19 | 2
23 | 1206-10 Ом+-5% |  | R14, R15 | 2
35 | С2-33Н-0,5-3 Ом +-5% | Резисторы постоянные непроволочные общего применения С2-33Н АИ, производитель "АО"НПО"ЭРКОН" | R16, R20, R21, R22 | 4
34 | С2-33-2-470 кОм +-5% | Резисторы постоянные непроволочные общего применения С2-33, производитель "АО"НПО"ЭРКОН" | R17, R18 | 2
25 | 1206-470 Ом+-5% |  | R23, R24 | 2
40 | С2-33Н-1-1 МОм +-5% | Резисторы постоянные непроволочные общего применения С2-33Н АИ, производитель "АО"НПО"ЭРКОН" | R25, R26 | 2
32 | С2-33-2-3,3 кОм +-5% | Резисторы постоянные непроволочные общего применения С2-33, производитель "АО"НПО"ЭРКОН" | R29, R30 | 2
38 | С2-33Н-1-1 кОм +-5% | Резисторы постоянные непроволочные общего применения С2-33Н АИ, производитель "АО"НПО"ЭРКОН" | R31, R32 | 2
28 | Р1-32-1-18 МОм +-5% | Резистор постоянный непроволочный высокоомный Р1-32, производитель "АО"НПО"ЭРКОН" | R33 | 1
24 | 1206-100 Ом+-5% |  | R34, R35 | 2
26 | 1206-12 кОм+-5% |  | R36, R37 | 2
27 | 1206-22 кОм+-5% |  | R38, R39 | 2
1 | 1206-1 кОм+-5% |  | R? | 4
41 | МКА-50202 |  | S1, S2 | 2
43 | 20ETF08/IR | Диод 20ETF08/IR | VD1, VD2 | 2
44 | BY255/Taw | Выпрямитель BY255/Taw | VD3, VD4 | 2
45 | HVM8 | Выпрямитель HVM8 | VD5, VD6 | 2
42 | 1N4148WS | Small Signal Fast Switching Diod | VD7, VD8 | 2
46 | TR-1,25-4 | Клемма TR-1,25-4 | X1, X2, X3, X4, X5, X6 | 6
48 | BH2-10 | DS1014-10 Straight | XP1 | 1
47 | 280371-2 | Connector | XP2 | 1
49 | УШЯИ.685631.123 |  | XT1 | 1
