Sasha7b9Work/LiniaServer/_Лисенков/Для отчета ИНТЕГРАЛу/Источник напряжения 50В 411522.032 Э3_ПЭ3.xls

Sheet: . Первый лист.
Перв. примен. | Поз. обозна-чение |  |  | Наименование |  |  |  | Кол. |  | Примечание
 |  |  |  | Устройства
 | A1 |  |  | Плата УШЯИ 687253.017 |  |  |  | 1
 | A2 |  |  | Плата УШЯИ 687253.018 |  |  |  | 1
Справ. №
 |  |  |  | Транзисторы
 | VT1,VT2 |  |  | IXFN210N30P3 |  |  |  | 2
 |  |  |  | Соединения контактные
 | X1-X6 |  |  | TR-1.25-4S |  |  |  | 6
 | X1,X7 |  |  | TR-3.5-4 |  |  |  | 2
 | X8 |  |  | TR-3.5-4 |  |  |  | 1
Подп. и дата | X9 |  |  | TR-1.25-4S |  |  |  | 1
 |  |  |  | Вилки
Инв. № дубл. | XP1 |  |  | BH2-20 |  |  |  | 1
 | XP2 |  |  | AMPMODU 280370-2 |  |  |  | 1
 | XP6 |  |  | AMPMODU 280372-2 |  |  |  | 1
Взам. инв.№ | XP7 |  |  | MNL-350810-1 |  |  |  | 1
Подп. и дата
 |  |  |  |  |  |  | УШЯИ 411522.032 ПЭ3
 | Изм. | Лист | № докум. |  | Подп. | Дата
Инв. № подл. | Разраб. |  | Сидорик |  |  |  | Источник напряжения 50 В |  | Лит. |  | Лист | Листов
 | Пров. |  | Лисенков |  |  |  |  |  |  |  | 1 | 2
 | Согл. |  | Голод
 | Н.контр |  | Ильина
 | Утв. |  | Грицев |  |  |  | Перечень элементов

Sheet: 2
 | Поз. обозна- чение |  |  | Наименование |  |  |  | Кол. | Примечание
 |  |  |  | Розетки
 | XS1,XS2 |  |  | AMPMODU 280361 |  |  |  | 2
 |  |  |  | Соединения разборные
 | XT1 |  |  | УШЯИ.685631.123 |  |  |  | 1
Подп. и дата
Инв. № дубл.
Взам. инв.№
Подп. и дата
Инв. № подл.
 |  |  |  |  |  |  | УШЯИ 411522.032 ПЭ3 |  |  | Лист
 |  |  |  |  |  |  |  |  |  | 2
 | Изм. | Лист | № докум. |  | Подп. | Дата
