Sasha7b9Work/LiniaServer/_Лисенков/Для отчета ИНТЕГРАЛу/Источник напряжения УШЯИ411522.034_ПЭ3.xls

Sheet: . Первый лист.
Перв. примен. | Поз. обозна-чение |  |  | Наименование |  |  |  | Кол. |  | Примечание
 |  |  |  | Устройства
 | A1 |  |  | Не устанавливать |  |  |  | 1
 | A2 |  |  | Не устанавливать |  |  |  | 1
Справ. № | A3 |  |  | Не устанавливать |  |  |  | 1
 | A4 |  |  | Не устанавливать |  |  |  | 1
 | A5 |  |  | Не устанавливать |  |  |  | 1
 |  |  |  | Конденсаторы
 | C1 |  |  | К73-17-250 В-1 мкФ +-20% |  |  |  | 1
 | C2,C3 |  |  | GRM2165C2A102JA01D |  |  |  | 2
 | C4 |  |  | К73-17-250 В-1 мкФ +-20% |  |  |  | 1
 | C5,C6 |  |  | К73-17-250 В-0,47 мкФ +-20% |  |  |  | 2
Подп. и дата
 |  |  |  | Резисторы
 | R1 |  |  | OAR3-R005FI |  |  |  | 1
Инв. № дубл. | R2 |  |  | 1206-9,1 кОм+-5% |  |  |  | 1
 | R3,R4 |  |  | 1206-240 Ом+-5% |  |  |  | 2
 | R5 |  |  | 1206-9,1 кОм+-5% |  |  |  | 1
Взам. инв.№ | R6,R7 |  |  | 1206-150 Ом+-5% |  |  |  | 2
 | R8 |  |  | 1206-100 Ом+-5% |  |  |  | 1
Подп. и дата
 |  |  |  |  |  |  | УШЯИ 411522.034 ПЭ3
 | Изм. | Лист | № докум. |  | Подп. | Дата
Инв. № подл. | Разраб. |  | Сидорик |  |  |  | Источник напряжения |  | Лит. |  | Лист | Листов
 | Пров. |  | Лисенков |  |  |  |  |  |  |  | 1 | 4
 | Согл. |  | Голод
 | Н.контр |  | Ильина
 | Утв. |  | Володкевич |  |  |  | Перечень элементов

Sheet: 2
 | Поз. обозна- чение |  |  | Наименование |  |  |  | Кол. | Примечание
 |  |  |  | Трансформаторы напряжения
 | TV1 |  |  | Трансформатор УШЯИ.671111.272 |  |  |  | 1
 |  |  |  | Диоды
 | VD1 |  |  | 1N4007 |  |  |  | 1
 | VD2 |  |  | 1N4007 |  |  |  | 1
 | VD3,VD4 |  |  | 1,5KE68CA |  |  |  | 2
 | VD5,VD6 |  |  | 1N4007 |  |  |  | 2
 |  |  |  | Транзисторы
 | VT1 |  |  | MJ11032 |  |  |  | 1
Подп. и дата | VT2 |  |  | MJE11033 |  |  |  | 1
 |  |  |  | Соединения контактные
Инв. № дубл. | X1 |  |  | N6,3-1/0,8 |  |  |  | 1
 | X1-X4 |  |  | TR-1,25-4 |  |  |  | 4
 | X2 |  |  | N6,3-1/0,8 |  |  |  | 1
Взам. инв.№ | X3 |  |  | N6,3-1/0,8 |  |  |  | 1
 | X3-X6 |  |  | N6,3-1/0,8 |  |  |  | 4
 | X4,X5 |  |  | TR-1,25-4 |  |  |  | 2
Подп. и дата | X5-X14 |  |  | TR-1,25-4 |  |  |  | 10
 |  |  |  | Розетки
 | XS1 |  |  | 280360-0 |  |  |  | 1
Инв. № подл. | XS2 |  |  | 280359 |  |  |  | 1
 |  |  |  |  |  |  | УШЯИ 411522.034 ПЭ3 |  |  | Лист
 |  |  |  |  |  |  |  |  |  | 2
 | Изм. | Лист | № докум. |  | Подп. | Дата

Sheet: 3
 | Поз. обозна- чение |  |  | Наименование |  |  |  | Кол. | Примечание
 |  |  |  | Розетки
 | XS3 |  |  | MNL-350809-1 |  |  |  | 1
 |  |  |  | Соединения разборные
 | XT1-XT10 |  |  | УШЯИ.685631.123 |  |  |  | 10
 | 1 |  |  | OTV18 |  |  |  | 1
 | 1-6 |  |  | OTV18 |  |  |  | 6
 | 2 |  |  | OTV34 |  |  |  | 1
 | 3,4 |  |  | OTV11 |  |  |  | 2
Подп. и дата | 5 |  |  | OTV34 |  |  |  | 1
 | 6,7 |  |  | OTV18 |  |  |  | 2
 | 7,8 |  |  | OTV18 |  |  |  | 2
 | 8-15 |  |  | OTV18 |  |  |  | 8
Инв. № дубл. | 9 |  |  | OTV34 |  |  |  | 1
Взам. инв.№
Подп. и дата
Инв. № подл.
 |  |  |  |  |  |  | УШЯИ 411522.034 ПЭ3 |  |  | Лист
 |  |  |  |  |  |  |  |  |  | 3
 | Изм. | Лист | № докум. |  | Подп. | Дата

Sheet: Лист регистрации изменений.
 | Лист регистрации изменений
 | Изм. |  | Номера листов (страниц) |  |  |  |  |  |  |  | Всего листов (страниц) в докум. | № докум. | Входящий № сопроводи-тельного документа и дата | Под- пись | Дата
 |  |  | изменен- ных |  | заменен- ных |  | новых |  |  | аннули- рован- ных
Подп. и дата
Инв. № дубл.
Взам. инв.№
Подп. и дата
Инв. № подл.
 |  |  |  |  |  |  |  |  | УШЯИ 411522.034 ПЭ3 |  |  |  |  |  |  | Лист
 |  |  |  |  |  |  |  |  |  |  |  |  |  |  |  | 4
 | Изм. | Лист |  | № докум. |  | Подп. |  | Дата
