Sasha7b9Work/LiniaServer/_Лисенков/Для отчета ИНТЕГРАЛу/Плата 687253.017ПЭ3_ПЭ3.xls

Sheet: . Первый лист.
Перв. примен. | Поз. обозна-чение |  |  | Наименование |  |  |  | Кол. |  | Примечание
 |  |  |  | Конденсаторы
 | C1-C20 |  |  | 0805-X7R-25 В-0,1 мкФ +-10% |  |  |  | 20
 | C21 |  |  | 1206-C0G-50 В-22 пФ +-5% |  |  |  | 1
Справ. № | C22,C23 |  |  | 2220-X7R-250 В-1 мкФ +-10% |  |  |  | 2
 | C24,C25 |  |  | 0805-C0G-250 В-10 пФ +-5% |  |  |  | 2
 | C26 |  |  | 0805-X7R-25 В-1 мкФ +-10% |  |  |  | 1
 | C27,C28 |  |  | 0805-C0G-250 В-10 пФ +-5% |  |  |  | 2
 | C29,C30 |  |  | 2220-X7R-250 В-1 мкФ +-10% |  |  |  | 2
 | C31 |  |  | 0805-X7R-25 В-1 мкФ +-10% |  |  |  | 1
 | C32,C33 |  |  | 0805-C0G-250 В-10 пФ +-5% |  |  |  | 2
 | C34,C35 |  |  | К73-17-160 В-1 мкФ +-10% |  |  |  | 2
 | C36,C37 |  |  | 1206-X7R-250 B-0,1 мкФ+-10% |  |  |  | 2
 | C38-C40 |  |  | ECR4R7M50B |  |  |  | 3
Подп. и дата | C41,C42 |  |  | 0805-X7R-25 В-0,33 мкФ +-10% |  |  |  | 2
 | C43,C44 |  |  | EHR-250B-47 мкФ |  |  |  | 2
 | C45-C51 |  |  | 0805-X7R-25 В-0,33 мкФ +-10% |  |  |  | 7
 | C52,C53 |  |  | 1206-X7R-50 B-22 пФ+-10% |  |  |  | 2
Инв. № дубл. | C54 |  |  | 0805-X7R-25 В-0,33 мкФ +-10% |  |  |  | 1
Взам. инв.№
Подп. и дата
 |  |  |  |  |  |  | УШЯИ 687253.017 ПЭ3
 | Изм. | Лист | № докум. |  | Подп. | Дата
Инв. № подл. | Разраб. |  | Сидорик |  |  |  | Плата |  | Лит. |  | Лист | Листов
 | Пров. |  | Лисенков |  |  |  |  |  |  |  | 1 | 6
 | Согл. |  | Голод
 | Н.контр |  | Ильина
 | Утв. |  | Грицев |  |  |  | Перечень элементов

Sheet: 2
 | Поз. обозна- чение |  |  | Наименование |  |  |  | Кол. | Примечание
 |  |  |  | Микросхемы
 | DA1 |  |  | ADuM1100AR |  |  |  | 1
 | DA2,DA3 |  |  | ADM2486BRWZ |  |  |  | 2
 | DA4 |  |  | ADuM1100AR |  |  |  | 1
 | DA5 |  |  | ADM2486BRWZ |  |  |  | 1
 | DA6 |  |  | ADuM1100AR |  |  |  | 1
 | DA7 |  |  | ADR435BRZ |  |  |  | 1
 | DA8,DA9 |  |  | ADuM1100AR |  |  |  | 2
 | DA10 |  |  | AD5443YRM |  |  |  | 1
 | DA11,DA12 |  |  | ADA4084-2ARZ |  |  |  | 2
 | DA13 |  |  | ADuM1100AR |  |  |  | 1
 | DA14 |  |  | ADG433BR |  |  |  | 1
 | DA15,DA16 |  |  | PA340CC |  |  |  | 2
Подп. и дата | DA17 |  |  | ADG433BR |  |  |  | 1
 | DA18,DA19 |  |  | AD823ARZ |  |  |  | 2
 | DA20 |  |  | ADA4084-2ARZ |  |  |  | 1
 | DA21,DA22 |  |  | IL311D |  |  |  | 2
Инв. № дубл. | DD1 |  |  | IN74HC00AD |  |  |  | 1
 | DD2 |  |  | IN74HC20D |  |  |  | 1
 | DD3 |  |  | IN74HC00AD |  |  |  | 1
Взам. инв.№
 |  |  |  | Реле
Подп. и дата | K1,K2 |  |  | TLP3549F |  |  |  | 2
 |  |  |  | Резисторы
 | R1-R6 |  |  | 1206-1 кОм+-5% |  |  |  | 6
Инв. № подл. | R7-R9 |  |  | 1206-100 Ом+-5% |  |  |  | 3
 |  |  |  |  |  |  | УШЯИ 687253.017 ПЭ3 |  |  | Лист
 |  |  |  |  |  |  |  |  |  | 2
 | Изм. | Лист | № докум. |  | Подп. | Дата

Sheet: 3
 | Поз. обозна- чение |  |  | Наименование |  |  |  | Кол. | Примечание
 |  |  |  | Резисторы
 | R10-R12 |  |  | 1206-12 кОм+-5% |  |  |  | 3
 | R13 |  |  | 1206-10 кОм+-0,5% |  |  |  | 1
 | R14 |  |  | 1206-100 Ом+-0,5% |  |  |  | 1
 | R15,R16 |  |  | 1206-10 кОм+-0,5% |  |  |  | 2
 | R17 |  |  | 1206-12 кОм+-1% |  |  |  | 1
 | R18 |  |  | 1206-15 кОм+-5% |  |  |  | 1
 | R19,R20 |  |  | 1206-51 Ом+-5% |  |  |  | 2
 | R21 |  |  | 1206-51 кОм+-5% |  |  |  | 1
 | R22,R23 |  |  | 1206-2 кОм+-0.5% |  |  |  | 2
 | R24-R27 |  |  | 1206-20 кОм+-0.5% |  |  |  | 4
 | R28,R29 |  |  | 1206-20 Ом+-5% |  |  |  | 2
 | R30,R31 |  |  | 1206-20 кОм+-0.5% |  |  |  | 2
Подп. и дата | R32,R33 |  |  | С2-33Н-0,125-33 Ом +-5% |  |  |  | 2
 | R34,R35 |  |  | 1206-7,5 кОм+-5% |  |  |  | 2
 | R36,R37 |  |  | 1206-2,4 кОм+-5% |  |  |  | 2
 | R38-R41 |  |  | 1206-20 кОм+-0.5% |  |  |  | 4
Инв. № дубл. | R42 |  |  | 1206-2,4 кОм+-5% |  |  |  | 1
 | R43 |  |  | 1206-51 Ом+-5% |  |  |  | 1
 | R44 |  |  | 1206-2,4 кОм+-5% |  |  |  | 1
Взам. инв.№ | R45 |  |  | 1206-51 Ом+-5% |  |  |  | 1
 | R46-R49 |  |  | 2512-51 Ом+-5% |  |  |  | 4
 | R50,R51 |  |  | 1206-2,7 кОм+-5% |  |  |  | 2
Подп. и дата | R52 |  |  | 1206-6,98 кОм+-1% |  |  |  | 1
 | R53 |  |  | 1206-1 кОм+-5% |  |  |  | 1
 | R54,R55 |  |  | 2512-1,2 кОм+-5% |  |  |  | 2
 | R56,R57 |  |  | 1206-2 кОм+-0.5% |  |  |  | 2
 | R58-R60 |  |  | 1206-240 Ом+-5% |  |  |  | 3
Инв. № подл. | R61 |  |  | 1206-430 Ом+-5% |  |  |  | 1
 |  |  |  |  |  |  | УШЯИ 687253.017 ПЭ3 |  |  | Лист
 |  |  |  |  |  |  |  |  |  | 3
 | Изм. | Лист | № докум. |  | Подп. | Дата

Sheet: 4
 | Поз. обозна- чение |  |  | Наименование |  |  |  | Кол. | Примечание
 |  |  |  | Резисторы
 | R62 |  |  | 1206-150 Ом+-5% |  |  |  | 1
 | R63 |  |  | 1206-240 Ом+-5% |  |  |  | 1
 | R64 |  |  | 1206-430 Ом+-5% |  |  |  | 1
 | R65 |  |  | 2512-5,6 кОм+-5% |  |  |  | 1
 | R66 |  |  | 1206-2 кОм+-5% |  |  |  | 1
 | R67 |  |  | 1206-390 Ом+-5% |  |  |  | 1
 | R68 |  |  | 1206-51 кОм+-5% |  |  |  | 1
 | R69 |  |  | 1206-390 Ом+-5% |  |  |  | 1
 | R70,R71 |  |  | W21-3W-680 Ом +-5% |  |  |  | 2
 | R72 |  |  | 1206-51 кОм+-5% |  |  |  | 1
 | R73 |  |  | 1206-2,7 кОм+-5% |  |  |  | 1
 | R74,R75 |  |  | HS15-4R7-J |  |  |  | 2
Подп. и дата
 |  |  |  | Потенциометры
 | RP1 |  |  | 3362P-1-103LF |  |  |  | 1
Инв. № дубл. | RP2,RP3 |  |  | PVG3A102C01R00 |  |  |  | 2
 |  |  |  | Диоды
Взам. инв.№
 | VD1-VD4 |  |  | 1N4148WS |  |  |  | 4
 | VD5,VD6 |  |  | BZX55-C6V2 |  |  |  | 2
Подп. и дата | VD7,VD8 |  |  | BZX84C15LT1G |  |  |  | 2
 | VD9 |  |  | 1N4148WS |  |  |  | 1
 | VD10,VD11 |  |  | BZX84C15LT1G |  |  |  | 2
 | VD12,VD13 |  |  | 1N4007WS |  |  |  | 2
 | VD14 |  |  | W04M |  |  |  | 1
Инв. № подл. | VD15 |  |  | GSIB2540 |  |  |  | 1
 |  |  |  |  |  |  | УШЯИ 687253.017 ПЭ3 |  |  | Лист
 |  |  |  |  |  |  |  |  |  | 4
 | Изм. | Лист | № докум. |  | Подп. | Дата

Sheet: 5
 | Поз. обозна- чение |  |  | Наименование |  |  |  | Кол. | Примечание
 |  |  |  | Диоды
 | VD16,VD17 |  |  | BZX79-C10V |  |  |  | 2
 |  |  |  | Транзисторы
 | VT1 |  |  | ZXMN10A08E6TA |  |  |  | 1
 | VT2 |  |  | ZXMP10A17E6TA |  |  |  | 1
 | VT3,VT4 |  |  | IPA083N10N5XKSA1 |  |  |  | 2
 |  |  |  | Вилки
 | XP1 |  |  | BH2-20 |  |  |  | 1
 | XP2 |  |  | 280370-2 |  |  |  | 1
Подп. и дата | XP3,XP4 |  |  | DS1021-1x3 |  |  |  | 2
 | XP5 |  |  | 280373-2 |  |  |  | 1
 | XP6 |  |  | 280372-2 |  |  |  | 1
 | XP7 |  |  | MNL-350810-1 |  |  |  | 1
Инв. № дубл.
 |  |  |  | Розетки
Взам. инв.№ | XS1,XS2 |  |  | Jumper, 2.54mm |  |  |  | 2
Подп. и дата
Инв. № подл.
 |  |  |  |  |  |  | УШЯИ 687253.017 ПЭ3 |  |  | Лист
 |  |  |  |  |  |  |  |  |  | 5
 | Изм. | Лист | № докум. |  | Подп. | Дата

Sheet: Лист регистрации изменений.
 | Лист регистрации изменений
 | Изм. |  | Номера листов (страниц) |  |  |  |  |  |  |  | Всего листов (страниц) в докум. | № докум. | Входящий № сопроводи-тельного документа и дата | Под- пись | Дата
 |  |  | изменен- ных |  | заменен- ных |  | новых |  |  | аннули- рован- ных
Подп. и дата
Инв. № дубл.
Взам. инв.№
Подп. и дата
Инв. № подл.
 |  |  |  |  |  |  |  |  | УШЯИ 687253.017 ПЭ3 |  |  |  |  |  |  | Лист
 |  |  |  |  |  |  |  |  |  |  |  |  |  |  |  | 6
 | Изм. | Лист |  | № докум. |  | Подп. |  | Дата
