Sasha7b9Work/LiniaServer/_Лисенков/Для отчета ИНТЕГРАЛу/Плата измерителя УШЯИ.687243.352_ПЭ3.xls

Sheet: . Первый лист.
Перв. примен. | Поз. обозна-чение |  |  | Наименование |  |  |  | Кол. |  | Примечание
 |  |  |  | Конденсаторы
 | C1 |  |  | 1206-XP7-630 B-3,3 нФ+-10% |  |  |  | 1
 | C2 |  |  | 1206-XP7-500 B-15 нФ+-10% |  |  |  | 1
Справ. № | C3 |  |  | 1206-NP0-500 B-270 пФ+-5% |  |  |  | 1
 | C4-C6 |  |  | 1206-X7R-50 B-0,1 мкФ+-10% |  |  |  | 3
 | C7 |  |  | JRB-50В-4,7мкФ |  |  |  | 1
 | C8 |  |  | 1206-X7R-50 B-0,1 мкФ+-10% |  |  |  | 1
 | C9 |  |  | 0805-X7R-25 В-0,1 мкФ +-10% |  |  |  | 1
 | C10 |  |  | 1206-X7R-50 B-0,01 мкФ+-10% |  |  |  | 1
 | C11,C12 |  |  | 1206-X7R-50 B-0,1 мкФ+-10% |  |  |  | 2
 | C13 |  |  | 0805-C0G-50 В-240 пФ +-5% |  |  |  | 1
 | C14,C15 |  |  | 1206-X7R-50 B-0,1 мкФ+-10% |  |  |  | 2
 | C16 |  |  | 1206-X7R-10 B-10 мкФ+-10% |  |  |  | 1
Подп. и дата | C17 |  |  | 1206-X7R-50 B-0,01 мкФ+-10% |  |  |  | 1
 | C18 |  |  | 1206-X7R-50 B-2,2 мкФ+-10% |  |  |  | 1
 | C19 |  |  | 1206-X7R-50 B-0,01 мкФ+-10% |  |  |  | 1
 | C20,C21 |  |  | 1206-X7R-50 B-2,2 мкФ+-10% |  |  |  | 2
Инв. № дубл. | C22 |  |  | 1206-X7R-50 B-0,33 мкФ+-10% |  |  |  | 1
 | C23-C27 |  |  | 1206-X7R-50 B-0,1 мкФ+-10% |  |  |  | 5
 | C28 |  |  | JRB-25В-1000 мкФ |  |  |  | 1
Взам. инв.№ | C29 |  |  | 1206-X7R-50 B-10 мкФ+-10% |  |  |  | 1
 | C30 |  |  | JRB-35В-470мкФ |  |  |  | 1
Подп. и дата
 |  |  |  |  |  |  | УШЯИ 687243.352 ПЭ3
 | Изм. | Лист | № докум. |  | Подп. | Дата
Инв. № подл. | Разраб. |  | Сидорик |  |  |  | Плата измерителя |  | Лит. |  | Лист | Листов
 | Пров. |  | Лисенков |  |  |  |  |  |  |  | 1 | 7
 | Согл. |  | Голод
 | Н.контр |  | Ильина
 | Утв. |  | Грицев |  |  |  | Перечень элементов

Sheet: 2
 | Поз. обозна- чение |  |  | Наименование |  |  |  | Кол. | Примечание
 |  |  |  | Конденсаторы
 | C31,C32 |  |  | 1206-X7R-50 B-10 мкФ+-10% |  |  |  | 2
 | C33 |  |  | 0805-X7R-25 В-1 мкФ +-10% |  |  |  | 1
 | C34 |  |  | 1206-X7R-25 B-47мкФ+-10% |  |  |  | 1
 | C35,C36 |  |  | 0805-X7R-25 В-1 мкФ +-10% |  |  |  | 2
 | C37 |  |  | JRB-25В-220мкФ |  |  |  | 1
 | C38,C39 |  |  | 1206-X7R-25 B-47мкФ+-10% |  |  |  | 2
 | C40 |  |  | 1206-X7R-50 B-10 мкФ+-10% |  |  |  | 1
 | C41 |  |  | 0805-X7R-25 В-1 мкФ +-10% |  |  |  | 1
 | C42 |  |  | 1206-X7R-50 B-0,01 мкФ+-10% |  |  |  | 1
 | C43 |  |  | 1206-X7R-25 B-47мкФ+-10% |  |  |  | 1
 |  |  |  | Микросхемы
Подп. и дата
 | DA1 |  |  | MAX809S |  |  |  | 1
 | DA2 |  |  | TLV9152IDR |  |  |  | 1
 | DA3 |  |  | TLV9151IDR |  |  |  | 1
Инв. № дубл. | DA4 |  |  | ADR434BR |  |  |  | 1
 | DA5 |  |  | ADA4637-1ARZ |  |  |  | 1
 | DA6 |  |  | ADG433BR |  |  |  | 1
Взам. инв.№ | DA7 |  |  | ADA4941-1YRZ |  |  |  | 1
 | DA8 |  |  | AD8031BRZ |  |  |  | 1
 | DA9 |  |  | ADA4637-1ARZ |  |  |  | 1
Подп. и дата | DA10 |  |  | ADG431BR |  |  |  | 1
 | DA11 |  |  | AD7691BRM |  |  |  | 1
 | DA12 |  |  | TLV9151IDR |  |  |  | 1
 | DA13 |  |  | TLV9152IDR |  |  |  | 1
 | DA14 |  |  | TLV9151IDR |  |  |  | 1
Инв. № подл. | DA15 |  |  | TLV1842 |  |  |  | 1
 |  |  |  |  |  |  | УШЯИ 687243.352 ПЭ3 |  |  | Лист
 |  |  |  |  |  |  |  |  |  | 2
 | Изм. | Лист | № докум. |  | Подп. | Дата

Sheet: 3
 | Поз. обозна- чение |  |  | Наименование |  |  |  | Кол. | Примечание
 |  |  |  | Микросхемы
 | DA16-DA18 |  |  | TPS7A4701 |  |  |  | 3
 | DA19 |  |  | TPS7A3301 |  |  |  | 1
 | DD1 |  |  | IN74HC00AD |  |  |  | 1
 | DD2 |  |  | IN74HC08AD |  |  |  | 1
 | DD3 |  |  | IN74HC139AD |  |  |  | 1
 | DD4 |  |  | IN74HC138AD |  |  |  | 1
 | DD5 |  |  | IN74HC595AD |  |  |  | 1
 | DD6 |  |  | IN74HC08AD |  |  |  | 1
 |  |  |  | Элементы защиты по напряжению
 | FV1,FV2 |  |  | 2027-09-B19 |  |  |  | 2
Подп. и дата
 |  |  |  | Реле
 | K1-K7 |  |  | SIL05-1A72-71L |  |  |  | 7
Инв. № дубл. | K8 |  |  | УШЯИ.685442.092vs2Rel |  |  |  | 1
 |  |  |  | Резисторы
Взам. инв.№
 | R1 |  |  | С2-29В-0,25-4,99 МОм +-0.1% |  |  |  | 1
 | R2 |  |  | С2-29В-0,125-22 Ом +-0.1%-1,0-А |  |  |  | 1
Подп. и дата | R3 |  |  | С2-29В-0,125-49,9 кОм +-0.1%-1,0-А |  |  |  | 1
 | R4 |  |  | 1206-499 Ом+-0,1% |  |  |  | 1
 | R5 |  |  | 1206-4,99 Ом+-0,1% |  |  |  | 1
 | R6 |  |  | OAR5-R050FLF |  |  |  | 1
 | R7 |  |  | 1206-27 Ом+-5% |  |  |  | 1
Инв. № подл. | R8,R9 |  |  | WSL5931L5000FEA |  |  |  | 2
 |  |  |  |  |  |  | УШЯИ 687243.352 ПЭ3 |  |  | Лист
 |  |  |  |  |  |  |  |  |  | 3
 | Изм. | Лист | № докум. |  | Подп. | Дата

Sheet: 4
 | Поз. обозна- чение |  |  | Наименование |  |  |  | Кол. | Примечание
 |  |  |  | Резисторы
 | R10 |  |  | 1206-91 кОм+-5% |  |  |  | 1
 | R11 |  |  | 1210-100 Ом+-5% |  |  |  | 1
 | R12,R13 |  |  | 1206-470 Ом+-5% |  |  |  | 2
 | R14 |  |  | С2-29В-0,125-332 кОм+-0.1%-1,0-А |  |  |  | 1
 | R15 |  |  | 1206-470 Ом+-5% |  |  |  | 1
 | R16 |  |  | 1206-51 Ом+-5% |  |  |  | 1
 | R17,R18 |  |  | 1206-22 Ом+-5% |  |  |  | 2
 | R19 |  |  | 1210-1,1 кОм+-5% |  |  |  | 1
 | R20 |  |  | 1206-5,1 кОм+-5% |  |  |  | 1
 | R21 |  |  | 1206-20 кОм+-5% |  |  |  | 1
 | R22 |  |  | 1206-470 Ом+-5% |  |  |  | 1
 | R23-R26 |  |  | 0805-1 кОм+-0,1% |  |  |  | 4
Подп. и дата | R27 |  |  | 0805-332 Ом+-0,1% |  |  |  | 1
 | R28 |  |  | 0805-1 кОм+-0,1% |  |  |  | 1
 | R29 |  |  | 1206-470 Ом+-5% |  |  |  | 1
 | R30 |  |  | 1206-9,09 кОм+-1% |  |  |  | 1
Инв. № дубл. | R31 |  |  | 1206-1 кОм+-1% |  |  |  | 1
 | R32,R33 |  |  | 1206-51 Ом+-5% |  |  |  | 2
 | R34 |  |  | 1206-4,02 кОм+-0,1% |  |  |  | 1
Взам. инв.№ | R35 |  |  | 1206-2 кОм+-0.1% |  |  |  | 1
 | R36-R38 |  |  | 1206-1 кОм+-0.1% |  |  |  | 3
 | R39 |  |  | 1206-5,1 кОм+-5% |  |  |  | 1
Подп. и дата | R40 |  |  | 1206-10 Ом+-5% |  |  |  | 1
 | R41 |  |  | 1206-1,82 кОм+-0,1% |  |  |  | 1
 | R42 |  |  | 1206-10 кОм+-5% |  |  |  | 1
 | R43 |  |  | 1206-470 Ом+-5% |  |  |  | 1
 | R44 |  |  | 1206-7,15 кОм+-1% |  |  |  | 1
Инв. № подл. | R45 |  |  | 1206-10 кОм+-0,5% |  |  |  | 1
 |  |  |  |  |  |  | УШЯИ 687243.352 ПЭ3 |  |  | Лист
 |  |  |  |  |  |  |  |  |  | 4
 | Изм. | Лист | № докум. |  | Подп. | Дата

Sheet: 5
 | Поз. обозна- чение |  |  | Наименование |  |  |  | Кол. | Примечание
 |  |  |  | Резисторы
 | R46 |  |  | 1206-470 Ом+-5% |  |  |  | 1
 | R47,R48 |  |  | 1206-2,4 кОм+-5% |  |  |  | 2
 | R49-R52 |  |  | 0805-1 кОм+-0,1% |  |  |  | 4
 | R53,R54 |  |  | 1206-510 кОм+-1% |  |  |  | 2
 | R55 |  |  | 1206-4,7 кОм+-5% |  |  |  | 1
 | R56 |  |  | 1206-1,24 МОм+-1% |  |  |  | 1
 | R57 |  |  | 1206-221 кОм+-1% |  |  |  | 1
 |  |  |  | Переключатели
 | S1,S2 |  |  | DRA282G |  |  |  | 2
Подп. и дата |  |  |  | Диоды
 | VD1 |  |  | 1N4148WS |  |  |  | 1
 | VD2-VD5 |  |  | 1N4007WS |  |  |  | 4
Инв. № дубл. | VD6-VD13 |  |  | 1N4148WS |  |  |  | 8
 | VD14-VD21 |  |  | V1P22 |  |  |  | 8
 | VD22-VD25 |  |  | 1N4148WS |  |  |  | 4
Взам. инв.№
 |  |  |  | Транзисторы
Подп. и дата | VT1 |  |  | FZT658 |  |  |  | 1
 |  |  |  | Соединения контактные
 | X1-X3 |  |  | TR-1,25-4 |  |  |  | 3
Инв. № подл.
 |  |  |  |  |  |  | УШЯИ 687243.352 ПЭ3 |  |  | Лист
 |  |  |  |  |  |  |  |  |  | 5
 | Изм. | Лист | № докум. |  | Подп. | Дата

Sheet: 6
 | Поз. обозна- чение |  |  | Наименование |  |  |  | Кол. | Примечание
 |  |  |  | Вилки
 | XP1 |  |  | DS1014-16SF1B |  |  |  | 1
 | XP2 |  |  | 280370-2 |  |  |  | 1
 | XP3 |  |  | 280371-2 |  |  |  | 1
 | XP4 |  |  | DS1074-5MVT6 |  |  |  | 1
 |  |  |  | Соединения разборные
 | XT1-XT3 |  |  | УШЯИ.685631.123 |  |  |  | 3
 |  |  |  | Фильтры, ограничители
 | Z1-Z3 |  |  | BNX022-01 |  |  |  | 3
Подп. и дата
Инв. № дубл.
Взам. инв.№
Подп. и дата
Инв. № подл.
 |  |  |  |  |  |  | УШЯИ 687243.352 ПЭ3 |  |  | Лист
 |  |  |  |  |  |  |  |  |  | 6
 | Изм. | Лист | № докум. |  | Подп. | Дата

Sheet: Лист регистрации изменений.
 | Лист регистрации изменений
 | Изм. |  | Номера листов (страниц) |  |  |  |  |  |  |  | Всего листов (страниц) в докум. | № докум. | Входящий № сопроводи-тельного документа и дата | Под- пись | Дата
 |  |  | изменен- ных |  | заменен- ных |  | новых |  |  | аннули- рован- ных
Подп. и дата
Инв. № дубл.
Взам. инв.№
Подп. и дата
Инв. № подл.
 |  |  |  |  |  |  |  |  | УШЯИ 687243.352 ПЭ3 |  |  |  |  |  |  | Лист
 |  |  |  |  |  |  |  |  |  |  |  |  |  |  |  | 7
 | Изм. | Лист |  | № докум. |  | Подп. |  | Дата
