Sasha7b9Work/LiniaServer/_Лисенков/Для отчета ИНТЕГРАЛу/Плата интерфейса УШЯИ.687243.351_ПЭ3.xls

Sheet: . Первый лист.
Перв. примен. | Поз. обозна-чение |  |  | Наименование |  |  |  | Кол. |  | Примечание
 |  |  |  | Конденсаторы
 | C1-C3 |  |  | 0805-NP0-50 В-2,4 пФ-1% |  |  |  | 3
 | C4-C6 |  |  | 1206-С0G-50 B-56 пФ+-1% |  |  |  | 3
Справ. № | C7,C8 |  |  | 0805-NP0-50 В-2,4 пФ-1% |  |  |  | 2
 | C9,C10 |  |  | 1206-С0G-50 B-56 пФ+-1% |  |  |  | 2
 |  |  |  | Микросхемы
 | DA1-DA5 |  |  | ADA4807-2ARMZ |  |  |  | 5
 |  |  |  | Резисторы
 | R1-R3 |  |  | 1206-5,23 кОм+-1% |  |  |  | 3
Подп. и дата | R4-R6 |  |  | 1206-140 Ом+-1% |  |  |  | 3
 | R7-R9 |  |  | 1206-102 Ом+-1% |  |  |  | 3
 | R10-R12 |  |  | 1206-215 Ом+-1% |  |  |  | 3
 | R13,R14 |  |  | 1206-5,23 кОм+-1% |  |  |  | 2
Инв. № дубл. | R15,R16 |  |  | 1206-140 Ом+-1% |  |  |  | 2
 | R17 |  |  | 1206-30 Ом+-5% |  |  |  | 1
 | R18,R19 |  |  | 1206-102 Ом+-1% |  |  |  | 2
Взам. инв.№ | R20,R21 |  |  | 1206-215 Ом+-1% |  |  |  | 2
 | R22 |  |  | 1206-30 Ом+-5% |  |  |  | 1
Подп. и дата
 |  |  |  |  |  |  | УШЯИ 687243.351 ПЭ3
 | Изм. | Лист | № докум. |  | Подп. | Дата
Инв. № подл. | Разраб. |  | Сидорик |  |  |  | Плата интерфейса |  | Лит. |  | Лист | Листов
 | Пров. |  | Лисенков |  |  |  |  |  |  |  | 1 | 2
 | Согл. |  | Голод
 | Н.контр |  | Ильина
 | Утв. |  | Грицев |  |  |  | Перечень элементов

Sheet: 2
 | Поз. обозна- чение |  |  | Наименование |  |  |  | Кол. | Примечание
 |  |  |  | Резисторы
 | R23 |  |  | 1206-1 кОм+-5% |  |  |  | 1
 |  |  |  | Диоды
 | VD1-VD5 |  |  | SFH203 |  |  |  | 5
 | VD6,VD7 |  |  | VSMY2853RG |  |  |  | 2
 | VD8 |  |  | BZX384-C4V7 |  |  |  | 1
 |  |  |  | Транзисторы
 | VT1,VT2 |  |  | BSS138BK |  |  |  | 2
Подп. и дата |  |  |  | Вилки
 | XP1 |  |  | DS1018-02-16B2 |  |  |  | 1
Инв. № дубл. |  |  |  | Розетки
 | XS1 |  |  | IDC2-16 |  |  |  | 1
Взам. инв.№
Подп. и дата
Инв. № подл.
 |  |  |  |  |  |  | УШЯИ 687243.351 ПЭ3 |  |  | Лист
 |  |  |  |  |  |  |  |  |  | 2
 | Изм. | Лист | № докум. |  | Подп. | Дата
