Sasha7b9Work/LiniaServer/_Лисенков/Для отчета ИНТЕГРАЛу/Плата Источника УШЯИ.687245.044_ПЭ3.xls

Sheet: . Первый лист.
Перв. примен. | Поз. обозна-чение |  |  | Наименование |  |  |  | Кол. |  | Примечание
 |  |  |  | Конденсаторы
 | C1 |  |  | К73-14М-4 кВ-0,033 мкФ +-10% |  |  |  | 1
 | C2,C3 |  |  | К73-17-250 В-0,47 мкФ +-20% |  |  |  | 2
Справ. № | C4,C5 |  |  | К73-14М-4 кВ-0,1 мкФ +-10% |  |  |  | 2
 | C6,C7 |  |  | LGG2G331MELB30 |  |  |  | 2
 | C8 |  |  | К10-17б-M1500-1200 пФ +-5% |  |  |  | 1
 | C9,C10 |  |  | 1206-X7R-50 B-0,33 мкФ+-10% |  |  |  | 2
 | C11-C13 |  |  | 0805-X7R-25 В-0,1 мкФ +-10% |  |  |  | 3
 | C14-C16 |  |  | 1206-X7R-50 B-0,33 мкФ+-10% |  |  |  | 3
 | C17-C19 |  |  | 0805-X7R-25 В-0,1 мкФ +-10% |  |  |  | 3
 | C20,C21 |  |  | 1206-X7R-50 B-0,33 мкФ+-10% |  |  |  | 2
 |  |  |  | Микросхемы
Подп. и дата
 | DA1 |  |  | ADuM1100AR |  |  |  | 1
 | DA2,DA3 |  |  | ADM2486BRWZ |  |  |  | 2
 | DA4 |  |  | MAX809S |  |  |  | 1
Инв. № дубл. | DD1-DD3 |  |  | ULQ2003AD |  |  |  | 3
 | DD4 |  |  | IN74HC08AD |  |  |  | 1
 | DD5 |  |  | IN74HC04AD |  |  |  | 1
Взам. инв.№ | DD6 |  |  | IN74HC00AD |  |  |  | 1
 | DD7-DD9 |  |  | IN74HC02AD |  |  |  | 3
Подп. и дата
 |  |  |  |  |  |  | УШЯИ 687245.044 ПЭ3
 |  |  | УШЯИ.687245.044 ПЭ3
 | Изм. | Лист | № докум. |  | Подп. | Дата
Инв. № подл. | Разраб. |  | Сидорик |  |  |  | Плата источника |  | Лит. |  | Лист | Листов
 | Пров. |  | Лисенков |  |  |  |  |  |  |  | 1 | 5
 | Согл. |  | Голод
 | Н.контр |  | Ильинина
 | Утв. |  | Грицев |  |  |  | Перечень элементов

Sheet: 2
 | Поз. обозна- чение |  |  | Наименование |  |  |  | Кол. | Примечание
 |  |  |  | Микросхемы
 | DD10 |  |  | IN74HC86AD |  |  |  | 1
 | DD11 |  |  | IN74HC595AD |  |  |  | 1
 | DD12 |  |  | IN74HC138AD |  |  |  | 1
 |  |  |  | Реле
 | K1 |  |  | УШЯИ.685442.092vs2Rel |  |  |  | 1
 | K2-K10 |  |  | DAR71210TU |  |  |  | 9
 | K11,K12 |  |  | TLP3549F |  |  |  | 2
 | K13-K18 |  |  | DAR71210TU |  |  |  | 6
 |  |  |  | Резисторы
Подп. и дата
 | R1 |  |  | С2-33Н-0,5-270 Ом +-5% |  |  |  | 1
 | R2 |  |  | С2-33-2-1,2 кОм +-5% |  |  |  | 1
 | R3 |  |  | С2-33Н-1-10 кОм +-5% |  |  |  | 1
Инв. № дубл. | R4 |  |  | С2-33Н-1-15 Ом +-5% |  |  |  | 1
 | R5 |  |  | С2-33-2-1,2 кОм +-5% |  |  |  | 1
 | R6 |  |  | С2-33Н-1-10 кОм +-5% |  |  |  | 1
Взам. инв.№ | R7 |  |  | С2-33-2-15 Ом +-5% |  |  |  | 1
 | R8,R9 |  |  | С2-33-2-300 Ом +-5% |  |  |  | 2
 | R10-R12 |  |  | С2-33-2-1,2 кОм +-5% |  |  |  | 3
Подп. и дата | R13 |  |  | С2-33-2-15 кОм +-5% |  |  |  | 1
 | R14,R15 |  |  | 1206-10 Ом+-5% |  |  |  | 2
 | R16 |  |  | С2-33Н-0,5-3 Ом +-5% |  |  |  | 1
 | R17,R18 |  |  | С2-33-2-470 кОм +-5% |  |  |  | 2
 | R19 |  |  | С2-33-2-15 кОм +-5% |  |  |  | 1
Инв. № подл. | R20-R22 |  |  | С2-33Н-0,5-3 Ом +-5% |  |  |  | 3
 |  |  |  |  |  |  | УШЯИ 687245.044 ПЭ3 |  |  | Лист
 |  |  | УШЯИ.687245.044 ПЭ3
 |  |  |  |  |  |  |  |  |  | 2
 | Изм. | Лист | № докум. |  | Подп. | Дата

Sheet: 3
 | Поз. обозна- чение |  |  | Наименование |  |  |  | Кол. | Примечание
 |  |  |  | Резисторы
 | R23,R24 |  |  | 1206-470 Ом+-5% |  |  |  | 2
 | R25,R26 |  |  | С2-33Н-1-1 МОм +-5% |  |  |  | 2
 | R27,R28 |  |  | С2-33-2-1,2 кОм +-5% |  |  |  | 2
 | R29,R30 |  |  | С2-33-2-3,3 кОм +-5% |  |  |  | 2
 | R31,R32 |  |  | С2-33Н-1-1 кОм +-5% |  |  |  | 2
 | R33 |  |  | Р1-32-1-18 МОм +-5% |  |  |  | 1
 | R34,R35 |  |  | 1206-100 Ом+-5% |  |  |  | 2
 | R36,R37 |  |  | 1206-12 кОм+-5% |  |  |  | 2
 | R38,R39 |  |  | 1206-22 кОм+-5% |  |  |  | 2
 |  |  |  | Переключатели
Подп. и дата | S1,S2 |  |  | МКА-50202 |  |  |  | 2
 |  |  |  | Диоды
Инв. № дубл. | VD1,VD2 |  |  | 20ETF08/IR |  |  |  | 2
 | VD3,VD4 |  |  | BY255/Taw |  |  |  | 2
 | VD5,VD6 |  |  | HVM8 |  |  |  | 2
Взам. инв.№ | VD7,VD8 |  |  | 1N4148WS |  |  |  | 2
 |  |  |  | Соединения контактные
Подп. и дата
 | X1-X6 |  |  | TR-1,25-4 |  |  |  | 6
Инв. № подл.
 |  |  |  |  |  |  | УШЯИ 687245.044 ПЭ3 |  |  | Лист
 |  |  | УШЯИ.687245.044 ПЭ3
 |  |  |  |  |  |  |  |  |  | 3
 | Изм. | Лист | № докум. |  | Подп. | Дата

Sheet: 4
 | Поз. обозна- чение |  |  | Наименование |  |  |  | Кол. | Примечание
 |  |  |  | Вилки
 | XP1 |  |  | BH2-10 |  |  |  | 1
 | XP2 |  |  | 280371-2 |  |  |  | 1
 |  |  |  | Соединения разборные
 | XT1 |  |  | УШЯИ.685631.123 |  |  |  | 1
Подп. и дата
Инв. № дубл.
Взам. инв.№
Подп. и дата
Инв. № подл.
 |  |  |  |  |  |  | УШЯИ 687245.044 ПЭ3 |  |  | Лист
 |  |  | УШЯИ.687245.044 ПЭ3
 |  |  |  |  |  |  |  |  |  | 4
 | Изм. | Лист | № докум. |  | Подп. | Дата

Sheet: Лист регистрации изменений.
 | Лист регистрации изменений
 | Изм. |  | Номера листов (страниц) |  |  |  |  |  |  |  | Всего листов (страниц) в докум. | № докум. | Входящий № сопроводи-тельного документа и дата | Под- пись | Дата
 |  |  | изменен- ных |  | заменен- ных |  | новых |  |  | аннули- рован- ных
Подп. и дата
Инв. № дубл.
Взам. инв.№
Подп. и дата
Инв. № подл.
 |  |  |  |  |  |  |  |  | УШЯИ 687245.044 ПЭ3 |  |  |  |  |  |  | Лист
 |  |  |  | УШЯИ.687245.044 ПЭ3
 |  |  |  |  |  |  |  |  |  |  |  |  |  |  |  | 5
 | Изм. | Лист |  | № докум. |  | Подп. |  | Дата
