Sasha7b9Work/LiniaServer/_Лисенков/Для отчета ИНТЕГРАЛу/Плата оптоформирователя УШЯИ.687243.350_ПЭ3.xls

Sheet: . Первый лист.
Перв. примен. | Поз. обозна-чение |  |  | Наименование |  |  |  | Кол. |  | Примечание
 |  |  |  | Конденсаторы
 | C1-C5 |  |  | 0805-X7R-25 В-0,1 мкФ +-10% |  |  |  | 5
 | C6,C7 |  |  | 0805-NP0-50 В-2,4 пФ-1% |  |  |  | 2
Справ. № | C8,C9 |  |  | 1206-С0G-50 B-56 пФ+-1% |  |  |  | 2
 |  |  |  | Микросхемы
 | DA1-DA5 |  |  | SN65HVD75D |  |  |  | 5
 | DA6,DA7 |  |  | ADA4807-2ARMZ |  |  |  | 2
 | DD1 |  |  | IN74HC00AD |  |  |  | 1
 |  |  |  | Резисторы
Подп. и дата | R1-R8 |  |  | 1206-1 кОм+-5% |  |  |  | 8
 | R9-R13 |  |  | 1206-100 Ом+-5% |  |  |  | 5
 | R14 |  |  | 0805-10 KОМ+-5% |  |  |  | 1
 | R15-R19 |  |  | 1206-30 Ом+-5% |  |  |  | 5
Инв. № дубл. | R20,R21 |  |  | 1206-5,23 кОм+-1% |  |  |  | 2
 | R22,R23 |  |  | 1206-140 Ом+-1% |  |  |  | 2
 | R24,R25 |  |  | 1206-102 Ом+-1% |  |  |  | 2
Взам. инв.№ | R26,R27 |  |  | 1206-215 Ом+-1% |  |  |  | 2
Подп. и дата
 |  |  |  |  |  |  | УШЯИ 687243.350 ПЭ3
 | Изм. | Лист | № докум. |  | Подп. | Дата
Инв. № подл. | Разраб. |  | Сидорик |  |  |  | Плата оптоформирователя |  | Лит. |  | Лист | Листов
 | Пров. |  | Лисенков |  |  |  |  |  |  |  | 1 | 2
 | Согл. |  | Голод
 | Н.контр |  | Ильина
 | Утв. |  | Грицев |  |  |  | Перечень элементов

Sheet: 2
 | Поз. обозна- чение |  |  | Наименование |  |  |  | Кол. | Примечание
 |  |  |  | Диоды
 | VD1-VD5 |  |  | VSMY2853RG |  |  |  | 5
 | VD6,VD7 |  |  | SFH203 |  |  |  | 2
 |  |  |  | Транзисторы
 | VT1-VT5 |  |  | BSS138BK |  |  |  | 5
 |  |  |  | Вилки
 | XP1 |  |  | BH2-20R |  |  |  | 1
Подп. и дата
Инв. № дубл.
Взам. инв.№
Подп. и дата
Инв. № подл.
 |  |  |  |  |  |  | УШЯИ 687243.350 ПЭ3 |  |  | Лист
 |  |  |  |  |  |  |  |  |  | 2
 | Изм. | Лист | № докум. |  | Подп. | Дата
