Sasha7b9Work/LiniaServer/_Лисенков/Для отчета ИНТЕГРАЛу/Плата Выпрямитель УШЯИ.687253.019_ПЭ3.xls

Sheet: . Первый лист.
Линия-2 | Перв. примен. | Поз. обозна-чение |  |  | Наименование |  |  |  | Кол. |  | Примечание
 |  |  |  |  | Конденсаторы
 |  | C1 |  |  | К73-17-250 В-1 мкФ +-20% |  |  |  | 1
 |  | C2,C3 |  |  | GRM2165C2A102JA01D |  |  |  | 2
 | Справ. № | C4 |  |  | К73-17-250 В-1 мкФ +-20% |  |  |  | 1
 |  | C5,C6 |  |  | К73-17-250 В-0,47 мкФ +-20% |  |  |  | 2
 |  |  |  |  | Резисторы
 |  | R1,R2 |  |  | 1206-9,1 кОм+-5% |  |  |  | 2
 |  | R3,R4 |  |  | 1206-240 Ом+-5% |  |  |  | 2
 |  | R5 |  |  | 1206-9,1 кОм+-5% |  |  |  | 1
 |  | R6,R7 |  |  | 1206-150 Ом+-5% |  |  |  | 2
 |  | R8 |  |  | 1206-100 Ом+-5% |  |  |  | 1
 | Подп. и дата
 |  |  |  |  | Диоды
 |  | VD1,VD2 |  |  | 43CTQ100 |  |  |  | 2
 | Инв. № дубл. | VD3,VD4 |  |  | 1,5KE68CA |  |  |  | 2
 |  | VD5,VD6 |  |  | 1N4007 |  |  |  | 2
 | Взам. инв.№
 | Подп. и дата
 |  |  |  |  |  |  |  | УШЯИ 687253.019 ПЭ3
 |  | Изм. | Лист | № докум. |  | Подп. | Дата
 | Инв. № подл. | Разраб. |  | Сидорик |  |  |  | Плата выпрямителя |  | Лит. |  | Лист | Листов
 |  | Пров. |  | Лисенков |  |  |  |  |  |  |  | 1 | 2
 |  | Согл. |  | Голод
 |  | Н.контр |  | Ильина
 |  | Утв. |  | Грицев |  |  |  | Перечень элементов

Sheet: 2
Линия-2 |  | Поз. обозна- чение |  |  | Наименование |  |  |  | Кол. | Примечание
 |  |  |  |  | Вилки
 |  | XP1 |  |  | MNL-350810-1 |  |  |  | 1
 | Подп. и дата
 | Инв. № дубл.
 | Взам. инв.№
 | Подп. и дата
 | Инв. № подл.
 |  |  |  |  |  |  |  | УШЯИ.687253.019 ПЭ3 |  |  | Лист
 |  |  |  |  |  |  |  |  |  |  | 2
 |  | Изм. | Лист | № докум. |  | Подп. | Дата
