Sasha7b9Work/LiniaServer/_Лисенков/Для отчета ИНТЕГРАЛу/Плата Защиты УШЯИ.687242.236_ПЭ3.xls

ЛИНИЯ-2 | Перв. примен. | Поз. обозна-чение |  |  | Наименование |  |  |  | Кол. |  | Примечание
 |  |  |  |  | Резисторы
 |  | R1 |  |  | OAR3-R005FI |  |  |  | 1
 | Справ. № |  |  |  | Диоды
 |  | VD1,VD2 |  |  | 43CTQ100 |  |  |  | 2
 | Подп. и дата
 | Инв. № дубл.
 | Взам. инв.№
 | Подп. и дата
 |  |  |  |  |  |  |  | УШЯИ 687242.236 ПЭ3
 |  | Изм. | Лист | № докум. |  | Подп. | Дата
 | Инв. № подл. | Разраб. |  | Сидорик |  |  |  | Плата защиты |  | Лит. |  | Лист | Листов
 |  | Пров. |  | Лисенков |  |  |  |  |  |  |  |  | 1
 |  | Согл. |  | Голод
 |  | Н.контр |  | Ильина
 |  | Утв. |  | Грицев |  |  |  | Перечень элементов
