Sasha7b9Work/LiniaServer/_Лисенков/Для отчета ИНТЕГРАЛу/плата УШЯИ 687253.018_ПЭ3.xls

Перв. примен. | Поз. обозна-чение |  |  | Наименование |  |  |  | Кол. |  | Примечание
 |  |  |  | Конденсаторы
 | C1-C4 |  |  | B43640A2228M000 |  |  |  | 4
Справ. № |  |  |  | Резисторы
 | R1,R2 |  |  | С2-33Н-0,5-24 кОм +-5% |  |  |  | 2
 | R3-R6 |  |  | OAR3-R005FI |  |  |  | 4
 |  |  |  | Соединения контактные
 | X1 |  |  | TR-3.5-4 |  |  |  | 1
 |  |  |  | Вилки
Подп. и дата
 | XP1 |  |  | 280373-2 |  |  |  | 1
 |  |  |  | Соединения разборные
Инв. № дубл.
 | XT1 |  |  | УШЯИ.685631.123 |  |  |  | 1
Взам. инв.№
Подп. и дата
 |  |  |  |  |  |  | УШЯИ 687253.018 ПЭ3
 | Изм. | Лист | № докум. |  | Подп. | Дата
Инв. № подл. | Разраб. |  | Сидорик |  |  |  | Плата |  | Лит. |  | Лист | Листов
 | Пров. |  | Лисенков |  |  |  |  |  |  |  |  | 1
 | Согл. |  | Голод
 | Н.контр |  | Ильина
 | Утв. |  | Грицев |  |  |  | Перечень элементов
