Sasha7b9Work/LiniaServer/_Лисенков/Перечни элементов/УШЯИ.467444.130_ПЭ3.xls

Sheet: УШЯИ.467444.130. Первый лист.
Перв. примен. | УШЯИ.467444.130 | Поз. обозна-чение |  |  | Наименование |  |  |  | Кол. |  | Примечание
 |  |  |  |  | Устройства
 |  | A1 |  |  | Orange Pi 5 Plus |  |  |  | 1
Справ. № |  |  |  |  | Конденсаторы
 |  | C1 |  |  | 0,1 µF |  |  |  | 1
 |  | C2 |  |  | 4,7 µF |  |  |  | 1
 |  | C3 |  |  | 0,1 µF |  |  |  | 1
 |  | C4,C5 |  |  | 1 µF |  |  |  | 2
 |  | C6-C10 |  |  | 0,1 µF |  |  |  | 5
 |  | C11 |  |  | 4,7 µF |  |  |  | 1
 |  | C12,C14 |  |  | 0,1 µF |  |  |  | 2
 |  | C15 |  |  | 0,1 µF |  |  |  | 1
Подп. и дата |  | C16 |  |  | 10 µF |  |  |  | 1
 |  | C17-C25 |  |  | 0,1 µF |  |  |  | 9
 |  | C26 |  |  | 4,7 µF |  |  |  | 1
 |  | C27 |  |  | 0,1 µF |  |  |  | 1
Инв. № дубл. |  | C28 |  |  | 4,7 µF |  |  |  | 1
 |  | C29 |  |  | 0,1 µF |  |  |  | 1
 |  | C30 |  |  | 4,7 µF |  |  |  | 1
Взам. инв.№ |  | C31-C39 |  |  | 0,1 µF |  |  |  | 9
 |  | C40 |  |  | 10 µF |  |  |  | 1
Подп. и дата
 |  |  |  |  |  |  |  | УШЯИ.467444.130ПЭ3
 |  | Изм. | Лист | № докум. |  | Подп. | Дата
Инв. № подл. |  | Разраб. |  | Петрович |  |  |  |  |  | Лит. |  | Лист | Листов
 |  | Пров. |  |  |  |  |  |  |  |  |  | 1 | 6
 |  | Н.контр
 |  | Утв. |  |  |  |  |  | Перечень элементов

Sheet: 2
 | Поз. обозна- чение |  |  | Наименование |  |  |  | Кол. | Примечание
 |  |  |  | Конденсаторы
 | C41-C58 |  |  | 0,1 µF |  |  |  | 18
 | C59 |  |  | 4,7 µF |  |  |  | 1
 | C60,C61 |  |  | 20 pF |  |  |  | 2
 | C62 |  |  | 10 µF |  |  |  | 1
 | C63 |  |  | 0,1 µF |  |  |  | 1
 | C64 |  |  | 10 µF |  |  |  | 1
 | C65 |  |  | 0,1 µF |  |  |  | 1
 | C66,C67 |  |  | 2,2 µF |  |  |  | 2
 | C68-C82 |  |  | 0,1 µF |  |  |  | 15
 | C84 |  |  | 0,1 µF |  |  |  | 1
 | C86 |  |  | 1000 µF |  |  |  | 1
 | C87 |  |  | 0,1 µF |  |  |  | 1
Подп. и дата | C88,C89 |  |  | 10 µF |  |  |  | 2
 | C90-C92 |  |  | 0,1 µF |  |  |  | 3
 | C93 |  |  | 10 µF |  |  |  | 1
 | C94,C95 |  |  | 0,1 µF |  |  |  | 2
Инв. № дубл.
 |  |  |  | Микросхемы
Взам. инв.№ | DA1 |  |  | LD1117AS33TR |  |  |  | 1
 | DA2 |  |  | LD1117AS25TR |  |  |  | 1
 | DA3 |  |  | LD1117AS12TR |  |  |  | 1
Подп. и дата | DA4 |  |  | LD1117AS33TR |  |  |  | 1
 | DA5-DA9 |  |  | ADM483AR |  |  |  | 5
 | DA10 |  |  | SN65HVD75D |  |  |  | 1
 | DA11,DA12 |  |  | ADM483AR |  |  |  | 2
 | DA13 |  |  | SN65HVD75D |  |  |  | 1
Инв. № подл. | DA14 |  |  | ADM483AR |  |  |  | 1
 |  |  |  |  |  |  | УШЯИ.467444.130ПЭ3 |  |  | Лист
 |  |  |  |  |  |  |  |  |  | 2
 | Изм. | Лист | № докум. |  | Подп. | Дата

Sheet: 3
 | Поз. обозна- чение |  |  | Наименование |  |  |  | Кол. | Примечание
 |  |  |  | Микросхемы
 | DA15,DA16 |  |  | SN65HVD75D |  |  |  | 2
 | DA17 |  |  | ADM483AR |  |  |  | 1
 | DA18,DA19 |  |  | SN65HVD75D |  |  |  | 2
 | DA20,DA21 |  |  | BNX028-01 |  |  |  | 2
 | DA22 |  |  | LD1117AS33TR |  |  |  | 1
 | DD1 |  |  | EP3C5E144I7 |  |  |  | 1
 | DD2 |  |  | O 20,0-JO32-B-3.3-1-T1-LF |  |  |  | 1
 | DD3 |  |  | EPCS4SI8N |  |  |  | 1
 | DD4 |  |  | STM32F429VIT6STM32F407ZGTx |  |  |  | 1
 | DD5 |  |  | USBUF01W6 |  |  |  | 1
 |  |  |  | Катушки индуктивности
Подп. и дата
 | L1 |  |  | 0,22 μH |  |  |  | 1
 | L2 |  |  |  |  |  |  | 1
 | L3-L5 |  |  | 0,22 μH |  |  |  | 3
Инв. № дубл. | L6-L10 |  |  |  |  |  |  | 5
 |  |  |  | Резисторы
Взам. инв.№
 | R2 |  |  | 51R |  |  |  | 1
 | R3 |  |  | 1k |  |  |  | 1
Подп. и дата | R4 |  |  | 10k |  |  |  | 1
 | R5 |  |  | 1k |  |  |  | 1
 | R6 |  |  | 10k |  |  |  | 1
 | R7 |  |  | 1k |  |  |  | 1
 | R8-R15 |  |  | 10k |  |  |  | 8
Инв. № подл. | R16 |  |  | 100R |  |  |  | 1
 |  |  |  |  |  |  | УШЯИ.467444.130ПЭ3 |  |  | Лист
 |  |  |  |  |  |  |  |  |  | 3
 | Изм. | Лист | № докум. |  | Подп. | Дата

Sheet: 4
 | Поз. обозна- чение |  |  | Наименование |  |  |  | Кол. | Примечание
 |  |  |  | Резисторы
 | R17 |  |  | 10k |  |  |  | 1
 | R18 |  |  | 100R |  |  |  | 1
 | R19-R21 |  |  | 10k |  |  |  | 3
 | R22-R24 |  |  | 100R |  |  |  | 3
 | R25 |  |  | 1k |  |  |  | 1
 | R26 |  |  | 100R |  |  |  | 1
 | R27 |  |  | 1k |  |  |  | 1
 | R28,R29 |  |  | 10k |  |  |  | 2
 | R30-R33 |  |  | 100R |  |  |  | 4
 | R34 |  |  | 1k |  |  |  | 1
 | R35,R36 |  |  | 10k |  |  |  | 2
 | R37 |  |  | 1k |  |  |  | 1
Подп. и дата | R38-R40 |  |  | 100R |  |  |  | 3
 | R41 |  |  | 1k |  |  |  | 1
 | R42 |  |  | 10k |  |  |  | 1
 | R43 |  |  | 1k |  |  |  | 1
Инв. № дубл. | R44,R45 |  |  | 100R |  |  |  | 2
 | R46 |  |  | 1k |  |  |  | 1
 | R47 |  |  | 100R |  |  |  | 1
Взам. инв.№ | R48,R49 |  |  | 1k |  |  |  | 2
 | R50 |  |  | 30R |  |  |  | 1
 | R51-R61 |  |  | 10k |  |  |  | 11
Подп. и дата
 |  |  |  | Вилки
 | XP1 |  |  | PLD-10 |  |  |  | 1
 | XP2 |  |  | AMPMODU II 280372-2 |  |  |  | 1
Инв. № подл. | XP3 |  |  | BH-40 |  |  |  | 1
 |  |  |  |  |  |  | УШЯИ.467444.130ПЭ3 |  |  | Лист
 |  |  |  |  |  |  |  |  |  | 4
 | Изм. | Лист | № докум. |  | Подп. | Дата

Sheet: 5
 | Поз. обозна- чение |  |  | Наименование |  |  |  | Кол. | Примечание
 |  |  |  | Вилки
 | XP4,XP5 |  |  | BH2-40 |  |  |  | 2
 | XP6 |  |  | BH2-20R |  |  |  | 1
 | XP7 |  |  | BH2-40 |  |  |  | 1
 | XP8,XP9 |  |  | AMPMODU II 280371-2 |  |  |  | 2
 | XP10 |  |  | BH2-20R |  |  |  | 1
 | XP11 |  |  | AMPMODU II 280371-2 |  |  |  | 1
 | XP12 |  |  | BH2-20R |  |  |  | 1
 | XP13 |  |  | BH2-10R |  |  |  | 1
 | XP14 |  |  | AMPMODU II 280371-2 |  |  |  | 1
 |  |  |  | Фильтры
Подп. и дата | ZQ1 |  |  | Q 25.0JXS63-12-30/30-FU |  |  |  | 1
Инв. № дубл.
Взам. инв.№
Подп. и дата
Инв. № подл.
 |  |  |  |  |  |  | УШЯИ.467444.130ПЭ3 |  |  | Лист
 |  |  |  |  |  |  |  |  |  | 5
 | Изм. | Лист | № докум. |  | Подп. | Дата

Sheet: Лист регистрации изменений.
 | Лист регистрации изменений
 | Изм. |  | Номера листов (страниц) |  |  |  |  |  |  |  | Всего листов (страниц) в докум. | № докум. | Входящий № сопроводи-тельного документа и дата | Под- пись | Дата
 |  |  | изменен- ных |  | заменен- ных |  | новых |  |  | аннули- рован- ных
Подп. и дата
Инв. № дубл.
Взам. инв.№
Подп. и дата
Инв. № подл.
 |  |  |  |  |  |  |  |  | УШЯИ.467444.130ПЭ3 |  |  |  |  |  |  | Лист
 |  |  |  |  |  |  |  |  |  |  |  |  |  |  |  | 6
 | Изм. | Лист |  | № докум. |  | Подп. |  | Дата
