Sasha7b9Work/LiniaServer/_Лисенков/КД/Плата Защиты УШЯИ.687242.236.xls

ЛИНИЯ-2 |  | Формат | Зона |  | Поз. |  | Обозначение |  |  |  | Наименование |  |  | Кол. | Примечание
 |  |  |  |  |  |  |  |  |  |  | Документация
 |  | А4 |  |  |  |  | УШЯИ.687242.236Э3 |  |  |  | Сборочный чертеж
 |  |  |  |  |  |  |  |  |  |  | Детали
 | Справ. №
 |  | А4 |  |  | 1 |  | УШЯИ.758721.097 |  |  |  | Плата печатная |  |  | 1
 |  |  |  |  |  |  |  |  |  |  | Стандартные изделия
 |  |  |  |  |  |  |  |  |  |  | Резисторы
 |  |  |  |  | 2 |  |  |  |  |  | OAR3-R005FI |  |  | 1 | R1
 |  |  |  |  |  |  |  |  |  |  | Диоды
 |  |  |  |  | 3 |  |  |  |  |  | 43CTQ100 |  |  | 2 | VD1, VD2
 | Подп. и дата
 | Инв. № дубл.
 | Взам. инв. №
 | Подп. и дата
 |  |  |  |  |  |  |  |  |  | УШЯИ.687242.236
 |  | Изм. |  | Лист |  | № докум. |  | Подп. | Дата
 | Инв. № подл. | Разраб. |  |  |  | Сидорик |  |  |  | Плата защиты |  | Лит. | Лист |  |  | Листов
 |  | Пров. |  |  |  | Голод |  |  |  |  |  |  |  |  |  | 1
 |  | Согл. |  |  |  |  |  |  |  |  |  | ОАО «МНИПИ»
 |  | Н. контр. |  |  |  | Ильина
 |  | Утв. |  |  |  | Грицев
