Sasha7b9Work/LiniaServer/_Лисенков/КД/Плата Источника УШЯИ.687245.044.xls

Sheet: . Первый лист.
Перв. примен. | Формат | Зона |  | Поз. |  | Обозначение |  |  |  | Наименование |  |  | Кол. | Примечание
 |  |  |  |  |  |  |  |  |  | Документация
 | A2 |  |  |  |  | УШЯИ.687245.044 СБ |  |  |  | Сборочный чертёж
 |  |  |  |  |  |  |  |  |  | Сборочные единицы
Справ. №
 | A4 |  |  | 1 |  | УШЯИ.301421.012 |  |  |  | Стойка |  |  | 19
 | A4 |  |  | 2 |  | УШЯИ.685442.092 |  |  |  | Катушка |  |  | 1
 | A4 |  |  | 3 |  | УШЯИ.685631.123 |  |  |  | Стойка |  |  | 1
 | A4 |  |  | 4 |  | УШЯИ.685612.146-03 |  |  |  | Провод |  |  | 1
 |  |  |  | 5 |  | -04 |  |  |  | Провод |  |  | 1
 |  |  |  | 6 |  | -05 |  |  |  | Провод |  |  | 1
 |  |  |  | 7 |  | -06 |  |  |  | Провод |  |  | 1
 | A4 |  |  | 8 |  | УШЯИ.685612.147-01 |  |  |  | Провод |  |  | 1
 |  |  |  |  |  |  |  |  |  | Детали
Подп. и дата
 | A3 |  |  | 9 |  | УШЯИ.753513.038-01 |  |  |  | Пружина |  |  | 2
 | A4 |  |  | 10 |  | УШЯИ 758727.206 |  |  |  | Плата печатная |  |  | 1
Инв. № дубл.
Взам. инв. №
Подп. и дата
 |  |  |  |  |  |  |  |  | УШЯИ.687245.044
 | Изм. |  | Лист |  | № докум. |  | Подп. | Дата
Инв. № подл. | Разраб. |  |  |  | Сидорик |  |  |  | Плата источника |  | Лит. | Лист |  |  | Листов
 | Пров. |  |  |  | Голод |  |  |  |  |  |  | 1 |  |  | 5
 | Согл. |  |  |  |  |  |  |  |  |  | ОАО "МНИПИ"
 | Н. контр. |  |  |  | Ильина
 | Утв. |  |  |  | Грицев

Sheet: Лист2
 | Формат | Зона |  | Поз. |  | Обозначение |  |  |  | Наименование | Кол. | Примечание
 |  |  |  |  |  |  |  |  |  | Стандартные изделия
 |  |  |  | 11 |  |  |  |  |  | Винт В2.M4-6gx8.36.016 | 1
 |  |  |  |  |  |  |  |  |  | ГОСТ 17473-80
 |  |  |  | 12 |  |  |  |  |  | Шайба 4.04.013 | 1
 |  |  |  |  |  |  |  |  |  | ГОСТ 11371-78
 |  |  |  | 13 |  |  |  |  |  | Шайба 4.65Г.016 | 1
 |  |  |  |  |  |  |  |  |  | ГОСТ 6402-70
 |  |  |  |  |  |  |  |  |  | Материалы
 |  |  |  | 14 |  |  |  |  |  | Проволока ММ-08 | 0.8 | м
 |  |  |  |  |  |  |  |  |  | ТУ16-705.492-2005 |  | 0-Ви(99,8)6
 |  |  |  | 15 |  |  |  |  |  | Трубка 305 ТВ-40 1,5 | 0.8 | м
 |  |  |  |  |  |  |  |  |  | белая первого сорта
 |  |  |  |  |  |  |  |  |  | ГОСТ 19034-82
Подп. и дата
Инв. № дубл.
Взам. инв. №
Подп. и дата
Инв. № подл.
 |  |  |  |  |  |  |  |  | УШЯИ.687245.044 |  |  |  | Лист
 |  |  |  |  |  |  |  |  |  |  |  |  | 2
 | Изм. |  | Лист |  | № докум. |  | Подп. | Дата
