Sasha7b9Work/LiniaServer/_Лисенков/КД/УШЯИ 687253.017.xls

Sheet: . Первый лист.
Перв. примен. | Формат | Зона |  | Поз. |  | Обозначение |  |  |  | Наименование |  |  | Кол. | Примечание
 |  |  |  |  |  |  |  |  |  | Документация
 |  |  |  |  |  | УШЯИ.687253.017 СБ |  |  |  | Сборочный чертеж |  |  | 1
 |  |  |  |  |  |  |  |  |  | Сборочные единицы
Справ. №
 | А4 |  |  | 1 |  | УШЯИ.685621.680 |  |  |  | Жгут |  |  | 1
 | А4 |  |  | 2 |  | УШЯИ.685612.145 |  |  |  | Провод |  |  | 1
 |  |  |  |  |  | -01 |  |  |  |  |  |  | 1
 |  |  |  |  |  | -02 |  |  |  |  |  |  | 1
 |  |  |  |  |  | -03 |  |  |  |  |  |  | 1
 | А4 |  |  | 3 |  | УШЯИ.685612.146 |  |  |  | Провод |  |  | 1
 |  |  |  |  |  | -01 |  |  |  |  |  |  | 1
 |  |  |  |  |  | -02 |  |  |  |  |  |  | 1
 |  |  |  |  |  |  |  |  |  | Детали
Подп. и дата
 | А4 |  |  | 4 |  | УШЯИ.745312.362 |  |  |  | Кронштейн |  |  | 1
 | А3 |  |  | 5 |  | УШЯИ.758725.629 |  |  |  | Плата печатная |  |  | 1
Инв. № дубл.
Взам. инв. №
Подп. и дата
 |  |  |  |  |  |  |  |  | УШЯИ.687253.017
 | Изм. |  | Лист |  | № докум. |  | Подп. | Дата
Инв. № подл. | Разраб. |  |  |  | Сидорик |  |  |  | Плата |  | Лит. | Лист |  |  | Листов
 | Пров. |  |  |  | Голод |  |  |  |  |  |  | 1 |  |  | 6
 | Согл. |  |  |  |  |  |  |  |  |  | ОАО "МНИПИ"
 | Н. контр. |  |  |  | Ильина
 | Утв. |  |  |  | Грицев

Sheet: Лист2
 | Формат | Зона |  | Поз. |  | Обозначение |  |  |  | Наименование | Кол. | Примечание
 |  |  |  |  |  |  |  |  |  | Стандартные изделия
 |  |  |  | 6 |  |  |  |  |  | Винт М2-6gx…36.013 | 4
 |  |  |  |  |  |  |  |  |  | ГОСТ 17475-80
 |  |  |  | 7 |  |  |  |  |  | Гайка М2 74.04.13 | 4
 |  |  |  |  |  |  |  |  |  | ГОСТ 5916-70
 |  |  |  | 8 |  |  |  |  |  | Шайба 2.04.013 | 4
 |  |  |  |  |  |  |  |  |  | ГОСТ 11371-78
Подп. и дата
Инв. № дубл.
Взам. инв. №
Подп. и дата
Инв. № подл.
 |  |  |  |  |  |  |  |  | УШЯИ.687253.017 |  |  |  | Лист
 |  |  |  |  |  |  |  |  |  |  |  |  | 2
 | Изм. |  | Лист |  | № докум. |  | Подп. | Дата
