Sasha7b9Work/LiniaServer/_Лисенков/КД/УШЯИ 687253.018.xls

Перв. примен. | Формат | Зона |  | Поз. |  | Обозначение |  |  |  | Наименование |  |  | Кол. | Примечание
 |  |  |  |  |  |  |  |  |  | Документация
 |  |  |  |  |  | УШЯИ 687253.018 СБ |  |  |  | Сборочный чертеж |  |  | 1
 |  |  |  |  |  |  |  |  |  | Сборочные единицы
Справ. №
 | A4 |  |  | 1 |  | УШЯИ.685612.147 |  |  |  | Провод |  |  | 1
 |  |  |  | 2 |  | -02 |  |  |  | Провод |  |  | 1
 |  |  |  | 3 |  | -03 |  |  |  | Провод |  |  | 1
 |  |  |  |  |  |  |  |  |  | Детали
 |  |  |  | 4 |  | УШЯИ.753124.036 |  |  |  | Стойка |  |  | 1
 |  |  |  | 5 |  | УШЯИ.758442.015 |  |  |  | Гайка |  |  | 1
 |  |  |  | 6 |  | УШЯИ 758724.375 |  |  |  | Плата печатная |  |  | 1
Подп. и дата |  |  |  |  |  |  |  |  |  | Стандартные изделия
 |  |  |  | 7 |  |  |  |  |  | Винт В2.М4-6gx8.36.016 |  |  | 1
 |  |  |  |  |  |  |  |  |  | ГОСТ 17473-80
Инв. № дубл. |  |  |  | 8 |  |  |  |  |  | Шайба 4.04.013 |  |  | 2
 |  |  |  |  |  |  |  |  |  | ГОСТ 11371-78
 |  |  |  | 9 |  |  |  |  |  | Шайба 4.65Г.016 |  |  | 2
Взам. инв. № |  |  |  |  |  |  |  |  |  | ГОСТ 6402-70
Подп. и дата
 |  |  |  |  |  |  |  |  | УШЯИ.687253.018
 | Изм. |  | Лист |  | № докум. |  | Подп. | Дата
Инв. № подл. | Разраб. |  |  |  | Сидорик |  |  |  | Плата |  | Лит. | Лист |  |  | Листов
 | Пров. |  |  |  | Голод |  |  |  |  |  |  |  |  |  | 1
 | Согл. |  |  |  |  |  |  |  |  |  | ОАО "МНИПИ"
 | Н. контр. |  |  |  | Ильина
 | Утв. |  |  |  | Грицев
