Sasha7b9Work/LiniaServer/_Лисенков/КД/Формирователь Развертки УШЯИ.411522.033.xls

Sheet: . Первый лист.
Перв. примен. | Формат | Зона |  | Поз. |  | Обозначение |  |  |  | Наименование |  |  | Кол. | Примечание
 |  |  |  |  |  |  |  |  |  | Документация
 | А2 |  |  |  |  | УШЯИ. 411522.033 СБ |  |  |  | Сборочный чертеж
 |  |  |  |  |  |  |  |  |  | Сборочные единицы
Справ. №
 | А4 |  |  | 1 |  | УШЯИ.301417.022 |  |  |  | Радиатор |  |  | 1
 | А4 |  |  | 2 |  | УШЯИ.301421.012 |  |  |  | Стойка |  |  | 10
 | А4 |  |  | 3 |  | УШЯИ.685621.521 |  |  |  | Жгут |  |  | 1
 |  |  |  |  |  |  |  |  |  | Детали
 | А4 |  |  | 4 |  | УШЯИ.745418.110 |  |  |  | Экран |  |  | 1
 | А4 |  |  | 5 |  | УШЯИ.745512.303 |  |  |  | Кронштейн |  |  | 2
 | А4 |  |  | 6 |  | УШЯИ.745512.799 |  |  |  | Крышка |  |  | 1
 | А4 |  |  | 7 |  | УШЯИ.758727.205 |  |  |  | Плата печатная |  |  | 1
Подп. и дата | А4 |  |  | 8 |  | Тг.750.224 |  |  |  | Лепесток |  |  | 5
Инв. № дубл.
Взам. инв. №
Подп. и дата
 |  |  |  |  |  |  |  |  | УШЯИ.411522.033
 | Изм. |  | Лист |  | № докум. |  | Подп. | Дата
Инв. № подл. | Разраб. |  |  |  | Сидорик |  |  |  | Формирователь развертки |  | Лит. | Лист |  |  | Листов
 | Пров. |  |  |  | Голод |  |  |  |  |  |  | 1 |  |  | 8
 | Согл. |  |  |  |  |  |  |  |  |  | ОАО "МНИПИ"
 | Н. контр. |  |  |  | Ильина
 | Утв. |  |  |  | Грицев

Sheet: 2
 | Формат | Зона |  | Поз. |  | Обозначение |  |  | Наименование | Кол. | Примечание
 |  |  |  |  |  |  |  |  | Стандартные изделия
 |  |  |  | 9 |  |  |  |  | Винт В.М3-6gx8.36.016 | 4
 |  |  |  |  |  |  |  |  | ГОСТ 17474-80
 |  |  |  | 10 |  |  |  |  | Гайка M3-7H.04.016 | 2
 |  |  |  |  |  |  |  |  | ГОСТ 5916-70
 |  |  |  | 11 |  |  |  |  | Шайба A3.04.013 | 6
 |  |  |  |  |  |  |  |  | ГОСТ 10450-78
 |  |  |  |  |  |  |  |  | Материалы
 |  |  |  | 12 |  |  |  |  | Провод МГТФ-0,2 | 0.6 | м
 |  |  |  |  |  |  |  |  | ТУ16-505.185-71
 |  |  |  | 13 |  |  |  |  | Проволока ММ-0,6 | 0.2 | м
 |  |  |  |  |  |  |  |  | ТУ16-705.492-2005 |  | 0-Ви(998)6
Подп. и дата
Инв. № дубл.
Взам. инв. №
Подп. и дата
Инв. № подл.
 |  |  |  |  |  |  |  |  |  |  |  | Лист
 |  |  |  |  |  |  |  |  |  |  |  | 2
 | Изм. |  | Лист |  | № докум. |  | Подп. | Дата
