Sasha7b9Work/LiniaServer/_Лисенков/Temp/Плата Выпрямитель УШЯИ.687253.019.xls

Линия-2 | Перв. примен. | Формат | Зона |  | Поз. |  | Обозначение |  |  |  | Наименование |  |  | Кол. | Примечание
 |  |  |  |  |  |  |  |  |  |  | Документация
 |  |  |  |  |  |  | УШЯИ.687253.019 СБ |  |  |  | Сборочный чертёж |  |  | 1
 |  |  |  |  |  |  |  |  |  |  | Сборочные единицы
 | Справ. №
 |  | А4 |  |  | 1 |  | УШЯИ.685621.597 |  |  |  | Жгут
 |  |  |  |  |  |  |  |  |  |  | Детали
 |  | А4 |  |  | 2 |  | УШЯИ.745512.303 |  |  |  | Кронштейн |  |  | 2
 |  | А4 |  |  | 3 |  | УШЯИ.745312.362 |  |  |  | Кронштейн |  |  | 1
 |  | А4 |  |  | 4 |  | УШЯИ.758725.630 |  |  |  | Плата печатная |  |  | 1
 |  |  |  |  |  |  |  |  |  |  | Стандартные изделия
 | Подп. и дата |  |  |  | 4 |  |  |  |  |  | Винт В.М3-6gx8.36.016 |  |  | 2
 |  |  |  |  |  |  |  |  |  |  | ГОСТ 17474-80
 |  |  |  |  | 5 |  |  |  |  |  | Гайка M3-7H.04.016 |  |  | 2
 |  |  |  |  |  |  |  |  |  |  | ГОСТ 5916-70
 | Инв. № дубл. |  |  |  | 6 |  |  |  |  |  | Шайба A3.04.013 |  |  | 4
 |  |  |  |  |  |  |  |  |  |  | ГОСТ 10450-78
 | Взам. инв. №
 | Подп. и дата
 |  |  |  |  |  |  |  |  |  | УШЯИ.687253.019
 |  | Изм. |  | Лист |  | № докум. |  | Подп. | Дата
 | Инв. № подл. | Разраб. |  |  |  | Сидорик |  |  |  | Плата выпрямителя |  | Лит. | Лист |  |  | Листов
 |  | Пров. |  |  |  | Голод |  |  |  |  |  |  | 1 |  |  | 2
 |  | Согл. |  |  |  |  |  |  |  |  |  | ОАО "МНИПИ"
 |  | Н. контр. |  |  |  | Ильина
 |  | Утв. |  |  |  | Грицев
