Sasha7b9Work/LiniaServer/_Лисенков/Temp/Плата Источника УШЯИ.687245.044.xls

Перв. примен. | Формат | Зона |  | Поз. |  | Обозначение |  |  |  | Наименование |  |  | Кол. | Примечание
 |  |  |  |  |  |  |  |  |  | Документация
 | A2 |  |  |  |  | УШЯИ.687245.044 СБ |  |  |  | Сборочный чертёж
 |  |  |  |  |  |  |  |  |  | Сборочные единицы
Справ. №
 | A4 |  |  | 2 |  | УШЯИ.301421.012 |  |  |  | Стойка |  |  | 19
 | A4 |  |  | 3 |  | УШЯИ.685631.123 тут с изоляц |  |  |  | Стойка
 | A4 |  |  | 4 |  | УШЯИ.685442.092 |  |  |  | Катушка |  |  | 1
 |  |  |  | 5 |  | УШЯИ.753513.038 |  |  |  | Пружина |  |  | 2
 |  |  |  |  |  |  |  |  |  | Детали
 | A3 |  |  |  |  | УШЯИ 758727.206 |  |  |  | Плата печатная |  |  | 1
 |  |  |  |  |  |  |  |  |  | Материалы
Подп. и дата
 |  |  |  |  |  |  |  |  |  | Проволока ММ-08 |  |  | 0.8 | м
 |  |  |  |  |  |  |  |  |  | ТУ16-705.492-2005 |  |  |  | 0-Ви(99,8)6
 |  |  |  |  |  |  |  |  |  | Трубка 305 ТВ-40 1,5 |  |  | 0.8 | м
Инв. № дубл. |  |  |  |  |  |  |  |  |  | белая первого сорта
 |  |  |  |  |  |  |  |  |  | ГОСТ 19034-82
Взам. инв. №
Подп. и дата
 |  |  |  |  |  |  |  |  | УШЯИ.687245.044
 | Изм. |  | Лист |  | № докум. |  | Подп. | Дата
Инв. № подл. | Разраб. |  |  |  | Сидорик |  |  |  | Плата источника |  | Лит. | Лист |  |  | Листов
 | Пров. |  |  |  | Голод |  |  |  |  |  |  | 1 |  |  | 4
 | Согл. |  |  |  |  |  |  |  |  |  | ОАО "МНИПИ"
 | Н. контр. |  |  |  | Ильина
 | Утв. |  |  |  | Грицев
