Sasha7b9Work/LiniaServer/_Лисенков/Temp/УШЯИ 687253.017.xls

Перв. примен. | Формат | Зона |  | Поз. |  | Обозначение |  |  |  | Наименование |  |  | Кол. | Примечание
 |  |  |  |  |  |  |  |  |  | Документация
 |  |  |  |  |  | УШЯИ.687253.017 СБ |  |  |  | Сборочный чертеж |  |  | 1
 |  |  |  |  |  |  |  |  |  | Сборочные единицы
Справ. №
 | А4 |  |  | 1 |  | … |  |  |  | Жгут
 |  |  |  |  |  |  |  |  |  | Детали
 |  |  |  | 2 |  | УШЯИ.745312.362 |  |  |  | Кронштейн |  |  | 1
 |  |  |  | 3 |  | УШЯИ.758725.629 |  |  |  | Плата печатная |  |  | 1
 |  |  |  |  |  |  |  |  |  | Стандартные изделия
 |  |  |  | 3 |  |  |  |  |  | Винт М2 |  |  | 4
Подп. и дата |  |  |  |  |  |  |  |  |  | ГОСТ 17475-80
 |  |  |  | 4 |  |  |  |  |  | Гайка М2 |  |  | 4
 |  |  |  |  |  |  |  |  |  | ГОСТ
 |  |  |  | 5 |  |  |  |  |  | Шайба А2 |  |  | 4
Инв. № дубл. |  |  |  |  |  |  |  |  |  | ГОСТ
Взам. инв. №
Подп. и дата
 |  |  |  |  |  |  |  |  | УШЯИ.687253.017
 | Изм. |  | Лист |  | № докум. |  | Подп. | Дата
Инв. № подл. | Разраб. |  |  |  | Сидорик |  |  |  | Плата |  | Лит. | Лист |  |  | Листов
 | Пров. |  |  |  | Голод |  |  |  |  |  |  | 1 |  |  | 5
 | Согл. |  |  |  |  |  |  |  |  |  | ОАО "МНИПИ"
 | Н. контр. |  |  |  | Ильина
 | Утв. |  |  |  | Грицев
