Sasha7b9Work/LiniaServer/_Лисенков/Temp/УШЯИ 687253.018.xls

Перв. примен. | Формат | Зона |  | Поз. |  | Обозначение |  |  |  | Наименование |  |  | Кол. | Примечание
 |  |  |  |  |  |  |  |  |  | Документация
 |  |  |  |  |  | УШЯИ 687253.018 СБ |  |  |  | Сборочный чертеж |  |  | 1
 |  |  |  |  |  |  |  |  |  | Детали
Справ. №
 |  |  |  | 3 |  | УШЯИ 758724.375 |  |  |  | Плата печатная |  |  | 1
 |  |  |  |  |  |  |  |  |  | Стойка
 |  |  |  |  |  |  |  |  |  | Гайка
 |  |  |  |  |  |  |  |  |  | Стандартные изделия
 |  |  |  |  |  |  |  |  |  | Шайба М4
 |  |  |  |  |  |  |  |  |  | ГОСТ
Подп. и дата
Инв. № дубл.
Взам. инв. №
Подп. и дата
 |  |  |  |  |  |  |  |  | УШЯИ.687253.018
 | Изм. |  | Лист |  | № докум. |  | Подп. | Дата
Инв. № подл. | Разраб. |  |  |  | Сидорик |  |  |  | Плата |  | Лит. | Лист |  |  | Листов
 | Пров. |  |  |  | Голод |  |  |  |  |  |  |  |  |  | 1
 | Согл. |  |  |  |  |  |  |  |  |  | ОАО "МНИПИ"
 | Н. контр. |  |  |  | Ильина
 | Утв. |  |  |  | Грицев
