Sasha7b9Work/LiniaServer/Источник напряжения (3000В)/Общая схема Источника Напряжения 3кВ/Ист. напряжения УШЯИ411522.034_ПЭ3.xls

Sheet: . Первый лист.
Перв. примен. | Поз. обозна-чение |  |  | Наименование |  |  |  | Кол. |  | Примечание
 |  |  |  | Устройства
 | A1 |  |  | Блок питания УШЯИ.436224.015 |  |  |  | 1
 | A2 |  |  | Плата выпрямителя УШЯИ.687253.019 |  |  |  | 1
Справ. № | A3 |  |  | Плата защиты УШЯИ.687242.236 |  |  |  | 1
 | A4 |  |  | Плата источника УШЯИ.687245.044 |  |  |  | 1
 | A5 |  |  | Источник напряжения 50В УШЯИ.411522.032 |  |  |  | 1
 |  |  |  | Трансформаторы напряжения
 | TV1 |  |  | Трансформатор УШЯИ.671111.272 |  |  |  | 1
 | TV2 |  |  | Трансформатор УШЯИ.671111.3XX |  |  |  | 1
 |  |  |  | Транзисторы
Подп. и дата
 | VT1 |  |  | MJ11032 |  |  |  | 1
 | VT2 |  |  | MJE11033 |  |  |  | 1
Инв. № дубл. |  |  |  | Соединения контактные
 | X1-X9 |  |  | N6,3-1/0,8 |  |  |  | 9
Взам. инв.№ | X10-X12 |  |  | TR-1,25-4 |  |  |  | 3
 | X13,X14 |  |  | TR-3,5-4 |  |  |  | 2
 | X15 |  |  | TR-1,25-4 |  |  |  | 1
Подп. и дата
 |  |  |  |  |  |  | УШЯИ411522.034 ПЭ3
 | Изм. | Лист | № докум. |  | Подп. | Дата
Инв. № подл. | Разраб. |  | Сидорик |  |  |  | Источник напряжения |  | Лит. |  | Лист | Листов
 | Пров. |  | Лисенков |  |  |  |  |  |  |  | 1 | 2
 | Согл. |  | Голод
 | Н.контр |  | Ильина
 | Утв. |  | Володкевич |  |  |  | Перечень элементов

Sheet: 2
 | Поз. обозна- чение |  |  | Наименование |  |  |  | Кол. | Примечание
 |  |  |  | Розетки
 | XS1 |  |  | AMPMODU 280360-0 |  |  |  | 1
 | XS2 |  |  | AMPMODU 280359 |  |  |  | 1
 | XS3 |  |  | MNL-350809-1 |  |  |  | 1
 |  |  |  | Соединения разборные
 | XT1-XT6 |  |  | УШЯИ.685631.123-01 |  |  |  | 6
Подп. и дата
Инв. № дубл.
Взам. инв.№
Подп. и дата
Инв. № подл.
 |  |  |  |  |  |  | УШЯИ411522.034 ПЭ3 |  |  | Лист
 |  |  |  |  |  |  |  |  |  | 2
 | Изм. | Лист | № докум. |  | Подп. | Дата
