Sasha7b9Work/LiniaServer/_Лисенков/На последок - Канал С (блоки,платы)/50В-17/УШЯИ 687253.017_ПЭ3.xls

Sheet: . Первый лист.
Перв. примен. | Поз. обозна-чение |  |  | Наименование |  |  |  | Кол. |  | Примечание
 |  |  |  | Конденсаторы
 | C1-C20 |  |  | 0805-X7R-25 В-0,1 мкФ +-10% |  |  |  | 20
 | C21 |  |  | 1206-C0G-50 В-22 пФ +-5% |  |  |  | 1
Справ. № | C22,C23 |  |  | 1206-X7R-50 B-100 пФ+-10% |  |  |  | 2
 | C24,C25 |  |  | 0805-C0G-250 В-10 пФ +-5% |  |  |  | 2
 | C26 |  |  | 2220-X7R-250 В-1 мкФ +-10% |  |  |  | 1
 | C27,C28 |  |  | 0805-C0G-250 В-10 пФ +-5% |  |  |  | 2
 | C29-C31 |  |  | 2220-X7R-250 В-1 мкФ +-10% |  |  |  | 3
 | C32,C33 |  |  | 0805-C0G-250 В-10 пФ +-5% |  |  |  | 2
 | C34,C35 |  |  | 0805-X7R-25 В-1 мкФ +-10% |  |  |  | 2
 | C36,C37 |  |  | 220пФ NP0 1000В 5% 1206 |  |  |  | 2
 | C38-C40 |  |  | ECR4R7M50B |  |  |  | 3
 | C41-C44 |  |  | 0805-X7R-25 В-0,33 мкФ +-10% |  |  |  | 4
Подп. и дата | C45,C46 |  |  | KM220M2EBKJ1020VBK |  |  |  | 2
 | C47-C51 |  |  | 0805-X7R-25 В-0,33 мкФ +-10% |  |  |  | 5
 | C52,C53 |  |  | 1206-X7R-50 B-22 пФ+-10% |  |  |  | 2
 | C54 |  |  | 0805-X7R-25 В-0,33 мкФ +-10% |  |  |  | 1
Инв. № дубл.
 |  |  |  | Микросхемы
Взам. инв.№ | DA1 |  |  | ADuM1100AR |  |  |  | 1
 | DA2,DA3 |  |  | ADM2486BRWZ |  |  |  | 2
Подп. и дата
 |  |  |  |  |  |  | ПЭ3
 | Изм. | Лист | № докум. |  | Подп. | Дата
Инв. № подл. | Разраб. |  | Сидорик |  |  |  |  |  | Лит. |  | Лист | Листов
 | Пров. |  | Лисенков |  |  |  |  |  |  |  | 1 | 6
 | Согл. |  | Голод
 | Н.контр |  | Ильина
 | Утв. |  | Грицев |  |  |  | Перечень элементов

Sheet: 2
 | Поз. обозна- чение |  |  | Наименование |  |  |  | Кол. | Примечание
 |  |  |  | Микросхемы
 | DA4 |  |  | ADuM1100AR |  |  |  | 1
 | DA5 |  |  | ADM2486BRWZ |  |  |  | 1
 | DA6 |  |  | ADuM1100AR |  |  |  | 1
 | DA7 |  |  | ADR435BRZ |  |  |  | 1
 | DA8,DA9 |  |  | ADuM1100AR |  |  |  | 2
 | DA10 |  |  | AD5443YRM |  |  |  | 1
 | DA11,DA12 |  |  | ADA4084-2ARZ |  |  |  | 2
 | DA13 |  |  | ADuM1100AR |  |  |  | 1
 | DA14 |  |  | ADG433BR |  |  |  | 1
 | DA15,DA16 |  |  | PA340CC |  |  |  | 2
 | DA17,DA18 |  |  | TLV9152IDR |  |  |  | 2
 | DA19 |  |  | ADA4084-2ARZ |  |  |  | 1
Подп. и дата | DA20,DA21 |  |  | IL311D |  |  |  | 2
 | DD1 |  |  | IN74HC00AD |  |  |  | 1
 | DD2 |  |  | IN74HC20D |  |  |  | 1
 | DD3 |  |  | IN74HC00AD |  |  |  | 1
Инв. № дубл.
 |  |  |  | Реле
Взам. инв.№ | K1,K2 |  |  | TLP3549F |  |  |  | 2
 |  |  |  | Резисторы
Подп. и дата
 | R1-R6 |  |  | 1206-1 кОм+-5% |  |  |  | 6
 | R7-R9 |  |  | 1206-100 Ом+-5% |  |  |  | 3
 | R10-R12 |  |  | 1206-12 кОм+-5% |  |  |  | 3
 | R13 |  |  | 1206-10 кОм+-0,5% |  |  |  | 1
Инв. № подл. | R14 |  |  | 1206-100 Ом+-0,5% |  |  |  | 1
 |  |  |  |  |  |  | ПЭ3 |  |  | Лист
 |  |  |  |  |  |  |  |  |  | 2
 | Изм. | Лист | № докум. |  | Подп. | Дата

Sheet: 3
 | Поз. обозна- чение |  |  | Наименование |  |  |  | Кол. | Примечание
 |  |  |  | Резисторы
 | R15,R16 |  |  | 1206-10 кОм+-0,5% |  |  |  | 2
 | R17 |  |  | 1206-12 кОм+-1% |  |  |  | 1
 | R18 |  |  | 1206-15 кОм+-5% |  |  |  | 1
 | R19,R20 |  |  | 1206-51 Ом+-5% |  |  |  | 2
 | R21 |  |  | 1206-51 кОм+-5% |  |  |  | 1
 | R22,R23 |  |  | 1206-2 кОм+-0.5% |  |  |  | 2
 | R24 |  |  | 1206-1 кОм+-5% |  |  |  | 1
 | R25,R26 |  |  | 1206-20 кОм+-0.5% |  |  |  | 2
 | R27 |  |  | 1206-75 кОм+-5% |  |  |  | 1
 | R28,R29 |  |  | 1206-20 кОм+-0.5% |  |  |  | 2
 | R30-R33 |  |  | 1206-100 кОм+-5% |  |  |  | 4
 | R34 |  |  | 1206-240 Ом+-5% |  |  |  | 1
Подп. и дата | R35 |  |  | 1206-1,2 кОм+-5% |  |  |  | 1
 | R36 |  |  | 1206-240 Ом+-5% |  |  |  | 1
 | R39 |  |  | 1206-1,2 кОм+-5% |  |  |  | 1
 | R42,R44 |  |  | 1206-2,4 кОм+-5% |  |  |  | 2
Инв. № дубл. | R45 |  |  | 1206-180 Ом+-5% |  |  |  | 1
 | R46 |  |  | 1206-100 Ом+-5% |  |  |  | 1
 | R47 |  |  | 1206-1 кОм+-5% |  |  |  | 1
Взам. инв.№ | R48 |  |  | 1206-51 Ом+-5% |  |  |  | 1
 | R49-R51 |  |  | 1206-10 Ом+-5% |  |  |  | 3
 | R52 |  |  | 1206-15 кОм+-5% |  |  |  | 1
Подп. и дата | R53,R54 |  |  | 1206-12 кОм+-5% |  |  |  | 2
 | R55 |  |  | 1206-6,98 кОм+-1% |  |  |  | 1
 | R56 |  |  | 1206-1 кОм+-5% |  |  |  | 1
 | R57,R58 |  |  | 2512-1,2 кОм+-5% |  |  |  | 2
 | R59,R60 |  |  | 1206-2 кОм+-0.5% |  |  |  | 2
Инв. № подл. | R61-R64 |  |  | 1206-240 Ом+-5% |  |  |  | 4
 |  |  |  |  |  |  | ПЭ3 |  |  | Лист
 |  |  |  |  |  |  |  |  |  | 3
 | Изм. | Лист | № докум. |  | Подп. | Дата

Sheet: 4
 | Поз. обозна- чение |  |  | Наименование |  |  |  | Кол. | Примечание
 |  |  |  | Резисторы
 | R65,R66 |  |  | 1206-430 Ом+-5% |  |  |  | 2
 | R67 |  |  | 1206-150 Ом+-5% |  |  |  | 1
 | R68,R69 |  |  | 2512-5,6 кОм+-5% |  |  |  | 2
 | R70 |  |  | 1206-2 кОм+-5% |  |  |  | 1
 | R71,R72 |  |  | 1206-51 кОм+-5% |  |  |  | 2
 | R73,R74 |  |  | 1206-390 Ом+-5% |  |  |  | 2
 | R75,R76 |  |  | W21-3W-680 Ом +-5% |  |  |  | 2
 | R77,R78 |  |  | HS15-4R7-J |  |  |  | 2
 |  |  |  | Потенциометры
 | RP1 |  |  | 3362P-1-103LF |  |  |  | 1
Подп. и дата | RP2,RP3 |  |  | 3329H-1-102LF |  |  |  | 2
 |  |  |  | Диоды
Инв. № дубл. | VD1-VD4 |  |  | 1N4148WS |  |  |  | 4
 | VD5,VD6 |  |  | BZX84C15LT1G |  |  |  | 2
 | VD8 |  |  | BZX84C15LT1G |  |  |  | 1
Взам. инв.№ | VD9 |  |  | BZX84C6V2LT1G |  |  |  | 1
 | VD10 |  |  | BZX84C15LT1G |  |  |  | 1
 | VD11,VD12 |  |  | 1N4007WS |  |  |  | 2
Подп. и дата | VD13 |  |  | W04M |  |  |  | 1
 | VD14 |  |  | GSIB2540 |  |  |  | 1
 | VD15,VD16 |  |  | BZT52C10 |  |  |  | 2
Инв. № подл.
 |  |  |  |  |  |  | ПЭ3 |  |  | Лист
 |  |  |  |  |  |  |  |  |  | 4
 | Изм. | Лист | № докум. |  | Подп. | Дата

Sheet: 5
 | Поз. обозна- чение |  |  | Наименование |  |  |  | Кол. | Примечание
 |  |  |  | Транзисторы
 | VT1 |  |  | ZXMN10A08E6TA |  |  |  | 1
 | VT2 |  |  | ZXMP10A17E6TA |  |  |  | 1
 | VT3 |  |  | IRF5210PBF |  |  |  | 1
 | VT4 |  |  | IPA083N10N5XKSA1 |  |  |  | 1
 |  |  |  | Вилки
 | XP1 |  |  | BH2-20 |  |  |  | 1
 | XP2,XP3 |  |  | DS1021-1x3 |  |  |  | 2
 | XP4 |  |  | 280373-2 |  |  |  | 1
 | XP5 |  |  | 280372-2 |  |  |  | 1
 | XP6 |  |  | MNL-350810-1 |  |  |  | 1
Подп. и дата | XP7 |  |  | XT60-M |  |  |  | 1
 |  |  |  | Розетки
Инв. № дубл. | XS1,XS2 |  |  | Jumper, 2.54mm |  |  |  | 2
Взам. инв.№
Подп. и дата
Инв. № подл.
 |  |  |  |  |  |  | ПЭ3 |  |  | Лист
 |  |  |  |  |  |  |  |  |  | 5
 | Изм. | Лист | № докум. |  | Подп. | Дата

Sheet: Лист регистрации изменений.
 | Лист регистрации изменений
 | Изм. |  | Номера листов (страниц) |  |  |  |  |  |  |  | Всего листов (страниц) в докум. | № докум. | Входящий № сопроводи-тельного документа и дата | Под- пись | Дата
 |  |  | изменен- ных |  | заменен- ных |  | новых |  |  | аннули- рован- ных
Подп. и дата
Инв. № дубл.
Взам. инв.№
Подп. и дата
Инв. № подл.
 |  |  |  |  |  |  |  |  | ПЭ3 |  |  |  |  |  |  | Лист
 |  |  |  |  |  |  |  |  |  |  |  |  |  |  |  | 6
 | Изм. | Лист |  | № докум. |  | Подп. |  | Дата
