Sasha7b9Work/LiniaServer/_Лисенков/Источник напряжения 50В/50В-17/УШЯИ 687253.017_ВП.xls

Sheet: . Первый лист.
Перв. примен. | № строки | Наименование | Код продукции | Обозначение документа на поставки | Поставщик |  |  |  | Куда входит (обозначение) |  |  |  | Количество |  |  |  |  |  | Примечание
 |  |  |  |  |  |  |  |  |  |  |  |  | На изделие | В компл-екты | На регу-лир. |  | Всего
 |  | Прочие изделия
 |  | Конденсаторы
 | 1 | 0805-C0G-250 В-10 пФ +-5% |  |  |  |  |  |  |  |  |  |  | 6
 | 2 | 0805-X7R-25 В-0,1 мкФ +-10% |  |  |  |  |  |  |  |  |  |  | 20
Справ. № | 3 | 0805-X7R-25 В-0,33 мкФ +-10% |  |  |  |  |  |  |  |  |  |  | 10
 | 4 | 0805-X7R-25 В-1 мкФ +-10% |  |  |  |  |  |  |  |  |  |  | 2
 | 5 | 1206-C0G-50 В-22 пФ +-5% |  |  |  |  |  |  |  |  |  |  | 1
 | 6 | 1206-X7R-50 B-22 пФ+-10% |  |  |  |  |  |  |  |  |  |  | 2
 | 7 | 1206-X7R-50 B-100 пФ+-10% |  |  |  |  |  |  |  |  |  |  | 2
 | 8 | 220пФ NP0 1000В 5% 1206 |  |  |  |  |  |  |  |  |  |  | 2
 | 9 | 2220-X7R-250 В-1 мкФ +-10% |  |  |  |  |  |  |  |  |  |  | 4
 | 10 | ECR4R7M50B |  |  |  |  |  |  |  |  |  |  | 3
 | 11 | KM220M2EBKJ1020VBK |  |  |  |  |  |  |  |  |  |  | 2
 |  | Микросхемы
Подп. и дата | 12 | AD5443YRM |  |  |  |  |  |  |  |  |  |  | 1
 | 13 | ADA4084-2ARZ |  |  |  |  |  |  |  |  |  |  | 3
 | 14 | ADG433BR |  |  |  |  |  |  |  |  |  |  | 1
 | 15 | ADM2486BRWZ |  |  |  |  |  |  |  |  |  |  | 3
Инв. № дубл. | 16 | ADR435BRZ |  |  |  |  |  |  |  |  |  |  | 1
 | 17 | ADuM1100AR |  |  |  |  |  |  |  |  |  |  | 6
 | 18 | IL311D |  |  |  |  |  |  |  |  |  |  | 2
Взам. инв. № | 19 | IN74HC00AD |  |  |  |  |  |  |  |  |  |  | 2
 | 20 | IN74HC20D |  |  |  |  |  |  |  |  |  |  | 1
Подп. и дата
 |  |  |  |  |  |  |  |  |  |  |  | ВП
 |  |  |  |  |  | Изм. | Лист | № докум. |  | Подп. | Дата
Инв. № подл. |  |  |  |  |  | Разраб. |  |  |  |  |  |  |  |  |  | Лит. |  | Лист |  | Листов
 |  |  |  |  |  | Пров. |  |  |  |  |  |  |  |  |  |  |  | 1 |  | 5
 |  |  |  |  |  | Согл.
 |  |  |  |  |  | Н. контр.
 |  |  |  |  |  | Утв. |  |  |  |  |  | Ведомость покупных изделий

Sheet: 2
 |  | № строки | Наименование | Код продукции | Обозначение документа на поставку | Поставщик |  |  |  | Куда входит (обозначение) |  |  |  | Количество |  |  |  | Примечание
-00 |  |  |  |  |  |  |  |  |  |  |  |  |  | На изделие | В комп-екты | На ре-гулир. | Всего
 |  |  | Микросхемы
 |  | 21 | PA340CC |  |  |  |  |  |  |  |  |  |  | 2
 |  | 22 | TLV9152IDR |  |  |  |  |  |  |  |  |  |  | 2
 |  |  | Реле
 |  | 23 | TLP3549F |  |  |  |  |  |  |  |  |  |  | 2
 |  |  | Резисторы
 |  | 24 | 1206-10 Ом+-5% |  |  |  |  |  |  |  |  |  |  | 3
 |  | 25 | 1206-51 Ом+-5% |  |  |  |  |  |  |  |  |  |  | 3
 |  | 26 | 1206-100 Ом+-0,5% |  |  |  |  |  |  |  |  |  |  | 1
 |  | 27 | 1206-100 Ом+-5% |  |  |  |  |  |  |  |  |  |  | 4
 |  | 28 | 1206-150 Ом+-5% |  |  |  |  |  |  |  |  |  |  | 1
 |  | 29 | 1206-180 Ом+-5% |  |  |  |  |  |  |  |  |  |  | 1
 |  | 30 | 1206-240 Ом+-5% |  |  |  |  |  |  |  |  |  |  | 6
 |  | 31 | 1206-390 Ом+-5% |  |  |  |  |  |  |  |  |  |  | 2
 | Подп. и дата | 32 | 1206-430 Ом+-5% |  |  |  |  |  |  |  |  |  |  | 2
 |  | 33 | 1206-1 кОм+-5% |  |  |  |  |  |  |  |  |  |  | 9
 |  | 34 | 1206-1,2 кОм+-5% |  |  |  |  |  |  |  |  |  |  | 2
 |  | 35 | 1206-2 кОм+-0.5% |  |  |  |  |  |  |  |  |  |  | 4
 | Инв. № дубл. | 36 | 1206-2 кОм+-5% |  |  |  |  |  |  |  |  |  |  | 1
 |  | 37 | 1206-2,4 кОм+-5% |  |  |  |  |  |  |  |  |  |  | 2
 |  | 38 | 1206-6,98 кОм+-1% |  |  |  |  |  |  |  |  |  |  | 1
 | Взам. инв. № | 39 | 1206-10 кОм+-0,5% |  |  |  |  |  |  |  |  |  |  | 3
 |  | 40 | 1206-12 кОм+-1% |  |  |  |  |  |  |  |  |  |  | 1
 |  | 41 | 1206-12 кОм+-5% |  |  |  |  |  |  |  |  |  |  | 5
 | Подп. и дата | 42 | 1206-15 кОм+-5% |  |  |  |  |  |  |  |  |  |  | 2
 |  | 43 | 1206-20 кОм+-0.5% |  |  |  |  |  |  |  |  |  |  | 4
 |  | 44 | 1206-51 кОм+-5% |  |  |  |  |  |  |  |  |  |  | 3
 |  | 45 | 1206-75 кОм+-5% |  |  |  |  |  |  |  |  |  |  | 1
 | Инв. № подл. | 46 | 1206-100 кОм+-5% |  |  |  |  |  |  |  |  |  |  | 4
 |  |  |  |  |  |  |  |  |  |  |  |  | ВП |  |  |  |  |  | Лист
 |  |  |  |  |  |  |  |  |  |  |  |  |  |  |  |  |  |  | 2
 |  |  |  |  |  |  | Изм. | Лист | № докум. |  | Подп. | Дата

Sheet: 3
 |  | № строки | Наименование | Код продукции | Обозначение документа на поставку | Поставщик |  |  |  | Куда входит (обозначение) |  |  |  | Количество |  |  |  | Примечание
-00 |  |  |  |  |  |  |  |  |  |  |  |  |  | На изделие | В комп-екты | На ре-гулир. | Всего
 |  |  | Резисторы
 |  | 47 | 2512-1,2 кОм+-5% |  |  |  |  |  |  |  |  |  |  | 2
 |  | 48 | 2512-5,6 кОм+-5% |  |  |  |  |  |  |  |  |  |  | 2
 |  | 49 | HS15-4R7-J |  |  |  |  |  |  |  |  |  |  | 2
 |  | 50 | W21-3W-680 Ом +-5% |  |  |  |  |  |  |  |  |  |  | 2
 |  |  | Потенциометры
 |  | 51 | 3329H-1-102LF |  |  |  |  |  |  |  |  |  |  | 2
 |  | 52 | 3362P-1-103LF |  |  |  |  |  |  |  |  |  |  | 1
 |  |  | Диоды
 |  | 53 | 1N4007WS |  |  |  |  |  |  |  |  |  |  | 2
 |  | 54 | 1N4148WS |  |  |  |  |  |  |  |  |  |  | 4
 |  | 55 | BZT52C10 |  |  |  |  |  |  |  |  |  |  | 2
 |  | 56 | BZX84C15LT1G |  |  |  |  |  |  |  |  |  |  | 4
 |  | 57 | BZX84C6V2LT1G |  |  |  |  |  |  |  |  |  |  | 1
 | Подп. и дата | 58 | GSIB2540 |  |  |  |  |  |  |  |  |  |  | 1
 |  | 59 | W04M |  |  |  |  |  |  |  |  |  |  | 1
 |  |  | Транзисторы
 | Инв. № дубл. | 60 | IPA083N10N5XKSA1 |  |  |  |  |  |  |  |  |  |  | 1
 |  | 61 | IRF5210PBF |  |  |  |  |  |  |  |  |  |  | 1
 |  | 62 | ZXMN10A08E6TA |  |  |  |  |  |  |  |  |  |  | 1
 | Взам. инв. № | 63 | ZXMP10A17E6TA |  |  |  |  |  |  |  |  |  |  | 1
 |  |  | Вилки
 | Подп. и дата | 64 | 280372-2 |  |  |  |  |  |  |  |  |  |  | 1
 |  | 65 | 280373-2 |  |  |  |  |  |  |  |  |  |  | 1
 |  | 66 | BH2-20 |  |  |  |  |  |  |  |  |  |  | 1
 |  | 67 | DS1021-1x3 |  |  |  |  |  |  |  |  |  |  | 2
 | Инв. № подл. | 68 | MNL-350810-1 |  |  |  |  |  |  |  |  |  |  | 1
 |  |  |  |  |  |  |  |  |  |  |  |  | ВП |  |  |  |  |  | Лист
 |  |  |  |  |  |  |  |  |  |  |  |  |  |  |  |  |  |  | 3
 |  |  |  |  |  |  | Изм. | Лист | № докум. |  | Подп. | Дата

Sheet: 4
 |  | № строки | Наименование | Код продукции | Обозначение документа на поставку | Поставщик |  |  |  | Куда входит (обозначение) |  |  |  | Количество |  |  |  | Примечание
-00 |  |  |  |  |  |  |  |  |  |  |  |  |  | На изделие | В комп-екты | На ре-гулир. | Всего
 |  |  | Вилки
 |  | 69 | XT60-M |  |  |  |  |  |  |  |  |  |  | 1
 |  |  | Розетки
 |  | 70 | Jumper, 2.54mm |  |  |  |  |  |  |  |  |  |  | 2
 | Подп. и дата
 | Инв. № дубл.
 | Взам. инв. №
 | Подп. и дата
 | Инв. № подл.
 |  |  |  |  |  |  |  |  |  |  |  |  | ВП |  |  |  |  |  | Лист
 |  |  |  |  |  |  |  |  |  |  |  |  |  |  |  |  |  |  | 4
 |  |  |  |  |  |  | Изм. | Лист | № докум. |  | Подп. | Дата

Sheet: Лист регистрации изменений.
 | Лист регистрации изменений
 | Изм. |  | Номера листов (страниц) |  |  |  |  |  |  |  | Всего листов (страниц) в докум. | № докум. | Входящий № сопроводи- тельного документа и дата | Под- пись | Дата
 |  |  | изме- ненных |  | заме- няемых |  | новых |  |  | аннули-рованных
Подп. и дата
Инв. № дубл.
Взам. инв. №
Подп. и дата
Инв.№ подл.
 |  |  |  |  |  |  |  |  | ВП |  |  |  |  |  |  | Лист
 |  |  |  |  |  |  |  |  |  |  |  |  |  |  |  | 5
 | Изм. | Лист |  | № докум |  | Подп. |  | Дата
