Sasha7b9Work/LiniaServer/_Лисенков/На последок - Канал С (блоки,платы)/Формирователь развертки/Формирователь Развертки УШЯИ.411522.033_ВП.xls

Sheet: . Первый лист.
Перв. примен. | № строки | Наименование | Код продукции | Обозначение документа на поставки | Поставщик |  |  |  | Куда входит (обозначение) |  |  |  | Количество |  |  |  |  |  | Примечание
 |  |  |  |  |  |  |  |  |  |  |  |  | На изделие | В компл-екты | На регу-лир. |  | Всего
 |  | Прочие изделия
 |  | Конденсаторы
 | 1 | 0805-C0G-50 В-240 пФ +-5% |  |  |  |  |  |  |  |  |  |  | 1
 | 2 | 0805-NP0-50 В-150 пФ +-1% |  |  |  |  |  |  |  |  |  |  | 1
Справ. № | 3 | 0805-NP0-50 В-2200 пФ +-1% |  |  |  |  |  |  |  |  |  |  | 1
 | 4 | 0805-X5R-25 В-10 мкФ +-10% |  |  |  |  |  |  |  |  |  |  | 1
 | 5 | 0805-X7R-25 В-0,1 мкФ +-10% |  |  |  |  |  |  |  |  |  |  | 28
 | 6 | 1206-NP0-50 B-10 пФ+-5% |  |  |  |  |  |  |  |  |  |  | 1
 | 7 | 1206-X7R-50 B-22 пФ+-10% |  |  |  |  |  |  |  |  |  |  | 1
 | 8 | 1206-X7R-50 B-33 пФ+-10% |  |  |  |  |  |  |  |  |  |  | 3
 | 9 | 1206-X7R-50 B-51 пФ+-10% |  |  |  |  |  |  |  |  |  |  | 1
 | 10 | 1206-X7R-50 B-100 пФ+-10% |  |  |  |  |  |  |  |  |  |  | 4
 | 11 | 1206-X7R-50 B-120 пФ+-10% |  |  |  |  |  |  |  |  |  |  | 1
 | 12 | 1206-X7R-50 B-150 пФ+-10% |  |  |  |  |  |  |  |  |  |  | 2
 | 13 | 1206-X7R-50 B-240 пФ+-10% |  |  |  |  |  |  |  |  |  |  | 1
Подп. и дата | 14 | 1206-X7R-50 B-510 пФ+-10% |  |  |  |  |  |  |  |  |  |  | 1
 | 15 | 1206-X7R-50 B-1 нФ+-10% |  |  |  |  |  |  |  |  |  |  | 3
 | 16 | 1206-X7R-50 B-5600 пФ+-10% |  |  |  |  |  |  |  |  |  |  | 1
 | 17 | 1206-X7R-50 B-0,01 мкФ+-10% |  |  |  |  |  |  |  |  |  |  | 2
Инв. № дубл. | 18 | 1206-X7R-50 B-39 нФ+-10% |  |  |  |  |  |  |  |  |  |  | 1
 | 19 | 1206-X7R-50 B-68 нФ+-10% |  |  |  |  |  |  |  |  |  |  | 2
 | 20 | 1206-X7R-50 B-0,1 мкФ+-10% |  |  |  |  |  |  |  |  |  |  | 6
Взам. инв. № | 21 | 1206-X7R-50 B-0,33 мкФ+-10% |  |  |  |  |  |  |  |  |  |  | 21
 | 22 | 1206-X7R-50 B-2,2 мкФ+-10% |  |  |  |  |  |  |  |  |  |  | 3
Подп. и дата
 |  |  |  |  |  |  |  |  |  |  |  | ВП
 |  |  |  |  |  | Изм. | Лист | № докум. |  | Подп. | Дата
Инв. № подл. |  |  |  |  |  | Разраб. |  |  |  |  |  |  |  |  |  | Лит. |  | Лист |  | Листов
 |  |  |  |  |  | Пров. |  |  |  |  |  |  |  |  |  |  |  | 1 |  | 6
 |  |  |  |  |  | Согл.
 |  |  |  |  |  | Н. контр.
 |  |  |  |  |  | Утв. |  |  |  |  |  | Ведомость покупных изделий

Sheet: 2
 |  | № строки | Наименование | Код продукции | Обозначение документа на поставку | Поставщик |  |  |  | Куда входит (обозначение) |  |  |  | Количество |  |  |  | Примечание
-00 |  |  |  |  |  |  |  |  |  |  |  |  |  | На изделие | В комп-екты | На ре-гулир. | Всего
 |  |  | Конденсаторы
 |  | 23 | CC45SL3JD470JYGNA |  |  |  |  |  |  |  |  |  |  | 5
 |  | 24 | ECR-100В-2,2 мкФ |  |  |  |  |  |  |  |  |  |  | 2
 |  | 25 | ECR-35В-4,7 мкФ |  |  |  |  |  |  |  |  |  |  | 2
 |  | 26 | TAJA106K010RNJ |  |  |  |  |  |  |  |  |  |  | 1
 |  | 27 | TZC3P200A110 |  |  |  |  |  |  |  |  |  |  | 1
 |  | 28 | К73-17-63 В-0,47 мкФ +-5% |  |  |  |  |  |  |  |  |  |  | 2
 |  |  | Микросхемы
 |  | 29 | AD5443YRM |  |  |  |  |  |  |  |  |  |  | 2
 |  | 30 | AD7691BRM |  |  |  |  |  |  |  |  |  |  | 1
 |  | 31 | AD8031ARZ |  |  |  |  |  |  |  |  |  |  | 1
 |  | 32 | AD8671AR |  |  |  |  |  |  |  |  |  |  | 3
 |  | 33 | ADA4627-1ARZ |  |  |  |  |  |  |  |  |  |  | 6
 |  | 34 | ADA4941-1YRZ |  |  |  |  |  |  |  |  |  |  | 1
 |  | 35 | ADG432BR |  |  |  |  |  |  |  |  |  |  | 1
 | Подп. и дата | 36 | ADG433BR |  |  |  |  |  |  |  |  |  |  | 2
 |  | 37 | ADM2486BRWZ |  |  |  |  |  |  |  |  |  |  | 8
 |  | 38 | ADR434BR |  |  |  |  |  |  |  |  |  |  | 1
 |  | 39 | ADuM1100AR |  |  |  |  |  |  |  |  |  |  | 6
 | Инв. № дубл. | 40 | IL311D |  |  |  |  |  |  |  |  |  |  | 3
 |  | 41 | IL358D |  |  |  |  |  |  |  |  |  |  | 1
 |  | 42 | IN74HC00AD |  |  |  |  |  |  |  |  |  |  | 1
 | Взам. инв. № | 43 | IN74HC08AD |  |  |  |  |  |  |  |  |  |  | 1
 |  | 44 | IN74HC595AD |  |  |  |  |  |  |  |  |  |  | 1
 |  | 45 | L78L06ACD13TR |  |  |  |  |  |  |  |  |  |  | 1
 | Подп. и дата
 |  |  | Реле времени
 |  | 46 | Lepestok |  |  |  |  |  |  |  |  |  |  | 4
 | Инв. № подл.
 |  |  |  |  |  |  |  |  |  |  |  |  | ВП |  |  |  |  |  | Лист
 |  |  |  |  |  |  |  |  |  |  |  |  |  |  |  |  |  |  | 2
 |  |  |  |  |  |  | Изм. | Лист | № докум. |  | Подп. | Дата

Sheet: 3
 |  | № строки | Наименование | Код продукции | Обозначение документа на поставку | Поставщик |  |  |  | Куда входит (обозначение) |  |  |  | Количество |  |  |  | Примечание
-00 |  |  |  |  |  |  |  |  |  |  |  |  |  | На изделие | В комп-екты | На ре-гулир. | Всего
 |  |  | Резисторы
 |  | 47 | 0805-2 кОм+-0,1% |  |  |  |  |  |  |  |  |  |  | 1
 |  | 48 | 0805-6,04 кОм+-0,1% |  |  |  |  |  |  |  |  |  |  | 1
 |  | 49 | 0805-32 кОм+-0,1% |  |  |  |  |  |  |  |  |  |  | 1
 |  | 50 | 1206-2,2 Ом+-5% |  |  |  |  |  |  |  |  |  |  | 1
 |  | 51 | 1206-15 Ом+-5% |  |  |  |  |  |  |  |  |  |  | 1
 |  | 52 | 1206-22 Ом+-5% |  |  |  |  |  |  |  |  |  |  | 1
 |  | 53 | 1206-24 Ом+-5% |  |  |  |  |  |  |  |  |  |  | 1
 |  | 54 | 1206-33 Ом+-5% |  |  |  |  |  |  |  |  |  |  | 3
 |  | 55 | 1206-100 Ом+-5% |  |  |  |  |  |  |  |  |  |  | 9
 |  | 56 | 1206-120 Ом+-5% |  |  |  |  |  |  |  |  |  |  | 2
 |  | 57 | 1206-150 Ом+-5% |  |  |  |  |  |  |  |  |  |  | 2
 |  | 58 | 1206-240 Ом+-5% |  |  |  |  |  |  |  |  |  |  | 1
 |  | 59 | 1206-330 Ом+-5% |  |  |  |  |  |  |  |  |  |  | 1
 |  | 60 | 1206-470 Ом+-5% |  |  |  |  |  |  |  |  |  |  | 2
 |  | 61 | 1206-510 Ом+-5% |  |  |  |  |  |  |  |  |  |  | 4
 | Подп. и дата | 62 | 1206-910 Ом+-5% |  |  |  |  |  |  |  |  |  |  | 1
 |  | 63 | 1206-1 кОм+-5% |  |  |  |  |  |  |  |  |  |  | 12
 |  | 64 | 1206-1,1 кОм+-5% |  |  |  |  |  |  |  |  |  |  | 1
 |  | 65 | 1206-1,3 кОм+-5% |  |  |  |  |  |  |  |  |  |  | 2
 | Инв. № дубл. | 66 | 1206-1,5 кОм+-5% |  |  |  |  |  |  |  |  |  |  | 3
 |  | 67 | 1206-2,2 кОм+-5% |  |  |  |  |  |  |  |  |  |  | 1
 |  | 68 | 1206-2,4 кОм+-5% |  |  |  |  |  |  |  |  |  |  | 4
 | Взам. инв. № | 69 | 1206-4,32 кОм+-1% |  |  |  |  |  |  |  |  |  |  | 1
 |  | 70 | 1206-4,99 кОм+-0,1% |  |  |  |  |  |  |  |  |  |  | 2
 |  | 71 | 1206-5,1 кОм+-5% |  |  |  |  |  |  |  |  |  |  | 1
 | Подп. и дата | 72 | 1206-6,8 кОм+-5% |  |  |  |  |  |  |  |  |  |  | 2
 |  | 73 | 1206-7,5 кОм+-5% |  |  |  |  |  |  |  |  |  |  | 1
 |  | 74 | 1206-8,2 кОм+-5% |  |  |  |  |  |  |  |  |  |  | 1
 |  | 75 | 1206-9,53 кОм+-1% |  |  |  |  |  |  |  |  |  |  | 1
 | Инв. № подл. | 76 | 1206-10 кОм+-0,5% |  |  |  |  |  |  |  |  |  |  | 4
 |  |  |  |  |  |  |  |  |  |  |  |  | ВП |  |  |  |  |  | Лист
 |  |  |  |  |  |  |  |  |  |  |  |  |  |  |  |  |  |  | 3
 |  |  |  |  |  |  | Изм. | Лист | № докум. |  | Подп. | Дата

Sheet: 4
 |  | № строки | Наименование | Код продукции | Обозначение документа на поставку | Поставщик |  |  |  | Куда входит (обозначение) |  |  |  | Количество |  |  |  | Примечание
-00 |  |  |  |  |  |  |  |  |  |  |  |  |  | На изделие | В комп-екты | На ре-гулир. | Всего
 |  |  | Резисторы
 |  | 77 | 1206-11 кОм+-5% |  |  |  |  |  |  |  |  |  |  | 1
 |  | 78 | 1206-11,8 кОм+-0,1% |  |  |  |  |  |  |  |  |  |  | 1
 |  | 79 | 1206-12 кОм+-1% |  |  |  |  |  |  |  |  |  |  | 2
 |  | 80 | 1206-12 кОм+-5% |  |  |  |  |  |  |  |  |  |  | 10
 |  | 81 | 1206-14 кОм+-0,1% |  |  |  |  |  |  |  |  |  |  | 1
 |  | 82 | 1206-15 кОм+-5% |  |  |  |  |  |  |  |  |  |  | 1
 |  | 83 | 1206-20 кОм+-0,1% |  |  |  |  |  |  |  |  |  |  | 2
 |  | 84 | 1206-24,9 кОм+-0,5% |  |  |  |  |  |  |  |  |  |  | 2
 |  | 85 | 1206-30 кОм+-0.1% |  |  |  |  |  |  |  |  |  |  | 1
 |  | 86 | 1206-40,2 кОм+-0,1% |  |  |  |  |  |  |  |  |  |  | 1
 |  | 87 | 1206-47 кОм+-5% |  |  |  |  |  |  |  |  |  |  | 1
 |  | 88 | 1206-51 кОм+-5% |  |  |  |  |  |  |  |  |  |  | 1
 |  | 89 | 1206-560 кОм+-5% |  |  |  |  |  |  |  |  |  |  | 2
 |  | 90 | 1206-1 МОм+-5% |  |  |  |  |  |  |  |  |  |  | 1
 |  | 91 | 1206-2 МОм+-0,1% |  |  |  |  |  |  |  |  |  |  | 1
 | Подп. и дата | 92 | 1206-3 МОм+-5% |  |  |  |  |  |  |  |  |  |  | 1
 |  | 93 | 2512-5,1 Ом+-5% |  |  |  |  |  |  |  |  |  |  | 1
 |  | 94 | 2512-47 кОм+-5% |  |  |  |  |  |  |  |  |  |  | 1
 |  | 95 | С2-29В-2-2 МОм +-0.5%-1,0-А |  |  |  |  |  |  |  |  |  |  | 5
 | Инв. № дубл.
 |  |  | Потенциометры
 |  | 96 | 3329H-1-222LF |  |  |  |  |  |  |  |  |  |  | 1
 | Взам. инв. № | 97 | 3329H-1-223LF |  |  |  |  |  |  |  |  |  |  | 1
 |  | 98 | 3329H-1-472LF |  |  |  |  |  |  |  |  |  |  | 2
 | Подп. и дата |  | Диоды
 |  | 99 | 1N4001WS |  |  |  |  |  |  |  |  |  |  | 4
 |  | 100 | 1N4148WS |  |  |  |  |  |  |  |  |  |  | 15
 |  | 101 | BZX55-C10 |  |  |  |  |  |  |  |  |  |  | 1
 | Инв. № подл. | 102 | BZX55-C5V6 |  |  |  |  |  |  |  |  |  |  | 4
 |  |  |  |  |  |  |  |  |  |  |  |  | ВП |  |  |  |  |  | Лист
 |  |  |  |  |  |  |  |  |  |  |  |  |  |  |  |  |  |  | 4
 |  |  |  |  |  |  | Изм. | Лист | № докум. |  | Подп. | Дата

Sheet: 5
 |  | № строки | Наименование | Код продукции | Обозначение документа на поставку | Поставщик |  |  |  | Куда входит (обозначение) |  |  |  | Количество |  |  |  | Примечание
-00 |  |  |  |  |  |  |  |  |  |  |  |  |  | На изделие | В комп-екты | На ре-гулир. | Всего
 |  |  | Диоды
 |  | 103 | BZX55-C6V2 |  |  |  |  |  |  |  |  |  |  | 2
 |  |  | Транзисторы
 |  | 104 | FZT658 |  |  |  |  |  |  |  |  |  |  | 2
 |  | 105 | FZT758 |  |  |  |  |  |  |  |  |  |  | 2
 |  | 106 | MJE5730 |  |  |  |  |  |  |  |  |  |  | 3
 |  | 107 | TIP48 |  |  |  |  |  |  |  |  |  |  | 3
 |  |  | Вилки
 |  | 108 | 280371-2 |  |  |  |  |  |  |  |  |  |  | 1
 |  | 109 | 280372-2 |  |  |  |  |  |  |  |  |  |  | 1
 |  | 110 | 280373-2 |  |  |  |  |  |  |  |  |  |  | 1
 |  | 111 | BH2-20 |  |  |  |  |  |  |  |  |  |  | 2
 |  | 112 | DS1021-1x3 |  |  |  |  |  |  |  |  |  |  | 1
 | Подп. и дата |  | Розетки
 |  | 113 | 280358-0 |  |  |  |  |  |  |  |  |  |  | 2
 |  | 114 | Jumper, 2.54mm |  |  |  |  |  |  |  |  |  |  | 1
 | Инв. № дубл.
 | Взам. инв. №
 | Подп. и дата
 | Инв. № подл.
 |  |  |  |  |  |  |  |  |  |  |  |  | ВП |  |  |  |  |  | Лист
 |  |  |  |  |  |  |  |  |  |  |  |  |  |  |  |  |  |  | 5
 |  |  |  |  |  |  | Изм. | Лист | № докум. |  | Подп. | Дата

Sheet: Лист регистрации изменений.
 | Лист регистрации изменений
 | Изм. |  | Номера листов (страниц) |  |  |  |  |  |  |  | Всего листов (страниц) в докум. | № докум. | Входящий № сопроводи- тельного документа и дата | Под- пись | Дата
 |  |  | изме- ненных |  | заме- няемых |  | новых |  |  | аннули-рованных
Подп. и дата
Инв. № дубл.
Взам. инв. №
Подп. и дата
Инв.№ подл.
 |  |  |  |  |  |  |  |  | ВП |  |  |  |  |  |  | Лист
 |  |  |  |  |  |  |  |  |  |  |  |  |  |  |  | 6
 | Изм. | Лист |  | № докум |  | Подп. |  | Дата
