Sasha7b9Work/LiniaServer/_Лисенков/На последок - Канал С (блоки,платы)/3000В/Плата источника напряжения 3 кВ УШЯИ.687245.044_ВП.xls

Sheet: . Первый лист.
Перв. примен. | № строки | Наименование | Код продукции | Обозначение документа на поставки | Поставщик |  |  |  | Куда входит (обозначение) |  |  |  | Количество |  |  |  |  |  | Примечание
 |  |  |  |  |  |  |  |  |  |  |  |  | На изделие | В компл-екты | На регу-лир. |  | Всего
 |  | Прочие изделия
 |  | Конденсаторы
 | 1 | 0805-X7R-25 В-0,1 мкФ +-10% |  |  |  |  |  |  |  |  |  |  | 6
 | 2 | 1206-X7R-50 B-0,33 мкФ+-10% |  |  |  |  |  |  |  |  |  |  | 7
Справ. № | 3 | LGG2G331MELB30 |  |  |  |  |  |  |  |  |  |  | 2
 | 4 | К10-17б-M1500-1200 пФ +-5% |  |  |  |  |  |  |  |  |  |  | 1
 | 5 | К73-14М-4 кВ-0,033 мкФ +-10% |  |  |  |  |  |  |  |  |  |  | 1
 | 6 | К73-14М-4 кВ-0,1 мкФ +-10% |  |  |  |  |  |  |  |  |  |  | 2
 | 7 | К73-17-250 В-0,47 мкФ +-20% |  |  |  |  |  |  |  |  |  |  | 2
 |  | Микросхемы
 | 8 | ADM2486BRWZ |  |  |  |  |  |  |  |  |  |  | 2
 | 9 | ADuM1100AR |  |  |  |  |  |  |  |  |  |  | 1
 | 10 | IN74HC00AD |  |  |  |  |  |  |  |  |  |  | 1
 | 11 | IN74HC02AD |  |  |  |  |  |  |  |  |  |  | 3
Подп. и дата | 12 | IN74HC04AD |  |  |  |  |  |  |  |  |  |  | 1
 | 13 | IN74HC08AD |  |  |  |  |  |  |  |  |  |  | 1
 | 14 | IN74HC138AD |  |  |  |  |  |  |  |  |  |  | 1
 | 15 | IN74HC595AD |  |  |  |  |  |  |  |  |  |  | 1
Инв. № дубл. | 16 | IN74HC86AD |  |  |  |  |  |  |  |  |  |  | 1
 | 17 | MAX809S |  |  |  |  |  |  |  |  |  |  | 1
 | 18 | ULQ2003AD |  |  |  |  |  |  |  |  |  |  | 3
Взам. инв. №
Подп. и дата
 |  |  |  |  |  |  |  |  |  |  |  | ВП
 |  |  |  |  |  | Изм. | Лист | № докум. |  | Подп. | Дата
Инв. № подл. |  |  |  |  |  | Разраб. |  |  |  |  |  |  |  |  |  | Лит. |  | Лист |  | Листов
 |  |  |  |  |  | Пров. |  |  |  |  |  |  |  |  |  |  |  | 1 |  | 4
 |  |  |  |  |  | Согл.
 |  |  |  |  |  | Н. контр.
 |  |  |  |  |  | Утв. |  |  |  |  |  | Ведомость покупных изделий

Sheet: 2
 |  | № строки | Наименование | Код продукции | Обозначение документа на поставку | Поставщик |  |  |  | Куда входит (обозначение) |  |  |  | Количество |  |  |  | Примечание
-00 |  |  |  |  |  |  |  |  |  |  |  |  |  | На изделие | В комп-екты | На ре-гулир. | Всего
 |  |  | Реле
 |  | 19 | DAR71210TU |  |  |  |  |  |  |  |  |  |  | 15
 |  | 20 | TLP3549F |  |  |  |  |  |  |  |  |  |  | 2
 |  | 21 | УШЯИ.685442.092vs2Rel |  |  |  |  |  |  |  |  |  |  | 1
 |  |  | Резисторы
 |  | 22 | 1206-10 Ом+-5% |  |  |  |  |  |  |  |  |  |  | 2
 |  | 23 | 1206-100 Ом+-5% |  |  |  |  |  |  |  |  |  |  | 2
 |  | 24 | 1206-470 Ом+-5% |  |  |  |  |  |  |  |  |  |  | 2
 |  | 25 | 1206-1 кОм+-5% |  |  |  |  |  |  |  |  |  |  | 4
 |  | 26 | 1206-12 кОм+-5% |  |  |  |  |  |  |  |  |  |  | 2
 |  | 27 | 1206-22 кОм+-5% |  |  |  |  |  |  |  |  |  |  | 2
 |  | 28 | Р1-32-1-18 МОм +-5% |  |  |  |  |  |  |  |  |  |  | 1
 |  | 29 | С2-33-2-15 Ом +-5% |  |  |  |  |  |  |  |  |  |  | 1
 |  | 30 | С2-33-2-300 Ом +-5% |  |  |  |  |  |  |  |  |  |  | 2
 |  | 31 | С2-33-2-1,2 кОм +-5% |  |  |  |  |  |  |  |  |  |  | 7
 | Подп. и дата | 32 | С2-33-2-3,3 кОм +-5% |  |  |  |  |  |  |  |  |  |  | 2
 |  | 33 | С2-33-2-15 кОм +-5% |  |  |  |  |  |  |  |  |  |  | 2
 |  | 34 | С2-33-2-470 кОм +-5% |  |  |  |  |  |  |  |  |  |  | 2
 |  | 35 | С2-33Н-0,5-3 Ом +-5% |  |  |  |  |  |  |  |  |  |  | 4
 | Инв. № дубл. | 36 | С2-33Н-0,5-270 Ом +-5% |  |  |  |  |  |  |  |  |  |  | 1
 |  | 37 | С2-33Н-1-15 Ом +-5% |  |  |  |  |  |  |  |  |  |  | 1
 |  | 38 | С2-33Н-1-1 кОм +-5% |  |  |  |  |  |  |  |  |  |  | 2
 | Взам. инв. № | 39 | С2-33Н-1-10 кОм +-5% |  |  |  |  |  |  |  |  |  |  | 2
 |  | 40 | С2-33Н-1-1 МОм +-5% |  |  |  |  |  |  |  |  |  |  | 2
 | Подп. и дата |  | Переключатели
 |  | 41 | МКА-50202 |  |  |  |  |  |  |  |  |  |  | 2
 | Инв. № подл.
 |  |  |  |  |  |  |  |  |  |  |  |  | ВП |  |  |  |  |  | Лист
 |  |  |  |  |  |  |  |  |  |  |  |  |  |  |  |  |  |  | 2
 |  |  |  |  |  |  | Изм. | Лист | № докум. |  | Подп. | Дата

Sheet: 3
 |  | № строки | Наименование | Код продукции | Обозначение документа на поставку | Поставщик |  |  |  | Куда входит (обозначение) |  |  |  | Количество |  |  |  | Примечание
-00 |  |  |  |  |  |  |  |  |  |  |  |  |  | На изделие | В комп-екты | На ре-гулир. | Всего
 |  |  | Диоды
 |  | 42 | 1N4148WS |  |  |  |  |  |  |  |  |  |  | 2
 |  | 43 | 20ETF08/IR |  |  |  |  |  |  |  |  |  |  | 2
 |  | 44 | BY255/Taw |  |  |  |  |  |  |  |  |  |  | 2
 |  | 45 | HVM8 |  |  |  |  |  |  |  |  |  |  | 2
 |  |  | Соединения контактные
 |  | 46 | TR-1,25-4 |  |  |  |  |  |  |  |  |  |  | 6
 |  |  | Вилки
 |  | 47 | 280371-2 |  |  |  |  |  |  |  |  |  |  | 1
 |  | 48 | BH2-10 |  |  |  |  |  |  |  |  |  |  | 1
 |  |  | Соединения разборные
 |  | 49 | УШЯИ.685631.123 |  |  |  |  |  |  |  |  |  |  | 1
 | Подп. и дата
 | Инв. № дубл.
 | Взам. инв. №
 | Подп. и дата
 | Инв. № подл.
 |  |  |  |  |  |  |  |  |  |  |  |  | ВП |  |  |  |  |  | Лист
 |  |  |  |  |  |  |  |  |  |  |  |  |  |  |  |  |  |  | 3
 |  |  |  |  |  |  | Изм. | Лист | № докум. |  | Подп. | Дата

Sheet: Лист регистрации изменений.
 | Лист регистрации изменений
 | Изм. |  | Номера листов (страниц) |  |  |  |  |  |  |  | Всего листов (страниц) в докум. | № докум. | Входящий № сопроводи- тельного документа и дата | Под- пись | Дата
 |  |  | изме- ненных |  | заме- няемых |  | новых |  |  | аннули-рованных
Подп. и дата
Инв. № дубл.
Взам. инв. №
Подп. и дата
Инв.№ подл.
 |  |  |  |  |  |  |  |  | ВП |  |  |  |  |  |  | Лист
 |  |  |  |  |  |  |  |  |  |  |  |  |  |  |  | 4
 | Изм. | Лист |  | № докум |  | Подп. |  | Дата
