Sasha7b9Work/LiniaServer/_Лисенков/На последок - Канал С (блоки,платы)/50В-18/УШЯИ 687253.018_ВП.xls

Перв. примен. | № строки | Наименование | Код продукции | Обозначение документа на поставки | Поставщик |  |  |  | Куда входит (обозначение) |  |  |  | Количество |  |  |  |  |  | Примечание
 |  |  |  |  |  |  |  |  |  |  |  |  | На изделие | В компл-екты | На регу-лир. |  | Всего
 |  | Прочие изделия
 |  | Конденсаторы
 | 1 | B43640A2228M000 |  |  |  |  |  |  |  |  |  |  | 4
Справ. № |  | Резисторы
 | 2 | OAR3-R005FI |  |  |  |  |  |  |  |  |  |  | 6
 | 3 | С2-33Н-0,5-24 кОм +-5% |  |  |  |  |  |  |  |  |  |  | 2
 |  | Соединения контактные
 | 4 | TR-3.5-4 |  |  |  |  |  |  |  |  |  |  | 1
 |  | Вилки
 | 5 | 280373-2 |  |  |  |  |  |  |  |  |  |  | 1
 |  | Розетки
Подп. и дата | 6 | XT60-F |  |  |  |  |  |  |  |  |  |  | 1
 |  | Соединения разборные
 | 7 | УШЯИ.685631.123 |  |  |  |  |  |  |  |  |  |  | 1
Инв. № дубл.
Взам. инв. №
Подп. и дата
 |  |  |  |  |  |  |  |  |  |  |  | ВП
 |  |  |  |  |  | Изм. | Лист | № докум. |  | Подп. | Дата
Инв. № подл. |  |  |  |  |  | Разраб. |  |  |  |  |  |  |  |  |  | Лит. |  | Лист |  | Листов
 |  |  |  |  |  | Пров.
 |  |  |  |  |  | Согл.
 |  |  |  |  |  | Н. контр.
 |  |  |  |  |  | Утв. |  |  |  |  |  | Ведомость покупных изделий
