Sasha7b9Work/LiniaServer/_Лисенков/На последок - Канал С (блоки,платы)/50В-18/УШЯИ 687253.018_ПЭ3.xls

Sheet: . Первый лист.
Перв. примен. | Поз. обозна-чение |  |  | Наименование |  |  |  | Кол. |  | Примечание
 |  |  |  | Конденсаторы
 | C1-C4 |  |  | B43640A2228M000 |  |  |  | 4
Справ. № |  |  |  | Резисторы
 | R1,R2 |  |  | OAR3-R005FI |  |  |  | 2
 | R3,R4 |  |  | С2-33Н-0,5-24 кОм +-5% |  |  |  | 2
 | R5-R8 |  |  | OAR3-R005FI |  |  |  | 4
 |  |  |  | Соединения контактные
 | X1 |  |  | TR-3.5-4 |  |  |  | 1
Подп. и дата |  |  |  | Вилки
 | XP1 |  |  | 280373-2 |  |  |  | 1
Инв. № дубл. |  |  |  | Розетки
 | XS1 |  |  | XT60-F |  |  |  | 1
Взам. инв.№
Подп. и дата
 |  |  |  |  |  |  | ПЭ3
 | Изм. | Лист | № докум. |  | Подп. | Дата
Инв. № подл. | Разраб. |  | Сидорик |  |  |  |  |  | Лит. |  | Лист | Листов
 | Пров. |  | Лисенков |  |  |  |  |  |  |  | 1 | 2
 | Согл. |  | Голод
 | Н.контр |  | Ильина
 | Утв. |  | Грицев |  |  |  | Перечень элементов

Sheet: 2
 | Поз. обозна- чение |  |  | Наименование |  |  |  | Кол. | Примечание
 |  |  |  | Соединения разборные
 | XT1 |  |  | УШЯИ.685631.123 |  |  |  | 1
Подп. и дата
Инв. № дубл.
Взам. инв.№
Подп. и дата
Инв. № подл.
 |  |  |  |  |  |  | ПЭ3 |  |  | Лист
 |  |  |  |  |  |  |  |  |  | 2
 | Изм. | Лист | № докум. |  | Подп. | Дата
