Sasha7b9Work/LiniaServer/_Лисенков/На последок - Канал С (блоки,платы)/50В-32/УШЯИ 411522.032 Э3_ВП.xls

Sheet: . Первый лист.
Перв. примен. | № строки | Наименование | Код продукции | Обозначение документа на поставки | Поставщик |  |  |  | Куда входит (обозначение) |  |  |  | Количество |  |  |  |  |  | Примечание
 |  |  |  |  |  |  |  |  |  |  |  |  | На изделие | В компл-екты | На регу-лир. |  | Всего
 |  | Прочие изделия
 |  | Устройства
 | 1 | Плата УШЯИ. 687253.017 |  |  |  |  |  |  |  |  |  |  | x
 | 2 | Плата УШЯИ. 687253.018 |  |  |  |  |  |  |  |  |  |  | x
Справ. №
 |  | Транзисторы
 | 3 | IXFN210N30P3 |  |  |  |  |  |  |  |  |  |  | 2
 | 4 | пе |  |  |  |  |  |  |  |  |  |  | 1
 |  | Соединения контактные
 | 5 | TR-1.25-4S |  |  |  |  |  |  |  |  |  |  | 7
 | 6 | TR-3.5-4 |  |  |  |  |  |  |  |  |  |  | 6
 |  | Вилки
 | 7 | 280372-2 |  |  |  |  |  |  |  |  |  |  | 1
Подп. и дата | 8 | BH2-20 |  |  |  |  |  |  |  |  |  |  | 1
 | 9 | MNL-350810-1 |  |  |  |  |  |  |  |  |  |  | 1
 |  | Розетки
Инв. № дубл. | 10 | 280361 |  |  |  |  |  |  |  |  |  |  | 2
 |  | Соединения разборные
Взам. инв. № | 11 | УШЯИ.685631.123 |  |  |  |  |  |  |  |  |  |  | 1
Подп. и дата
 |  |  |  |  |  |  |  |  |  |  |  | ВП
 |  |  |  |  |  | Изм. | Лист | № докум. |  | Подп. | Дата
Инв. № подл. |  |  |  |  |  | Разраб. |  |  |  |  |  |  |  |  |  | Лит. |  | Лист |  | Листов
 |  |  |  |  |  | Пров. |  |  |  |  |  |  |  |  |  |  |  | 1 |  | 2
 |  |  |  |  |  | Согл.
 |  |  |  |  |  | Н. контр.
 |  |  |  |  |  | Утв. |  |  |  |  |  | Ведомость покупных изделий

Sheet: 2
 |  | № строки | Наименование | Код продукции | Обозначение документа на поставку | Поставщик |  |  |  | Куда входит (обозначение) |  |  |  | Количество |  |  |  | Примечание
-00 |  |  |  |  |  |  |  |  |  |  |  |  |  | На изделие | В комп-екты | На ре-гулир. | Всего
 |  | 12 | OTV |  |  |  |  |  |  |  |  |  |  | 1
 | Подп. и дата
 | Инв. № дубл.
 | Взам. инв. №
 | Подп. и дата
 | Инв. № подл.
 |  |  |  |  |  |  |  |  |  |  |  |  | ВП |  |  |  |  |  | Лист
 |  |  |  |  |  |  |  |  |  |  |  |  |  |  |  |  |  |  | 2
 |  |  |  |  |  |  | Изм. | Лист | № докум. |  | Подп. | Дата
