Sasha7b9Work/LiniaServer/_Лисенков/На последок - Канал С (блоки,платы)/50В-32/УШЯИ 411522.032 Э3_ПЭ3.xls

Sheet: . Первый лист.
Перв. примен. | Поз. обозна-чение |  |  | Наименование |  |  |  | Кол. |  | Примечание
 |  |  |  | Устройства
 | A1 |  |  | Не устанавливать |  |  |  | 1
 | A2 |  |  | Не устанавливать |  |  |  | 1
Справ. №
 |  |  |  | Транзисторы
 | VT1 |  |  | пе |  |  |  | 1
 | VT2,VT3 |  |  | IXFN210N30P3 |  |  |  | 2
 |  |  |  | Соединения контактные
 | X1-X6 |  |  | TR-1.25-4S |  |  |  | 6
 | X1 |  |  | TR-3.5-4 |  |  |  | 1
Подп. и дата | X7-X11 |  |  | TR-3.5-4 |  |  |  | 5
 | X12 |  |  | TR-1.25-4S |  |  |  | 1
 |  |  |  | Вилки
Инв. № дубл.
 | XP1 |  |  | BH2-20 |  |  |  | 1
 | XP5 |  |  | 280372-2 |  |  |  | 1
Взам. инв.№ | XP6 |  |  | MNL-350810-1 |  |  |  | 1
Подп. и дата
 |  |  |  |  |  |  | ПЭ3
 | Изм. | Лист | № докум. |  | Подп. | Дата
Инв. № подл. | Разраб. |  | Сидорик |  |  |  |  |  | Лит. |  | Лист | Листов
 | Пров. |  | Лисенков |  |  |  |  |  |  |  | 1 | 2
 | Согл. |  | Голод
 | Н.контр |  | Ильина
 | Утв. |  | Грицев |  |  |  | Перечень элементов

Sheet: 2
 | Поз. обозна- чение |  |  | Наименование |  |  |  | Кол. | Примечание
 |  |  |  | Розетки
 | XS1,XS2 |  |  | 280361 |  |  |  | 2
 |  |  |  | Соединения разборные
 | XT1 |  |  | УШЯИ.685631.123 |  |  |  | 1
 | 5 |  |  | OTV |  |  |  | 1
Подп. и дата
Инв. № дубл.
Взам. инв.№
Подп. и дата
Инв. № подл.
 |  |  |  |  |  |  | ПЭ3 |  |  | Лист
 |  |  |  |  |  |  |  |  |  | 2
 | Изм. | Лист | № докум. |  | Подп. | Дата
