Sasha7b9Work/LiniaServer/_Лисенков/На последок - Канал С (блоки,платы)/Выпрямитель/Плата Выпрямитель УШЯИ.687253.019_ВП.xls

Линия-2 | Перв. примен. | № строки | Наименование | Код продукции | Обозначение документа на поставки | Поставщик |  |  |  | Куда входит (обозначение) |  |  |  | Количество |  |  |  |  |  | Примечание
 |  |  |  |  |  |  |  |  |  |  |  |  |  | На изделие | В компл-екты | На регу-лир. |  | Всего
 |  |  | Прочие изделия
 |  |  | Конденсаторы
 |  | 1 | GRM2165C2A102JA01D |  |  |  |  |  |  |  |  |  |  | 2
 |  | 2 | К73-17-250 В-0,47 мкФ +-20% |  |  |  |  |  |  |  |  |  |  | 2
 | Справ. № | 3 | К73-17-250 В-1 мкФ +-20% |  |  |  |  |  |  |  |  |  |  | 2
 |  |  | Резисторы
 |  | 4 | 1206-100 Ом+-5% |  |  |  |  |  |  |  |  |  |  | 1
 |  | 5 | 1206-150 Ом+-5% |  |  |  |  |  |  |  |  |  |  | 2
 |  | 6 | 1206-240 Ом+-5% |  |  |  |  |  |  |  |  |  |  | 2
 |  | 7 | 1206-9,1 кОм+-5% |  |  |  |  |  |  |  |  |  |  | 3
 |  |  | Диоды
 |  | 8 | 1,5KE68CA |  |  |  |  |  |  |  |  |  |  | 2
 |  | 9 | 1N4007 |  |  |  |  |  |  |  |  |  |  | 2
 | Подп. и дата | 10 | 43CTQ100 |  |  |  |  |  |  |  |  |  |  | 2
 |  |  | Вилки
 |  | 11 | MNL-350810-1 |  |  |  |  |  |  |  |  |  |  | 1
 | Инв. № дубл.
 |  | 12 | OTV18 |  |  |  |  |  |  |  |  |  |  | 15
 | Взам. инв. №
 | Подп. и дата
 |  |  |  |  |  |  |  |  |  |  |  |  | ВП
 |  |  |  |  |  |  | Изм. | Лист | № докум. |  | Подп. | Дата
 | Инв. № подл. |  |  |  |  |  | Разраб. |  |  |  |  |  |  |  |  |  | Лит. |  | Лист |  | Листов
 |  |  |  |  |  |  | Пров.
 |  |  |  |  |  |  | Согл.
 |  |  |  |  |  |  | Н. контр.
 |  |  |  |  |  |  | Утв. |  |  |  |  |  | Ведомость покупных изделий
