Sasha7b9Work/LiniaServer/_Лисенков/На последок - Канал С (блоки,платы)/Измеритель тока - интерфейса/Плата интерфейса УШЯИ.687243.351_ВП.xls

Sheet: . Первый лист.
Перв. примен. | № строки | Наименование | Код продукции | Обозначение документа на поставки | Поставщик |  |  |  | Куда входит (обозначение) |  |  |  | Количество |  |  |  |  |  | Примечание
 |  |  |  |  |  |  |  |  |  |  |  |  | На изделие | В компл-екты | На регу-лир. |  | Всего
 |  | Прочие изделия
 |  | Конденсаторы
 | 1 | 0805-NP0-50 В-2,4 пФ-1% |  |  |  |  |  |  |  |  |  |  | 5
 | 2 | 1206-С0G-50 B-56 пФ+-1% |  |  |  |  |  |  |  |  |  |  | 5
Справ. №
 |  | Микросхемы
 | 3 | ADA4807-2ARMZ |  |  |  |  |  |  |  |  |  |  | 5
 |  | Резисторы
 | 4 | 1206-30 Ом+-5% |  |  |  |  |  |  |  |  |  |  | 2
 | 5 | 1206-102 Ом+-1% |  |  |  |  |  |  |  |  |  |  | 5
 | 6 | 1206-140 Ом+-1% |  |  |  |  |  |  |  |  |  |  | 5
 | 7 | 1206-215 Ом+-1% |  |  |  |  |  |  |  |  |  |  | 5
 | 8 | 1206-1 кОм+-5% |  |  |  |  |  |  |  |  |  |  | 1
 | 9 | 1206-5,23 кОм+-1% |  |  |  |  |  |  |  |  |  |  | 5
Подп. и дата
 |  | Диоды
 | 10 | BZX384-C4V7 |  |  |  |  |  |  |  |  |  |  | 1
 | 11 | SFH203 |  |  |  |  |  |  |  |  |  |  | 5
Инв. № дубл. | 12 | VSMY2853RG |  |  |  |  |  |  |  |  |  |  | 2
 |  | Транзисторы
Взам. инв. № | 13 | BSS138BK |  |  |  |  |  |  |  |  |  |  | 2
Подп. и дата
 |  |  |  |  |  |  |  |  |  |  |  | ВП
 |  |  |  |  |  | Изм. | Лист | № докум. |  | Подп. | Дата
Инв. № подл. |  |  |  |  |  | Разраб. |  |  |  |  |  |  |  |  |  | Лит. |  | Лист |  | Листов
 |  |  |  |  |  | Пров. |  |  |  |  |  |  |  |  |  |  |  | 1 |  | 2
 |  |  |  |  |  | Согл.
 |  |  |  |  |  | Н. контр.
 |  |  |  |  |  | Утв. |  |  |  |  |  | Ведомость покупных изделий

Sheet: 2
 |  | № строки | Наименование | Код продукции | Обозначение документа на поставку | Поставщик |  |  |  | Куда входит (обозначение) |  |  |  | Количество |  |  |  | Примечание
-00 |  |  |  |  |  |  |  |  |  |  |  |  |  | На изделие | В комп-екты | На ре-гулир. | Всего
 |  |  | Вилки
 |  | 14 | DS1018-02-16B2 |  |  |  |  |  |  |  |  |  |  | 1
 |  |  | Розетки
 |  | 15 | IDC2-16 |  |  |  |  |  |  |  |  |  |  | 1
 | Подп. и дата
 | Инв. № дубл.
 | Взам. инв. №
 | Подп. и дата
 | Инв. № подл.
 |  |  |  |  |  |  |  |  |  |  |  |  | ВП |  |  |  |  |  | Лист
 |  |  |  |  |  |  |  |  |  |  |  |  |  |  |  |  |  |  | 2
 |  |  |  |  |  |  | Изм. | Лист | № докум. |  | Подп. | Дата
