Sasha7b9Work/LiniaServer/_Лисенков/На последок - Канал С (блоки,платы)/Измеритель тока - измеритель/Плата измерителя УШЯИ.687243.352_ВП.xls

Sheet: УШЯИ.687243.352. Первый лист.
Перв. примен. | УШЯИ.687243.352 | № строки | Наименование | Код продукции | Обозначение документа на поставки | Поставщик |  |  |  | Куда входит (обозначение) |  |  |  | Количество |  |  |  |  |  | Примечание
 |  |  |  |  |  |  |  |  |  |  |  |  |  | На изделие | В компл-екты | На регу-лир. |  | Всего
 |  |  | Прочие изделия
 |  |  | Конденсаторы
 |  | 1 | 0805-C0G-50 В-240 пФ +-5% |  |  |  |  |  |  |  |  |  |  | 1
 |  | 2 | 0805-X7R-25 В-0,1 мкФ +-10% |  |  |  |  |  |  |  |  |  |  | 1
Справ. № |  | 3 | 0805-X7R-25 В-1 мкФ +-10% |  |  |  |  |  |  |  |  |  |  | 4
 |  | 4 | 1206-NP0-500 B-270 пФ+-5% |  |  |  |  |  |  |  |  |  |  | 1
 |  | 5 | 1206-X7R-10 B-10 мкФ+-10% |  |  |  |  |  |  |  |  |  |  | 1
 |  | 6 | 1206-X7R-25 B-47мкФ+-10% |  |  |  |  |  |  |  |  |  |  | 4
 |  | 7 | 1206-X7R-50 B-0,01 мкФ+-10% |  |  |  |  |  |  |  |  |  |  | 4
 |  | 8 | 1206-X7R-50 B-0,1 мкФ+-10% |  |  |  |  |  |  |  |  |  |  | 13
 |  | 9 | 1206-X7R-50 B-0,33 мкФ+-10% |  |  |  |  |  |  |  |  |  |  | 1
 |  | 10 | 1206-X7R-50 B-2,2 мкФ+-10% |  |  |  |  |  |  |  |  |  |  | 3
 |  | 11 | 1206-X7R-50 B-10 мкФ+-10% |  |  |  |  |  |  |  |  |  |  | 4
 |  | 12 | 1206-XP7-500 B-15 нФ+-10% |  |  |  |  |  |  |  |  |  |  | 1
 |  | 13 | 1206-XP7-630 B-3,3 нФ+-10% |  |  |  |  |  |  |  |  |  |  | 1
Подп. и дата |  | 14 | JRB-25В-220мкФ |  |  |  |  |  |  |  |  |  |  | 1
 |  | 15 | JRB-25В-1000 мкФ |  |  |  |  |  |  |  |  |  |  | 1
 |  | 16 | JRB-35В-470мкФ |  |  |  |  |  |  |  |  |  |  | 1
 |  | 17 | JRB-50В-4,7мкФ |  |  |  |  |  |  |  |  |  |  | 1
Инв. № дубл.
 |  |  | Микросхемы
 |  | 18 | AD7691BRM |  |  |  |  |  |  |  |  |  |  | 1
Взам. инв. № |  | 19 | AD8031BRZ |  |  |  |  |  |  |  |  |  |  | 1
 |  | 20 | ADA4637-1ARZ |  |  |  |  |  |  |  |  |  |  | 2
Подп. и дата
 |  |  |  |  |  |  |  |  |  |  |  |  | УШЯИ.687243.352 ВП
 |  |  |  |  |  |  | Изм. | Лист | № докум. |  | Подп. | Дата
Инв. № подл. |  |  |  |  |  |  | Разраб. |  | Сидорик |  |  |  | Плата измерителя |  |  |  | Лит. |  | Лист |  | Листов
 |  |  |  |  |  |  | Пров. |  | Лисенков |  |  |  |  |  |  |  |  |  | 1 |  | 5
 |  |  |  |  |  |  | Согл. |  | Голод
 |  |  |  |  |  |  | Н. контр. |  | Ильина
 |  |  |  |  |  |  | Утв. |  | Грицев |  |  |  | Ведомость покупных изделий

Sheet: 2
 |  | № строки | Наименование | Код продукции | Обозначение документа на поставку | Поставщик |  |  |  | Куда входит (обозначение) |  |  |  | Количество |  |  |  | Примечание
-00 |  |  |  |  |  |  |  |  |  |  |  |  |  | На изделие | В комп-екты | На ре-гулир. | Всего
 |  |  | Микросхемы
 |  | 21 | ADA4941-1YRZ |  |  |  |  |  |  |  |  |  |  | 1
 |  | 22 | ADG431BR |  |  |  |  |  |  |  |  |  |  | 1
 |  | 23 | ADG433BR |  |  |  |  |  |  |  |  |  |  | 1
 |  | 24 | ADR434BR |  |  |  |  |  |  |  |  |  |  | 1
 |  | 25 | IN74HC00AD |  |  |  |  |  |  |  |  |  |  | 1
 |  | 26 | IN74HC08AD |  |  |  |  |  |  |  |  |  |  | 2
 |  | 27 | IN74HC138AD |  |  |  |  |  |  |  |  |  |  | 1
 |  | 28 | IN74HC139AD |  |  |  |  |  |  |  |  |  |  | 1
 |  | 29 | IN74HC595AD |  |  |  |  |  |  |  |  |  |  | 1
 |  | 30 | MAX809S |  |  |  |  |  |  |  |  |  |  | 1
 |  | 31 | TLV1842 |  |  |  |  |  |  |  |  |  |  | 1
 |  | 32 | TLV9151IDR |  |  |  |  |  |  |  |  |  |  | 3
 |  | 33 | TLV9152IDR |  |  |  |  |  |  |  |  |  |  | 2
 |  | 34 | TPS7A3301 |  |  |  |  |  |  |  |  |  |  | 1
 |  | 35 | TPS7A4701 |  |  |  |  |  |  |  |  |  |  | 3
 | Подп. и дата
 |  |  | Элементы защиты по
 |  |  | напряжению
 |  | 36 | 2027-09-B19 |  |  |  |  |  |  |  |  |  |  | 2
 | Инв. № дубл.
 |  |  | Реле
 |  | 37 | SIL05-1A72-71L |  |  |  |  |  |  |  |  |  |  | 7
 | Взам. инв. № | 38 | УШЯИ.685442.092vs2Rel |  |  |  |  |  |  |  |  |  |  | 1
 |  |  | Резисторы
 | Подп. и дата | 39 | 0805-332 Ом+-0,1% |  |  |  |  |  |  |  |  |  |  | 1
 |  | 40 | 0805-1 кОм+-0,1% |  |  |  |  |  |  |  |  |  |  | 9
 |  | 41 | 1206-4,99 Ом+-0,1% |  |  |  |  |  |  |  |  |  |  | 1
 |  | 42 | 1206-10 Ом+-5% |  |  |  |  |  |  |  |  |  |  | 1
 | Инв. № подл. | 43 | 1206-22 Ом+-5% |  |  |  |  |  |  |  |  |  |  | 2
 |  |  |  |  |  |  |  |  |  |  |  |  | УШЯИ.687243.352 ВП |  |  |  |  |  | Лист
 |  |  |  |  |  |  |  |  |  |  |  |  |  |  |  |  |  |  | 2
 |  |  |  |  |  |  | Изм. | Лист | № докум. |  | Подп. | Дата

Sheet: 3
 |  | № строки | Наименование | Код продукции | Обозначение документа на поставку | Поставщик |  |  |  | Куда входит (обозначение) |  |  |  | Количество |  |  |  | Примечание
-00 |  |  |  |  |  |  |  |  |  |  |  |  |  | На изделие | В комп-екты | На ре-гулир. | Всего
 |  |  | Резисторы
 |  | 44 | 1206-27 Ом+-5% |  |  |  |  |  |  |  |  |  |  | 1
 |  | 45 | 1206-51 Ом+-5% |  |  |  |  |  |  |  |  |  |  | 3
 |  | 46 | 1206-470 Ом+-5% |  |  |  |  |  |  |  |  |  |  | 7
 |  | 47 | 1206-499 Ом+-0,1% |  |  |  |  |  |  |  |  |  |  | 1
 |  | 48 | 1206-1 кОм+-0.1% |  |  |  |  |  |  |  |  |  |  | 3
 |  | 49 | 1206-1 кОм+-1% |  |  |  |  |  |  |  |  |  |  | 1
 |  | 50 | 1206-1,82 кОм+-0,1% |  |  |  |  |  |  |  |  |  |  | 1
 |  | 51 | 1206-2 кОм+-0.1% |  |  |  |  |  |  |  |  |  |  | 1
 |  | 52 | 1206-2,4 кОм+-5% |  |  |  |  |  |  |  |  |  |  | 2
 |  | 53 | 1206-4,02 кОм+-0,1% |  |  |  |  |  |  |  |  |  |  | 1
 |  | 54 | 1206-4,7 кОм+-5% |  |  |  |  |  |  |  |  |  |  | 1
 |  | 55 | 1206-5,1 кОм+-5% |  |  |  |  |  |  |  |  |  |  | 2
 |  | 56 | 1206-7,15 кОм+-1% |  |  |  |  |  |  |  |  |  |  | 1
 |  | 57 | 1206-9,09 кОм+-1% |  |  |  |  |  |  |  |  |  |  | 1
 |  | 58 | 1206-10 кОм+-0,5% |  |  |  |  |  |  |  |  |  |  | 1
 | Подп. и дата | 59 | 1206-10 кОм+-5% |  |  |  |  |  |  |  |  |  |  | 1
 |  | 60 | 1206-20 кОм+-5% |  |  |  |  |  |  |  |  |  |  | 1
 |  | 61 | 1206-91 кОм+-5% |  |  |  |  |  |  |  |  |  |  | 1
 |  | 62 | 1206-221 кОм+-1% |  |  |  |  |  |  |  |  |  |  | 1
 | Инв. № дубл. | 63 | 1206-510 кОм+-1% |  |  |  |  |  |  |  |  |  |  | 2
 |  | 64 | 1206-1,24 МОм+-1% |  |  |  |  |  |  |  |  |  |  | 1
 |  | 65 | 1210-100 Ом+-5% |  |  |  |  |  |  |  |  |  |  | 1
 | Взам. инв. № | 66 | 1210-1,1 кОм+-5% |  |  |  |  |  |  |  |  |  |  | 1
 |  | 67 | OAR5-R050FLF |  |  |  |  |  |  |  |  |  |  | 1
 |  | 68 | WSL5931L5000FEA |  |  |  |  |  |  |  |  |  |  | 2
 | Подп. и дата | 69 | С2-29В-0,125-22 Ом |  |  |  |  |  |  |  |  |  |  | 1
 |  |  | +-0.1%-1,0-А
 |  | 70 | С2-29В-0,125-49,9 кОм |  |  |  |  |  |  |  |  |  |  | 1
 |  |  | +-0.1%-1,0-А
 | Инв. № подл.
 |  |  |  |  |  |  |  |  |  |  |  |  | УШЯИ.687243.352 ВП |  |  |  |  |  | Лист
 |  |  |  |  |  |  |  |  |  |  |  |  |  |  |  |  |  |  | 3
 |  |  |  |  |  |  | Изм. | Лист | № докум. |  | Подп. | Дата

Sheet: 4
 |  | № строки | Наименование | Код продукции | Обозначение документа на поставку | Поставщик |  |  |  | Куда входит (обозначение) |  |  |  | Количество |  |  |  | Примечание
-00 |  |  |  |  |  |  |  |  |  |  |  |  |  | На изделие | В комп-екты | На ре-гулир. | Всего
 |  |  | Резисторы
 |  | 71 | С2-29В-0,125-332 |  |  |  |  |  |  |  |  |  |  | 1
 |  |  | кОм+-0.1%-1,0-А
 |  | 72 | С2-29В-0,25-4,99 МОм +-0.1% |  |  |  |  |  |  |  |  |  |  | 1
 |  |  | Переключатели
 |  | 73 | DRA282G |  |  |  |  |  |  |  |  |  |  | 2
 |  |  | Диоды
 |  | 74 | 1N4007WS |  |  |  |  |  |  |  |  |  |  | 4
 |  | 75 | 1N4148WS |  |  |  |  |  |  |  |  |  |  | 13
 |  | 76 | V1P22 |  |  |  |  |  |  |  |  |  |  | 8
 |  |  | Транзисторы
 |  | 77 | FZT658 |  |  |  |  |  |  |  |  |  |  | 1
 | Подп. и дата |  | Соединения контактные
 |  | 78 | TR-1,25-4 |  |  |  |  |  |  |  |  |  |  | 3
 |  |  | Вилки
 | Инв. № дубл. | 79 | 280370-2 |  |  |  |  |  |  |  |  |  |  | 1
 |  | 80 | 280371-2 |  |  |  |  |  |  |  |  |  |  | 1
 |  | 81 | DS1014-16SF1B |  |  |  |  |  |  |  |  |  |  | 1
 | Взам. инв. № | 82 | DS1074-5MVT6 |  |  |  |  |  |  |  |  |  |  | 1
 |  |  | Фильтры, ограничители
 | Подп. и дата | 83 | BNX022-01 |  |  |  |  |  |  |  |  |  |  | 3
 | Инв. № подл.
 |  |  |  |  |  |  |  |  |  |  |  |  | УШЯИ.687243.352 ВП |  |  |  |  |  | Лист
 |  |  |  |  |  |  |  |  |  |  |  |  |  |  |  |  |  |  | 4
 |  |  |  |  |  |  | Изм. | Лист | № докум. |  | Подп. | Дата

Sheet: Лист регистрации изменений.
 | Лист регистрации изменений
 | Изм. |  | Номера листов (страниц) |  |  |  |  |  |  |  | Всего листов (страниц) в докум. | № докум. | Входящий № сопроводи- тельного документа и дата | Под- пись | Дата
 |  |  | изме- ненных |  | заме- няемых |  | новых |  |  | аннули-рованных
Подп. и дата
Инв. № дубл.
Взам. инв. №
Подп. и дата
Инв.№ подл.
 |  |  |  |  |  |  |  |  | УШЯИ.687243.352 ВП |  |  |  |  |  |  | Лист
 |  |  |  |  |  |  |  |  |  |  |  |  |  |  |  | 5
 | Изм. | Лист |  | № докум |  | Подп. |  | Дата
