Sasha7b9Work/LiniaServer/_Лисенков/На последок - Канал С (блоки,платы)/Измеритель тока - оптоформирователь/Плата оптоформирователя УШЯИ.687243.350_ВП.xls

Sheet: . Первый лист.
Перв. примен. | № строки | Наименование | Код продукции | Обозначение документа на поставки | Поставщик |  |  |  | Куда входит (обозначение) |  |  |  | Количество |  |  |  |  |  | Примечание
 |  |  |  |  |  |  |  |  |  |  |  |  | На изделие | В компл-екты | На регу-лир. |  | Всего
 |  | Прочие изделия
 |  | Конденсаторы
 | 1 | 0805-NP0-50 В-2,4 пФ-1% |  |  |  |  |  |  |  |  |  |  | 2
 | 2 | 0805-X7R-25 В-0,1 мкФ +-10% |  |  |  |  |  |  |  |  |  |  | 5
Справ. № | 3 | 1206-С0G-50 B-56 пФ+-1% |  |  |  |  |  |  |  |  |  |  | 2
 |  | Микросхемы
 | 4 | ADA4807-2ARMZ |  |  |  |  |  |  |  |  |  |  | 2
 | 5 | IN74HC00AD |  |  |  |  |  |  |  |  |  |  | 1
 | 6 | SN65HVD75D |  |  |  |  |  |  |  |  |  |  | 5
 |  | Резисторы
 | 7 | 0805-10 KОМ+-5% |  |  |  |  |  |  |  |  |  |  | 1
 | 8 | 1206-30 Ом+-5% |  |  |  |  |  |  |  |  |  |  | 5
 | 9 | 1206-100 Ом+-5% |  |  |  |  |  |  |  |  |  |  | 5
Подп. и дата | 10 | 1206-102 Ом+-1% |  |  |  |  |  |  |  |  |  |  | 2
 | 11 | 1206-140 Ом+-1% |  |  |  |  |  |  |  |  |  |  | 2
 | 12 | 1206-215 Ом+-1% |  |  |  |  |  |  |  |  |  |  | 2
 | 13 | 1206-1 кОм+-5% |  |  |  |  |  |  |  |  |  |  | 8
Инв. № дубл. | 14 | 1206-5,23 кОм+-1% |  |  |  |  |  |  |  |  |  |  | 2
 |  | Диоды
Взам. инв. № | 15 | SFH203 |  |  |  |  |  |  |  |  |  |  | 2
 | 16 | VSMY2853RG |  |  |  |  |  |  |  |  |  |  | 5
Подп. и дата
 |  |  |  |  |  |  |  |  |  |  |  | ВП
 |  |  |  |  |  | Изм. | Лист | № докум. |  | Подп. | Дата
Инв. № подл. |  |  |  |  |  | Разраб. |  |  |  |  |  |  |  |  |  | Лит. |  | Лист |  | Листов
 |  |  |  |  |  | Пров. |  |  |  |  |  |  |  |  |  |  |  | 1 |  | 2
 |  |  |  |  |  | Согл.
 |  |  |  |  |  | Н. контр.
 |  |  |  |  |  | Утв. |  |  |  |  |  | Ведомость покупных изделий

Sheet: 2
 |  | № строки | Наименование | Код продукции | Обозначение документа на поставку | Поставщик |  |  |  | Куда входит (обозначение) |  |  |  | Количество |  |  |  | Примечание
-00 |  |  |  |  |  |  |  |  |  |  |  |  |  | На изделие | В комп-екты | На ре-гулир. | Всего
 |  |  | Транзисторы
 |  | 17 | BSS138BK |  |  |  |  |  |  |  |  |  |  | 5
 |  |  | Вилки
 |  | 18 | BH2-20R |  |  |  |  |  |  |  |  |  |  | 1
 | Подп. и дата
 | Инв. № дубл.
 | Взам. инв. №
 | Подп. и дата
 | Инв. № подл.
 |  |  |  |  |  |  |  |  |  |  |  |  | ВП |  |  |  |  |  | Лист
 |  |  |  |  |  |  |  |  |  |  |  |  |  |  |  |  |  |  | 2
 |  |  |  |  |  |  | Изм. | Лист | № докум. |  | Подп. | Дата
