Sasha7b9Work/LiniaServer/(list of files, cad)

Other CAD files:
_Лисенков/ОтТимы(после моего отпуска)/Измеритель Тока/Измеритель/УШЯИ 758725.634_1.dxf
