Sasha7b9Work/LiniaServer/_Лисенков/О.С. Плешевеня/Tek 371 B/Страницы 371 В -UserManual.docx

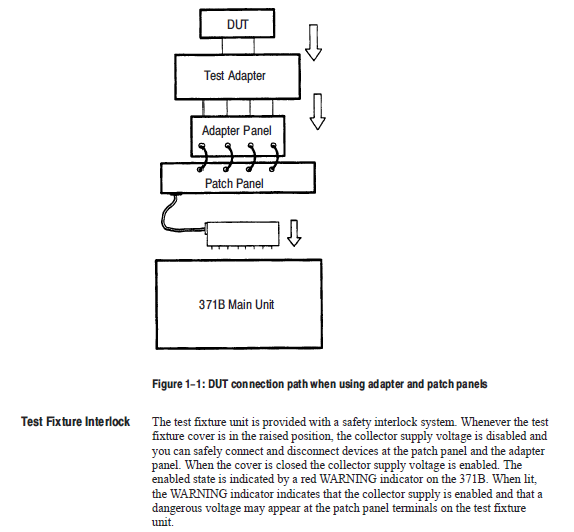
[picture p175: figure]
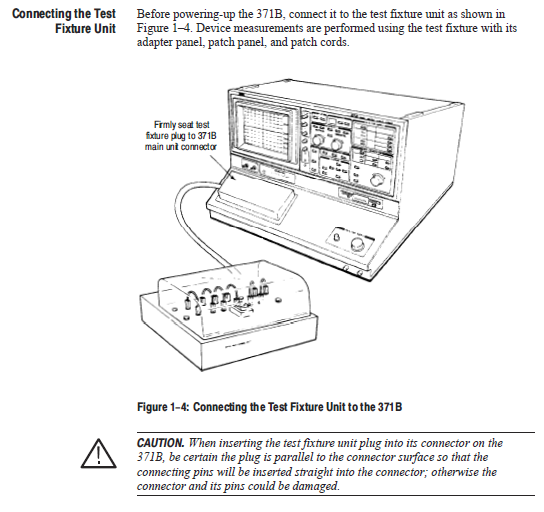
[picture p176: figure]
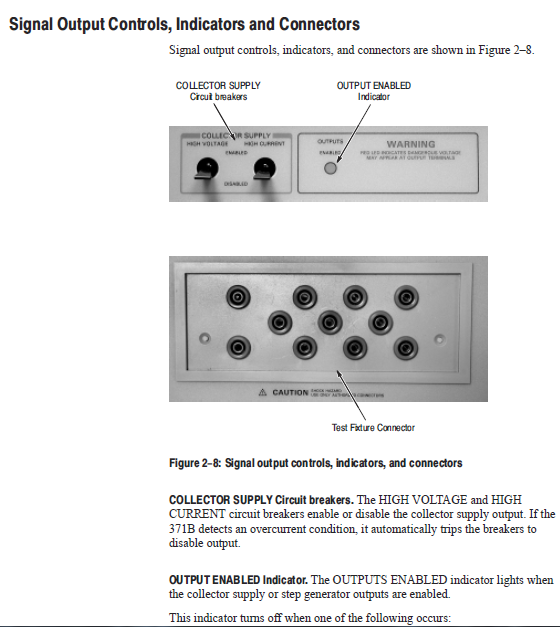
[picture p177: figure]
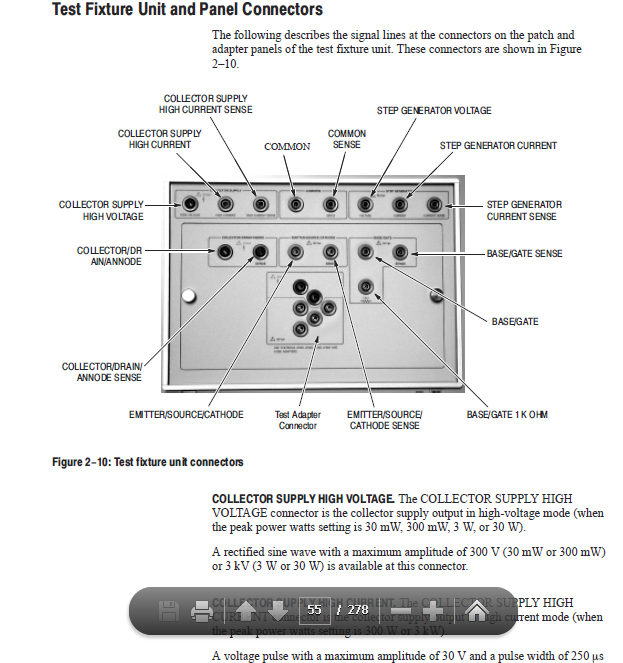
[picture p178: figure]
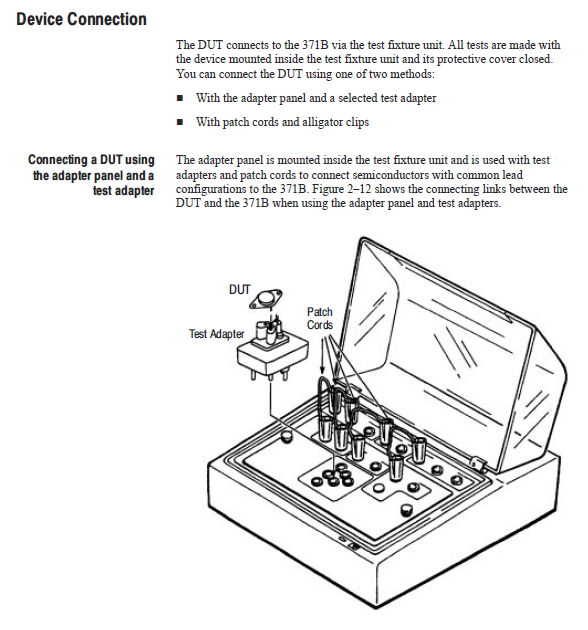
[picture p179: figure]
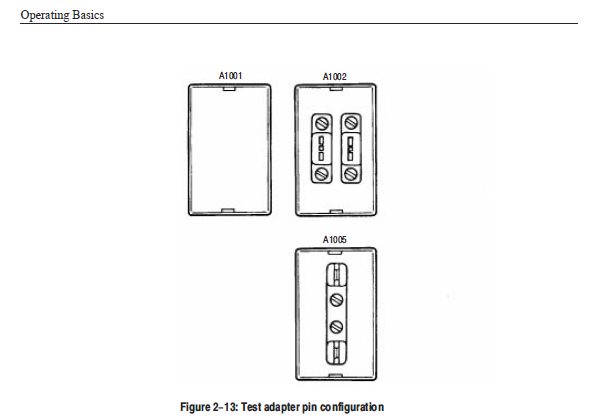
[picture p180: figure]
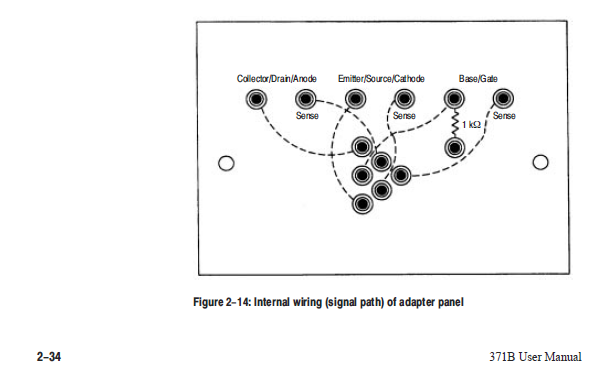
[picture p181: figure]
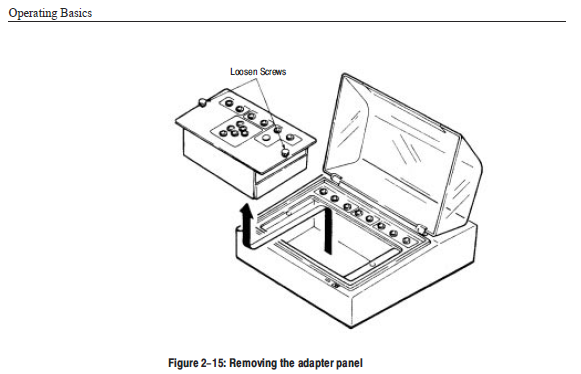
[picture p182: figure]
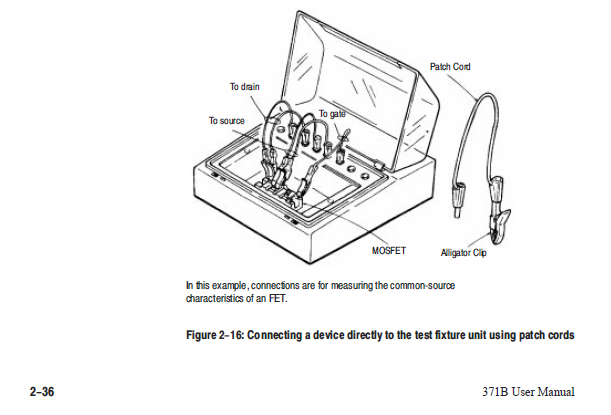
[picture p183: figure]
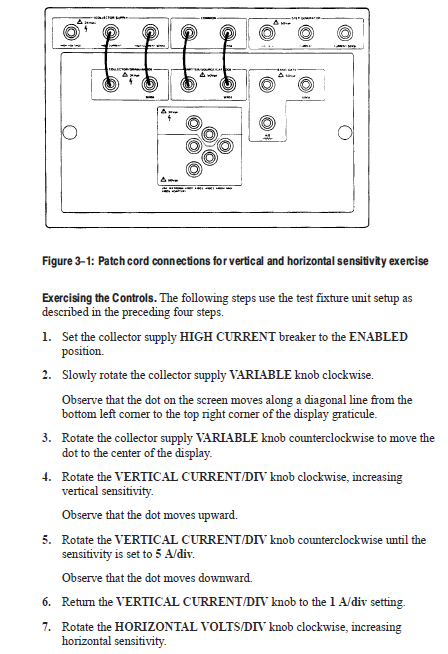
[picture p184: figure]
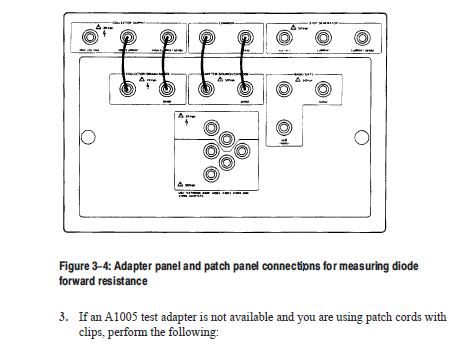
[picture p185: figure]
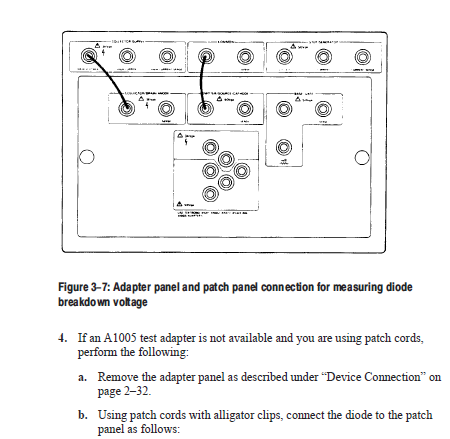
[picture p186: figure]
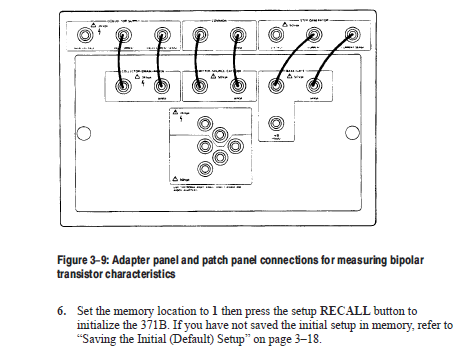
[picture p187: figure]
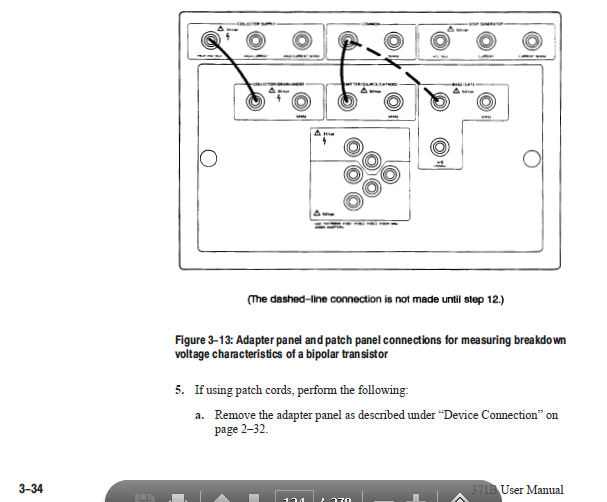
[picture p188: figure]
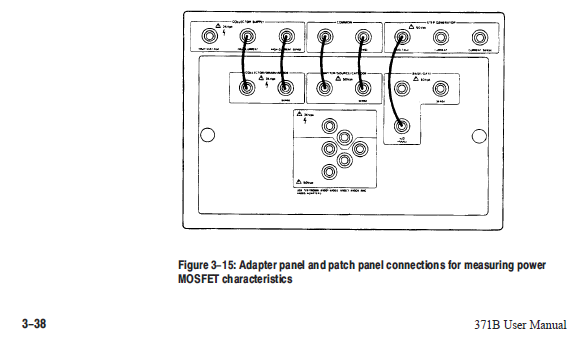
[picture p189: figure]
