Sasha7b9Work/LiniaServer/_Лисенков/Коммутатор/History/Коммутатор Фотоника ПП.pdf

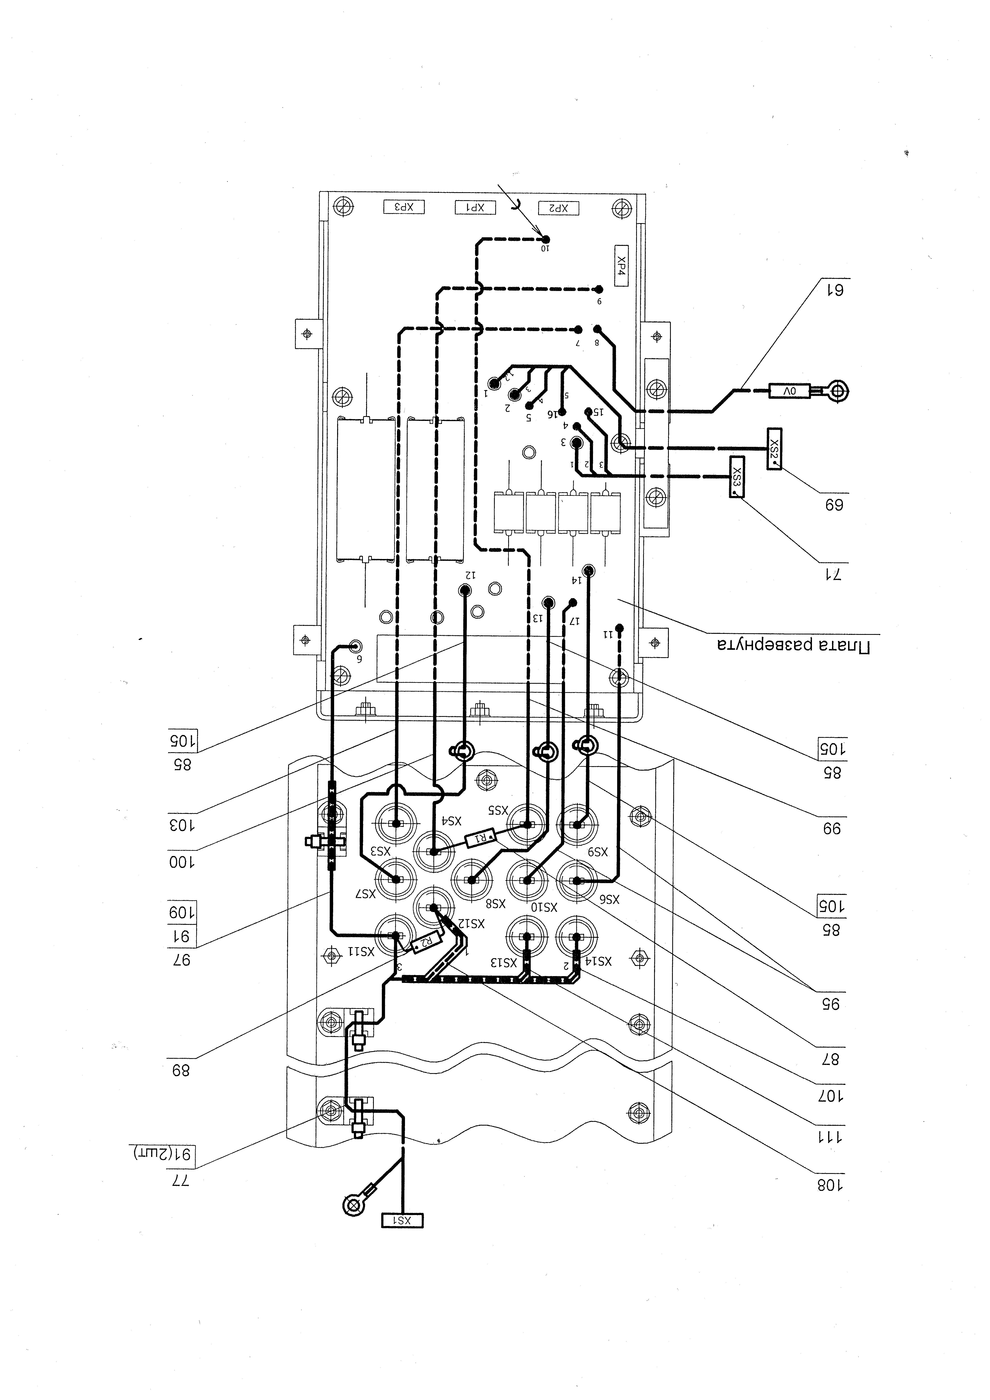
[picture p190: page 1]
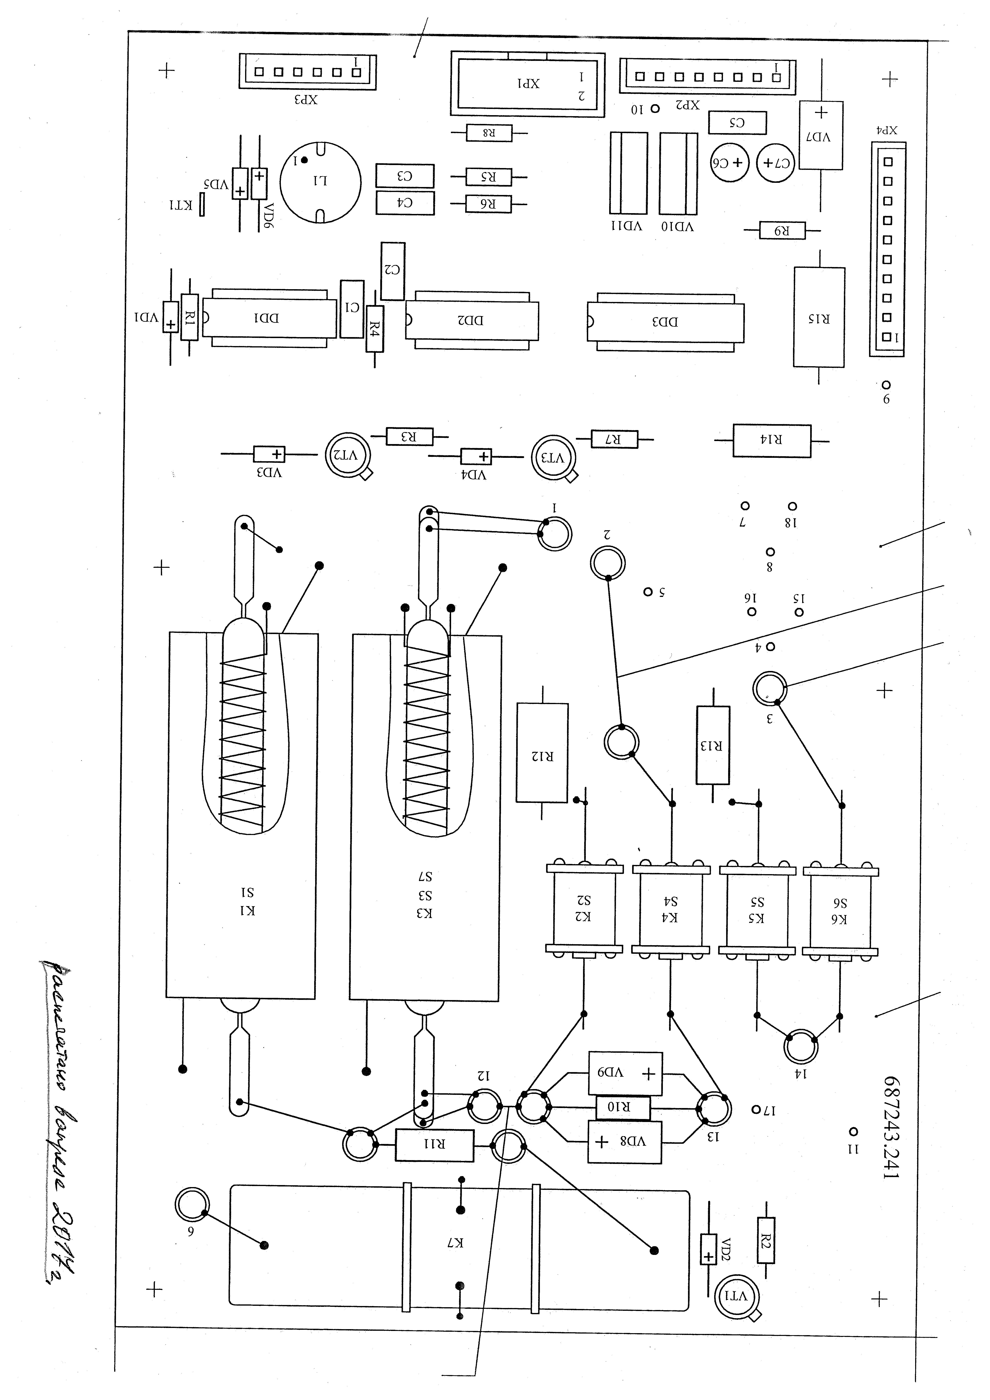
[picture p191: page 2]
