Sasha7b9Work/LiniaServer/_Лисенков/Коммутатор/History/Коммутатор.010Э-2013г-Фотоник.pdf

Инв. № подл. | Подп. и дата | Взам. инв. № | Справ. № K2 | K7 | +5i VT2

# Инв. № дубл. 0V

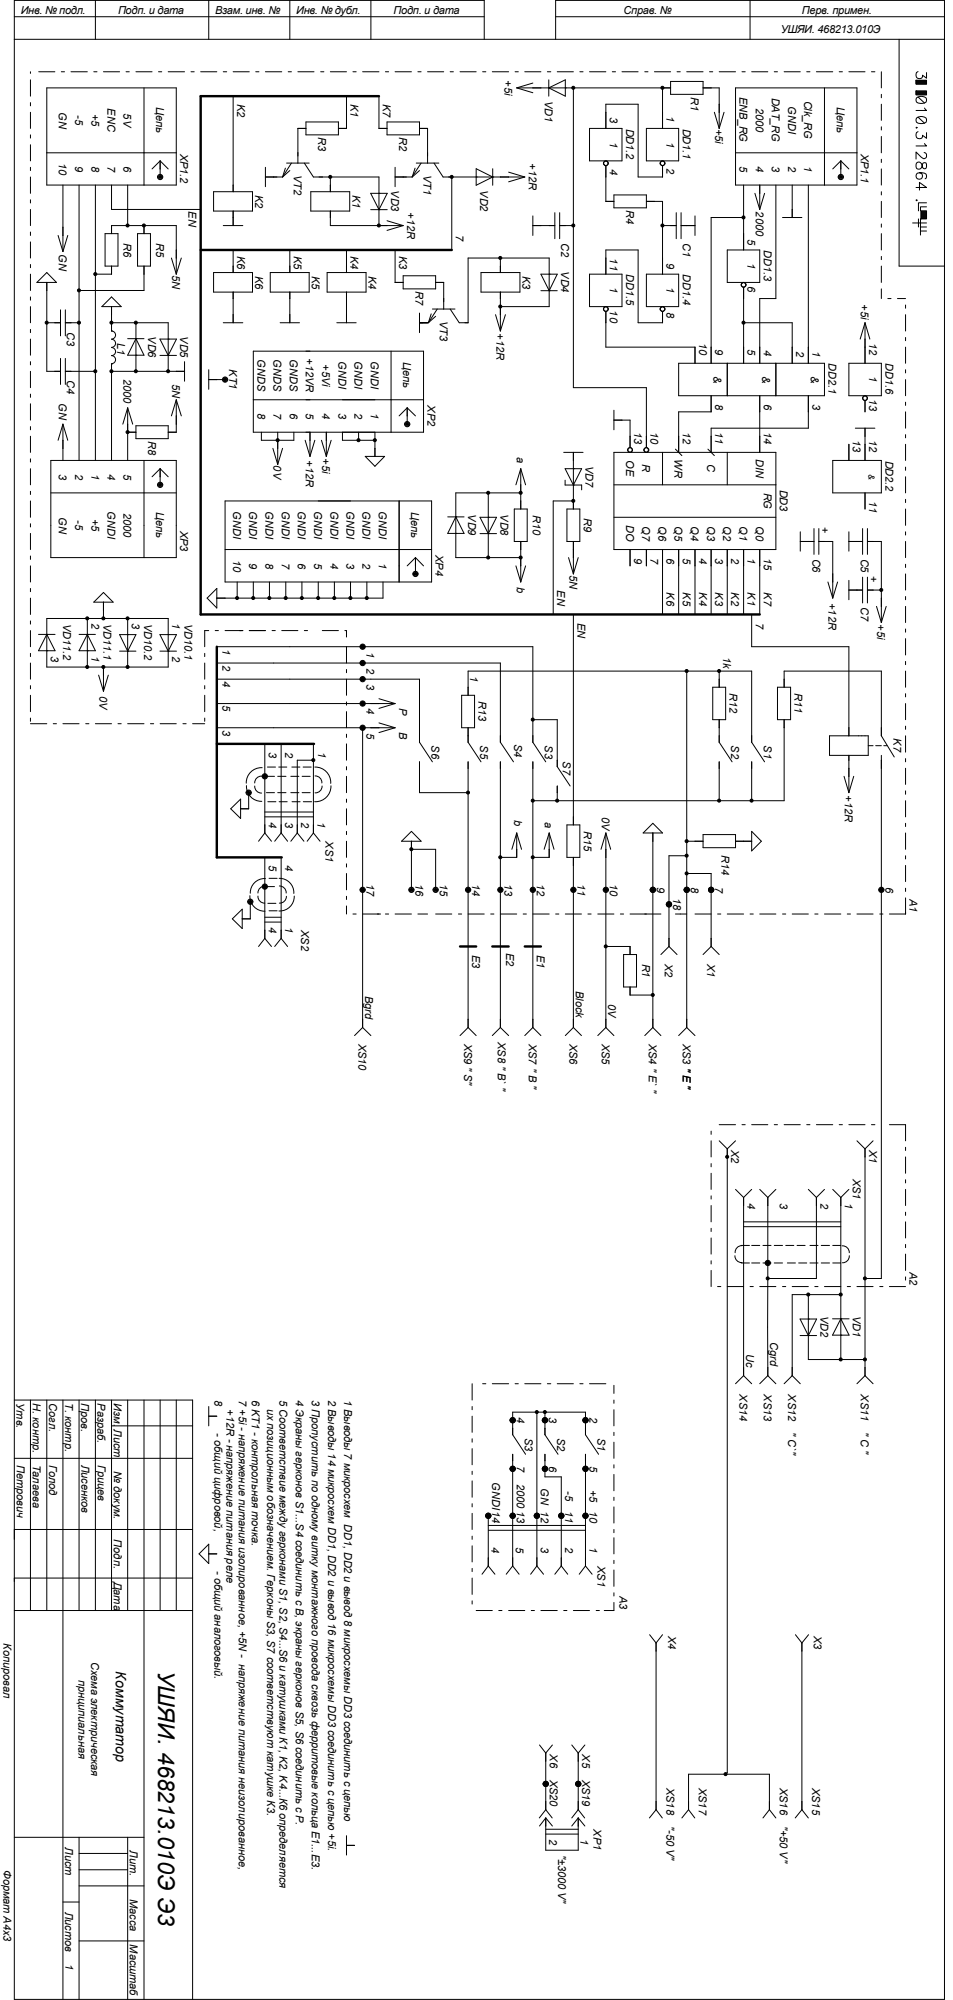
[picture p192: page 1]

1 Uc Cgrd VD2 Н. контр. Пров. A3 XS20 XS17 Формат А4x3 Масса -5 9 +5 8 5V 6 R3

2XP2 1012 GN GNDI ЦепьXP3 10 GNDI 9 GNDI 7 GNDI 6 GNDI 4 GNDI 1 GNDI VD8 VD11.1 K4 1k K1

C DOQ7 Q4 Q1 OE WR DIN Q0 Q6 Q5 Q3 Q2 Грицев 8 - общий цифровой, - общий аналоговый. +12R - напряжение питания реле 7 +5i - напряжение питания изолированное, +5N - напряжение питания неизолированное, их позиционным обозначением. Герконы S3, S7 соответствуют катушке К3. 5 Соответствие между герконами S1, S2, S4...S6 и катушками К1, K2, K4...К6 определяется 4 Экраны герконов S1...S4 соединить с В, экраны герконов S5, S6 соединить с Р. 3 Пропустить по одному витку монтажного провода сквозь ферритовые кольца Е1...Е3. 2 Выводы 14 микросхем DD1, DD2 и вывод 16 микросхемы DD3 соединить с цепью +5i. 1 Выводы 7 микросхем DD1, DD2 и вывод 8 микросхемы DD3 соединить с цепью

2 GNDI GNDI GNDI Цепь XP4 VD9 R10 R9 15 DD3 C5

3 XS1 VD1 Утв. Согл. Т. контр. Разраб. Изм. Лист XS14 XS13 XS12 " C`" XS11 " C " № докум. GNDI 4 2000 GN
