Sasha7b9Work/LiniaServer/_Лисенков/Измеритель тока/test.pdf

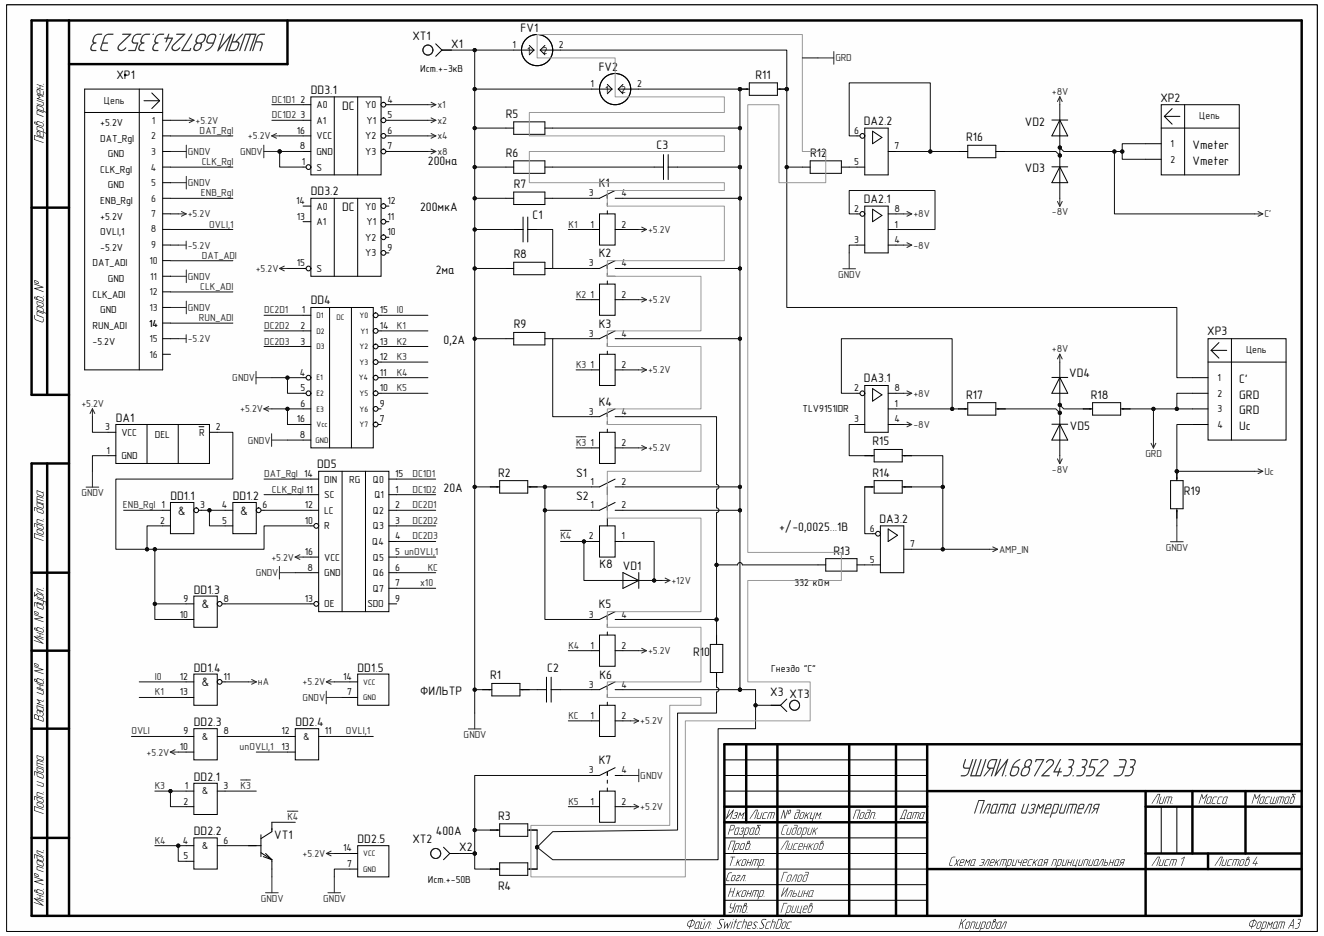
[picture p193: page 1]

Цепь
+5.2V DAT_RgI GND CLK_RgI GND ENB_RgI +5.2V OVLI,1 -5.2V DAT_ADI GND CLK_ADI GND RUN_ADI -5.2V | 1 2 3 4 5 6 7 8 9 10 11 12 13 14 15 16
