Sasha7b9Work/LiniaServer/_Лисенков/Контроллер/test ФЕВРАЛЬ 26_ листы 4,5 .Э3.pdf

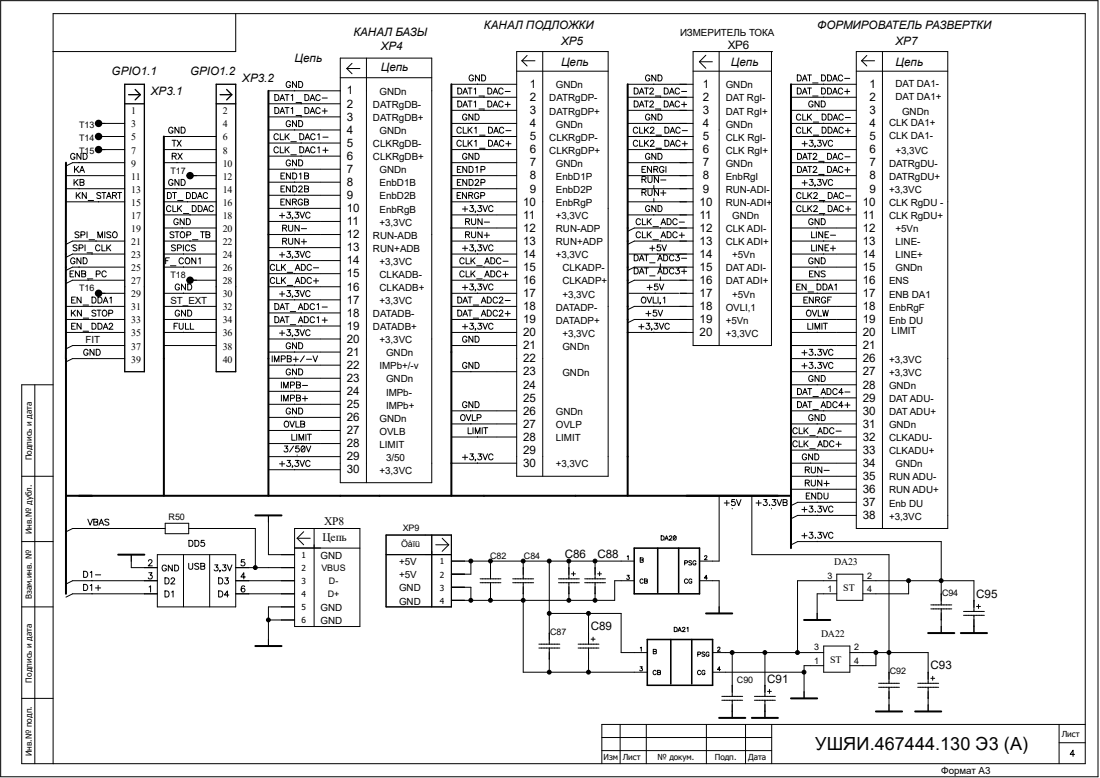
[picture p194: page 1]

C95 Инв.№ подп. Подпись и дата Взам.инв. № Подпись и дата Инв.№ дубл.

Цепь
1 2 3 4 5 6 | GND VBUS D-D+ GND GND

Öåïü
+5V +5V GND GND | 1 2 3 4

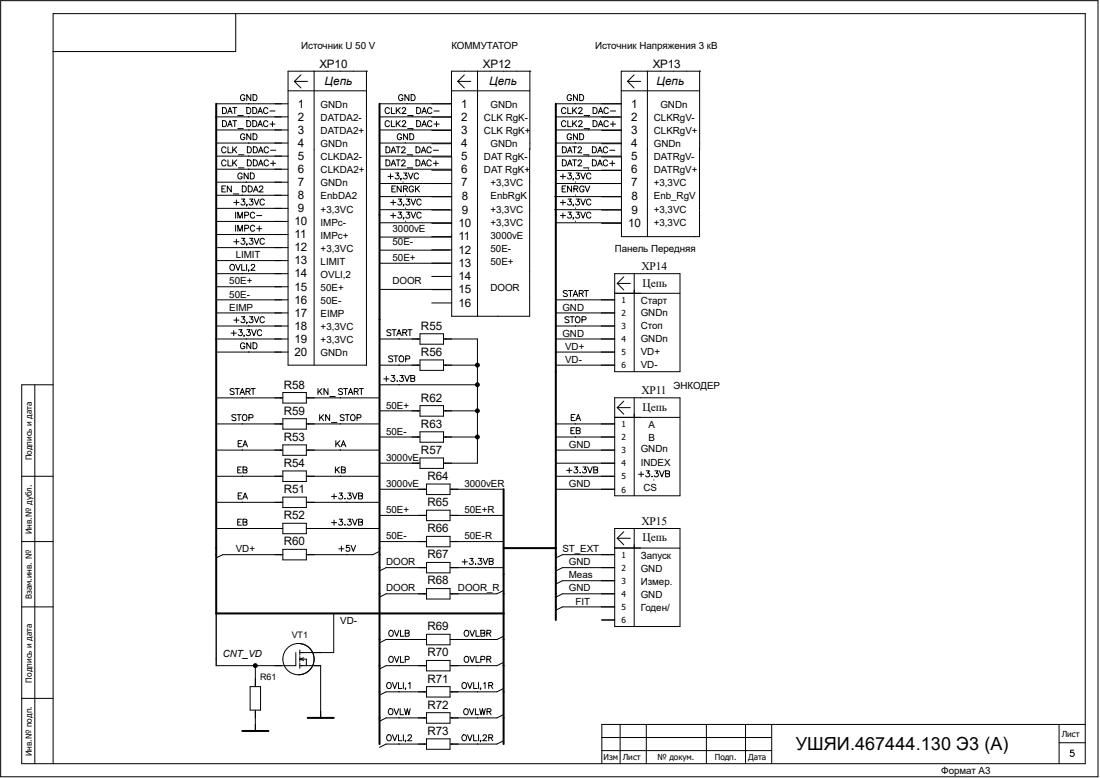
[picture p195: page 2]

CSAB Инв.№ подп. Подпись и дата Взам.инв. № Подпись и дата Инв.№ дубл.
