Sasha7b9Work/LiniaServer/_Лисенков/32 схема 2 транзистора.pdf

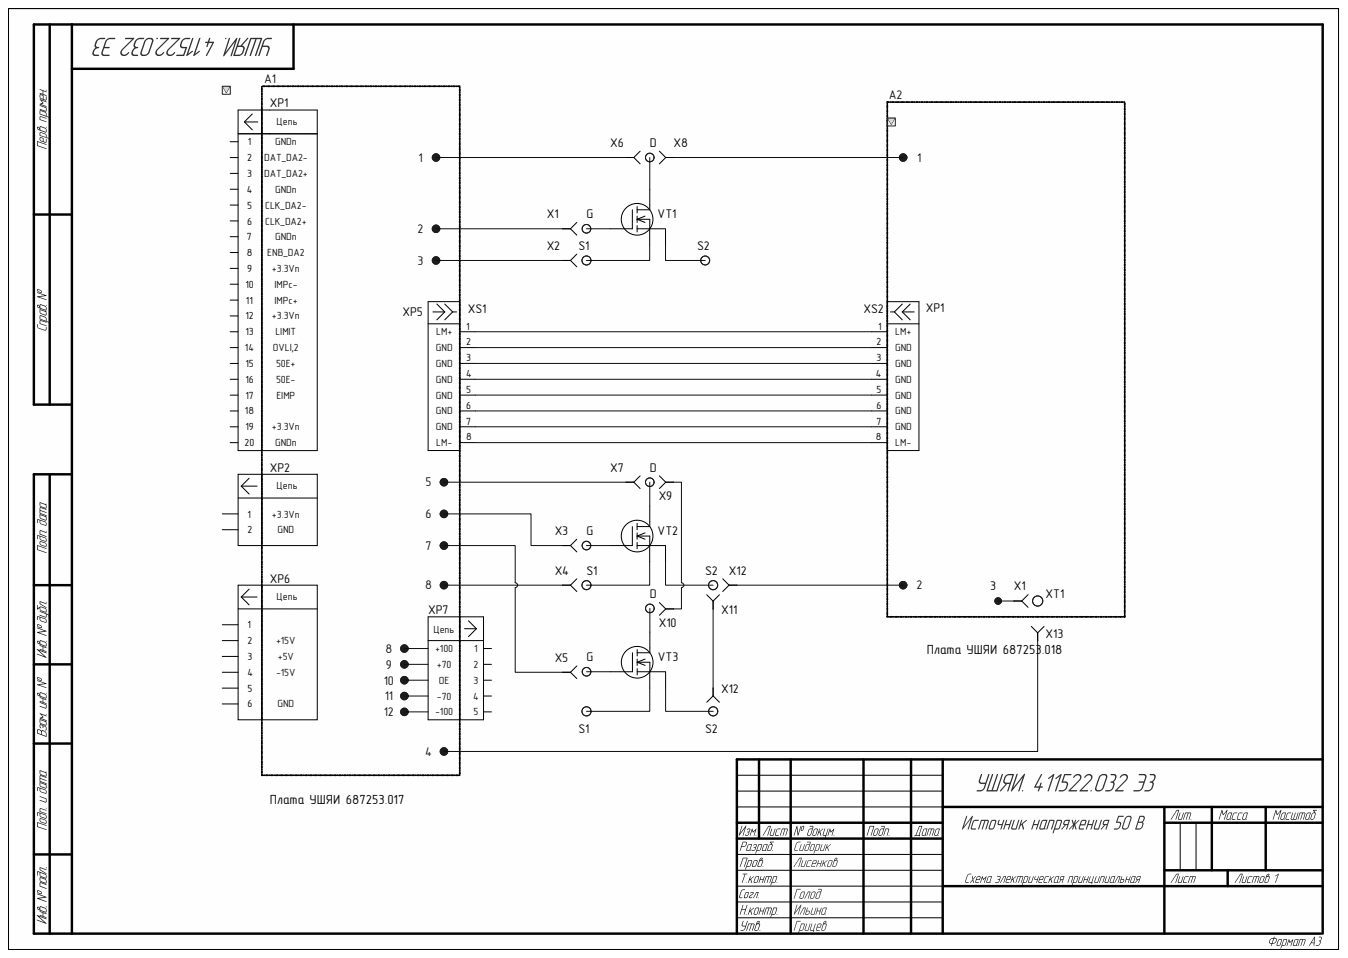
[picture p196: page 1]
ALTIUM GOSTBOM2.0 KEV; LM+ GND GND GND GND GND GND; +3.3Vn GND; Цепь; GND; DAT_DA2- DAT_DA2+; CLK_DA2- CLK_DA2+; ENB_DA2; IMPc- IMPc+; OVLI,2; LIMIT; GNDn; EIMP; Плата УШЯИ 687253.017; Плата УШЯИ 687253.018 VT3

Цепь
+100 +70 OE -70 -100 | 12345
