Sasha7b9Work/LiniaServer/Контроллер/467444.130-L1.pdf

DD1.2

DD1.1

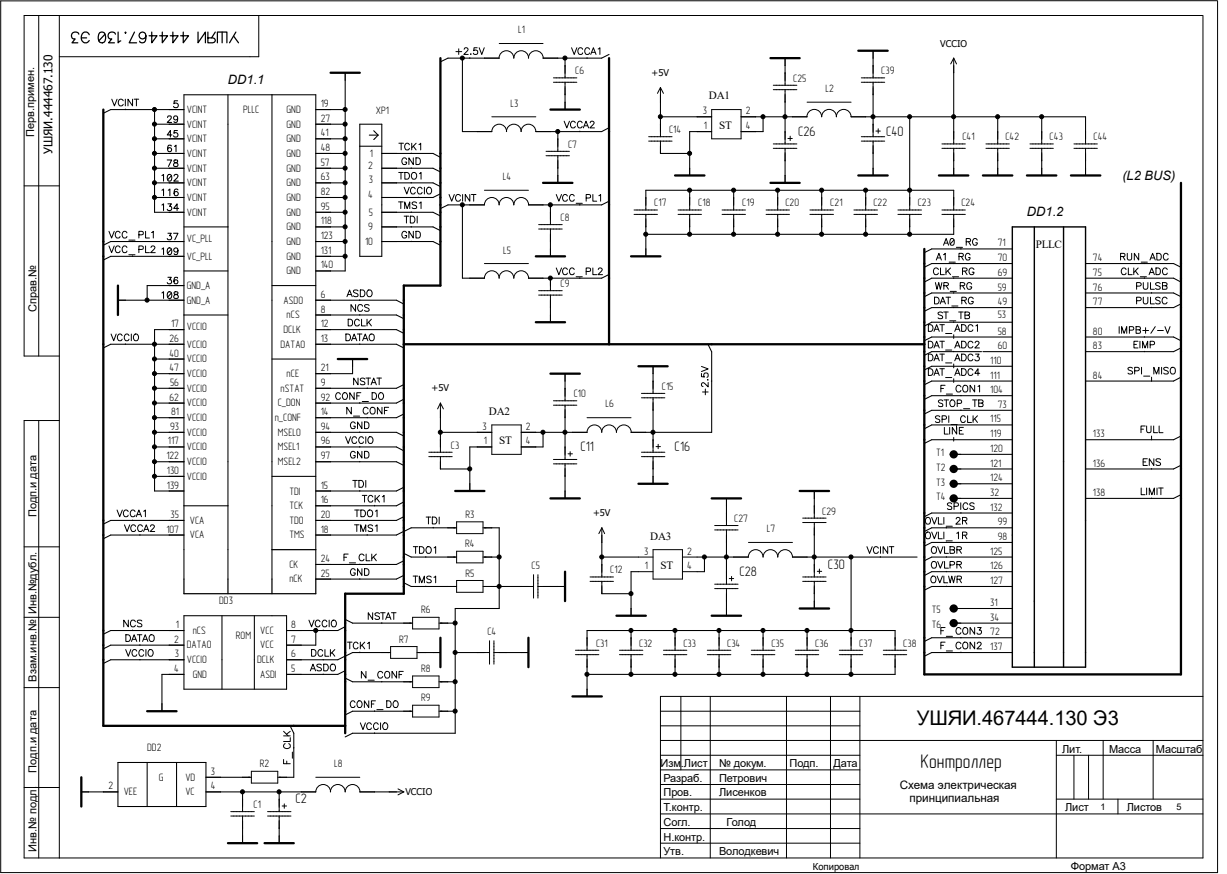
[picture p197: page 1]

VCINT VCINT VCINT VCINT | GND GND GND GND GND GND

VC_PLL | | 123

75 Подп.и дата Взам.инв.№ Справ.№

17 | | 8
VCCIO VCCIO VCCIO VCCIO VCCIO VCCIO VCCIO VCCIO VCCIO VCCIO VCCIO | 12
26 40 | | 13

47 | nCE nSTAT C_DON n_CONF MSEL0 MSEL1 MSEL2
56 | | 9
62 | | 92
81 | | 14
93 | | 94

УШЯИ.467444.130 Э3

Êîíòðîëëåð Схема электрическая принципиальная | Лит. | Масса | Масштаб

Изм.Лист | | № докум. | Подп. | Дата
Разраб. | | Петрович
Пров. | | Лисенков
Т.контр. | | | | | Лист 1 | Листов 5
Согл. | Голод
Н.контр.
Утв. | Володкевич
