Sasha7b9Work/LiniaServer/_Лисенков/аыва2ыв.pdf

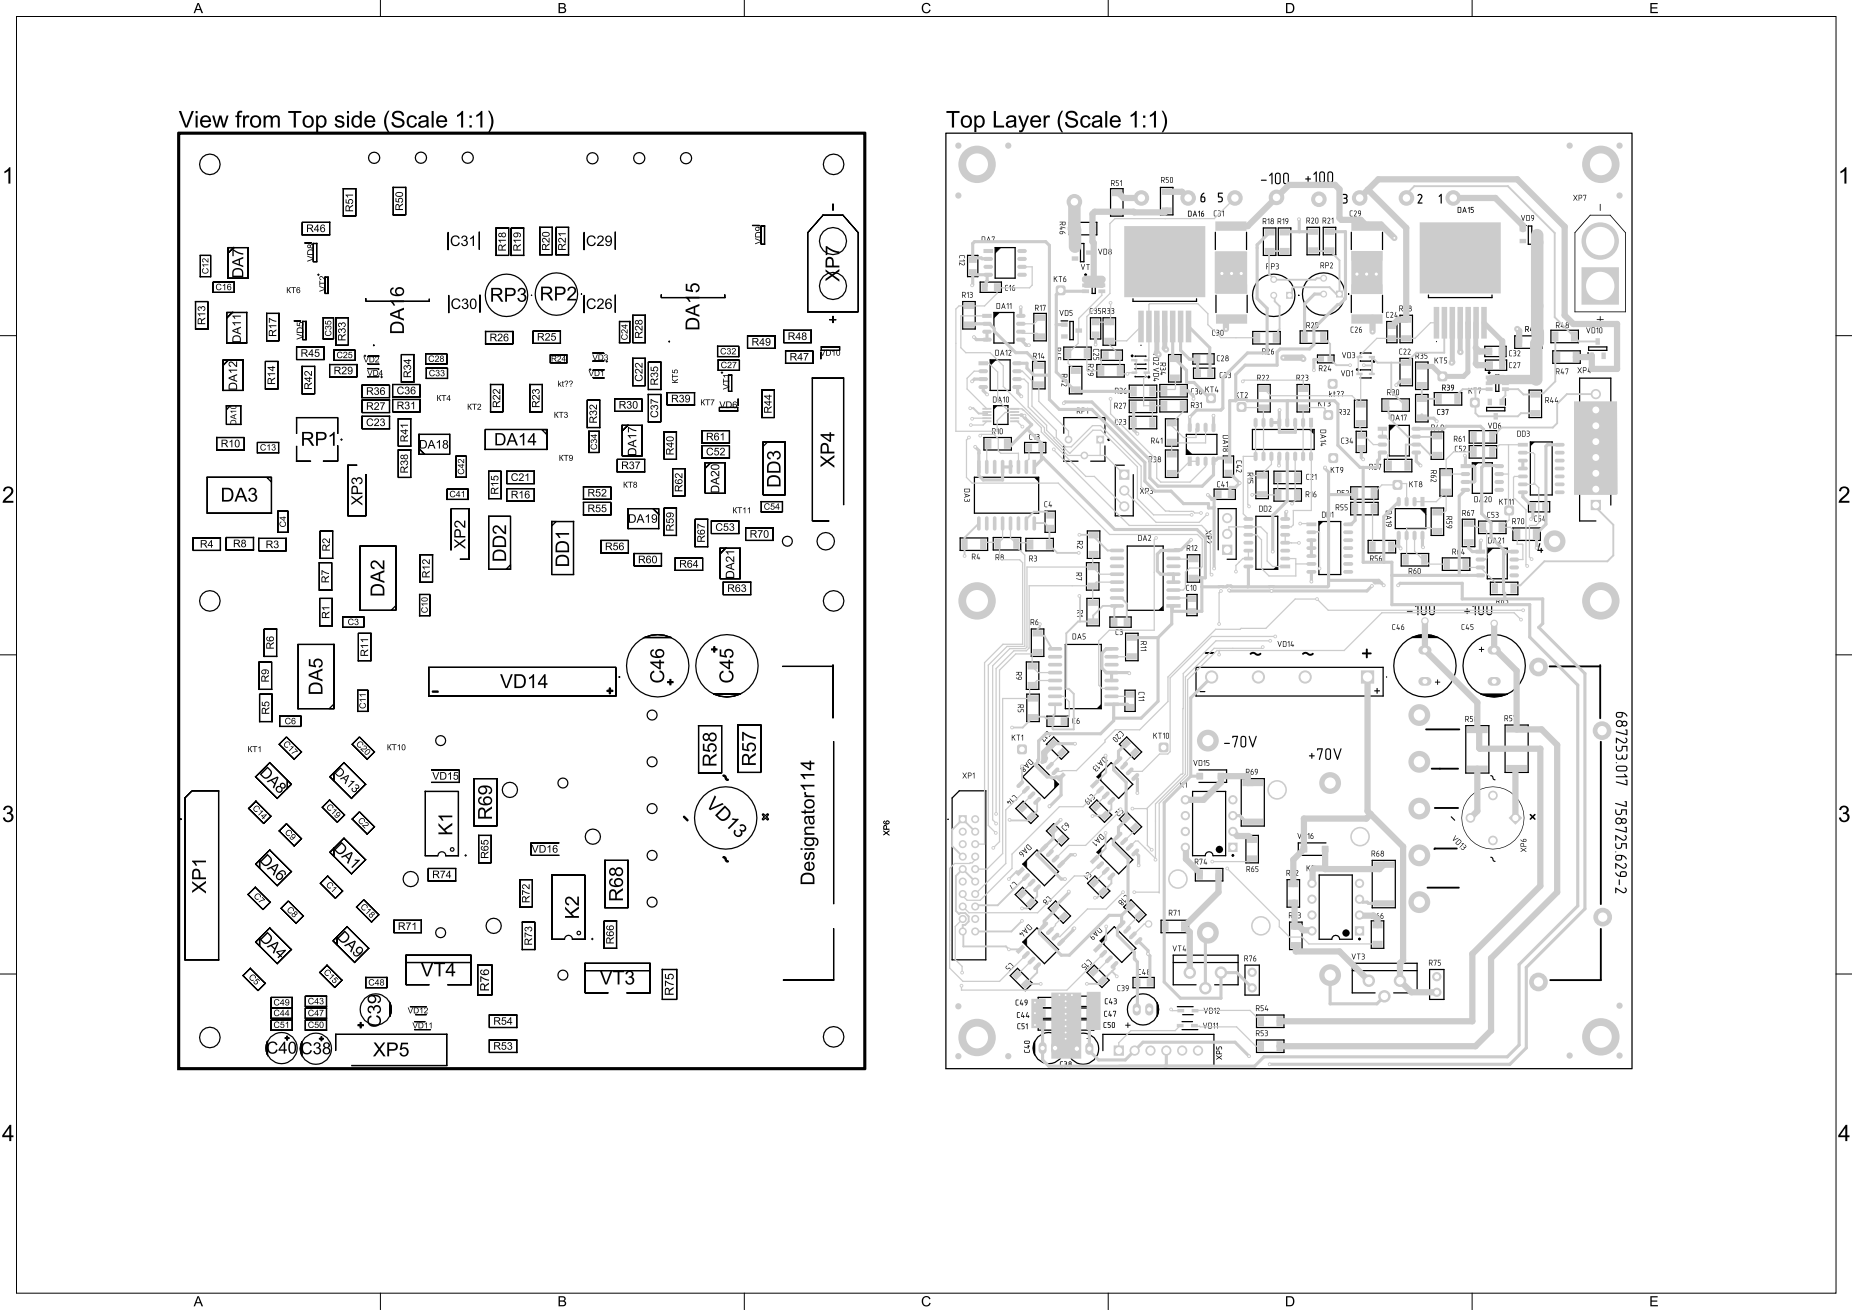
[picture p198: page 1]
