Sasha7b9Work/LiniaServer/_Лисенков/аываыв.pdf

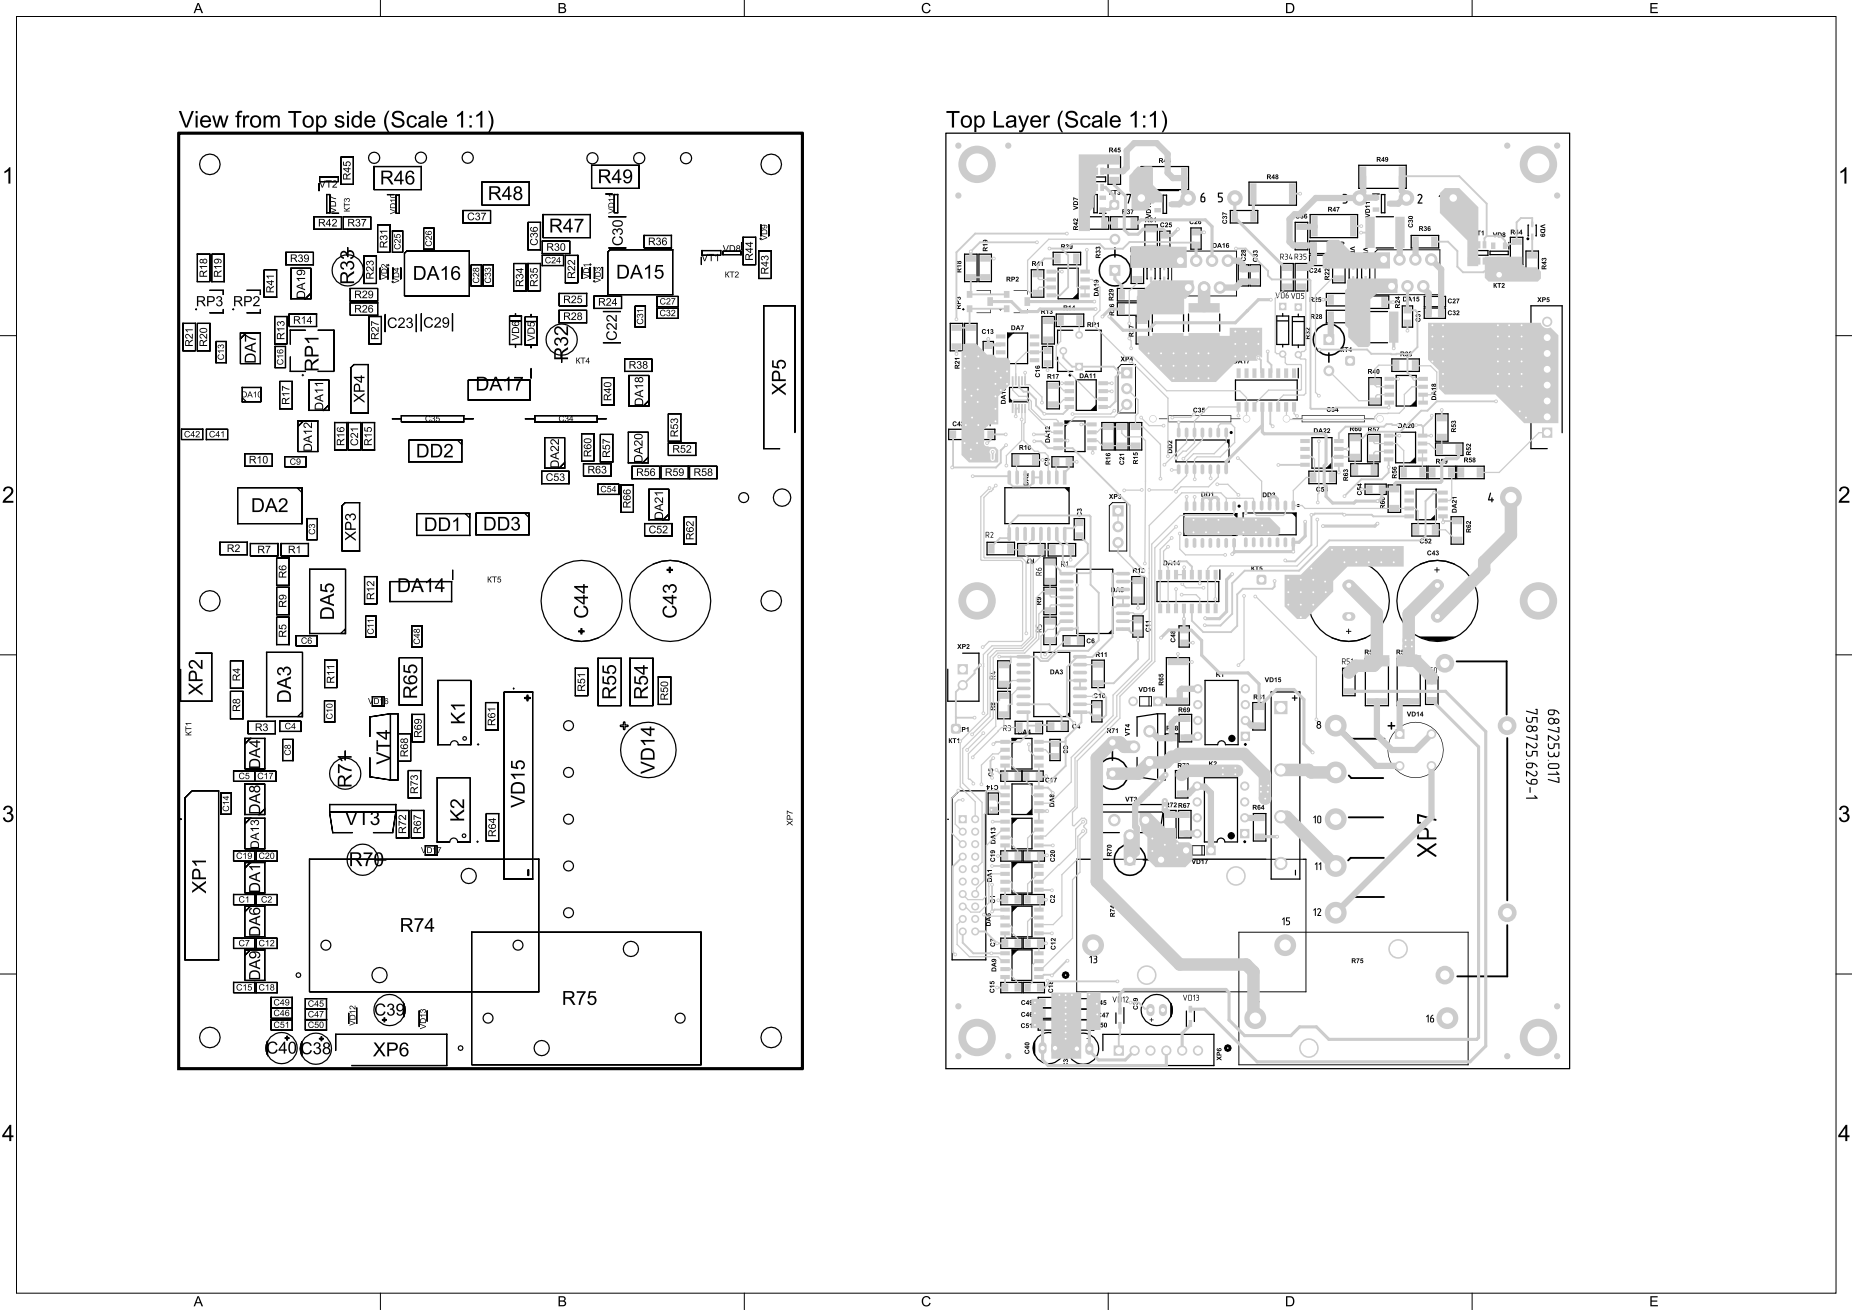
[picture p199: page 1]
