Sasha7b9Work/LiniaServer/Контроллер/467444.130-L2.pdf

DD4.1

DD4.2

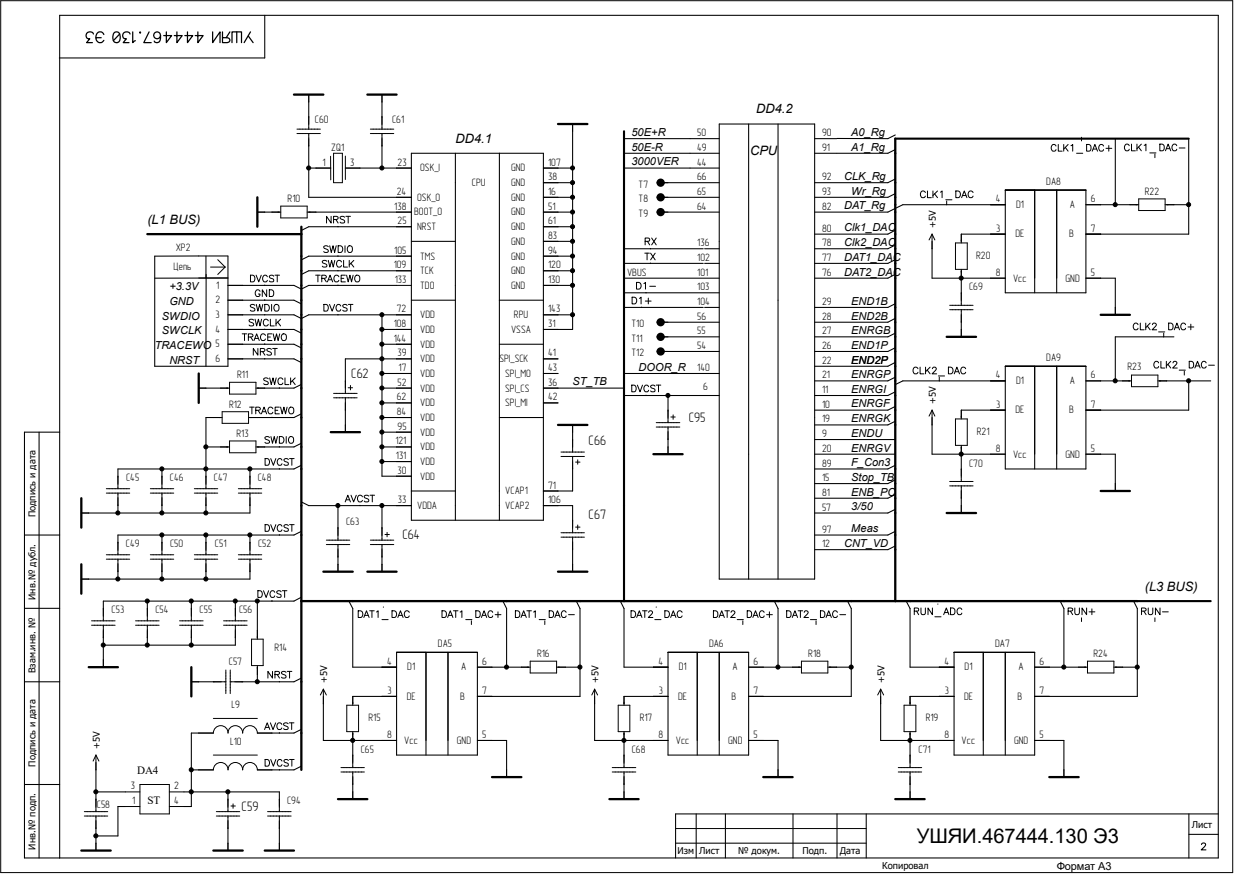
[picture p200: page 1]

VDD VDD VDD VDD VDD VDD | RPU VSSA
108 | | | 31
144 | | | 41
39 | | SPI_SCK SPI_M0 SPI_CS SPI_MI
17 | | | 43
52 | | | 36
62 | | | 42

9 Инв.№ подп. Взам.инв. № Инв.№ дубл. Подпись и дата
