Sasha7b9Work/LiniaServer/Контроллер/467444.130-L3.pdf

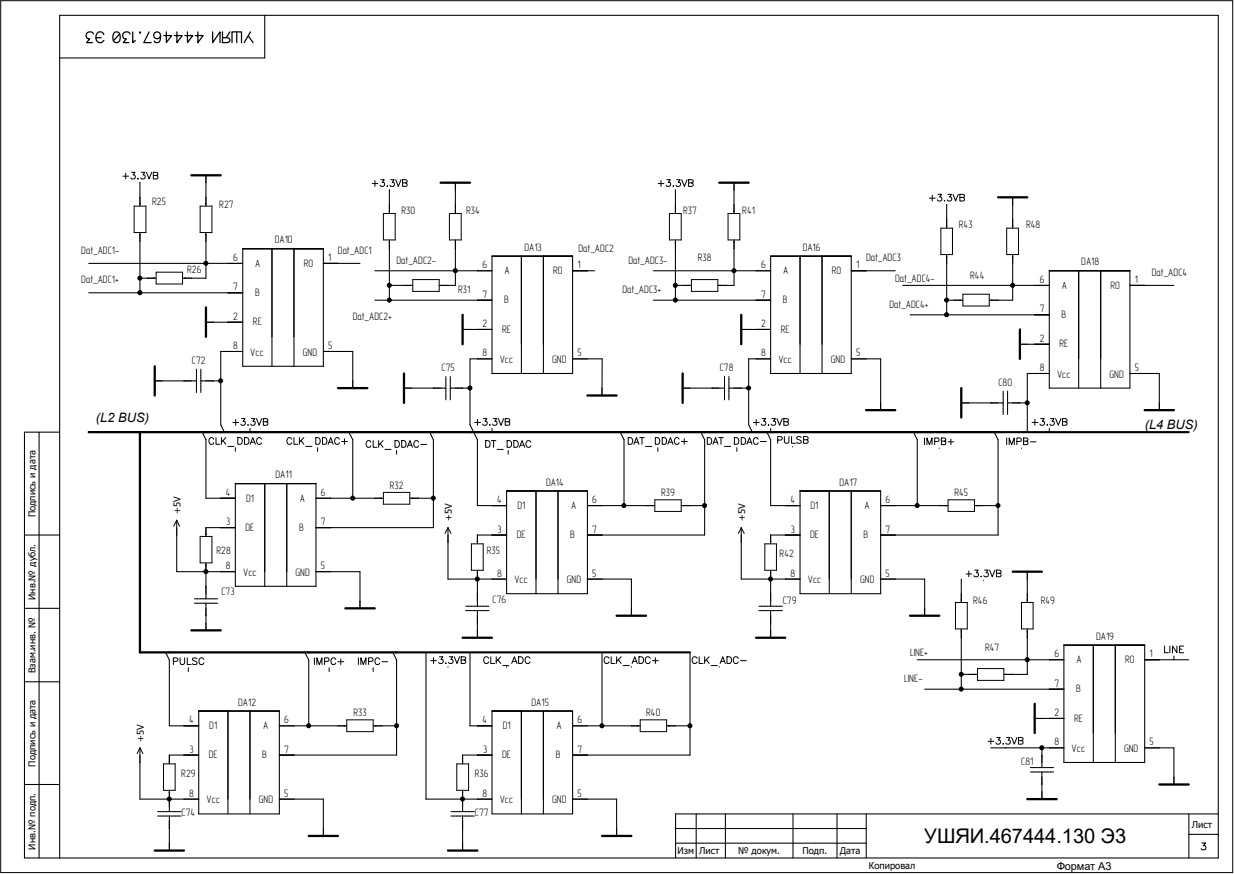
[picture p201: page 1]

УШЯИ.467444.130 Э3

Изм | Лист | № докум. | Подп. | Дата
