Sasha7b9Work/LiniaServer/Контроллер/4674444.130-L5.pdf

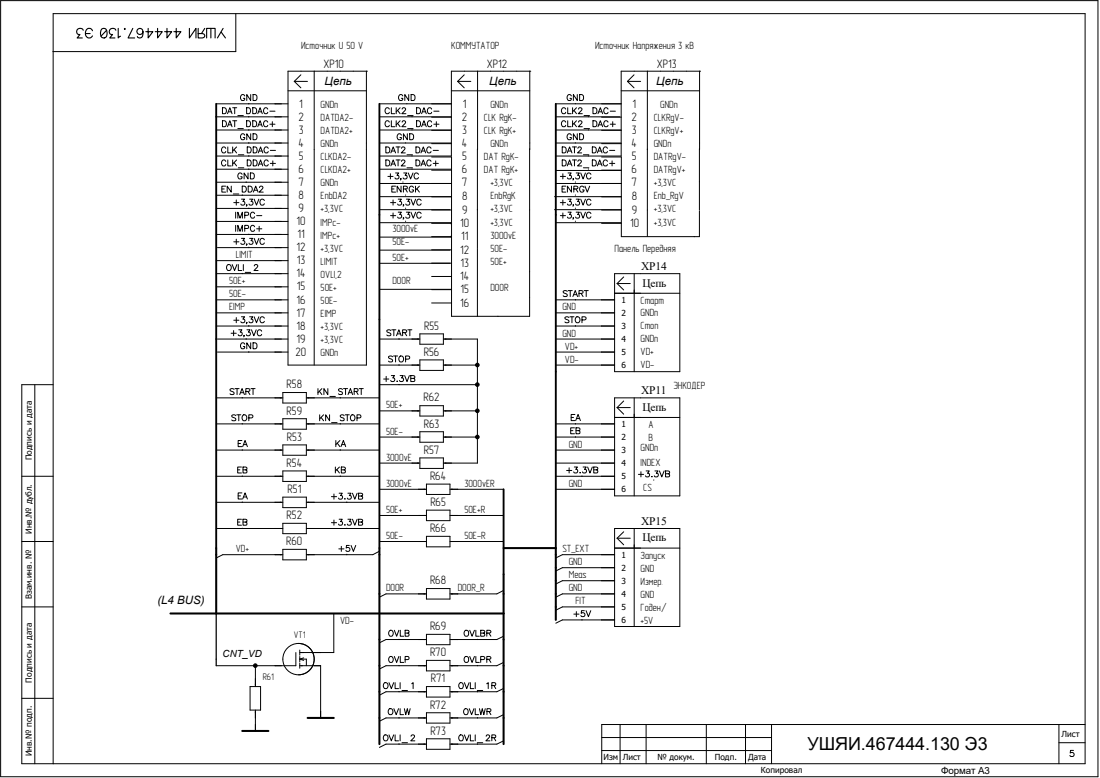
[picture p202: page 1]

CSAB Инв.№ подп. Подпись и дата Взам.инв. № Подпись и дата Инв.№ дубл.
