Sasha7b9Work/LiniaServer/_Лисенков/17 схема 02.07.pdf

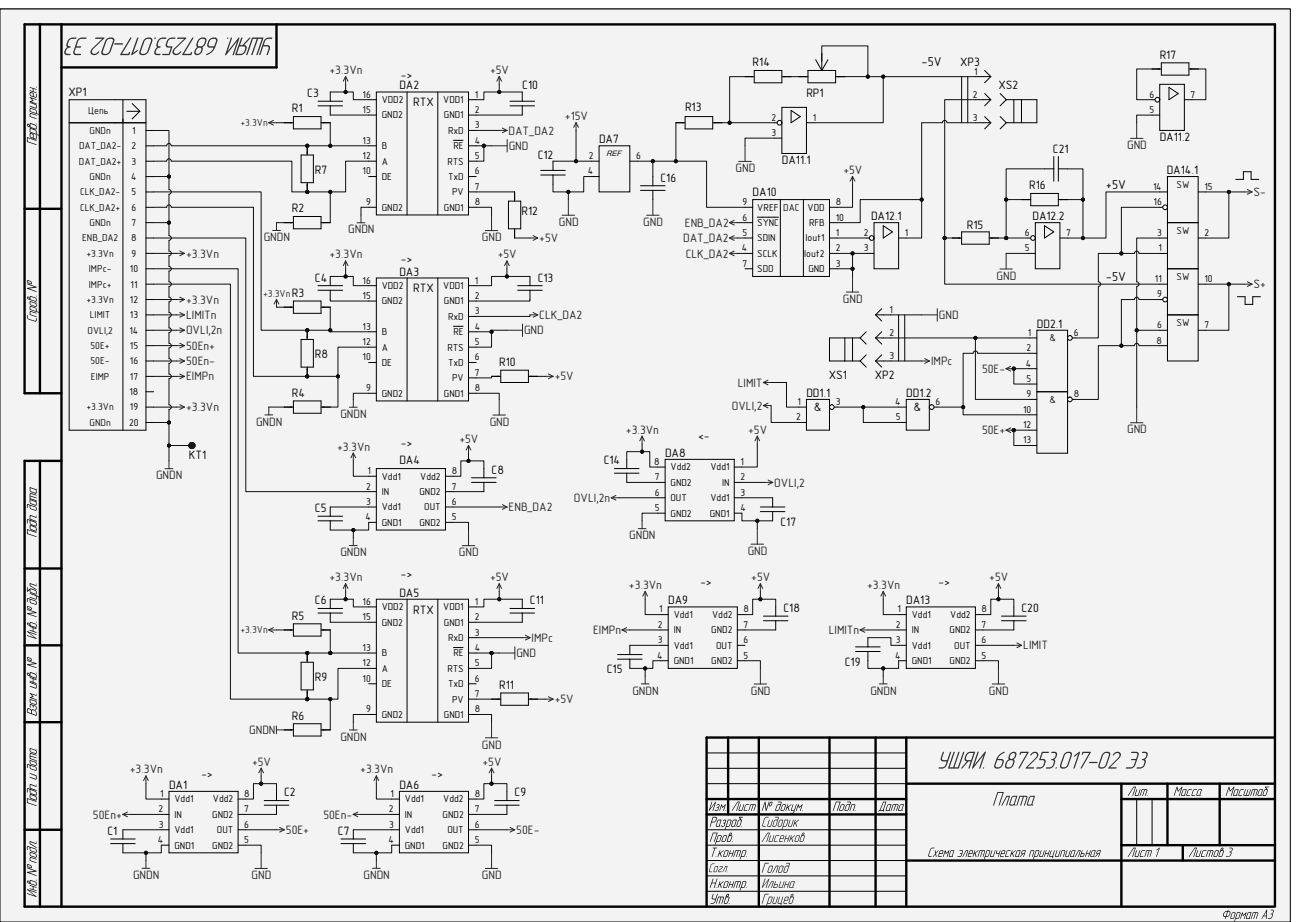
[picture p203: page 1]

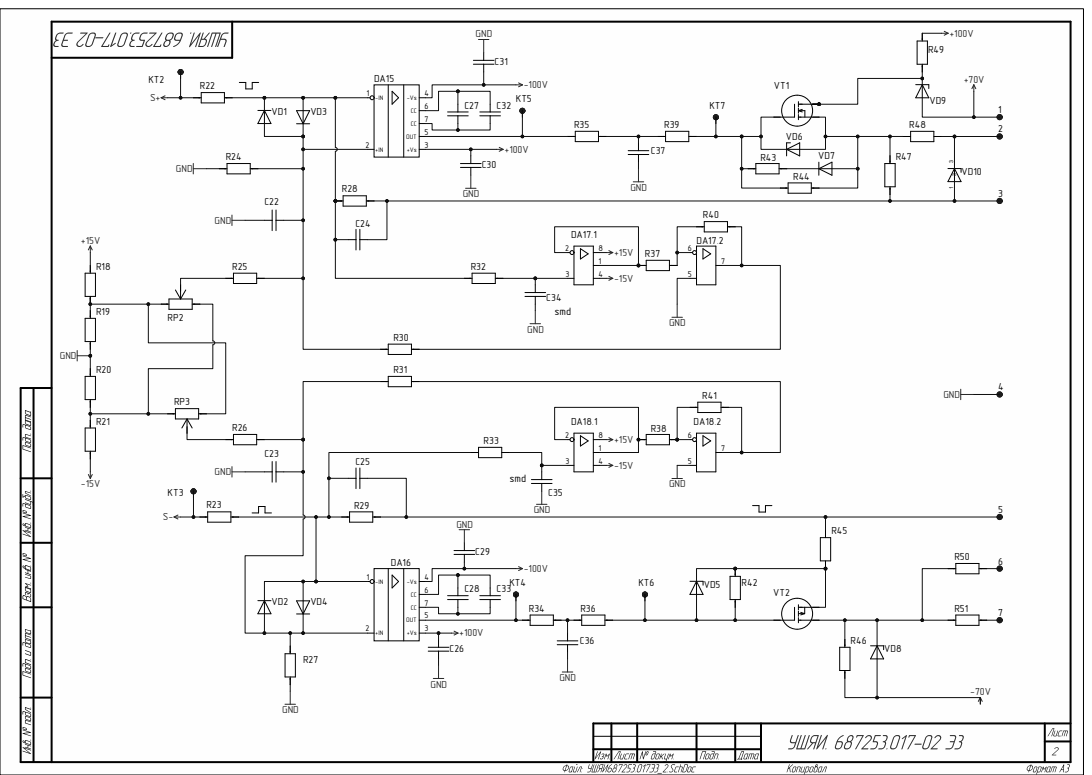
[picture p204: page 2]

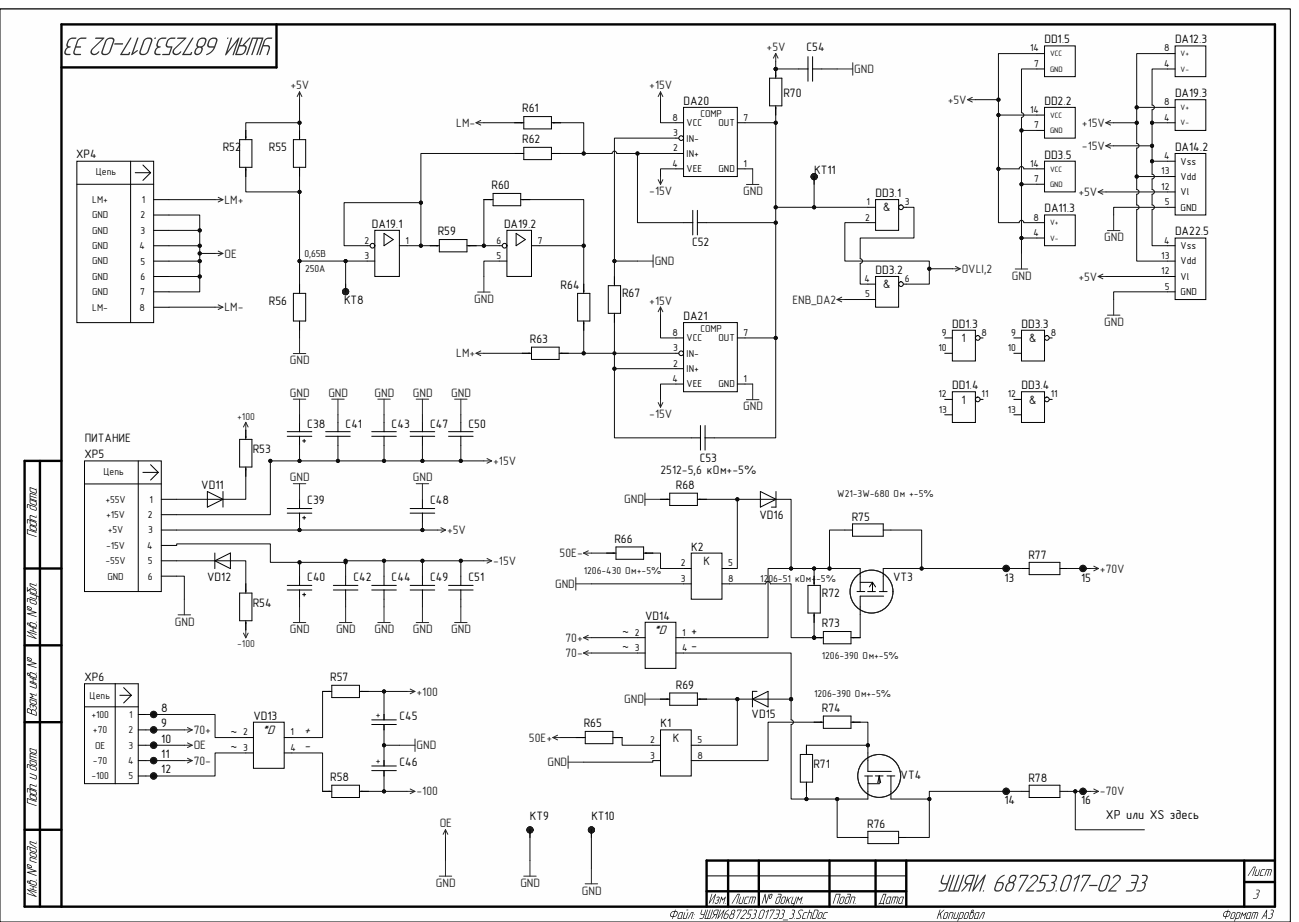
[picture p205: page 3]

Цепь
+100 +70 OE -70 -100 | 1 2 3 4 5
