Sasha7b9Work/LiniaServer/_Лисенков/17 схема 26.06.pdf

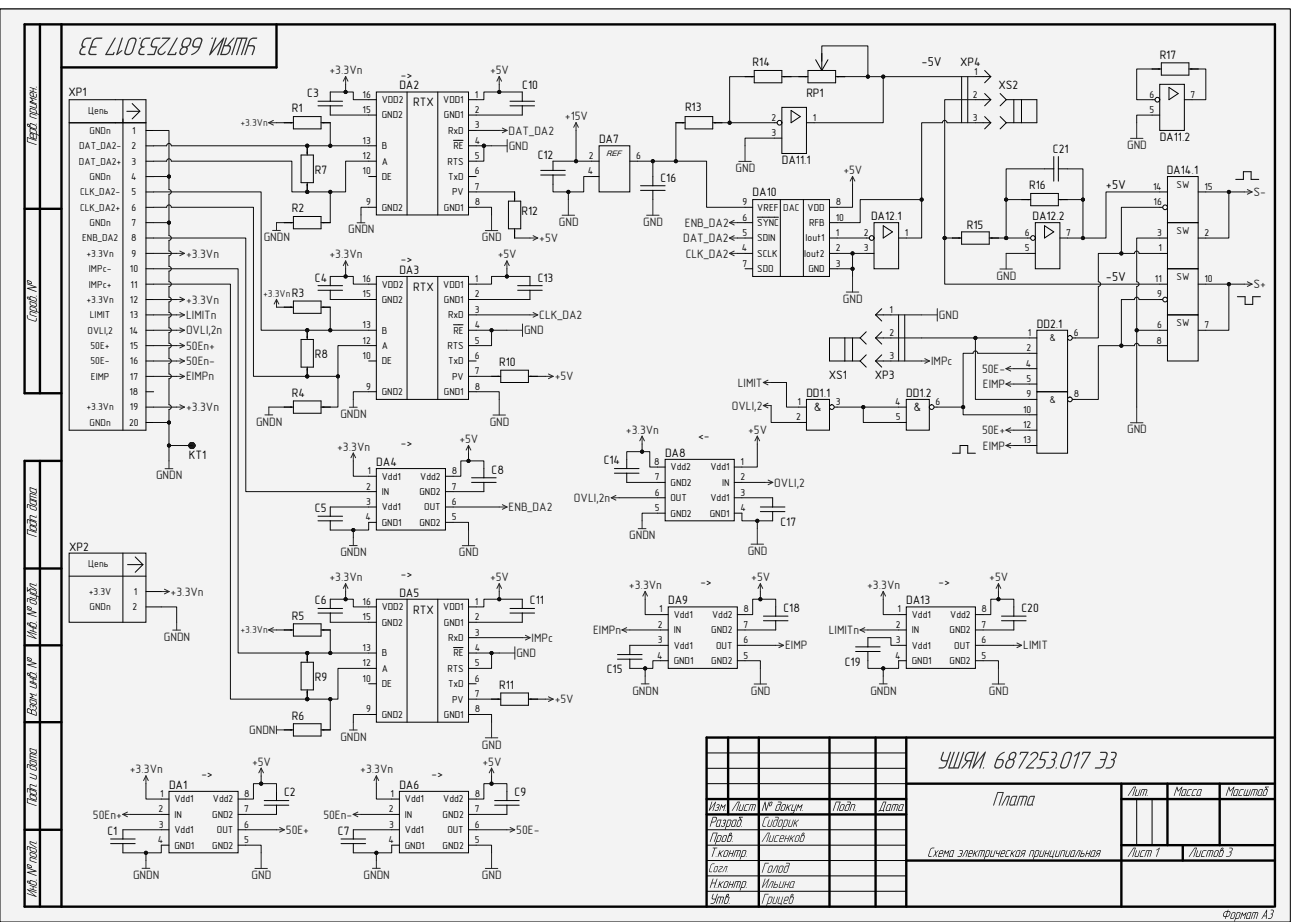
[picture p206: page 1]

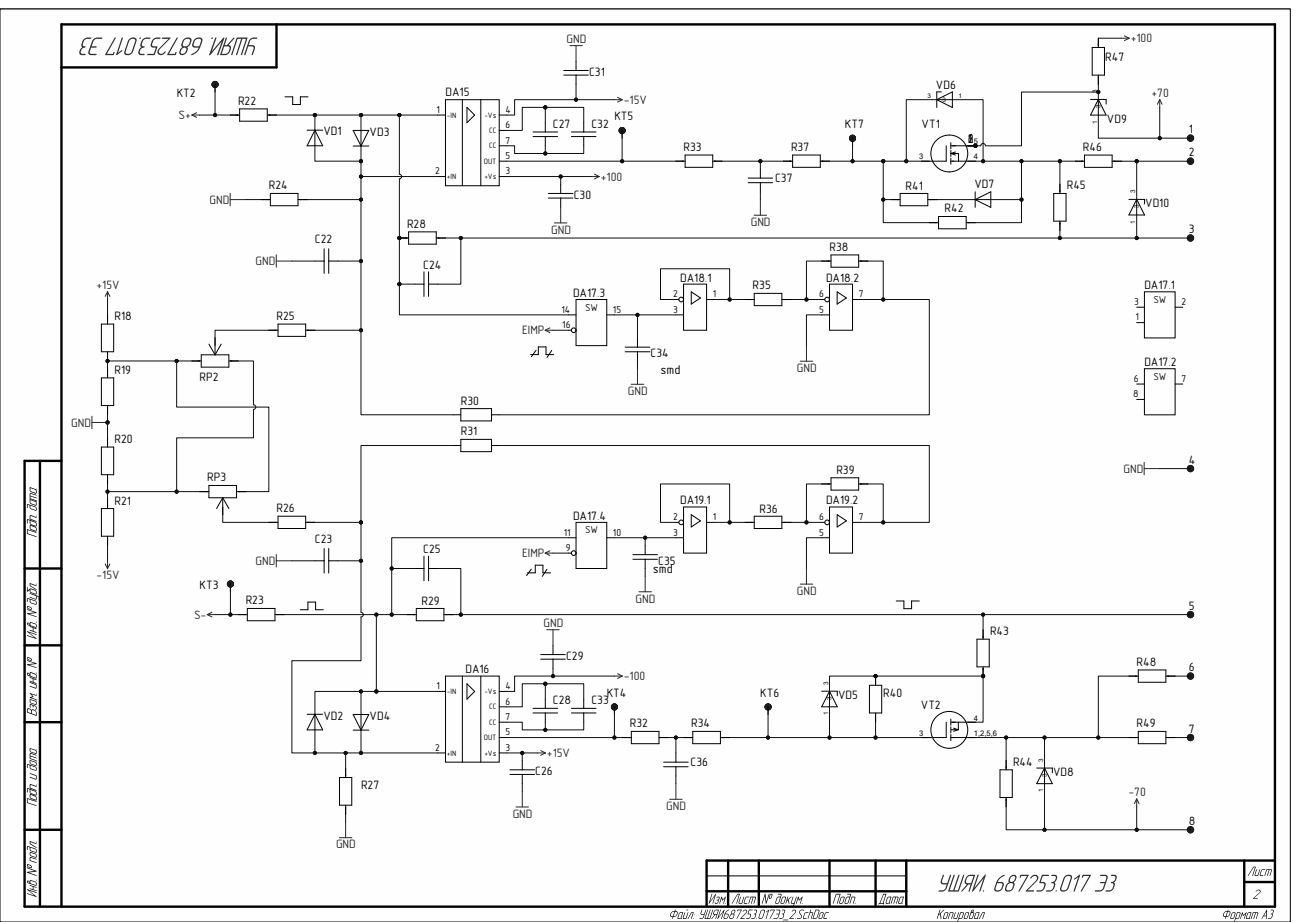
[picture p207: page 2]

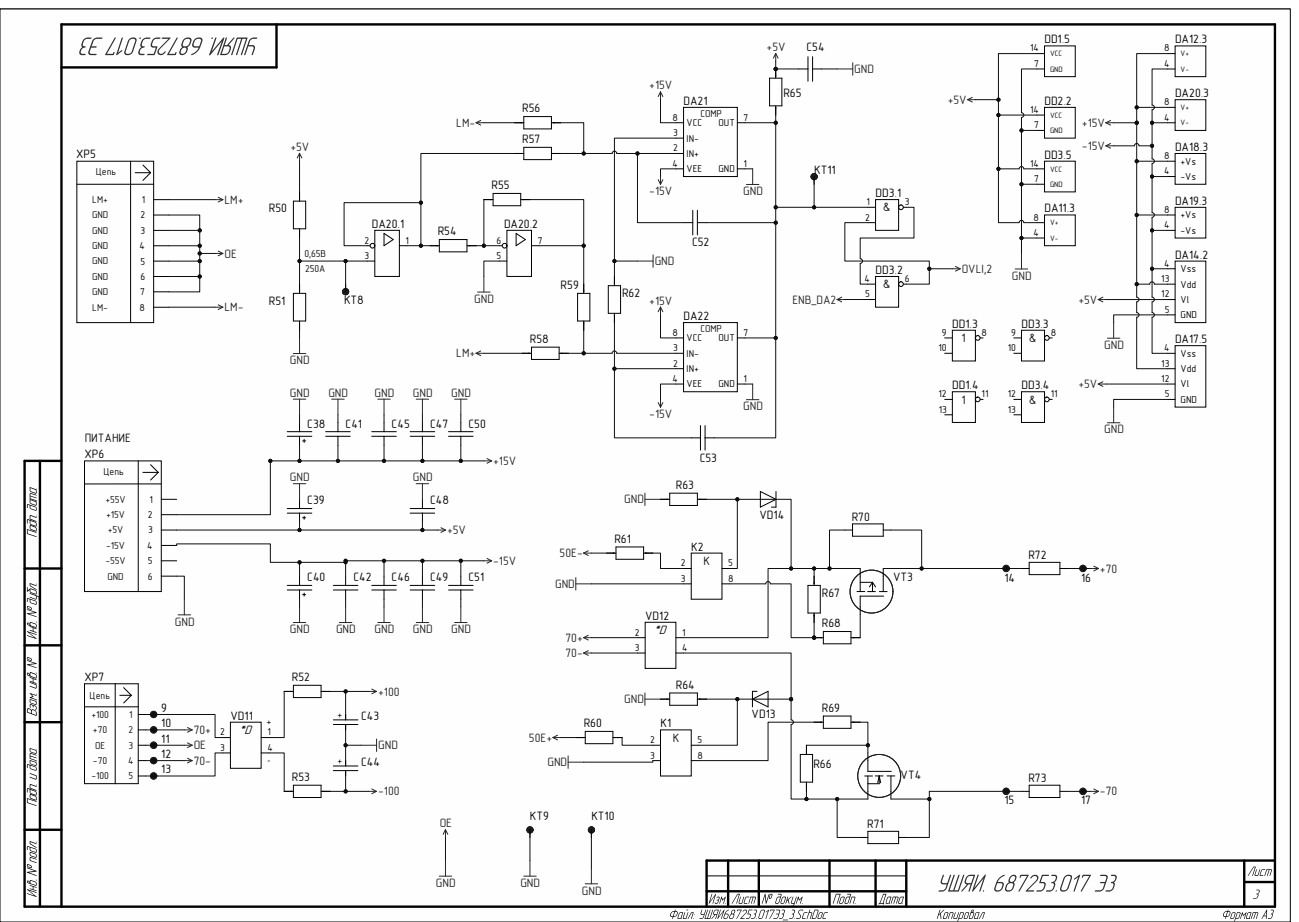
[picture p208: page 3]

Цепь
+100 +70 OE -70 -100 | 1 2 3 4 5
