Sasha7b9Work/LiniaServer/_Лисенков/17 схема 29.06.pdf

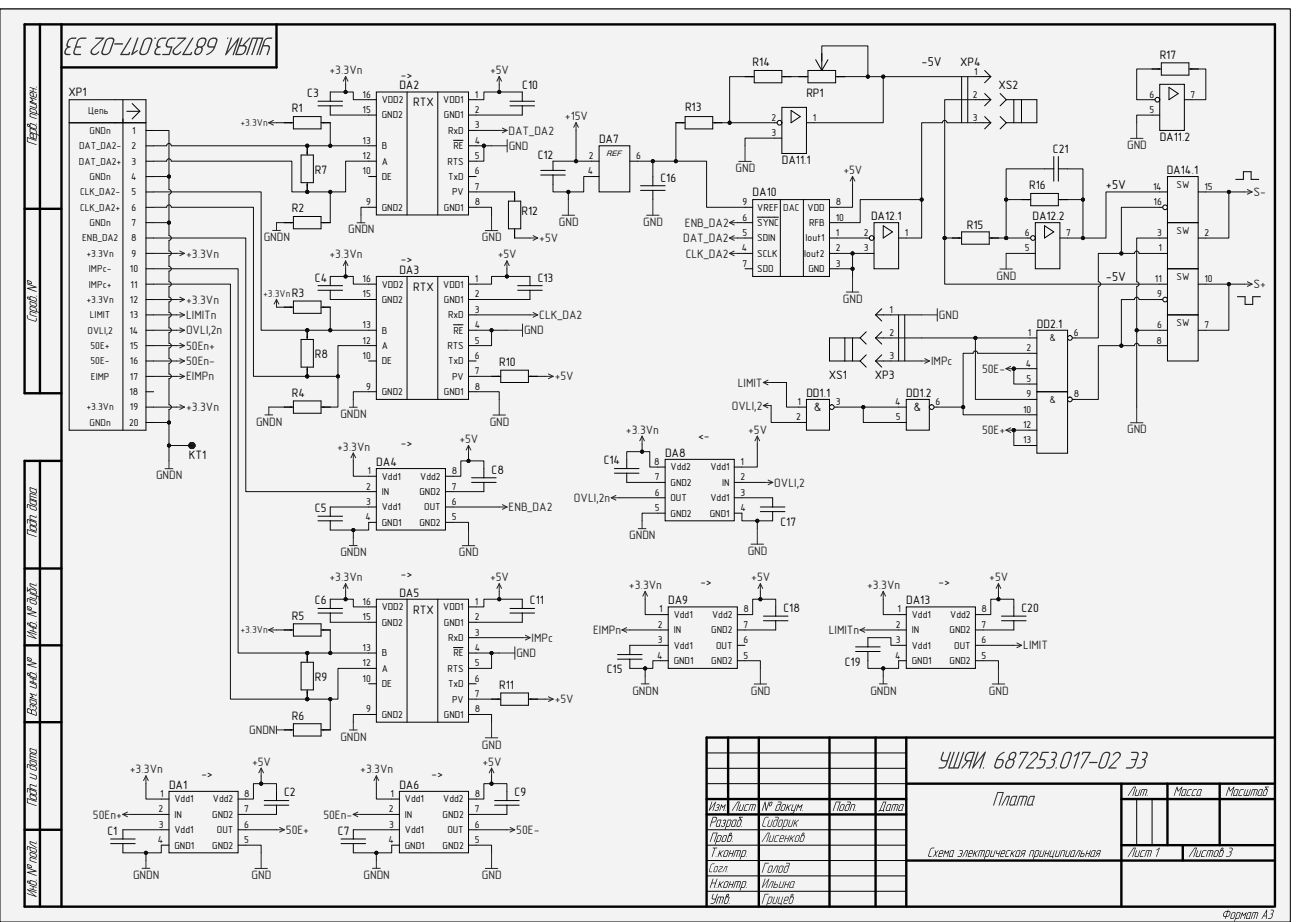
[picture p209: page 1]

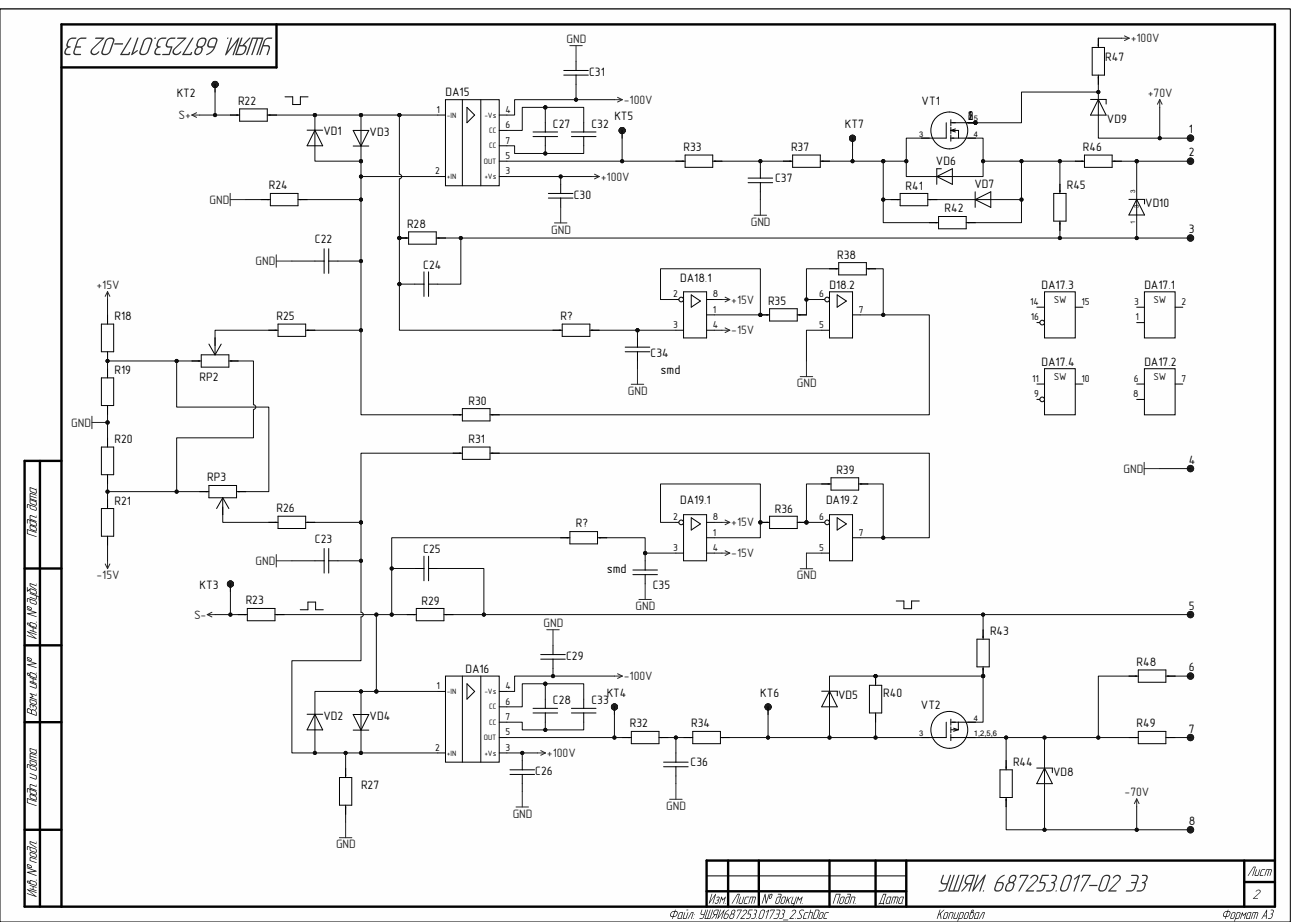
[picture p210: page 2]

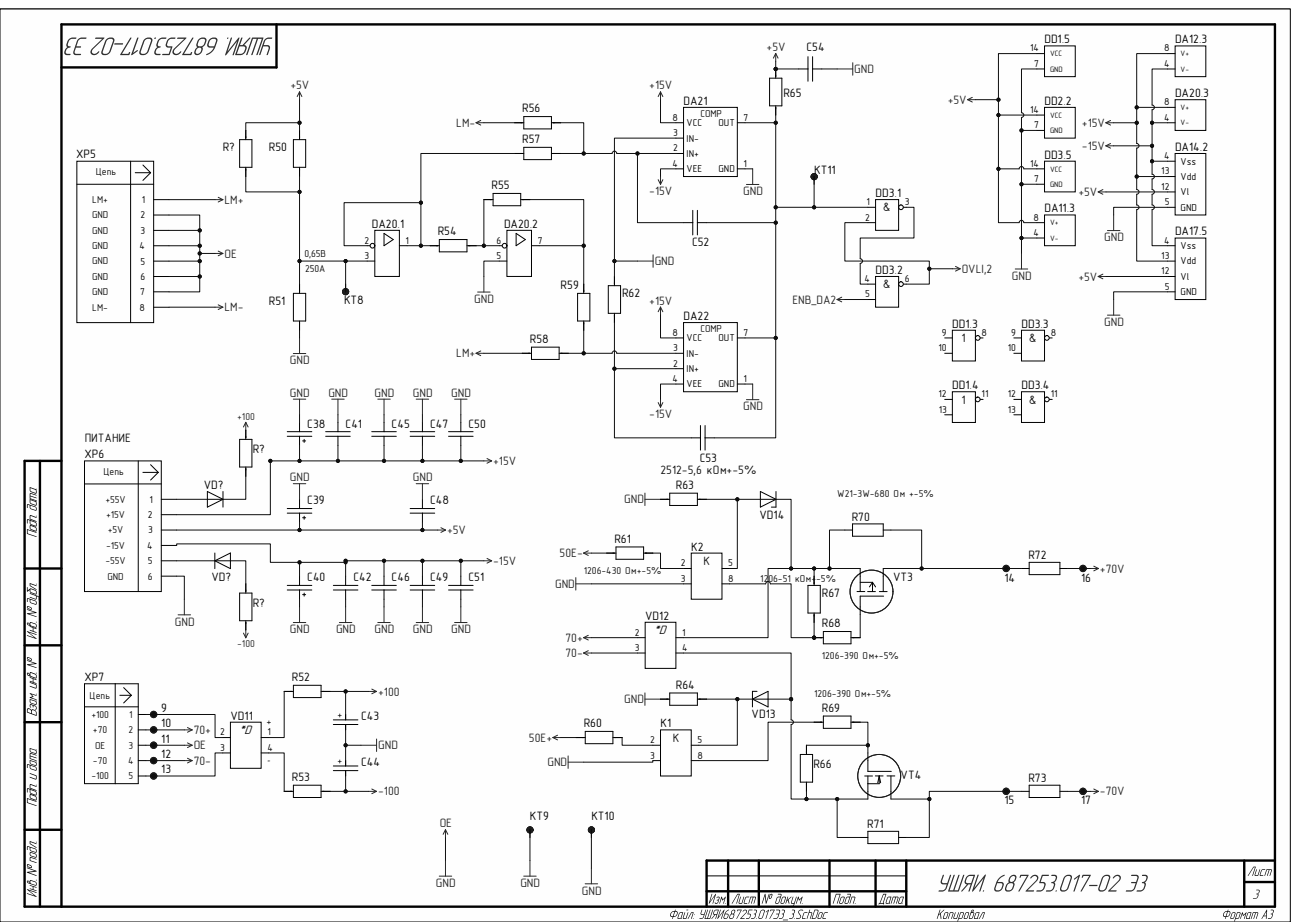
[picture p211: page 3]

Цепь
+100 +70 OE -70 -100 | 1 2 3 4 5
