Sasha7b9Work/LiniaServer/_Лисенков/18 схема 29.06.pdf

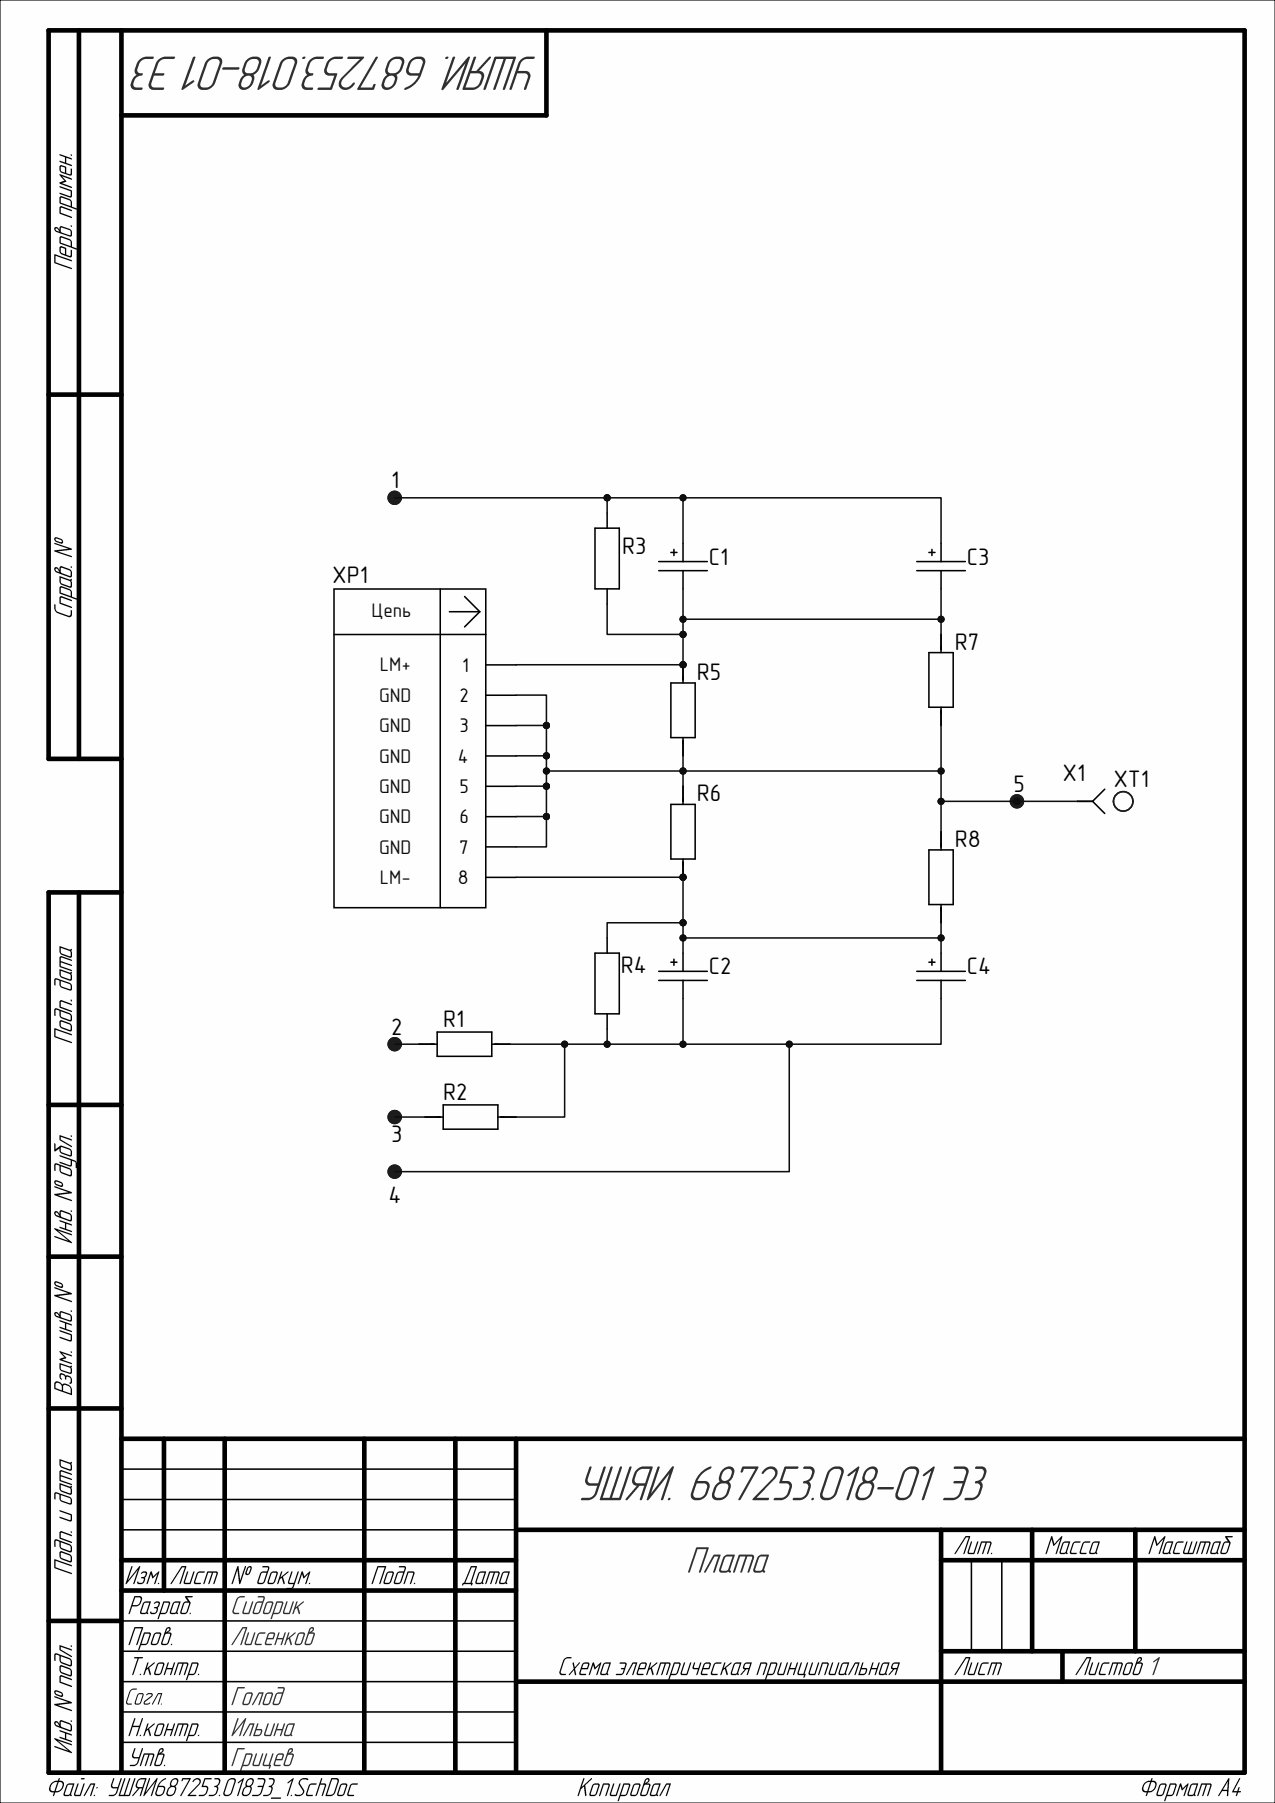
[picture p212: page 1]
