Sasha7b9Work/LiniaServer/_Лисенков/3 list 017 plata.pdf

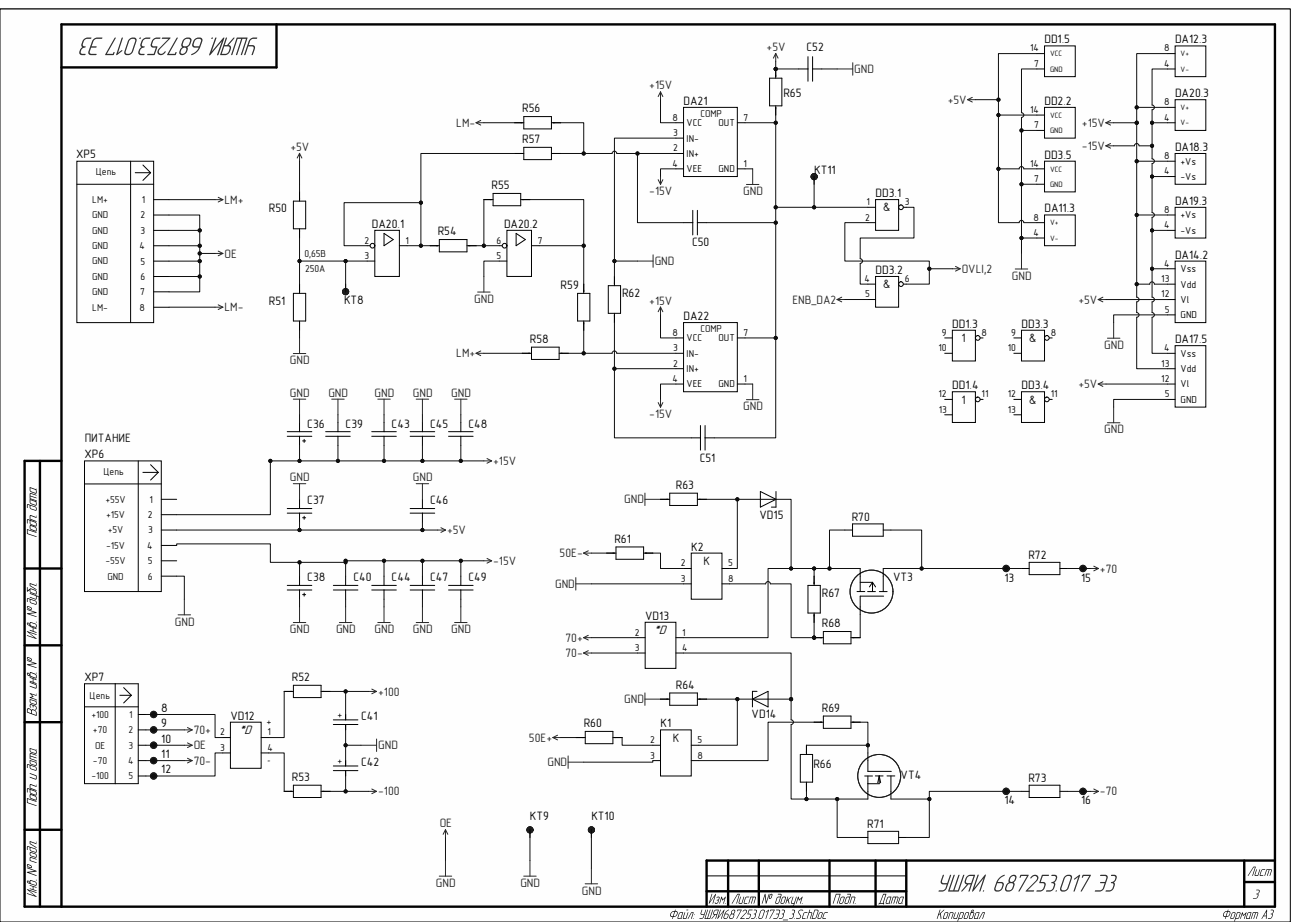
[picture p213: page 1]

Цепь
+100 +70 OE -70 -100 | 1 2 3 4 5
