Sasha7b9Work/LiniaServer/_Лисенков/17 СП.pdf

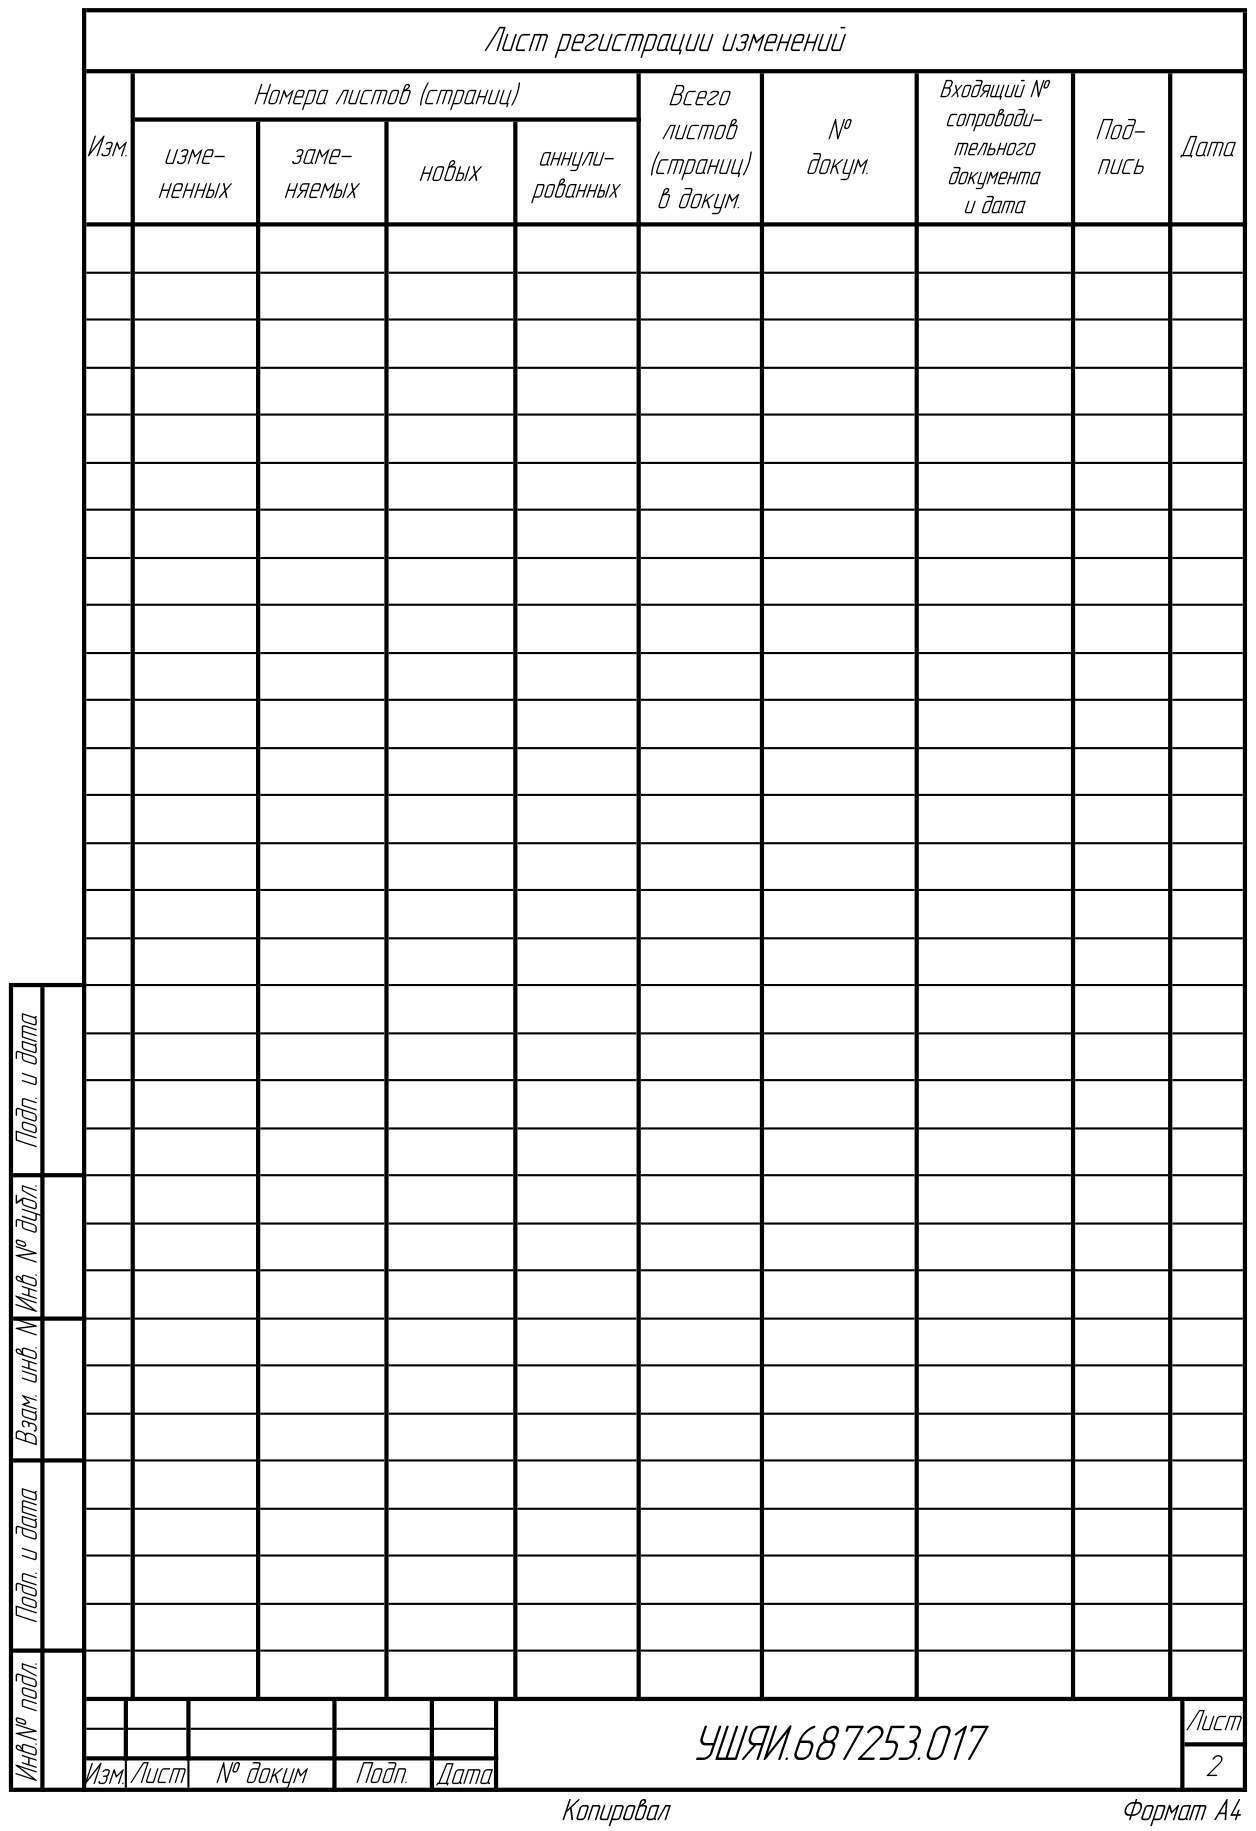
[picture p214: page 2]
