Sasha7b9Work/LiniaServer/_Лисенков/авыаыва.pdf

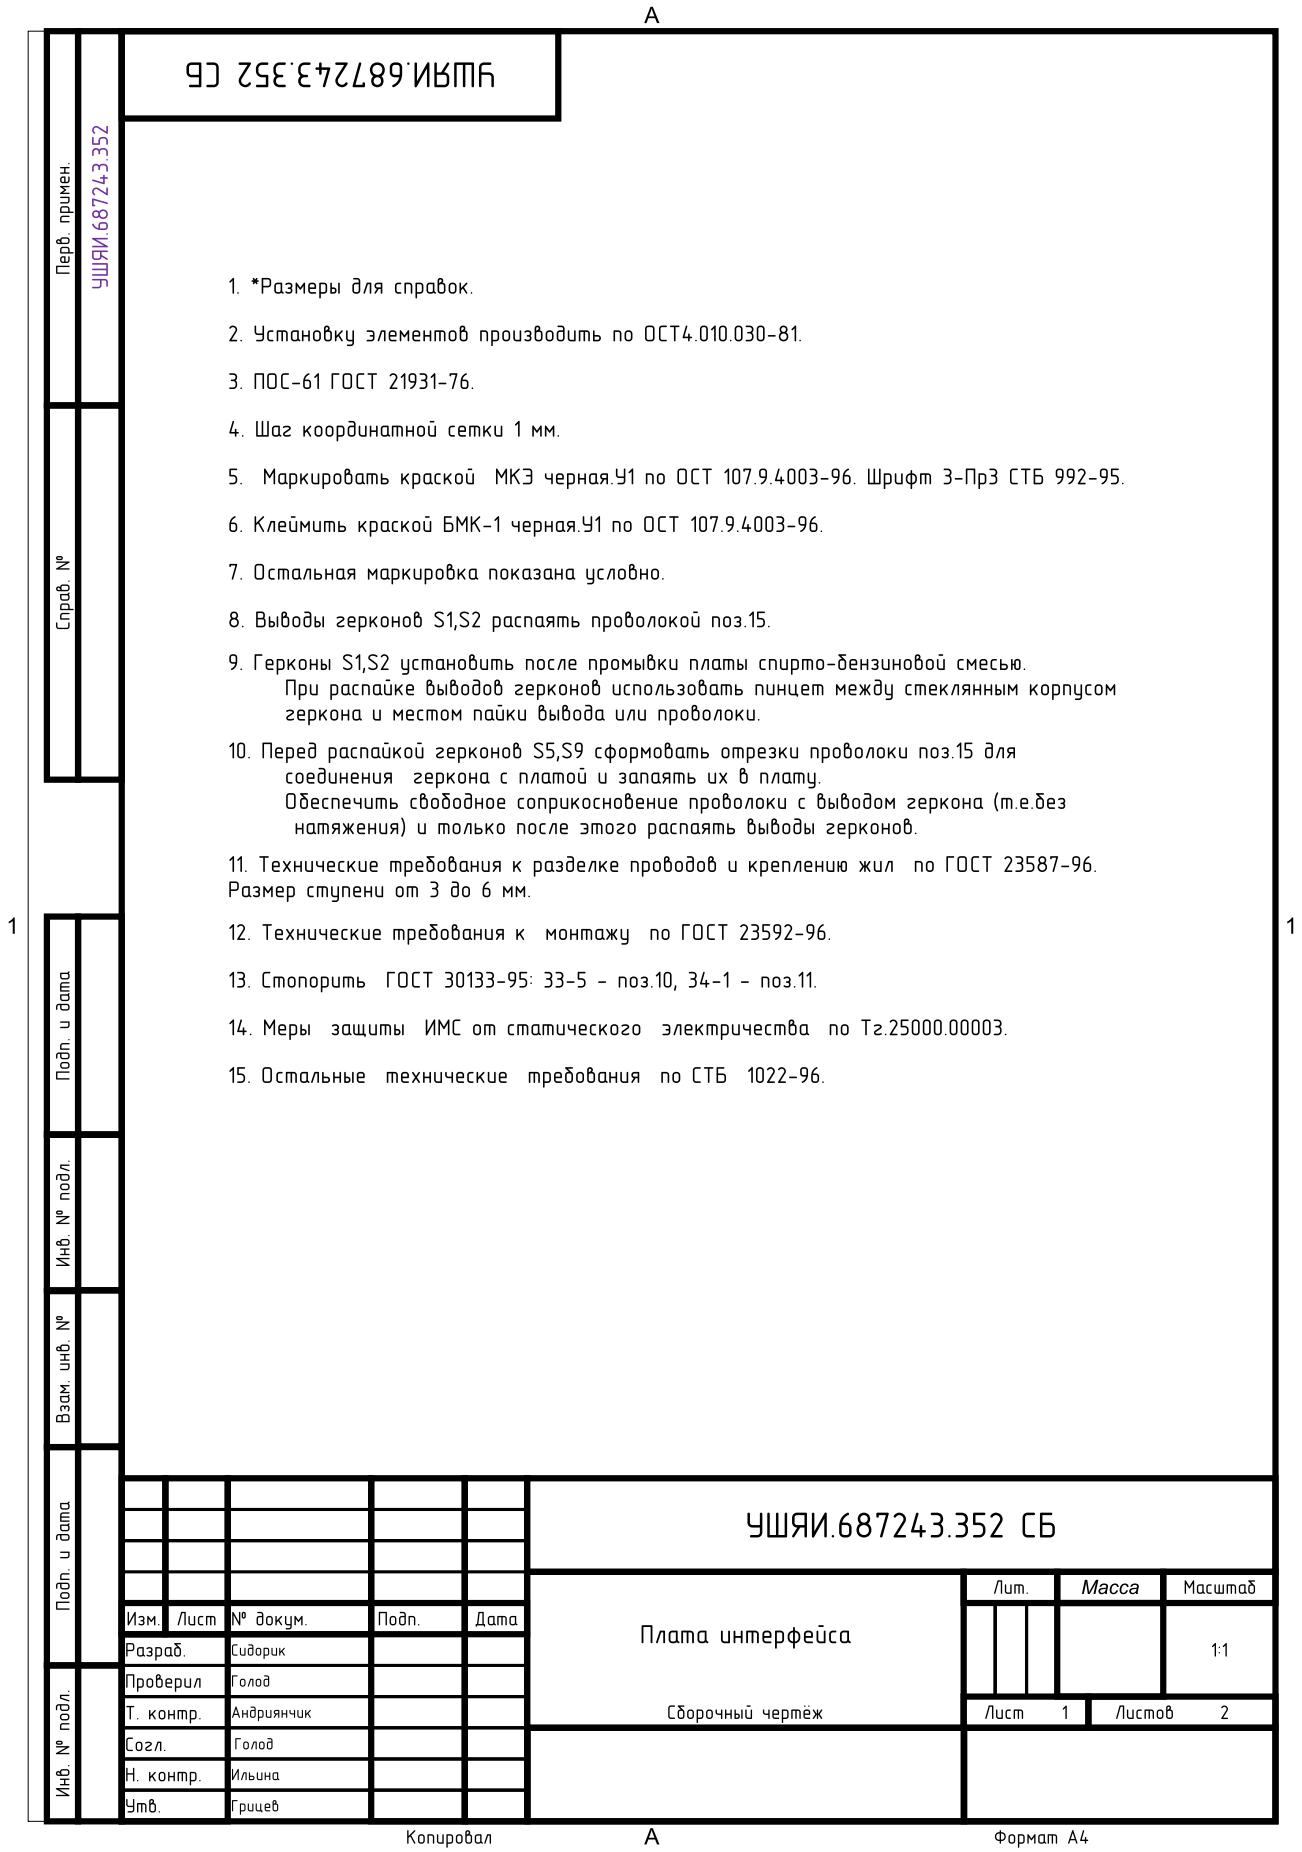
[picture p215: page 1]
