Sasha7b9Work/LiniaServer/_Лисенков/hybvghjvfgv.pdf

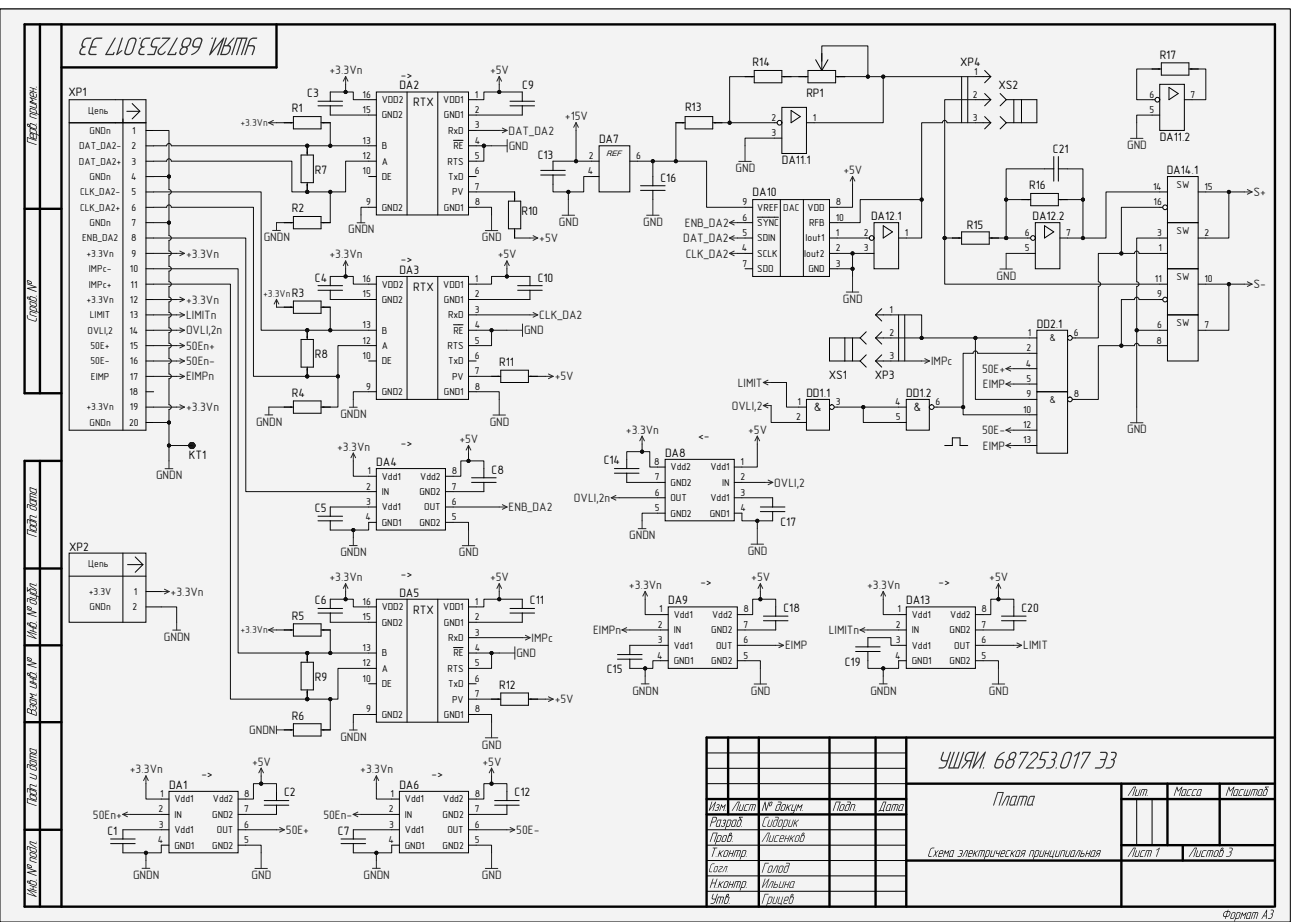
[picture p216: page 1]

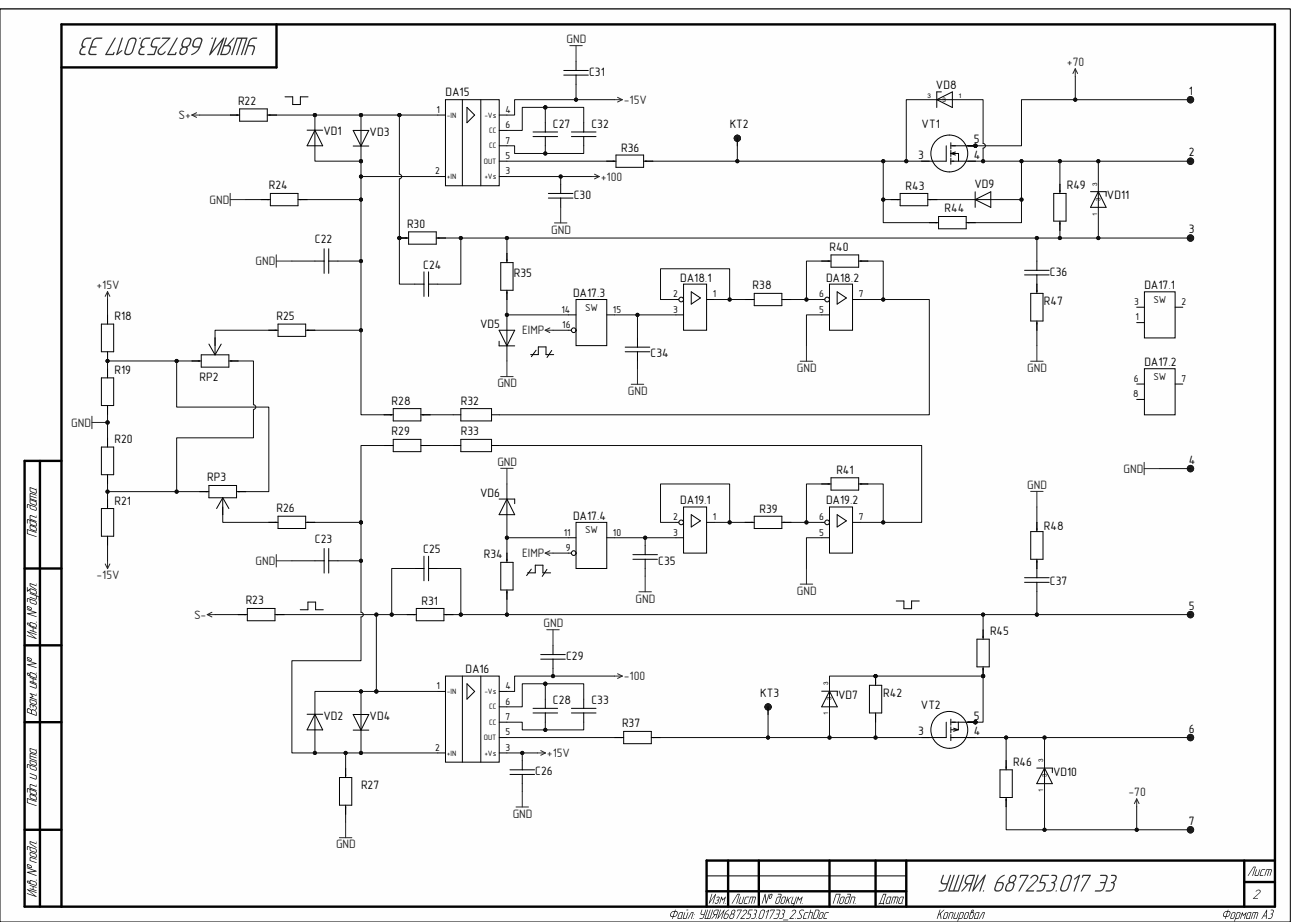
[picture p217: page 2]

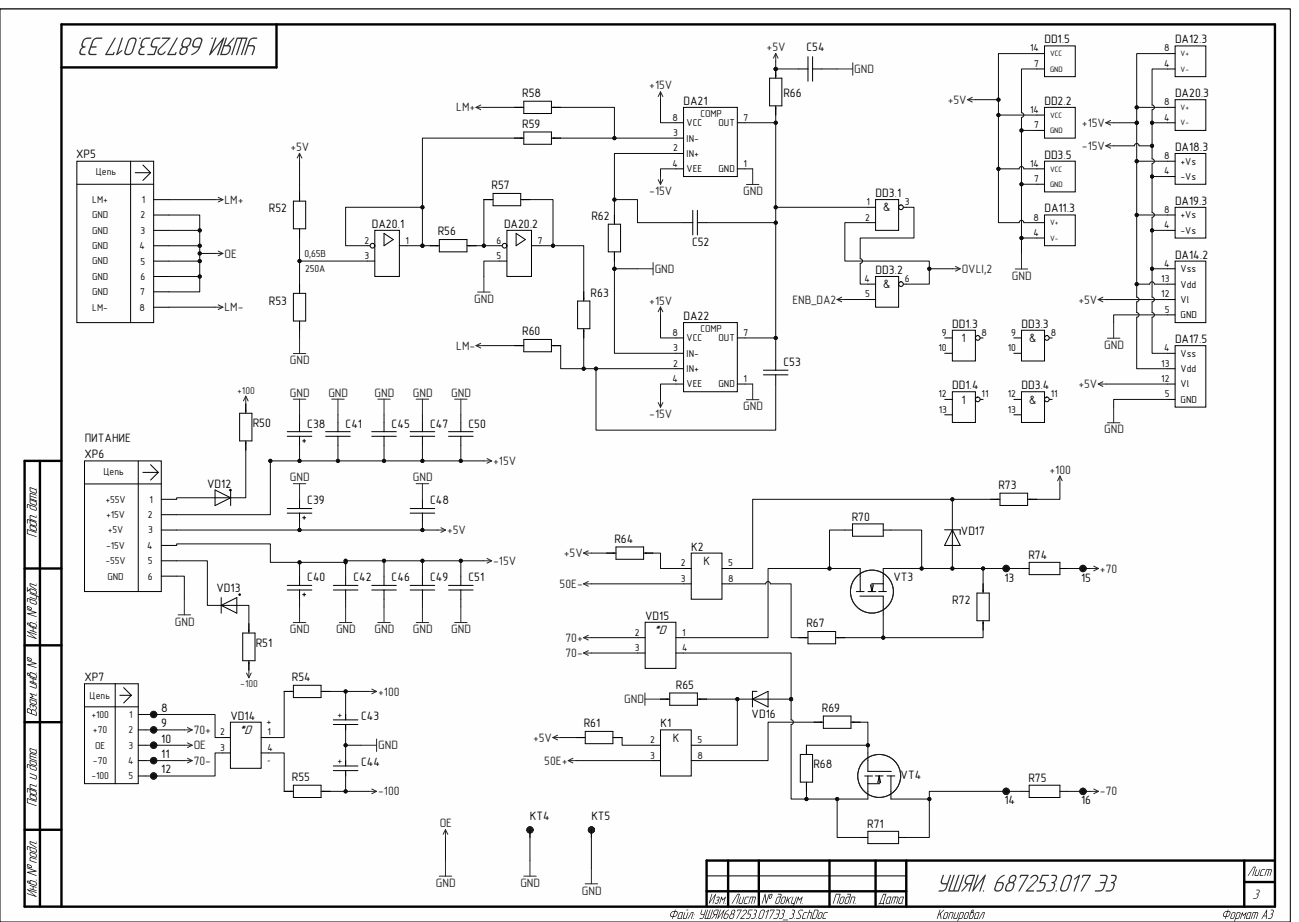
[picture p218: page 3]

Цепь
+100 +70 OE -70 -100 | 1 2 3 4 5
