Sasha7b9Work/LiniaServer/Источник напряжения 50В/Ltspice владислав/Draft2.asc

C1: cap; 10p
M1: nmos; AP9465GEM
R1: res; 2k
R2: res; 20k
R3: res; 2k
R4: res; 1k
U1: UniversalOpAmp
V1: voltage; PULSE(0 -5 1u 0 0 100u)
V2: voltage; 20
V3: voltage; -20
Named nets: 0
.tran 200u
.inc C:\\Users\\ddk\\Documents\\LTspiceXVII\\lib\\cmp/standard.jft
