Sasha7b9Work/LiniaServer/Блок базы - Подложки/Model  I-Buf -AD8274+AMPL-A/test_buf.asc

R1: res; 100
R2: res; 100
R3: res; 100
R4: res; 1k
U1: bufh
V1: voltage; PULSE(0 7.5 10u 0.1u 0.1u 10u 30u)
Named nets: 0
.tran 0 60u 20u 10nc
