Sasha7b9Work/LiniaServer/Блок базы - Подложки/Dradt15_Test-A/Draft18.asc

C1: cap; 10p
C2: cap; 1µ
C3: cap; 13p
DA1: PA340
Q1: npn3; 2N5550
Q2: pnp; 2N5401
R1: res; 500
R2: res; 0.1
R3: res; 4.99k
R4: res; 0.1
R5: res; 1.2k
R6: res; 120
R7: res; 40.2k
R8: res; 4
R9: res; 120
R10: res; 4.6k
R11: res; 10k
R12: res; 10k
R13: res; 300
R14: res; 300
U1: 1N4729A
V1: voltage; 55
V3: voltage; 55
V5: voltage; PULSE(0 -0.5 10u 0.1u 0.1u 7u 0.01)
V6: voltage; 0
VT1: tip142
VT2: tip147
Named nets: 0, in-
.tran 0 60u 0 10n
.options itl4=50
.include my_model.txt
