Sasha7b9Work/LiniaServer/Блок базы - Подложки/Модель главного усилителя канал базы.asc

C1: cap; 68n; V=250
C2: cap; 10p; V=100
C3: cap; 68n; V=250
C4: cap; 10p; V=100
C5: cap; 10p; V=100
C6: cap; 10p; V=100
C7: cap; 220µ; V=250
C8: cap; 220µ; V=250
C9: cap; 33p; V=100
C10: cap; 10p; V=100
D1: diode
D2: diode
D3: diode
D4: diode
D5: diode
D6: diode
D7: diode
D8: diode
D9: diode
D10: diode
M1: pmos
M2: pmos
M3: nmos
M4: nmos
Q1: pnp
Q2: pnp
Q3: npn
Q4: npn
Q5: npn
Q6: pnp
Q7: pnp
Q8: pnp
Q9: npn
Q10: npn
Q11: pnp
Q12: npn
R1: res; 220; tol=1 pwr=0,125
R2: res; 220; tol=1 pwr=0,125
R3: res; 22k; tol=1 pwr=0.125
R4: res; 220; tol=1 pwr=0,125
R5: res; 220; tol=1 pwr=0,125
R6: res; 22k; tol=1 pwr=0.125
R7: res; 120; tol=1 pwr=0.125
R8: res; 300; tol=1 pwr=0.125
R9: res; 0.04; tol=1 pwr=30
R10: res; 120; tol=1 pwr=0.125
R11: res; 240; tol=1 pwr=0.125
R12: res; 1k; tol=1 pwr=0.125
R13: res; 300; tol=1 pwr=0.125
R14: res; 240; tol=1 pwr=0.125
R15: res; 1k; tol=1 pwr=0.125
R16: res; 0.04; tol=1 pwr=30
R17: res; 1.5k; tol=1 pwr=0.125
R18: res; 1.5k; tol=1 pwr=0.125
R19: res; 3k; tol=1 pwr=0.125
R20: res; 2.4k; tol=1 pwr=0.125
R21: res; 7.2k; tol=1 pwr=0.125
R22: res; 18k; tol=1 pwr=0.125
R23: res; 3k; tol=1 pwr=0.125
R24: res; 2.4k; tol=1 pwr=0.125
R25: res; 7.2k; tol=1 pwr=0.125
R26: res; 18k; tol=1 pwr=0.125
R27: res; 4.6k; tol=1 pwr=0.125
R28: res; 1.2k; tol=1 pwr=0.125
R29: res; 1.2k; tol=1 pwr=0.125
R30: res; 1.8k; tol=1 pwr=0.125
U1: UniversalOpAmp
V1: voltage; 55
V2: voltage; -55
V3: voltage; 12
V4: voltage; 5
V5: voltage; -12
V6: voltage; 0
V7: voltage; 5
Named nets: 0
