Sasha7b9Work/LiniaServer/Блок базы - Подложки/Главный усилитель с токовым зеркалом/Зеркало с FZT.asc

C1: cap; 30p
Cos: cap; 5p
Q1: pnp; FZT758
Q2: npn; FZT658
Q3: pnp; FZT758
Q4: npn; FZT658
Q5: pnp; FZT758
Q6: npn; FZT658
R1: res; 75k
R2: res; 24
R3: res; 4k
R4: res; 7500
R5: res; 0.2
R6: res; 24
R7: res; 0.2
R9: res; 10
R10: res; 20k
R11: res; 10
R12: res; 10
R13: res; 10
Rn: res; 1000
Ros: res; 40k
Rsh: res; 10
U1: PA340
U2: DI_1N4729A
U4: tip142
U5: tip147
V1: voltage; 50
V2: voltage; 50
V4: voltage; 0.003
V5: voltage; PULSE(0 -4 1u 0.1u 0.1u 10u 0.01)
X2: Draft1
Named nets: 0
.tran 0 60u 0 10n
.options itl4=50
.dc V5 0 1 0.01
.MODEL FZT658 NPN IS=1.3E-13 NF=1.0025 BF=150 IKF=0.7 VAF=154 ISE=0.7E-13 NE=1.4 NR=1.0012 BR=8 IKR=0.42 VAR=48 ISC=3E-13 NC=1.3 RB=0.04 RE=0.0875 RC=0.05 CJC=24.77E-12 MJC=0.322 VJC=0.432 CJE=354E-12 MJE=0.36 VJE=0.824 TF=0.62E-9 TR=700E-9 XTB=1.55 QUASIMOD=1 RCO=38 GAMMA=20E-8
.MODEL FZT758 PNP IS=1.305E-13 NF=1.0004 BF=150 VAF=350 ISE=7.5E-13 NE=1.5 RCO=20 GAMMA=2.5E-8 QUASIMOD=1 NR=1 ISC=2E-13 NC=1.8 VAR=30 BR=2.5 RB=.1 RE=.01 RC=.01 CJC=58E-12 MJC=.56 VJC=.775 CJE=404E-12 TF=1E-9 TR=1200E-9 XTB=1.7
