Sasha7b9Work/LiniaServer/Источник напряжения 50В/Ltspice владислав/Draft1.asc

C1: cap; 10p
C2: cap; 10p
C3: cap; 10p
C4: cap; 2200µ
C5: cap; 1µ
M1: nmos; IXFX90N30
R1: res; 2k
R2: res; 500
R3: res; 10
R4: res; 1k
R5: res; 10
R6: res; 2.4k
R7: res; 1k
R8: res; 100
R9: res; 20k
R10: res; 100
R11: res; 100k
R12: res; 100k
U1: PA340
U2: ZXMN10A08G
U3: AD823
V1: voltage; PULSE(0 -5 10u 0.5u 0.5u 10u)
V2: voltage; 100
V3: voltage; -100
V4: voltage; 100
V5: voltage; 70
V7: voltage; -15
V8: voltage; 15
Named nets: 0
.tran 200u
.inc standard.dio
.inc standard.mos
