Sasha7b9Work/LiniaServer/Блок базы - Подложки/Model I-Buf-TLV9152+AMPL-A/Draft1.asc

C1: cap; 6800p
C2: cap; 10p
C3: cap; 10p
D1: zener; MMBZ9V1ALY
D2: zener; MMBZ9V1ALY
Q1: pnp; CZTA92
Q2: DZTA42
Q3: DZTA42
Q4: pnp; FZT758
Q5: pnp; CZTA92
Q6: pnp; CZTA92
Q8: DZTA42
Q9: DZTA42
R1: res; 0.1
R2: res; 150
R3: res; 150
R4: res; 4.7k
R5: res; 820
R6: res; 2k
R7: res; 820
R8: res; 2k
R9: res; 200k
R10: res; 33
R11: res; 400
R12: res; 150
R13: res; 400
R14: res; 150
U1: TLV9152
Named nets: 0, IN, OUT, +55, -55, VS1-, VS1+
.inc buff1models.txt
.tran 0 40u 0 10n
