Sasha7b9Work/LiniaServer/Блок базы - Подложки/Model I-Buf-TLV9152+AMPL-A/Draft19.asc

C1: cap; 30p
C2: cap; 1p
C3: cap; 1p
C4: cap; 20p
C5: cap; 20p
C6: cap; 10p
C7: cap; 10p
C8: cap; 10p
C9: cap; 6.8p
C10: cap; 20p
Cos: cap; 33p
R1: res; 75k
R2: res; 24
R3: res; 4k
R4: res; 10k
R5: res; 0.2
R6: res; 24
R7: res; 0.2
R8: res; 301k
R9: res; 10k
R10: res; 20k
R11: res; 10k
R12: res; 301k
R13: res; 2.1k
R14: res; 2.1k
R15: res; 12k
R16: res; 51k
R17: res; 6k
R18: res; 51k
R19: res; 2k
Rn: res; 100
Ros: res; 40k
Rsh: res; 1000
U1: PA340
U2: DI_1N4729A
U3: ad629
U4: tip142
U5: tip147
V1: voltage; 50
V2: voltage; 50
V3: voltage; 15
V4: voltage; 0.003
V5: voltage; PULSE(0 -5 1u 0.5u 0.5u 100u); AC 1
V6: voltage; 15
X1: Draft1
X2: Draft1
Named nets: 0
.options itl4=50
.tran 200u
