Sasha7b9Work/LiniaServer/Блок базы - Подложки/Главный усилитель с токовым зеркалом/Зеркало.asc

C1: cap; 30p
Cos: cap; 5p
Q1: pnp; 2N5401
Q2: npn; 2N5550
Q3: pnp; 2N5401
Q4: npn; 2N5550
R1: res; 75k
R2: res; 24
R3: res; 4k
R4: res; 1000000
R5: res; 0.2
R6: res; 24
R7: res; 0.2
R9: res; 10000
R10: res; 20k
R11: res; 10000
R12: res; 10000
R13: res; 10000
Rn: res; 1000
Ros: res; 40k
Rsh: res; 10
U1: PA340
U2: DI_1N4729A
U4: tip142
U5: tip147
V1: voltage; 50
V2: voltage; 50
V4: voltage; 0.003
V5: voltage; PULSE(0 -4 1u 0.1u 0.1u 10u 0.01)
X2: Draft1
Named nets: 0
.tran 0 60u 0 10n
.options itl4=50
.dc V5 0 1 0.01
