Sasha7b9Work/LiniaServer/Блок базы - Подложки/Model  I-Buf -AD8274+AMPL-A/BufH.asc

D1: diode; 1N4148
D2: diode; 1N4148
D3: diode; 1N4148
D4: diode; 1N4148
R1: res; 300
R2: res; 1000k
R3: res; 300
R5: res; 300
U1: AD8512
U3: AD8512
U4: AD8274
V2: voltage; -15
V4: voltage; 15
Named nets: 0, InA, InB, OUT
.include 1N4148.txt
