Sasha7b9Work/LiniaServer/Блок базы - Подложки/Model  I-Buf -AD8274+AMPL-A/Draft17.asc

1k: res; 10k
C1: cap; 30p
Cos: cap; 20p
R1: res; 75k
R2: res; 24
R3: res; 4k
R5: res; 0.2
R6: res; 24
R7: res; 0.2
R9: res; 10k
R10: res; 20k
R11: res; 10k
Rn: res; 50
Ros: res; 40k
Rsh: res; 100
U1: PA340
U2: DI_1N4729A
U3: bufh
U4: tip142
U5: tip147
V1: voltage; 50
V2: voltage; 50
V4: voltage; 0.003
V5: voltage; PULSE(0 -1 1u 0.1u 0.1u 10u 0.01)
Named nets: 0
.tran 0 60u 0 10n
.options itl4=50
