Sasha7b9Work/LiniaServer/Источник напряжения 50В/Model Form 50V/Draft11.asc

C1: cap; 20p
C2: cap; 100p
C3: cap; 10p
C4: cap; 220p
R1: res; 75k
R2: res; 240
R3: res; 2k
R4: res; 20k
R5: res; 2.4K
R6: res; 100
R7: res; 180
R8: res; 0.1
R9: res; 240
R10: res; 20k
U1: PA340
U2: FQPF7P20
U3: IPB073N15N5_L0
V1: voltage; 70
V2: voltage; 70
V3: voltage; PULSE(0 2 10u 10n 10n 20u 1)
V5: voltage; 0
Named nets: 0
.tran 0 60u 0 10n
.options itl4=50
