Sasha7b9Work/LiniaServer/Блок базы - Подложки/Model I-Buf-TLV9152+AMPL-A/Draft18.asc

C1: cap; 30p
C2: cap; 0.2p
C4: cap; 0.2p
Cos: cap; 20p
D1: diode; 1N4148
D2: diode; 1N4148
R1: res; 75k
R2: res; 24
R3: res; 4k
R4: res; 10k
R5: res; 0.2
R6: res; 24
R7: res; 0.2
R8: res; 300k
R9: res; 10k
R10: res; 20k
R11: res; 10k
R12: res; 300k
Rn: res; 1k
Ros: res; 20k
Rsh: res; 10k
U1: PA340
U2: DI_1N4729A
U3: ad629
U4: tip142
U5: tip147
V1: voltage; 50
V2: voltage; 50
V3: voltage; 15
V4: voltage; 0.003
V5: voltage; PULSE(0 -2 1u .1u .1u 100u 0.01)
V6: voltage; 15
X1: Draft1
X2: Draft1
Named nets: 0
.tran 0 130u 0 100n
.options itl4=50
.model 1N4148 D(Is=2.52n Rs=.568 N=1.752 Cjo=4p M=.4 tt=20n Iave=200m Vpk=75 mfg=OnSemi type=silicon)
