Sasha7b9Work/LiniaServer/Блок базы - Подложки/ltspice bufer1/Draft1.asc

33: res; 1k
C1: cap; 6800p
C2: cap; 10p
C3: cap; 10p
C4: cap; 47p
D1: zener; MMBZ6V8ALY
D2: zener; MMBZ6V8ALY
Q1: pnp; CZTA92
Q2: npn; DZTA42
Q3: npn; FZT658
Q4: pnp; FZT758
Q5: pnp; CZTA92
Q6: pnp; CZTA92
Q7: npn; DZTA42
Q8: npn; DZTA42
R1: res; 301k
R2: res; 150
R3: res; 150
R4: res; 4.7k
R5: res; 820
R6: res; 2k
R7: res; 820
R8: res; 2k
R9: res; 200k
R10: res; 5.1k
R11: res; 400
R12: res; 150
R13: res; 400
R14: res; 150
U1: TLV9152
Named nets: 0, IN, OUT, +55, -55, VS1-, VS1+
.inc buff1models.txt
.tran 0 20u 0
