Sasha7b9Work/LiniaServer/Блок базы - Подложки/Dradt15mk1-C/Draft15mk1.asc

C1: cap; 10p
C2: cap; 1µ
C3: cap; 13p
DA1: PA340
Q1: npn; 2N5550
Q2: pnp; 2N5401
R1: res; 500
R2: res; 0.1
R3: res; 4.99k
R4: res; 0.1
R5: res; 1.2k
R6: res; 120
R7: res; 40.2k
R8: res; 49k
R9: res; 120
R10: res; 4.6k
R11: res; 10k
R12: res; 10k
R13: res; 300
R14: res; 300
R15: res; 100
R19: res; 100
U1: AD8512
U2: DI_1N4729A
U3: AD8512
U4: AD8226
V1: voltage; 55
V2: voltage; -15
V3: voltage; 55
V4: voltage; 15
V5: voltage; PULSE(0 -0.5 10u 0.1u 0.1u 7u 0.01); AC 1
V6: voltage; 0
V7: voltage; -15
V8: voltage; 15
V9: voltage; 15
V10: voltage; -15
VT1: tip142
VT2: tip147
Named nets: 0
.tran 0 60u 0 10n
.options itl4=50
.lib MJE340.SP3
.model 2N5550 NPN(Is=2.511f Xti=3 Eg=1.11 Vaf=100 Bf=213.4 Ne=1.241 Ise=2.511f Ikf=.3495 Xtb=1.5 Br=3.24 Nc=2 Isc=0 Ikr=0 Rc=1 Cjc=4.883p Mjc=.3047 Vjc=.75 Fc=.5 Cje=18.79p Mje=.3416 Vje=.75 Tr=1.212n Tf=560.1p Itf=50m Vtf=5 Xtf=8 Rb=10 Vceo=150 Icrating=600m mfg=Fairchild)
.model 2N5401 PNP(Is=21.48f Xti=3 Eg=1.11 Vaf=100 Bf=132.1 Ne=1.375 Ise=21.48f Ikf=.1848 Xtb=1.5 Br=3.661 Nc=2 Isc=0 Ikr=0 Rc=1.6 Cjc=17.63p Mjc=.5312 Vjc=.75 Fc=.5 Cje=73.39p Mje=.3777 Vje=.75 Tr=1.476n Tf=641.9p Itf=0 Vtf=0 Xtf=0 Rb=10 Vceo=150 Icrating=600m mfg=Fairchild)
