Sasha7b9Work/LiniaServer/Блок базы - Подложки/Dradt15mk1-C/tolko usiliteli.asc

R1: res; 49k
R2: res; 200
U1: AD8226
U4: AD8512
U5: AD8512
V1: voltage; -15
V2: voltage; 15
V3: voltage; -15
V4: voltage; 15
V5: voltage; 15
V6: voltage; -15
V8: voltage; 2
V9: voltage; 4
Named nets: 0
.tran 0 60u 0 10n
