Sasha7b9Work/LiniaServer/Блок базы - Подложки/BASE_MOSFET/Draft16.asc

C1: cap; 20p
C3: cap; 10p
R1: res; 75k
R2: res; 24
R3: res; 4k
R4: res; 40k
R5: res; 0.2
R6: res; 24
R7: res; 0.2
R8: res; 100
R9: res; 400k
R10: res; 20k
R11: res; 10k
R12: res; 10k
U1: PA340
U3: 1N4729A
U4: tip142
U5: tip147
V1: voltage; 50
V2: voltage; 50
V4: voltage; 0.003
V5: voltage; PULSE(0 -0.1 1u 0.1u 0.1u 10u 0.01)
Named nets: 0
.tran 0 60u 0 10n
.options itl4=50
