Sasha7b9Work/LiniaServer/(list of files, drawings)

Other design files:
_Лисенков/Блок питания/Блок питания Линия-2/Общая схем лист 1.SchDoc
_Лисенков/Блок питания/Блок питания Линия-2/Общая схема лист 2.SchDoc
_Лисенков/Блок питания/Блок питания Линия-2/Плата 347.SchDoc
_Лисенков/Блок питания/Блок питания Линия-2/Плата 348.SchDoc
_Лисенков/Блок питания/Блок питания Линия-2/Плата 349.SchDoc
_Лисенков/Для отчета ИНТЕГРАЛу/Общ.сх.,интерф.,коммут.,адаптер/Imported KOMM1 (лист1 и лист2).PrjPcb/First_Sheet.SCHDOC
_Лисенков/Для отчета ИНТЕГРАЛу/Общ.сх.,интерф.,коммут.,адаптер/Imported KOMM1 (лист1 и лист2).PrjPcb/KOMM1 (лист1 и лист2).PrjPcb
_Лисенков/Для отчета ИНТЕГРАЛу/Общ.сх.,интерф.,коммут.,адаптер/Imported KOMM1 (лист1 и лист2).PrjPcb/KOMM1 (лист1 и лист2).SchLib
_Лисенков/Для отчета ИНТЕГРАЛу/Общ.сх.,интерф.,коммут.,адаптер/Imported KOMM1 (лист1 и лист2).PrjPcb/Sheet1.SCHDOC
_Лисенков/Для отчета ИНТЕГРАЛу/Общ.сх.,интерф.,коммут.,адаптер/Imported KOMM1 (лист1 и лист2).PrjPcb/Sheet2.SCHDOC
_Лисенков/Для отчета ИНТЕГРАЛу/Общ.сх.,интерф.,коммут.,адаптер/Imported Адаптер-Линия 2 УШЯИ. 687415.025 Э3.PrjPcb/Sheet1.SCHDOC
_Лисенков/Для отчета ИНТЕГРАЛу/Общ.сх.,интерф.,коммут.,адаптер/Imported Адаптер-Линия 2 УШЯИ. 687415.025 Э3.PrjPcb/Адаптер-Линия 2 УШЯИ. 687415.025 Э3.PrjPcb
_Лисенков/Для отчета ИНТЕГРАЛу/Общ.сх.,интерф.,коммут.,адаптер/Imported Адаптер-Линия 2 УШЯИ. 687415.025 Э3.PrjPcb/Адаптер-Линия 2 УШЯИ. 687415.025 Э3.SchLib
_Лисенков/Для отчета ИНТЕГРАЛу/Общ.сх.,интерф.,коммут.,адаптер/Imported Интерфейс УШЯИ 468359.031 Э3.PrjPcb/Sheet1.SCHDOC
_Лисенков/Для отчета ИНТЕГРАЛу/Общ.сх.,интерф.,коммут.,адаптер/Imported Интерфейс УШЯИ 468359.031 Э3.PrjPcb/Интерфейс УШЯИ 468359.031 Э3.PrjPcb
_Лисенков/Для отчета ИНТЕГРАЛу/Общ.сх.,интерф.,коммут.,адаптер/Imported Интерфейс УШЯИ 468359.031 Э3.PrjPcb/Интерфейс УШЯИ 468359.031 Э3.SchLib
_Лисенков/Источник напряжения 50В/50В-17/УШЯИ687253.017Э3_1.SchDoc
_Лисенков/Источник напряжения 50В/50В-17/УШЯИ687253.017Э3_2.SchDoc
_Лисенков/Источник напряжения 50В/50В-17/УШЯИ687253.017Э3_3.SchDoc
_Лисенков/Источник напряжения 50В/50В-17/УШЯИ 758725.629-2.PcbDoc
_Лисенков/Источник напряжения 50В/Финишная топология/УШЯИ 687253.017/УШЯИ 687253.017/PCB2.PcbDoc
_Лисенков/Источник напряжения 50В/Финишная топология/УШЯИ 687253.017/УШЯИ 687253.017/Sheet1.SchDoc
_Лисенков/Источник напряжения 50В/Финишная топология/УШЯИ 687253.017/УШЯИ 687253.017/Sheet2.SchDoc
_Лисенков/Источник напряжения 50В/Финишная топология/УШЯИ 687253.017/УШЯИ 687253.017/Sheet3.SchDoc
_Лисенков/Источник напряжения 50В/Финишная топология/УШЯИ 687253.017/УШЯИ 687253.017/УШЯИ 687253.017 Э3.PrjPcb
_Лисенков/Контроллер/Контроллер(24.02.2026)/PCB/УШЯИ.467444.130_R1.PcbDoc
_Лисенков/Контроллер/Контроллер(24.02.2026)/SCH/УШЯИ.467444.130Э3_1-R1.SchDoc
_Лисенков/Контроллер/Контроллер(24.02.2026)/SCH/УШЯИ.467444.130Э3_2-R1.SchDoc
_Лисенков/Контроллер/Контроллер(24.02.2026)/SCH/УШЯИ.467444.130Э3_3-R1.SchDoc
_Лисенков/Контроллер/Контроллер(24.02.2026)/SCH/УШЯИ.467444.130Э3_4-R1.SchDoc
_Лисенков/Контроллер/Контроллер(24.02.2026)/SCH/УШЯИ.467444.130Э3_5-R1.SchDoc
_Лисенков/Контроллер/Контроллер(24.02.2026)/SCH/УШЯИ.467444.130Э3_R0/УШЯИ.467444.130Э3_1-R0.SchDoc
_Лисенков/Контроллер/Контроллер(24.02.2026)/SCH/УШЯИ.467444.130Э3_R0/УШЯИ.467444.130Э3_2-R0.SchDoc
_Лисенков/Контроллер/Контроллер(24.02.2026)/SCH/УШЯИ.467444.130Э3_R0/УШЯИ.467444.130Э3_3-R0.SchDoc
_Лисенков/Контроллер/Контроллер(24.02.2026)/SCH/УШЯИ.467444.130Э3_R0/УШЯИ.467444.130Э3_4-R0.SchDoc
_Лисенков/Контроллер/Контроллер(24.02.2026)/SCH/УШЯИ.467444.130Э3_R0/УШЯИ.467444.130Э3_5-R0.SchDoc
_Лисенков/Контроллер/Контроллер(24.02.2026)/Документация/Документация от схемотехника/УШЯИ.467444.130Э3_1-A.SchDoc
_Лисенков/Контроллер/Контроллер(24.02.2026)/Документация/Документация от схемотехника/УШЯИ.467444.130Э3_2-A.SchDoc
_Лисенков/Контроллер/Контроллер(24.02.2026)/Документация/Документация от схемотехника/УШЯИ.467444.130Э3_4-A.SchDoc
_Лисенков/Контроллер/Контроллер(24.02.2026)/Документация/Документация от схемотехника/УШЯИ.467444.130Э3_5-A.SchDoc
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
