Sasha7b9Work/LiniaServer/ИнтелАвто/Описание компьютерной программы/Исходные_коды_КПТС/src/LAN/app_ethernet.cpp

/**
  ******************************************************************************
  * @file    LwIP/LwIP_HTTP_Server_Raw/Src/app_ethernet.c 
  * @author  MCD Application Team
  * @brief   Ethernet specific module
  ******************************************************************************
  * @attention
  *
  * Copyright (c) 2017 STMicroelectronics.
  * All rights reserved.
  *
  * This software is licensed under terms that can be found in the LICENSE file
  * in the root directory of this software component.
  * If no LICENSE file comes with this software, it is provided AS-IS.
  *
  ******************************************************************************
  */
/* Includes ------------------------------------------------------------------*/
#include "defines.h"
#include "lwip/opt.h"
#include "app_ethernet.h"
#include "ethernetif.h"
#ifdef USE_LCD
#include "lcd_log.h"
#endif
#include <stm32f4xx_hal.h>

/* Private typedef -----------------------------------------------------------*/
/* Private define ------------------------------------------------------------*/
/* Private macro -------------------------------------------------------------*/
/* Private variables ---------------------------------------------------------*/

uint32_t EthernetLinkTimer;

/* Private function prototypes -----------------------------------------------*/
/* Private functions ---------------------------------------------------------*/
/**
  * @brief  Notify the User about the network interface config status
  * @param  netif: the network interface
  * @retval None
  */
void ethernet_link_status_updated(struct netif *netif)
{
  if (netif_is_link_up(netif))
  {
  }
  else
  {
  }
}

#if LWIP_NETIF_LINK_CALLBACK
/**
  * @brief  Ethernet Link periodic check
  * @param  netif
  * @retval None
  */
void Ethernet_Link_Periodic_Handle(struct netif *netif)
{
    static bool first = true;

    /* Ethernet Link every 100ms */
    if (HAL_GetTick() - EthernetLinkTimer >= 100 || first)
    {
        first = false;
        EthernetLinkTimer = HAL_GetTick();
        ethernet_link_check_state(netif);
    }
}
#endif
