Sasha7b9Work/LiniaServer/ИнтелАвто/Описание компьютерной программы/Исходные_коды_КПТС/src/LAN/app_ethernet.h

/**
  ******************************************************************************
  * @file    LwIP/LwIP_HTTP_Server_Raw/Inc/app_ethernet.h 
  * @author  MCD Application Team
  * @brief   Header for app_ethernet.c module
  ******************************************************************************
  * @attention
  *
  * Copyright (c) 2017 STMicroelectronics.
  * All rights reserved.
  *
  * This software is licensed under terms that can be found in the LICENSE file
  * in the root directory of this software component.
  * If no LICENSE file comes with this software, it is provided AS-IS.
  *
  ******************************************************************************
  */
/* Define to prevent recursive inclusion -------------------------------------*/
#ifndef __APP_ETHERNET_H
#define __APP_ETHERNET_H

#ifdef __cplusplus
 extern "C" {
#endif

/* Includes ------------------------------------------------------------------*/
#include "lwip/netif.h"

/* Exported types ------------------------------------------------------------*/
/* Exported constants --------------------------------------------------------*/
/* DHCP process states */
#define DHCP_OFF                   (uint8_t) 0
#define DHCP_START                 (uint8_t) 1
#define DHCP_WAIT_ADDRESS          (uint8_t) 2
#define DHCP_ADDRESS_ASSIGNED      (uint8_t) 3
#define DHCP_TIMEOUT               (uint8_t) 4
#define DHCP_LINK_DOWN             (uint8_t) 5
   
/* Exported macro ------------------------------------------------------------*/
/* Exported functions ------------------------------------------------------- */
void ethernet_link_status_updated(struct netif *netif);
void Ethernet_Link_Periodic_Handle(struct netif *netif);

#ifdef __cplusplus
}
#endif

#endif /* __APP_ETHERNET_H */
