Sasha7b9Work/LiniaServer/ИнтелАвто/Описание компьютерной программы/Исходные_коды_КПТС/src/no-warnings.h

// 2023/12/18 15:43:43 (c) Aleksandr Shevchenko e-mail : Sasha7b9@tut.by
#pragma once


#if defined(__ARMCC_VERSION) && (__ARMCC_VERSION >= 6010050)
    #pragma clang diagnostic ignored "-Wcast-qual"
    #pragma clang diagnostic ignored "-Wexit-time-destructors"
    #pragma clang diagnostic ignored "-Wundefined-func-template"
    #pragma clang diagnostic ignored "-Wold-style-cast"
    #pragma clang diagnostic ignored "-Wc++98-compat-pedantic"
    #pragma clang diagnostic ignored "-Wpadded"
    #pragma clang diagnostic ignored "-Wglobal-constructors"
    #pragma clang diagnostic ignored "-Wweak-vtables"
    #pragma clang diagnostic ignored "-Winvalid-source-encoding"
    #pragma clang diagnostic ignored "-Wfloat-equal"
    #pragma clang diagnostic ignored "-Wnon-virtual-dtor"
    #pragma clang diagnostic ignored "-Wformat-nonliteral"
    #pragma clang diagnostic ignored "-Wmissing-prototypes"
    #pragma clang diagnostic ignored "-Wmissing-variable-declarations"
    #pragma clang diagnostic ignored "-Wshift-sign-overflow"
    #pragma clang diagnostic ignored "-Wunsafe-buffer-usage"
    #pragma clang diagnostic ignored "-Winvalid-utf8"
    #pragma clang diagnostic ignored "-Wmissing-field-initializers"
    
    #pragma clang diagnostic ignored "-Wunused-variable"
    #pragma clang diagnostic ignored "-Wunused-parameter"
#endif
