Sasha7b9Work/LiniaServer/(commit log)

2026-01-27 Описание регистра канала базы
2026-02-02 Добавлена документация по коммутатору
    [1.sch, 2.sch, 3.sch, Коммутатор.010Э-2013г-Фотоник.sch, перечень лист изм.sch]
2026-02-11 Добавлена папочка Лисенкова
    [1.sch, 2.sch, 3.sch, 411131.004-Измеритель тока 1лист(new).sch, 411131.004-Измеритель тока 1лист(new2018).sch, 411131.004-Измеритель тока 1лист.sch, 411131.004-Измеритель тока 2лист(new).sch, 411131.004-Измеритель тока 2лист(new2018).sch]
2026-03-12 Восстановлено
    [1.sch, 2.sch, 3.sch, 411131.004-Измеритель тока 1лист(new).sch, 411131.004-Измеритель тока 1лист(new2018).sch, 411131.004-Измеритель тока 1лист.sch, 411131.004-Измеритель тока 2лист(new).sch, 411131.004-Измеритель тока 2лист(new2018).sch]
